Riyu-D1/Vector/pcb/drc_report.txt

** Drc report for soma-carrier.kicad_pcb **
** Created on 2026-10-27T16:31:42 **
** Report includes: Errors, Warnings, Exclusions **

** Found 12 DRC violations **
[lib_footprint_mismatch]: Footprint 'PinHeader_1x05_P2.54mm_Vertical' does not match copy in library 'Connector_PinHeader_2.54mm'
    Local override; warning
    @(14.0000 mm, 95.0000 mm): Footprint J13
[lib_footprint_mismatch]: Footprint 'PinHeader_1x05_P2.54mm_Vertical' does not match copy in library 'Connector_PinHeader_2.54mm'
    Local override; warning
    @(64.0000 mm, 64.0000 mm): Footprint J15
[lib_footprint_mismatch]: Footprint 'PinHeader_1x02_P2.54mm_Vertical' does not match copy in library 'Connector_PinHeader_2.54mm'
    Local override; warning
    @(30.0000 mm, 95.0000 mm): Footprint J9
[lib_footprint_mismatch]: Footprint 'PinHeader_1x22_P2.54mm_Vertical' does not match copy in library 'Connector_PinHeader_2.54mm'
    Local override; warning
    @(22.1400 mm, 51.1600 mm): Footprint U1A
[lib_footprint_mismatch]: Footprint 'TerminalBlock_Phoenix_MKDS-1,5-2-5.08_1x02_P5.08mm_Horizontal' does not match copy in library 'TerminalBlock_Phoenix'
    Local override; warning
    @(8.0000 mm, 36.0000 mm): Footprint J2
[lib_footprint_mismatch]: Footprint 'Fuse_Blade_Mini_directSolder' does not match copy in library 'Fuse'
    Local override; warning
    @(17.0000 mm, 64.0000 mm): Footprint F1
[lib_footprint_mismatch]: Footprint 'R_Axial_DIN0207_L6.3mm_D2.5mm_P7.62mm_Horizontal' does not match copy in library 'Resistor_THT'
    Local override; warning
    @(112.0000 mm, 95.0000 mm): Footprint R5
[lib_footprint_mismatch]: Footprint 'PinHeader_1x04_P2.54mm_Vertical' does not match copy in library 'Connector_PinHeader_2.54mm'
    Local override; warning
    @(48.0000 mm, 64.0000 mm): Footprint J8
[lib_footprint_mismatch]: Footprint 'PinHeader_1x22_P2.54mm_Vertical' does not match copy in library 'Connector_PinHeader_2.54mm'
    Local override; warning
    @(22.1400 mm, 28.3000 mm): Footprint U1B
[lib_footprint_mismatch]: Footprint 'PinHeader_1x04_P2.54mm_Vertical' does not match copy in library 'Connector_PinHeader_2.54mm'
    Local override; warning
    @(44.0000 mm, 95.0000 mm): Footprint J11
[lib_footprint_mismatch]: Footprint 'TerminalBlock_Phoenix_MKDS-1,5-2-5.08_1x02_P5.08mm_Horizontal' does not match copy in library 'TerminalBlock_Phoenix'
    Local override; warning
    @(8.0000 mm, 48.0000 mm): Footprint J1
[lib_footprint_mismatch]: Footprint 'PinHeader_1x04_P2.54mm_Vertical' does not match copy in library 'Connector_PinHeader_2.54mm'
    Local override; warning
    @(86.0000 mm, 95.0000 mm): Footprint J10

** Found 0 unconnected pads **

** Found 0 Footprint errors **

** Ignored checks **
    - Footprint has no courtyard defined
    - Track endpoint not centered on via
    - Tuning profile track geometries
    - Footprint doesn't match symbol's footprint filters
    - Footprint component type doesn't match footprint pads

** End of Report **
