Riyu-D1/Vector/cad3/fea/report_cradle.txt

run/cradle.frd: 122524 nodes 77580 tets, 4 result blocks
constrained 75069 (NFIX 47445 NLOAD 27624); excluded-with-elements 97623
step1: max|U| 0.000 mm | raw maxVM 1.07 | filtered maxVM 0.22 | patch maxVM 0.87 MPa
    hot VM 0.22 at node 89857 (94.4, 24.3, 221.6)
    hot VM 0.21 at node 47551 (67.0, 24.2, 211.7)
    hot VM 0.21 at node 60886 (92.9, 24.5, 220.3)
    hot VM 0.21 at node 114123 (95.0, 24.6, 226.1)
    hot VM 0.20 at node 60885 (93.0, 24.7, 220.9)
    patch VM 0.87 at node 42022 (92.6, 23.5, 227.5)
    patch VM 0.80 at node 94053 (92.2, 24.0, 205.2)
    patch VM 0.71 at node 81040 (92.3, 24.0, 204.8)
