Riyu-D1/Vector/cad3/fea/report_J2.txt

run/housing_J2.frd: 275769 nodes 164418 tets, 4 result blocks
constrained 91264 (NFIX 63765 NLOAD 27499); excluded-with-elements 179709
step1: max|U| 0.007 mm | raw maxVM 4.16 | filtered maxVM 4.16 | patch maxVM 1.64 MPa
    hot VM 4.16 at node 1972 (2.0, 22.6, 10.2)
    hot VM 3.10 at node 2021 (-2.0, 22.6, 10.2)
    hot VM 1.71 at node 63 (2.0, 22.6, 10.2)
    hot VM 1.42 at node 62 (2.0, 22.6, 10.2)
    hot VM 1.30 at node 66 (-2.0, 22.6, 10.2)
    patch VM 1.64 at node 249 (21.9, -9.1, 33.5)
    patch VM 1.60 at node 171 (23.6, -2.1, 33.5)
    patch VM 1.59 at node 172 (23.7, -1.5, 33.5)
