Riyu-D1/Vector/wrist/lists_after.txt

/Users/deepakdiwan/Vector-wt/wrist/cad/arm2b/out/fore_l2.stl 0.30 0.31 0.36
/Users/deepakdiwan/Vector-wt/wrist/cad/arm2b/out/fore_r2.stl 0.30 0.31 0.36
/Users/deepakdiwan/Vector-wt/wrist/wrist/out/w_j4_cradle.stl 0.30 0.31 0.36
/Users/deepakdiwan/Vector-wt/wrist/wrist/out/w_link4.stl 0.30 0.31 0.36
/Users/deepakdiwan/Vector-wt/wrist/wrist/out/w_link5.stl 0.30 0.31 0.36
/Users/deepakdiwan/Vector-wt/wrist/wrist/out/w_grip_frame.stl 0.30 0.31 0.36
/Users/deepakdiwan/Vector-wt/wrist/wrist/out/finger_u.stl 0.30 0.31 0.36
/Users/deepakdiwan/Vector-wt/wrist/wrist/out/finger_d.stl 0.30 0.31 0.36
/Users/deepakdiwan/Vector-wt/wrist/wrist/out/vendor_sts3215_j4.stl 0.78 0.38 0.12
/Users/deepakdiwan/Vector-wt/wrist/wrist/out/vendor_sts3215_j5.stl 0.78 0.38 0.12
/Users/deepakdiwan/Vector-wt/wrist/wrist/out/vendor_sts3215_j6.stl 0.78 0.38 0.12
/Users/deepakdiwan/Vector-wt/wrist/wrist/out/vendor_sts3215_g.stl 0.78 0.38 0.12
/Users/deepakdiwan/Vector-wt/wrist/wrist/out/vendor_gear_grip.stl 0.55 0.56 0.60
/Users/deepakdiwan/Vector-wt/wrist/wrist/out/vendor_rack_u.stl 0.55 0.56 0.60
/Users/deepakdiwan/Vector-wt/wrist/wrist/out/vendor_rack_d.stl 0.55 0.56 0.60
