Riyu-D1/Vector/toolchg/renders/lists_arm.txt

/Users/deepakdiwan/Vector-wt/toolchg/cad/arm2b/out/base_link.stl 0.30 0.31 0.36
/Users/deepakdiwan/Vector-wt/toolchg/cad/arm2b/out/base_plate.stl 0.30 0.31 0.36
/Users/deepakdiwan/Vector-wt/toolchg/cad/arm2b/out/base_reinf.stl 0.30 0.31 0.36
/Users/deepakdiwan/Vector-wt/toolchg/cad/arm2b/out/j1_cradle.stl 0.30 0.31 0.36
/Users/deepakdiwan/Vector-wt/toolchg/cad/arm2b/out/vendor_sts3250_j1.stl 0.78 0.38 0.12
/Users/deepakdiwan/Vector-wt/toolchg/toolchg/renders/scratch/home_dogleg_l.stl 0.30 0.31 0.36
/Users/deepakdiwan/Vector-wt/toolchg/toolchg/renders/scratch/home_dogleg_r.stl 0.30 0.31 0.36
/Users/deepakdiwan/Vector-wt/toolchg/toolchg/renders/scratch/home_fore_l2.stl 0.30 0.31 0.36
/Users/deepakdiwan/Vector-wt/toolchg/toolchg/renders/scratch/home_fore_r2.stl 0.30 0.31 0.36
/Users/deepakdiwan/Vector-wt/toolchg/toolchg/renders/scratch/home_front_spacer_j2.stl 0.30 0.31 0.36
/Users/deepakdiwan/Vector-wt/toolchg/toolchg/renders/scratch/home_front_spacer_j3.stl 0.30 0.31 0.36
/Users/deepakdiwan/Vector-wt/toolchg/toolchg/renders/scratch/home_link1.stl 0.30 0.31 0.36
/Users/deepakdiwan/Vector-wt/toolchg/toolchg/renders/scratch/home_upper_back.stl 0.30 0.31 0.36
/Users/deepakdiwan/Vector-wt/toolchg/toolchg/renders/scratch/home_upper_out.stl 0.30 0.31 0.36
/Users/deepakdiwan/Vector-wt/toolchg/toolchg/renders/scratch/home_yaw_limit.stl 0.30 0.31 0.36
/Users/deepakdiwan/Vector-wt/toolchg/toolchg/renders/scratch/home_back_spacer_j2.stl 0.30 0.31 0.36
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
/Users/deepakdiwan/Vector-wt/toolchg/toolchg/renders/scratch/home_cy2_vendor_motor.stl 0.30 0.31 0.36
/Users/deepakdiwan/Vector-wt/toolchg/toolchg/renders/scratch/home_cy3_vendor_motor.stl 0.30 0.31 0.36
/Users/deepakdiwan/Vector-wt/toolchg/toolchg/renders/scratch/home_cy2_vendor_outpins.stl 0.30 0.31 0.36
/Users/deepakdiwan/Vector-wt/toolchg/toolchg/renders/scratch/home_cy3_vendor_outpins.stl 0.30 0.31 0.36
/Users/deepakdiwan/Vector-wt/toolchg/toolchg/renders/scratch/home_cy2_vendor_ringpins.stl 0.30 0.31 0.36
/Users/deepakdiwan/Vector-wt/toolchg/toolchg/renders/scratch/home_cy3_vendor_ringpins.stl 0.30 0.31 0.36
/Users/deepakdiwan/Vector-wt/toolchg/toolchg/renders/scratch/home_tc_finger_d.stl 0.30 0.31 0.36
/Users/deepakdiwan/Vector-wt/toolchg/toolchg/renders/scratch/home_tc_finger_u.stl 0.30 0.31 0.36
/Users/deepakdiwan/Vector-wt/toolchg/toolchg/renders/scratch/home_tc_gear.stl 0.55 0.56 0.60
/Users/deepakdiwan/Vector-wt/toolchg/toolchg/renders/scratch/home_tc_master.stl 0.16 0.50 0.72
/Users/deepakdiwan/Vector-wt/toolchg/toolchg/renders/scratch/home_tc_rack_d.stl 0.55 0.56 0.60
/Users/deepakdiwan/Vector-wt/toolchg/toolchg/renders/scratch/home_tc_rack_u.stl 0.55 0.56 0.60
/Users/deepakdiwan/Vector-wt/toolchg/toolchg/renders/scratch/home_tc_vendor_g.stl 0.30 0.31 0.36
/Users/deepakdiwan/Vector-wt/toolchg/toolchg/renders/scratch/home_tool_grip.stl 0.30 0.31 0.36
/Users/deepakdiwan/Vector-wt/toolchg/toolchg/out/tc_rack.stl 0.62 0.64 0.68
/Users/deepakdiwan/Vector-wt/toolchg/toolchg/renders/scratch/d_tool_pen.stl 0.85 0.62 0.18
