Riyu-D1/Vector/toolchg/renders/lists_asm.txt

/Users/deepakdiwan/Vector-wt/toolchg/toolchg/renders/scratch/asm_fore_l2.stl 0.30 0.31 0.36
/Users/deepakdiwan/Vector-wt/toolchg/toolchg/renders/scratch/asm_fore_r2.stl 0.30 0.31 0.36
/Users/deepakdiwan/Vector-wt/toolchg/toolchg/renders/scratch/asm_vendor_sts3250_j4.stl 0.78 0.38 0.12
/Users/deepakdiwan/Vector-wt/toolchg/toolchg/renders/scratch/asm_vendor_sts3215_j5.stl 0.78 0.38 0.12
/Users/deepakdiwan/Vector-wt/toolchg/toolchg/renders/scratch/asm_vendor_sts3215_j6.stl 0.78 0.38 0.12
/Users/deepakdiwan/Vector-wt/toolchg/toolchg/renders/scratch/asm_w_j4_cradle.stl 0.30 0.31 0.36
/Users/deepakdiwan/Vector-wt/toolchg/toolchg/renders/scratch/asm_w_link4.stl 0.30 0.31 0.36
/Users/deepakdiwan/Vector-wt/toolchg/toolchg/renders/scratch/asm_w_link5.stl 0.30 0.31 0.36
/Users/deepakdiwan/Vector-wt/toolchg/toolchg/renders/scratch/asm_cy3_carrier.stl 0.30 0.31 0.36
/Users/deepakdiwan/Vector-wt/toolchg/toolchg/renders/scratch/asm_cy3_out_flange.stl 0.30 0.31 0.36
/Users/deepakdiwan/Vector-wt/toolchg/toolchg/renders/scratch/asm_cy3_vendor_685.stl 0.30 0.31 0.36
/Users/deepakdiwan/Vector-wt/toolchg/toolchg/renders/scratch/asm_cy3_vendor_dowels.stl 0.30 0.31 0.36
/Users/deepakdiwan/Vector-wt/toolchg/toolchg/renders/scratch/asm_cy3_vendor_outpins.stl 0.30 0.31 0.36
/Users/deepakdiwan/Vector-wt/toolchg/toolchg/renders/scratch/asm_tc_finger_d.stl 0.30 0.31 0.36
/Users/deepakdiwan/Vector-wt/toolchg/toolchg/renders/scratch/asm_tc_finger_u.stl 0.30 0.31 0.36
/Users/deepakdiwan/Vector-wt/toolchg/toolchg/renders/scratch/asm_tc_gear.stl 0.55 0.56 0.60
/Users/deepakdiwan/Vector-wt/toolchg/toolchg/renders/scratch/asm_tc_master.stl 0.16 0.50 0.72
/Users/deepakdiwan/Vector-wt/toolchg/toolchg/renders/scratch/asm_tc_rack_d.stl 0.55 0.56 0.60
/Users/deepakdiwan/Vector-wt/toolchg/toolchg/renders/scratch/asm_tc_rack_u.stl 0.55 0.56 0.60
/Users/deepakdiwan/Vector-wt/toolchg/toolchg/renders/scratch/asm_tc_vendor_g.stl 0.30 0.31 0.36
/Users/deepakdiwan/Vector-wt/toolchg/toolchg/renders/scratch/asm_tool_grip.stl 0.30 0.31 0.36
