Riyu-D1/Vector/toolchg/renders/lists_rack.txt

/Users/deepakdiwan/Vector-wt/toolchg/toolchg/out/tc_rack.stl 0.62 0.64 0.68
/Users/deepakdiwan/Vector-wt/toolchg/toolchg/renders/scratch/tdock_pen.stl 0.85 0.62 0.18
/Users/deepakdiwan/Vector-wt/toolchg/toolchg/renders/scratch/tdock_tool_grip.stl 0.30 0.31 0.36
/Users/deepakdiwan/Vector-wt/toolchg/toolchg/renders/scratch/tdock_tc_vendor_g.stl 0.30 0.31 0.36
/Users/deepakdiwan/Vector-wt/toolchg/toolchg/renders/scratch/tdock_tc_gear.stl 0.55 0.56 0.60
/Users/deepakdiwan/Vector-wt/toolchg/toolchg/renders/scratch/tdock_tc_rack_u.stl 0.55 0.56 0.60
/Users/deepakdiwan/Vector-wt/toolchg/toolchg/renders/scratch/tdock_tc_rack_d.stl 0.55 0.56 0.60
/Users/deepakdiwan/Vector-wt/toolchg/toolchg/renders/scratch/tdock_tc_finger_u.stl 0.30 0.31 0.36
/Users/deepakdiwan/Vector-wt/toolchg/toolchg/renders/scratch/tdock_tc_finger_d.stl 0.30 0.31 0.36
/Users/deepakdiwan/Vector-wt/toolchg/toolchg/renders/scratch/dock_dogleg_l.stl 0.30 0.31 0.36
/Users/deepakdiwan/Vector-wt/toolchg/toolchg/renders/scratch/dock_dogleg_r.stl 0.30 0.31 0.36
/Users/deepakdiwan/Vector-wt/toolchg/toolchg/renders/scratch/dock_fore_l2.stl 0.30 0.31 0.36
/Users/deepakdiwan/Vector-wt/toolchg/toolchg/renders/scratch/dock_fore_r2.stl 0.30 0.31 0.36
/Users/deepakdiwan/Vector-wt/toolchg/toolchg/renders/scratch/dock_front_spacer_j2.stl 0.30 0.31 0.36
/Users/deepakdiwan/Vector-wt/toolchg/toolchg/renders/scratch/dock_front_spacer_j3.stl 0.30 0.31 0.36
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
/Users/deepakdiwan/Vector-wt/toolchg/toolchg/renders/scratch/dock_cy2_vendor_dowels.stl 0.30 0.31 0.36
/Users/deepakdiwan/Vector-wt/toolchg/toolchg/renders/scratch/dock_cy3_vendor_dowels.stl 0.30 0.31 0.36
/Users/deepakdiwan/Vector-wt/toolchg/toolchg/renders/scratch/dock_cy2_vendor_magnet.stl 0.30 0.31 0.36
/Users/deepakdiwan/Vector-wt/toolchg/toolchg/renders/scratch/dock_cy3_vendor_magnet.stl 0.30 0.31 0.36
/Users/deepakdiwan/Vector-wt/toolchg/toolchg/renders/scratch/dock_cy2_vendor_motor.stl 0.30 0.31 0.36
/Users/deepakdiwan/Vector-wt/toolchg/toolchg/renders/scratch/dock_cy3_vendor_motor.stl 0.30 0.31 0.36
/Users/deepakdiwan/Vector-wt/toolchg/toolchg/renders/scratch/dock_cy2_vendor_outpins.stl 0.30 0.31 0.36
/Users/deepakdiwan/Vector-wt/toolchg/toolchg/renders/scratch/dock_cy3_vendor_outpins.stl 0.30 0.31 0.36
/Users/deepakdiwan/Vector-wt/toolchg/toolchg/renders/scratch/dock_cy2_vendor_ringpins.stl 0.30 0.31 0.36
/Users/deepakdiwan/Vector-wt/toolchg/toolchg/renders/scratch/dock_cy3_vendor_ringpins.stl 0.30 0.31 0.36
/Users/deepakdiwan/Vector-wt/toolchg/toolchg/renders/scratch/dock_tc_master.stl 0.16 0.50 0.72
