Riyu-D1/Vector/toolchg/renders/lists_rackonly.txt

/Users/deepakdiwan/Vector-wt/toolchg/toolchg/out/tc_rack.stl 0.62 0.64 0.68
/Users/deepakdiwan/Vector-wt/toolchg/toolchg/renders/scratch/ro_tdock_pen.stl 0.85 0.62 0.18
/Users/deepakdiwan/Vector-wt/toolchg/toolchg/renders/scratch/ro_tdock_tool_grip.stl 0.30 0.31 0.36
/Users/deepakdiwan/Vector-wt/toolchg/toolchg/renders/scratch/ro_tdock_tc_vendor_g.stl 0.30 0.31 0.36
/Users/deepakdiwan/Vector-wt/toolchg/toolchg/renders/scratch/ro_tdock_tc_gear.stl 0.55 0.56 0.60
/Users/deepakdiwan/Vector-wt/toolchg/toolchg/renders/scratch/ro_tdock_tc_rack_u.stl 0.55 0.56 0.60
/Users/deepakdiwan/Vector-wt/toolchg/toolchg/renders/scratch/ro_tdock_tc_rack_d.stl 0.55 0.56 0.60
/Users/deepakdiwan/Vector-wt/toolchg/toolchg/renders/scratch/ro_tdock_tc_finger_u.stl 0.30 0.31 0.36
/Users/deepakdiwan/Vector-wt/toolchg/toolchg/renders/scratch/ro_tdock_tc_finger_d.stl 0.30 0.31 0.36
