Riyu-D1/Vector/cad3/fea/cad3_cradle_iso.png

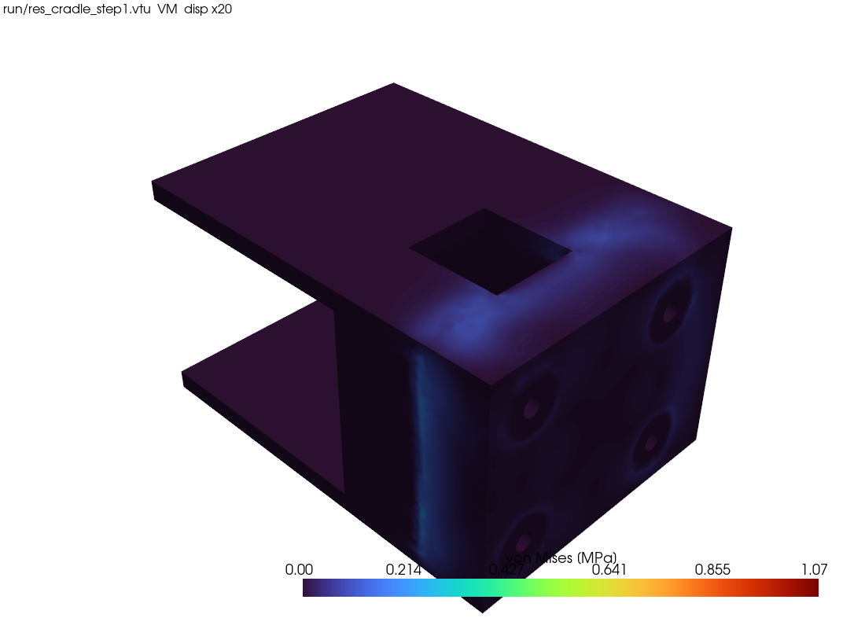
cad3/fea/cad3_cradle_iso.png
