Riyu-D1/Vector/cad3/fea/cad3_J2_front.png

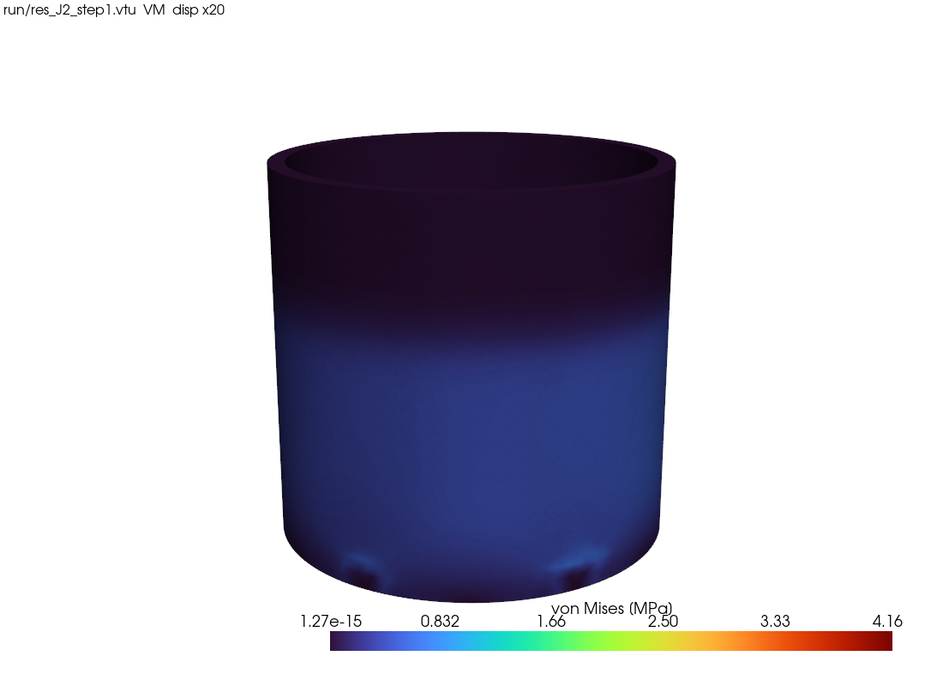
cad3/fea/cad3_J2_front.png
