Riyu-D1/Vector/cad3/fea/cad3_J3_iso.png

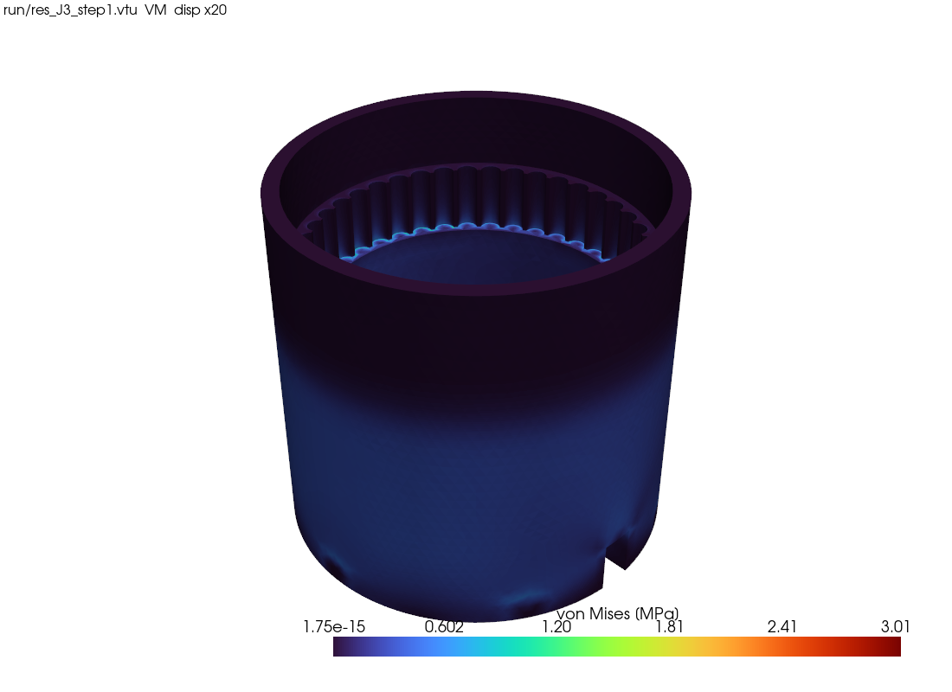
cad3/fea/cad3_J3_iso.png
