Riyu-D1/Vector/cad/actuator/export/_cutaway.png

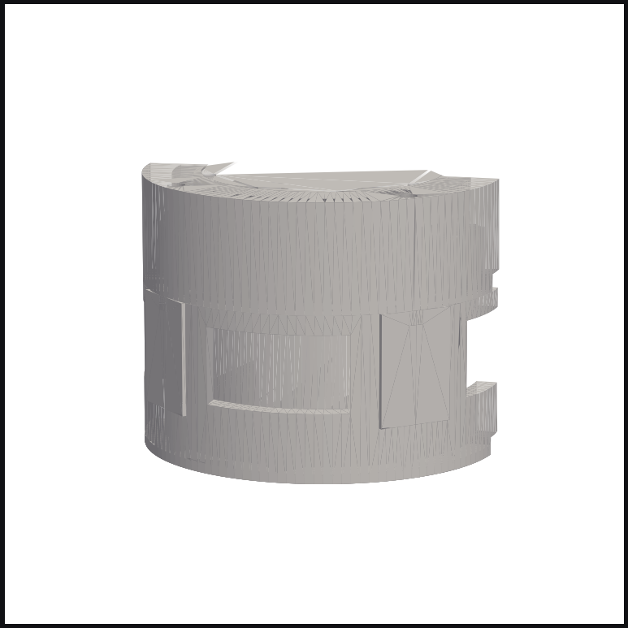
cad/actuator/export/_cutaway.png
