Riyu-D1/Vector/cad/actuator/export/_gears.png

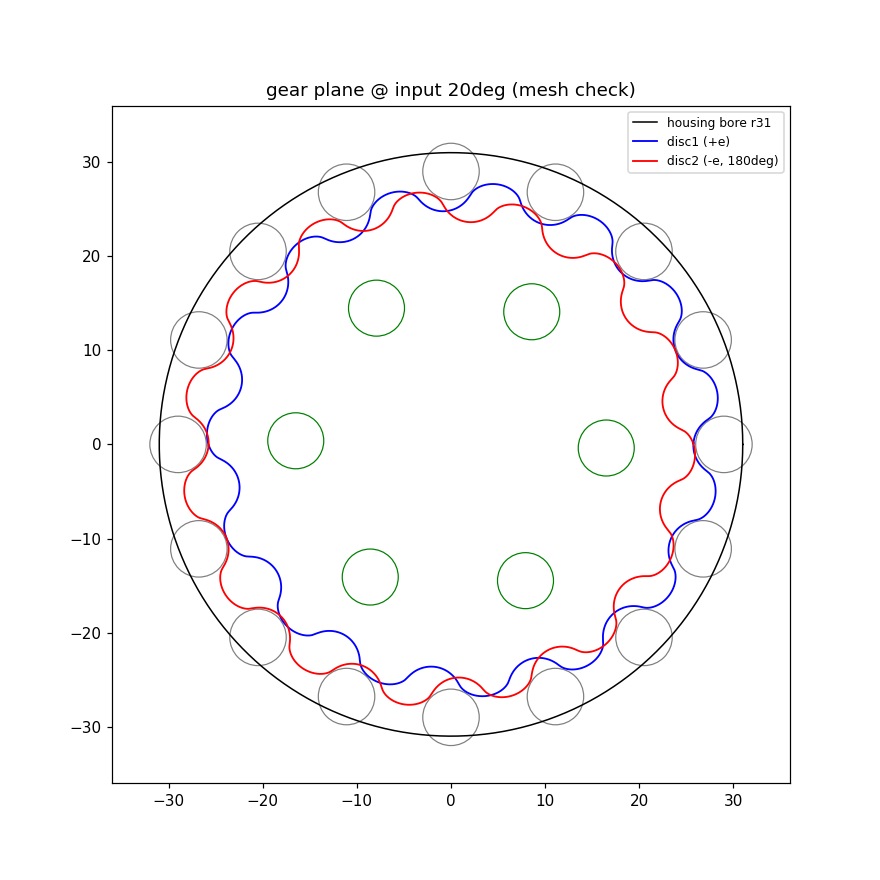
cad/actuator/export/_gears.png
