Riyu-D1/Vector/cad/actuator/export/_preview.png

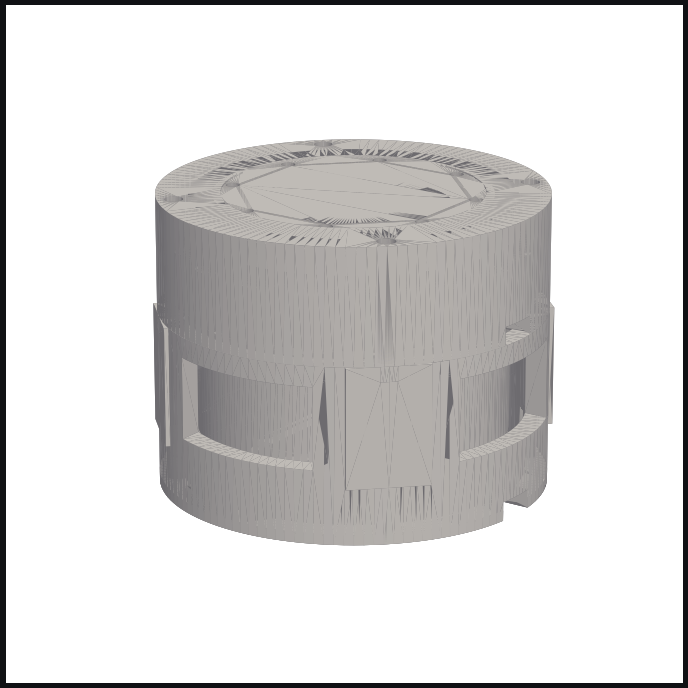
cad/actuator/export/_preview.png
