Riyu-D1/Vector/cad/actuator/export/_section.png

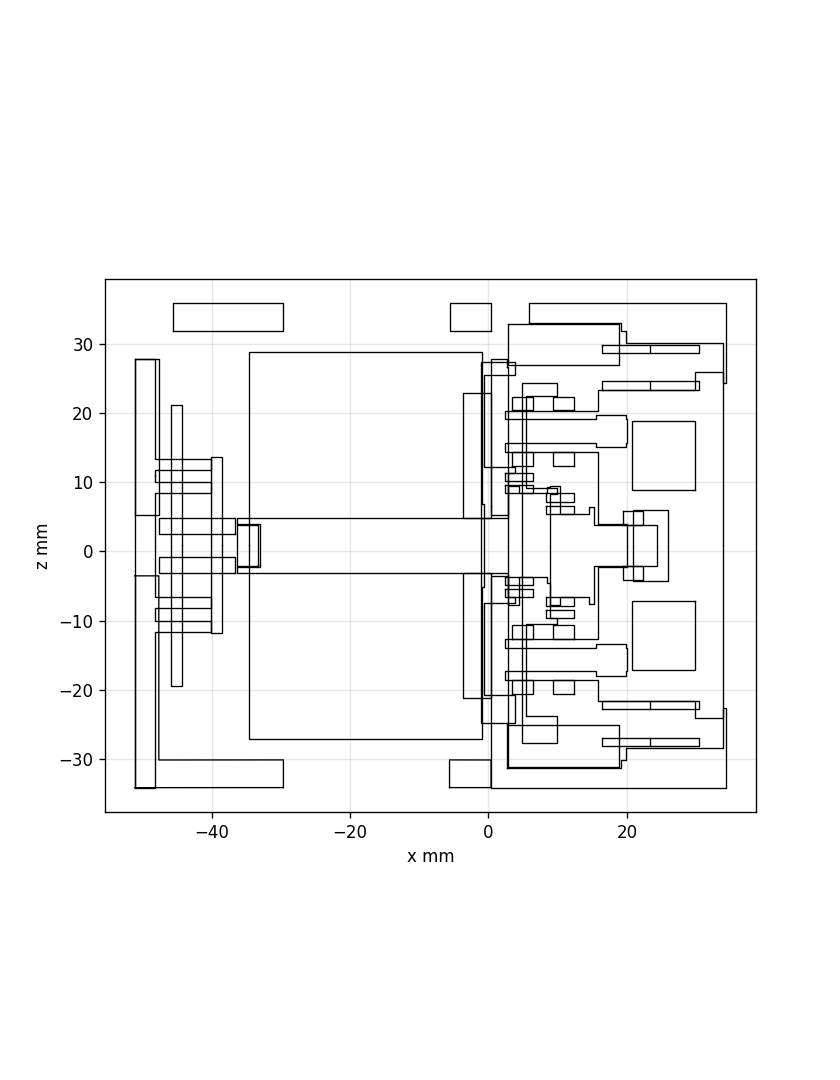
cad/actuator/export/_section.png
