Riyu-D1/Vector/cad/arm/renders/base.png

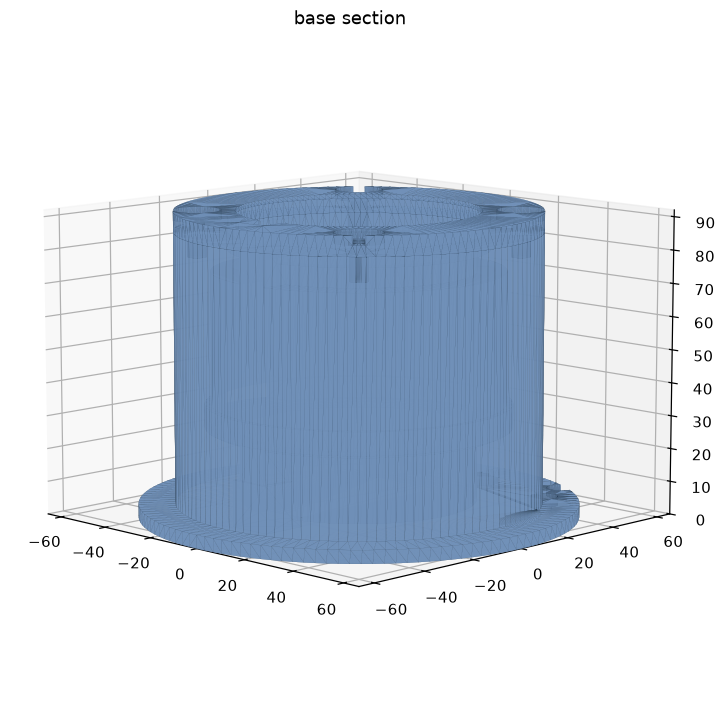
cad/arm/renders/base.png
