Riyu-D1/Vector/cad/arm/renders/front.png

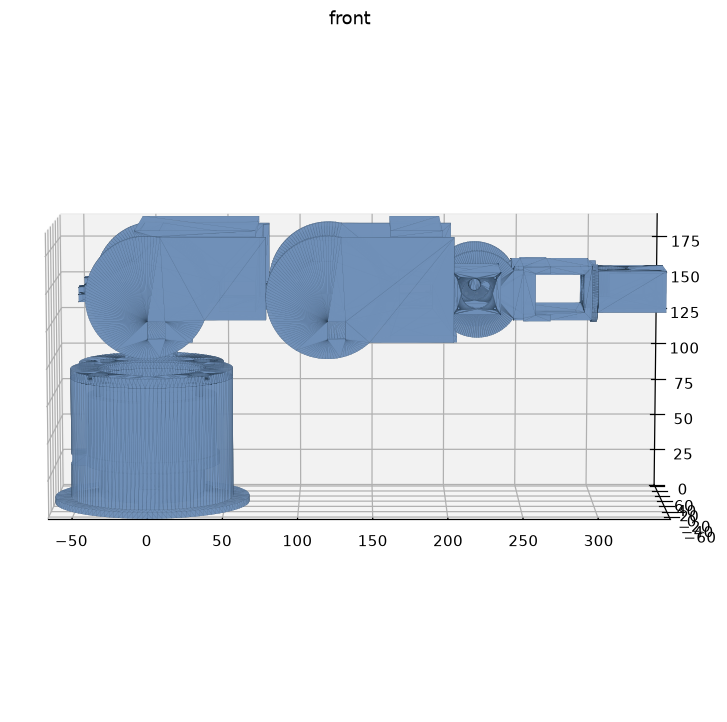
cad/arm/renders/front.png
