Riyu-D1/Vector/cad/arm/renders/iso_home.png

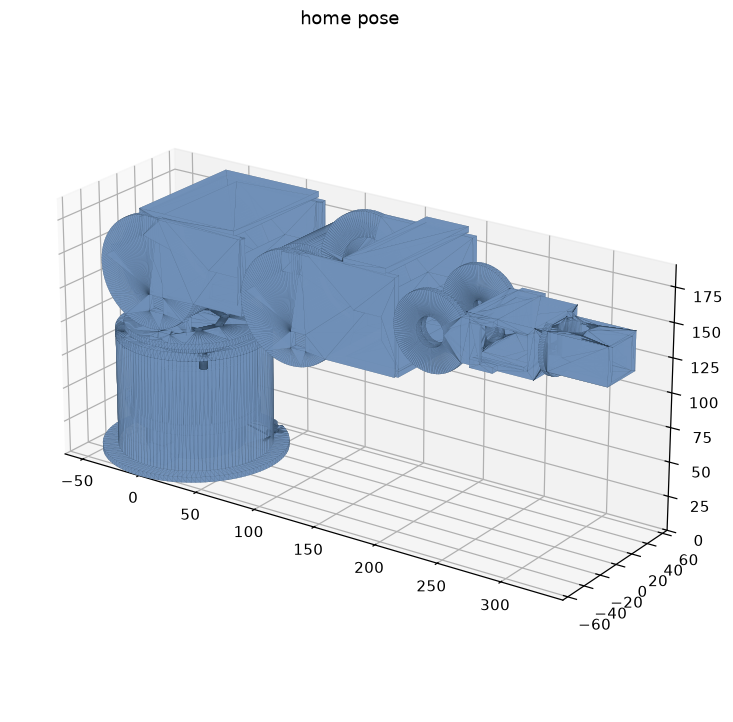
cad/arm/renders/iso_home.png
