Riyu-D1/Vector/cad/arm/renders/reach.png

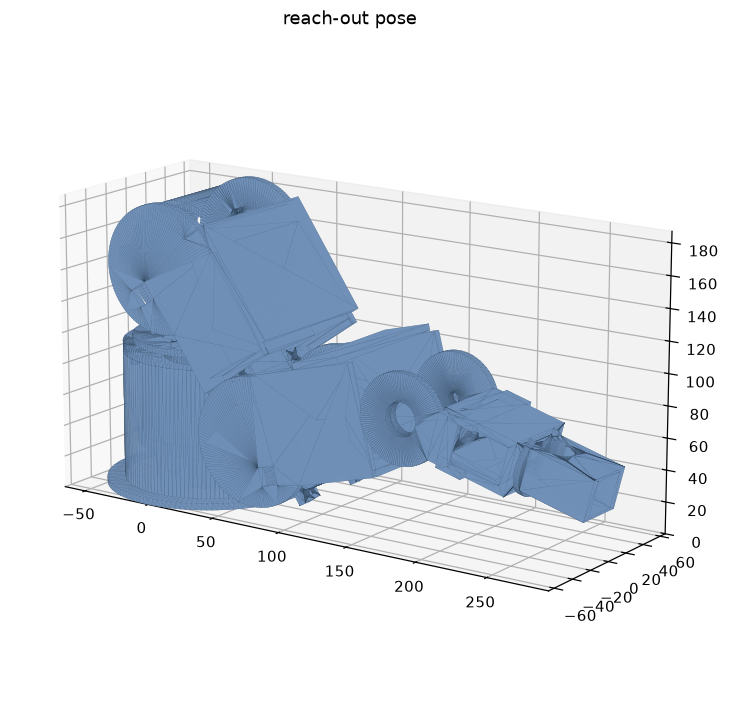
cad/arm/renders/reach.png
