Riyu-D1/Vector/cad/arm/renders/side.png

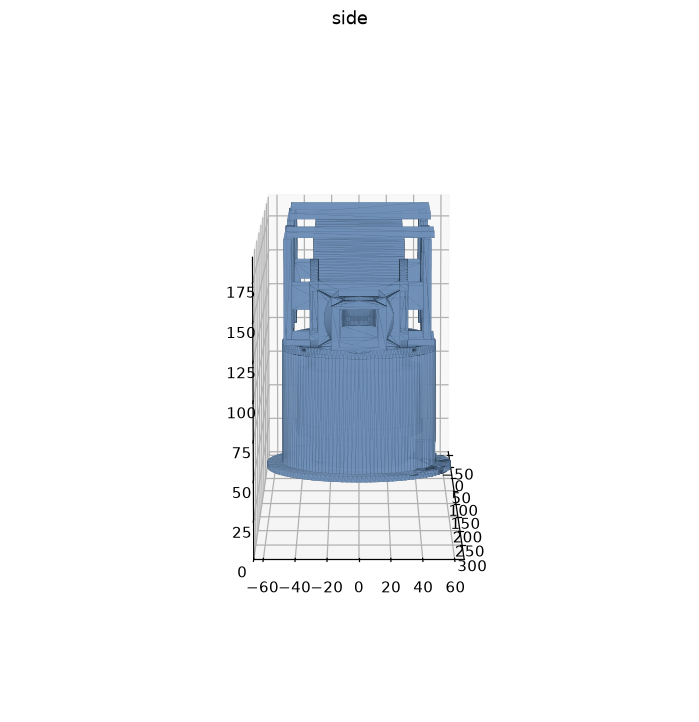
cad/arm/renders/side.png
