Riyu-D1/Vector/cad/arm/renders/top.png

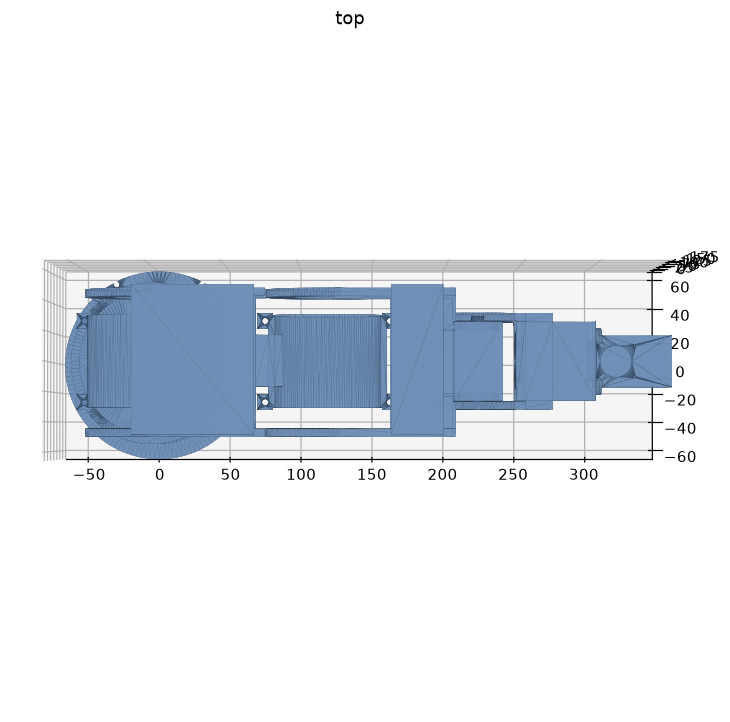
cad/arm/renders/top.png
