Riyu-D1/Vector/cad/export/case_lid_view.png

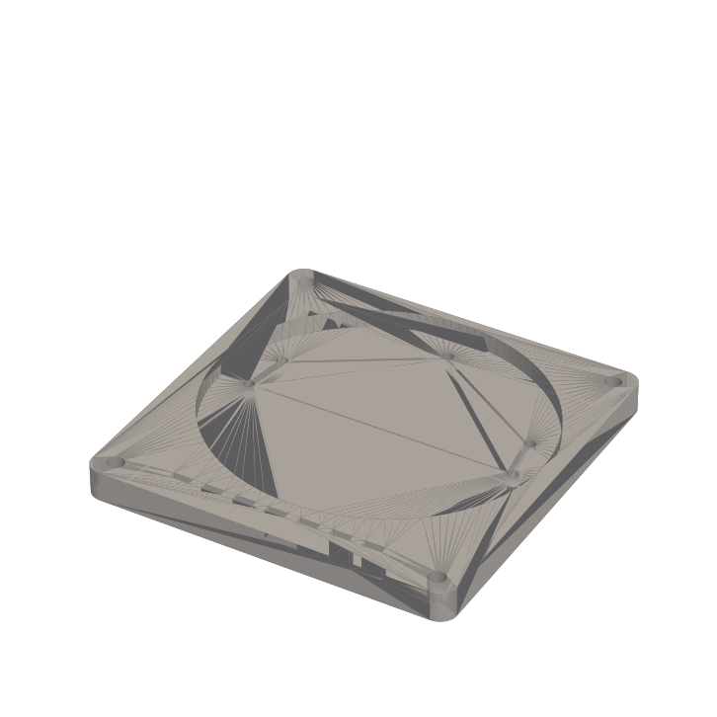
cad/export/case_lid_view.png
