Riyu-D1/Vector/cad/export/case_preview.png

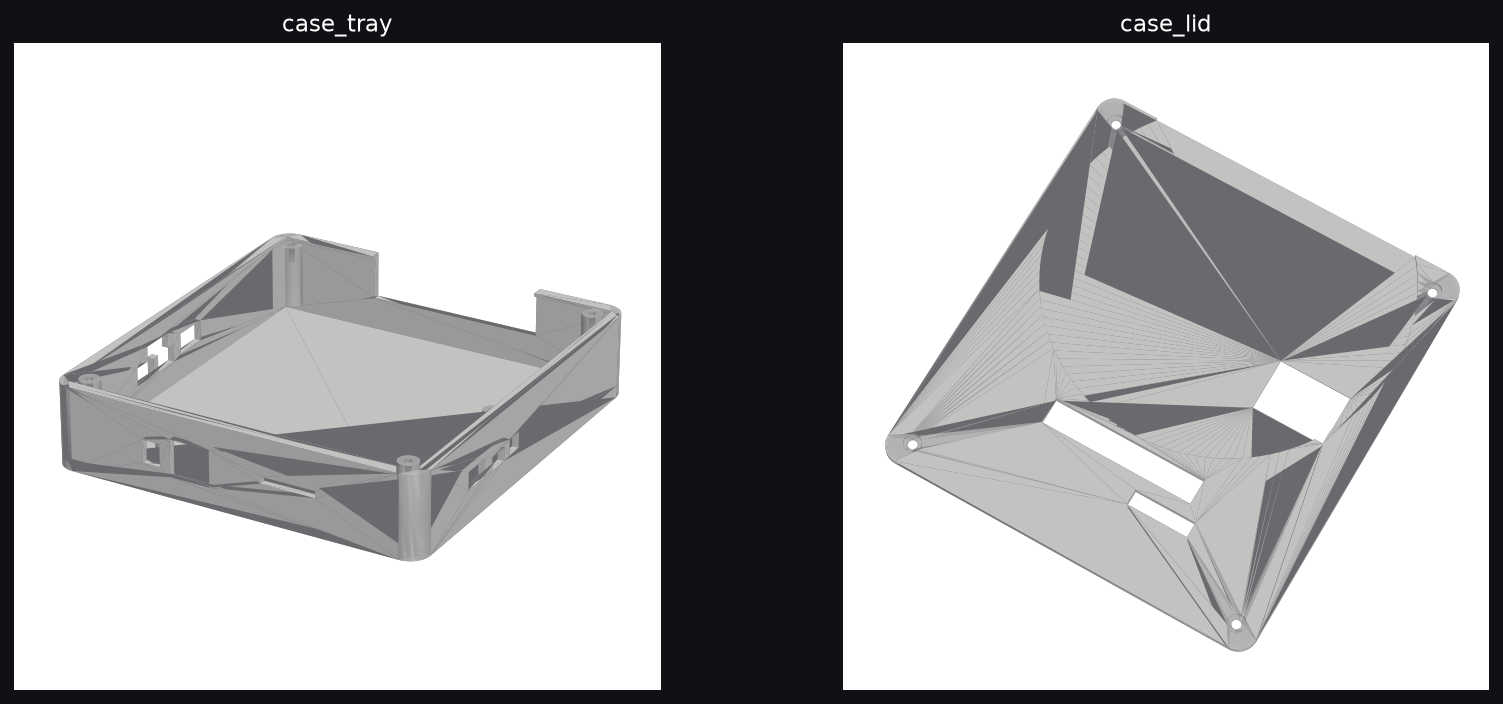
cad/export/case_preview.png
