Riyu-D1/Vector/cad/export/case_tray2.png

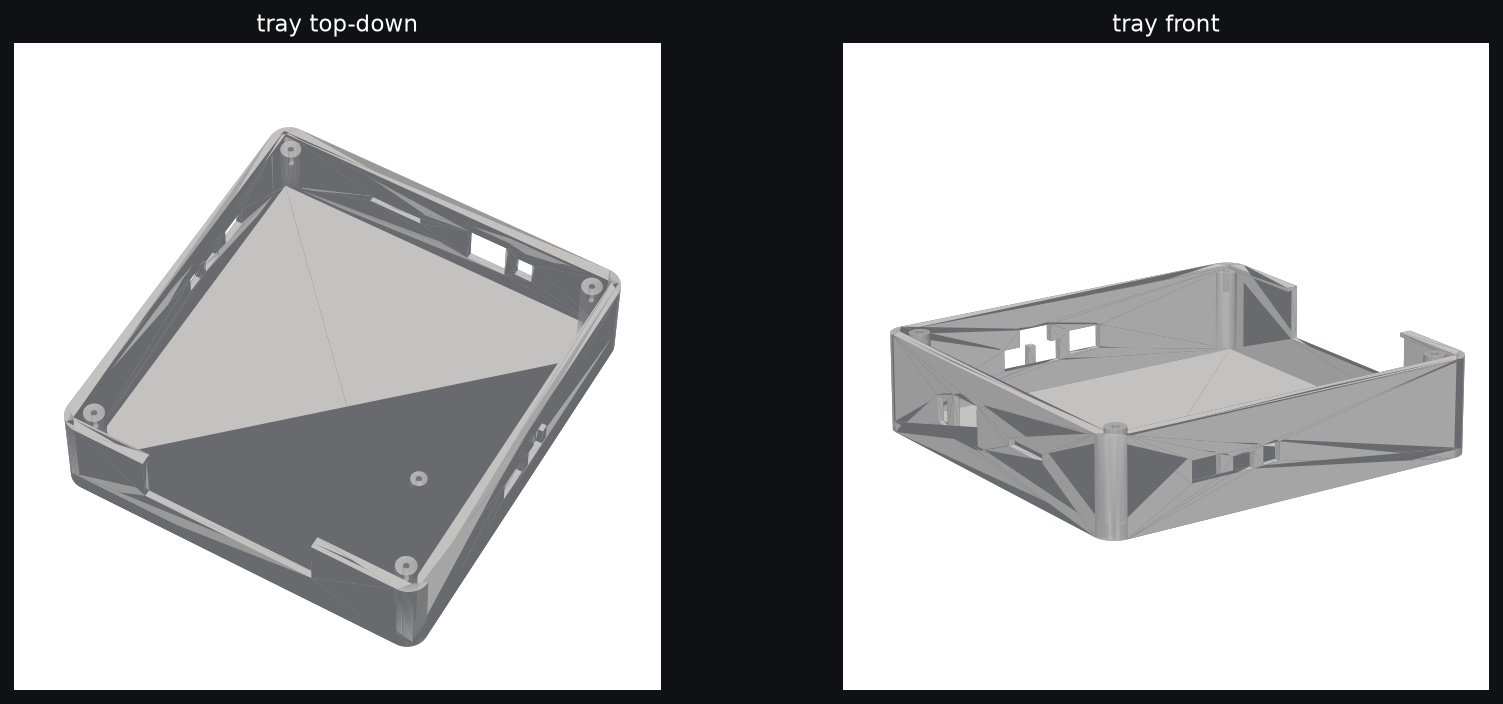
cad/export/case_tray2.png
