Riyu-D1/Vector/cad/export/case_tray_view.png

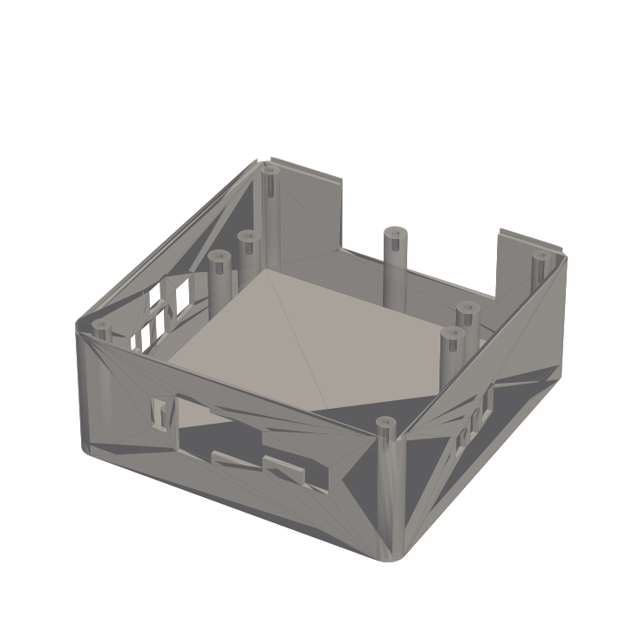
cad/export/case_tray_view.png
