Riyu-D1/Vector/cad/export/case_v2.png

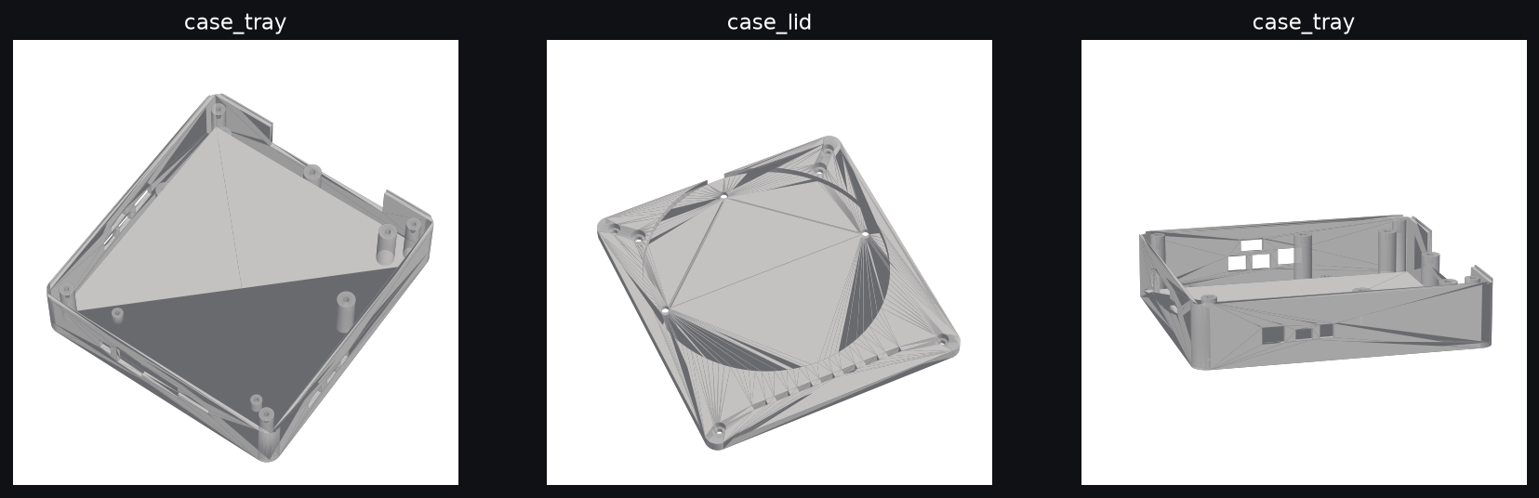
cad/export/case_v2.png
