Riyu-D1/Vector/cad/export/preview.png

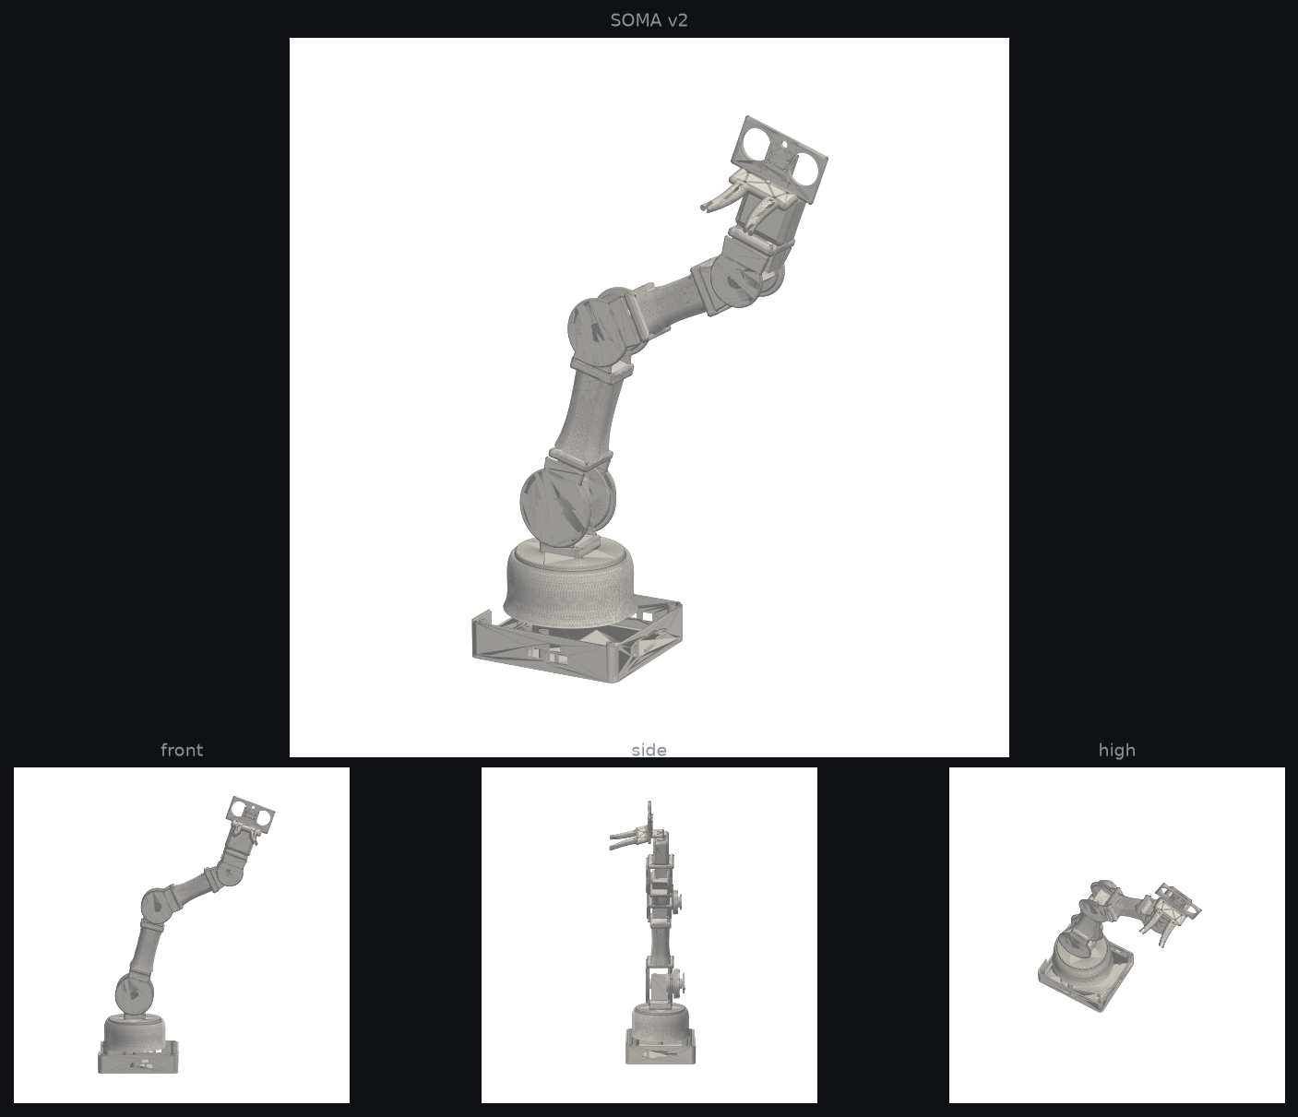
cad/export/preview.png
