Riyu-D1/Vector/cradlefix/renders/asm_backiso.png

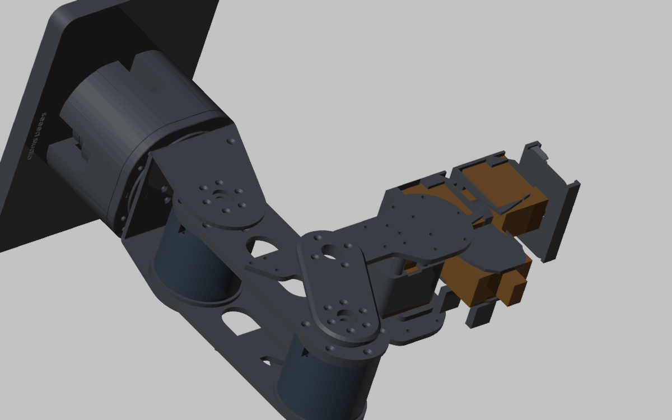
cradlefix/renders/asm_backiso.png
