Riyu-D1/Vector/cradlefix/renders/asm_cutaway.png

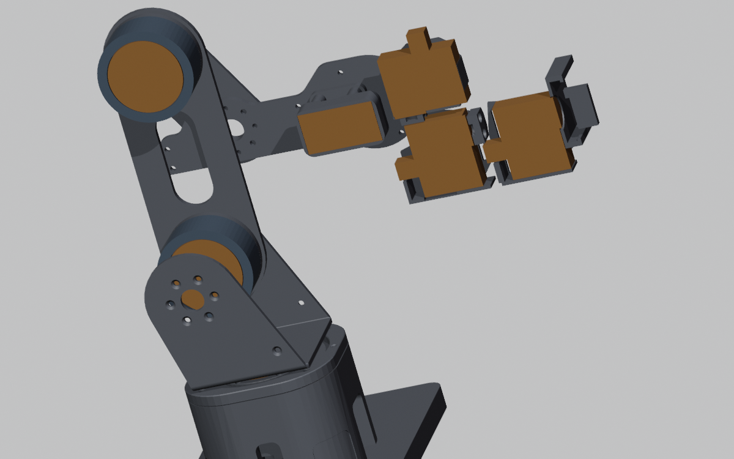
cradlefix/renders/asm_cutaway.png
