Riyu-D1/Vector/cradlefix/renders/asm_side.png

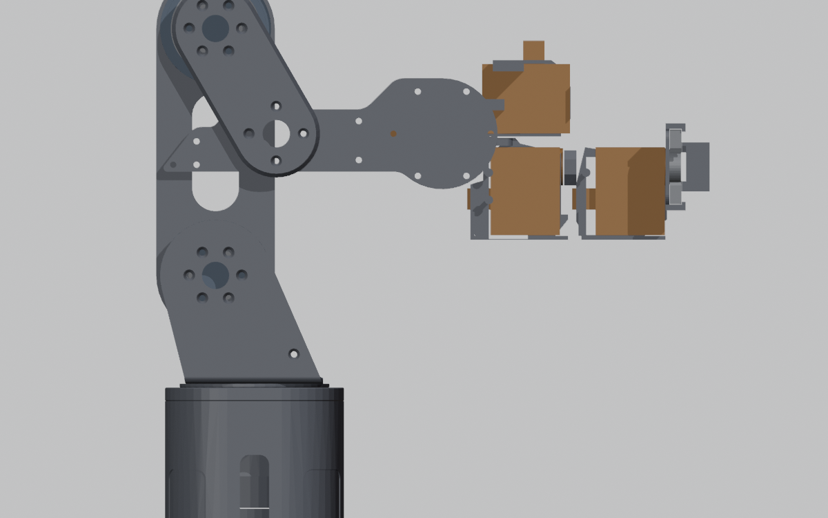
cradlefix/renders/asm_side.png
