Riyu-D1/Vector/cradlefix/renders/asm_top.png

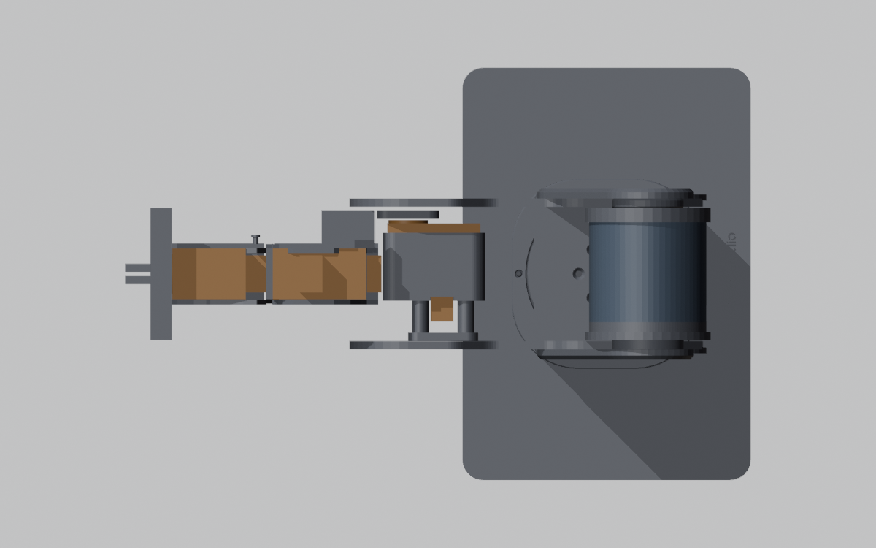
cradlefix/renders/asm_top.png
