Riyu-D1/Vector/cradlefix/renders/cf_after_backiso.png

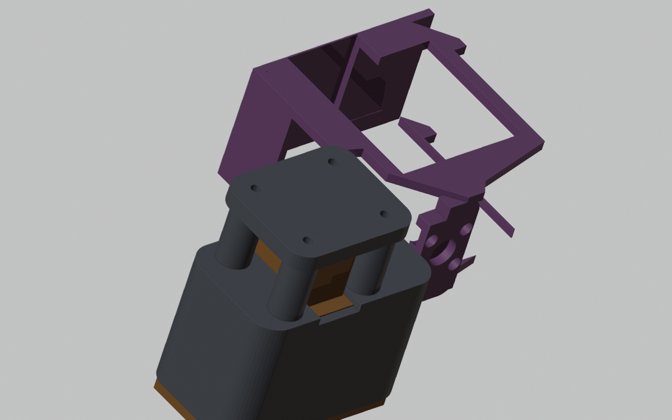
cradlefix/renders/cf_after_backiso.png
