Riyu-D1/Vector/cradlefix/renders/cf_after_cutaway.png

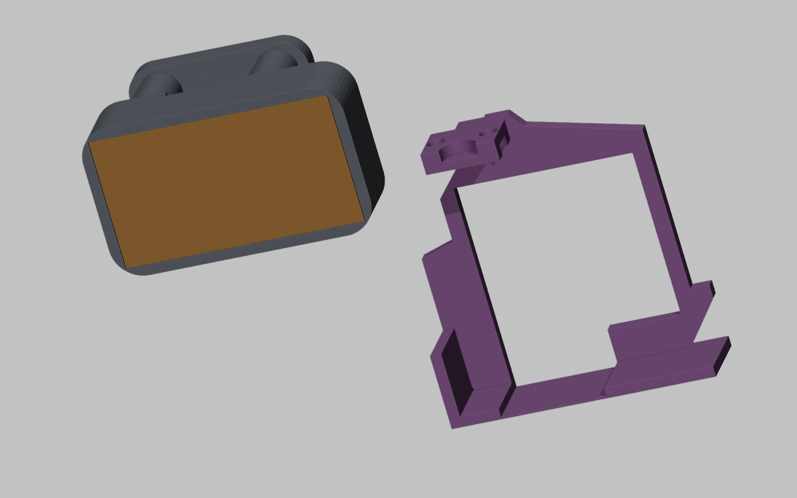
cradlefix/renders/cf_after_cutaway.png
