Riyu-D1/Vector/cradlefix/renders/cf_after_front.png

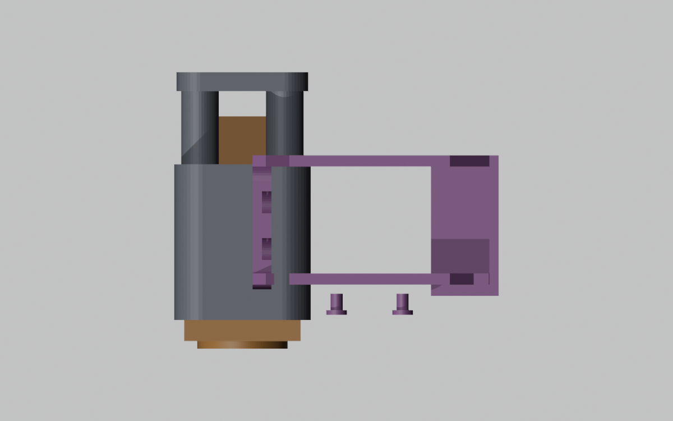
cradlefix/renders/cf_after_front.png
