Riyu-D1/Vector/cradlefix/renders/cf_after_frontiso.png

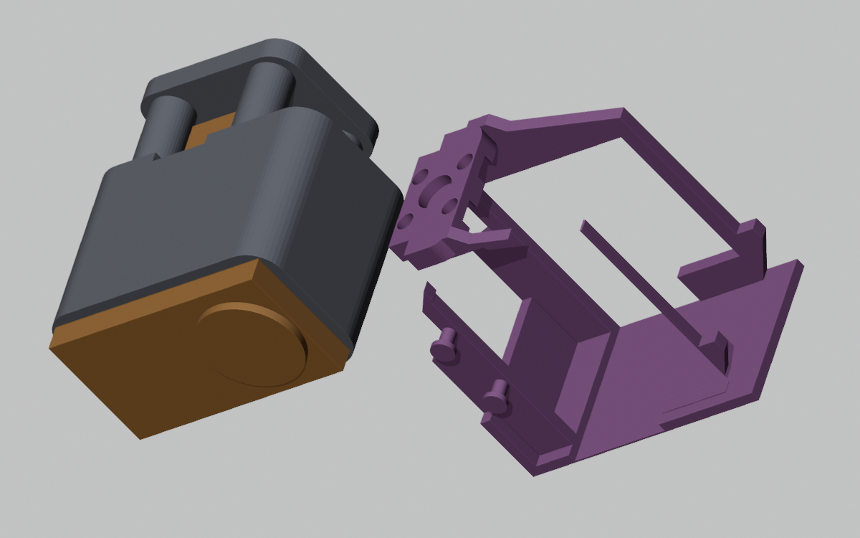
cradlefix/renders/cf_after_frontiso.png
