Riyu-D1/Vector/cradlefix/renders/cf_after_side.png

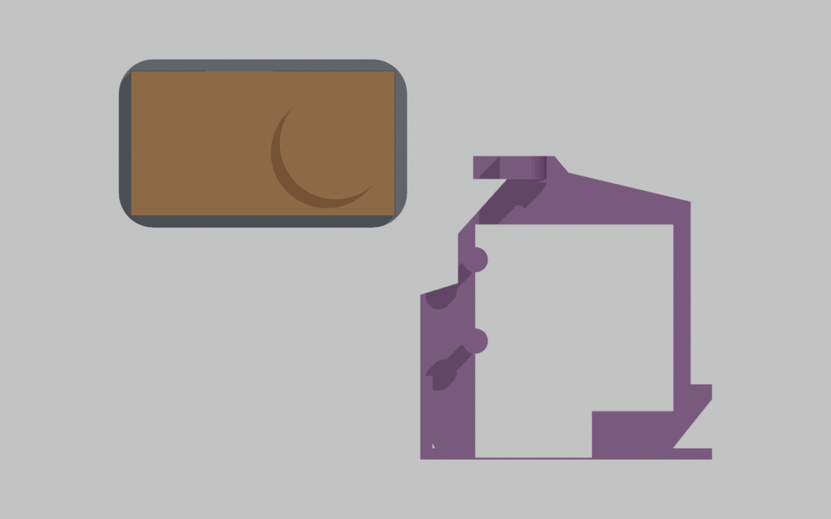
cradlefix/renders/cf_after_side.png
