Riyu-D1/Vector/cradlefix/renders/cf_after_top.png

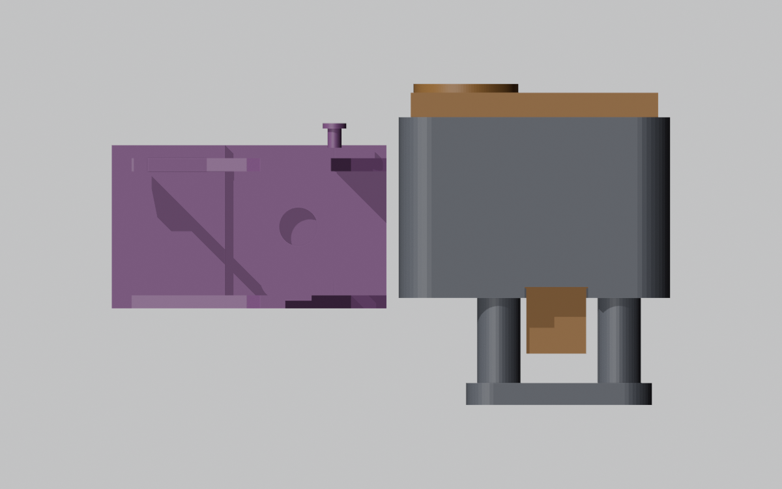
cradlefix/renders/cf_after_top.png
