Riyu-D1/Vector/final2/payload_vs_reach.png

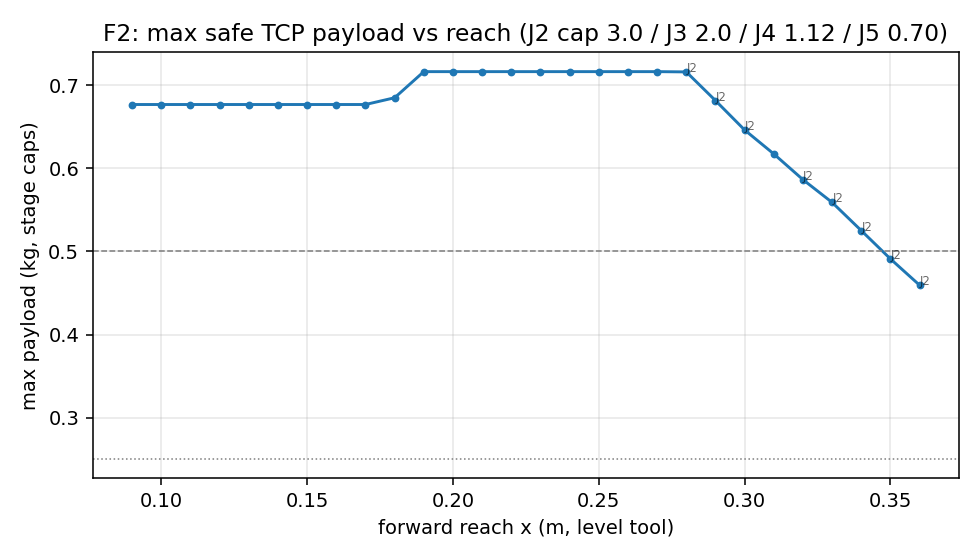
final2/payload_vs_reach.png
