Riyu-D1/Vector/final/renders/closeup_wrist.png

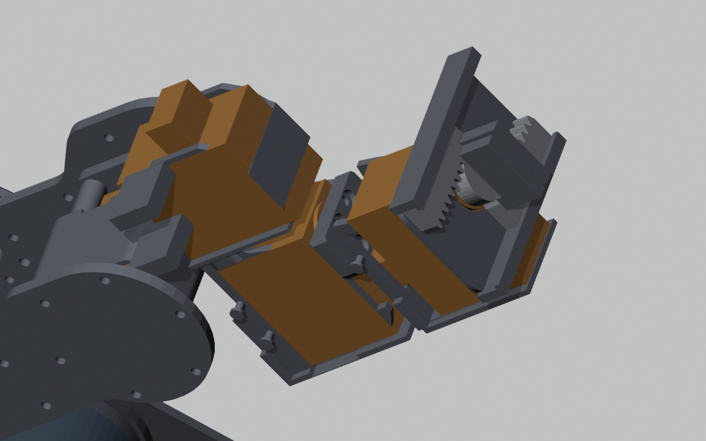
final/renders/closeup_wrist.png
