Riyu-D1/Vector/lighten/fea/upper_back_front.png

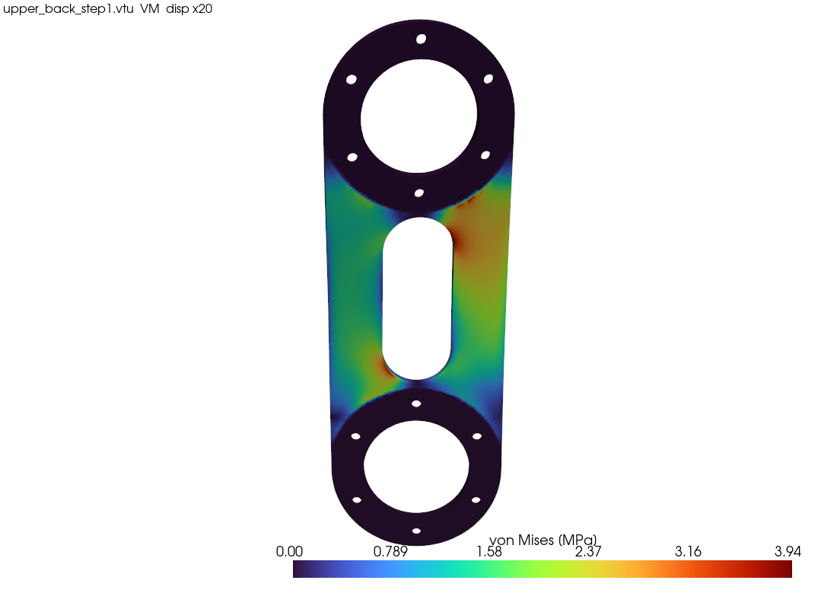
lighten/fea/upper_back_front.png
