Riyu-D1/Vector/lighten/fea/upper_back_iso.png

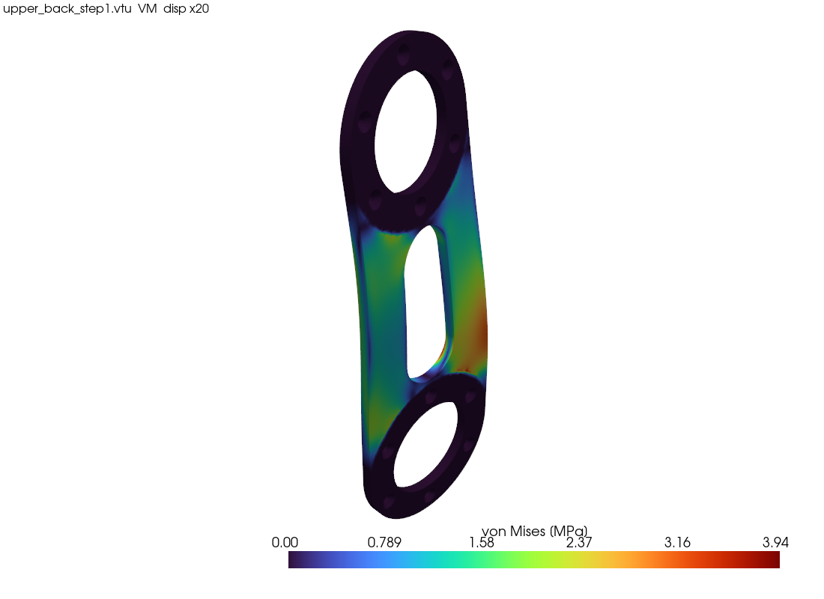
lighten/fea/upper_back_iso.png
