Riyu-D1/Vector/lighten/fea/upper_back_lp_iso.png

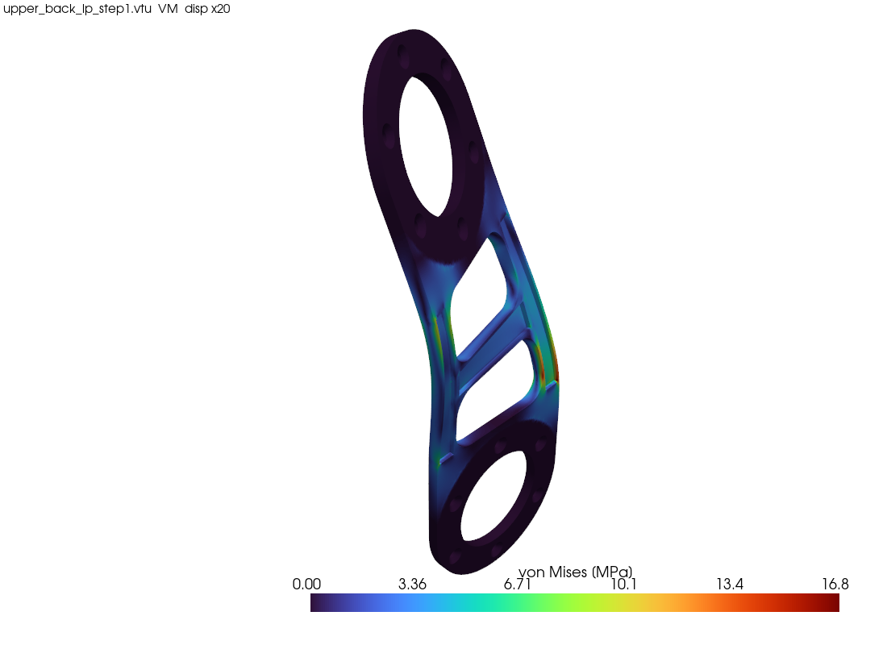
lighten/fea/upper_back_lp_iso.png
