Riyu-D1/Vector/lighten/fea/upper_out_front.png

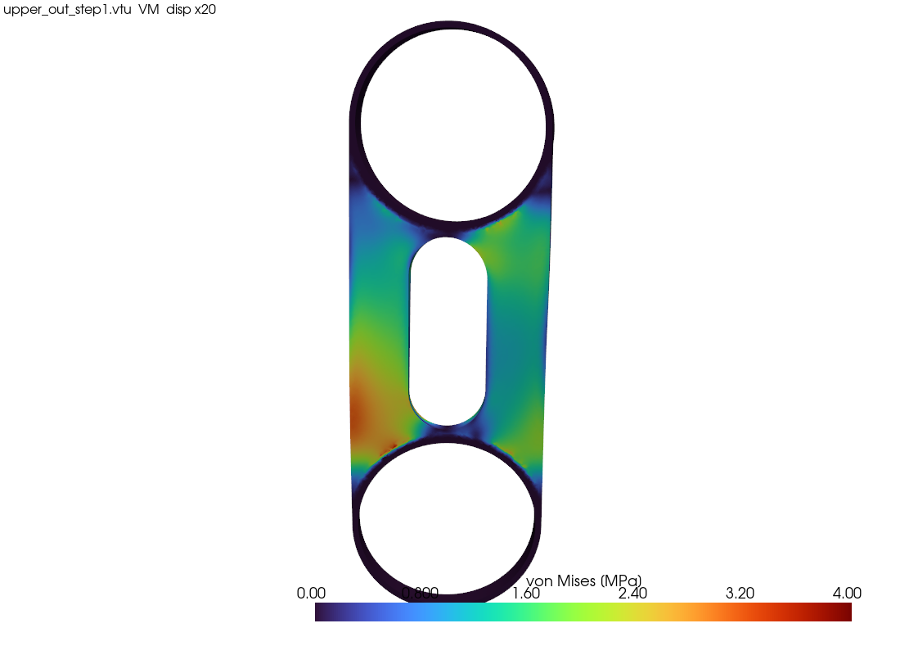
lighten/fea/upper_out_front.png
