Riyu-D1/Vector/lighten/fea/upper_out_iso.png

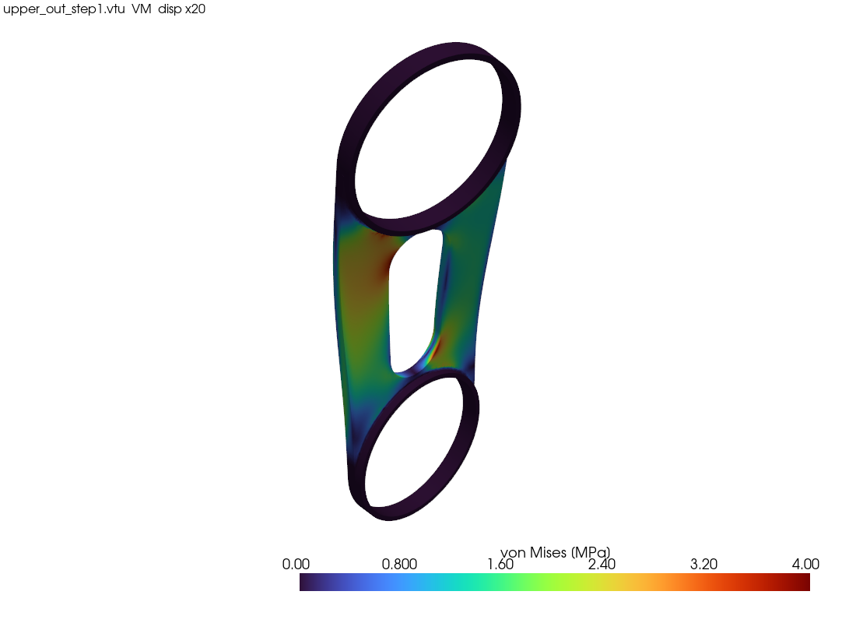
lighten/fea/upper_out_iso.png
