Riyu-D1/Vector/lighten/fea/upper_out_l_iso.png

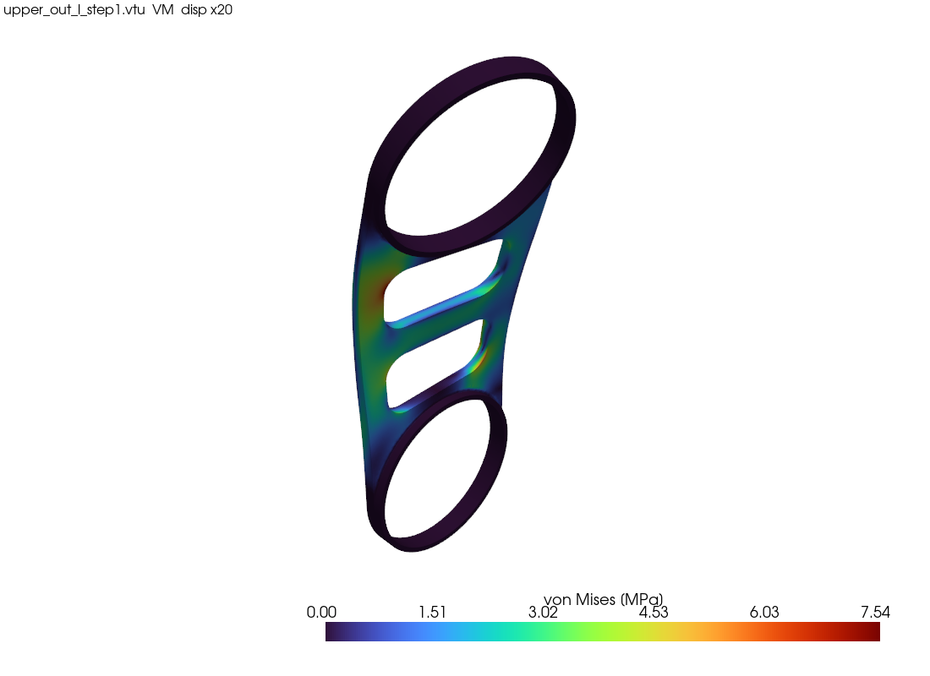
lighten/fea/upper_out_l_iso.png
