Riyu-D1/Vector/lighten/fea/upper_out_lp_front.png

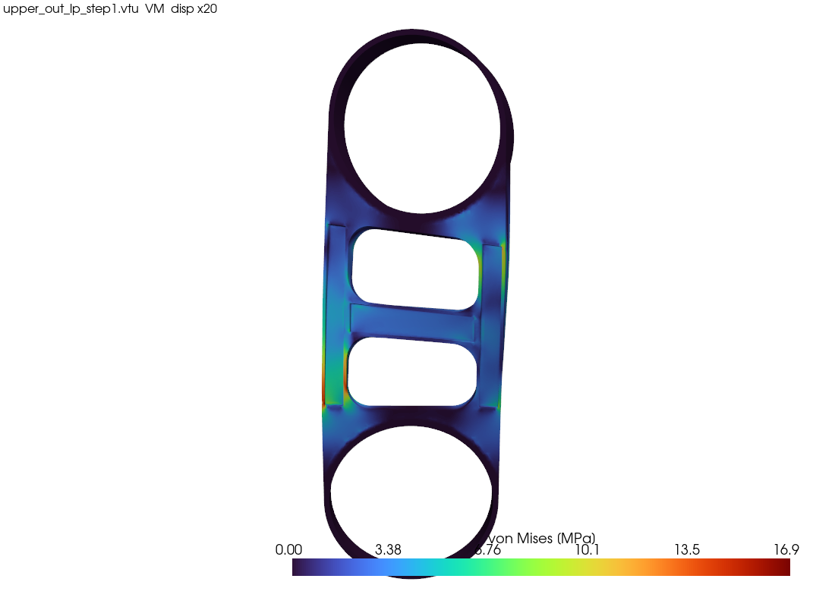
lighten/fea/upper_out_lp_front.png
