Riyu-D1/Vector/lighten/rend/plates_l_backiso.png

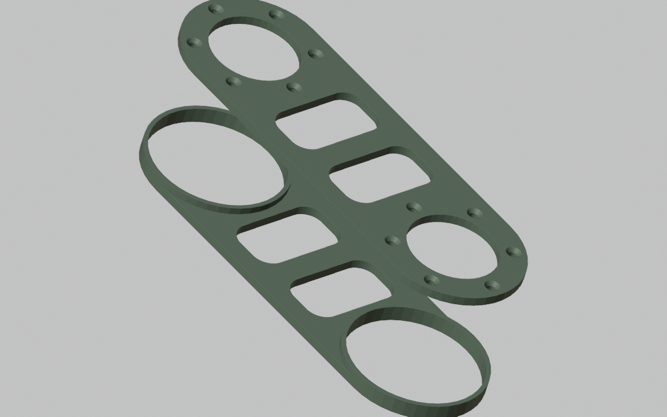
lighten/rend/plates_l_backiso.png
