Riyu-D1/Vector/lighten/rend/plates_l_cutaway.png

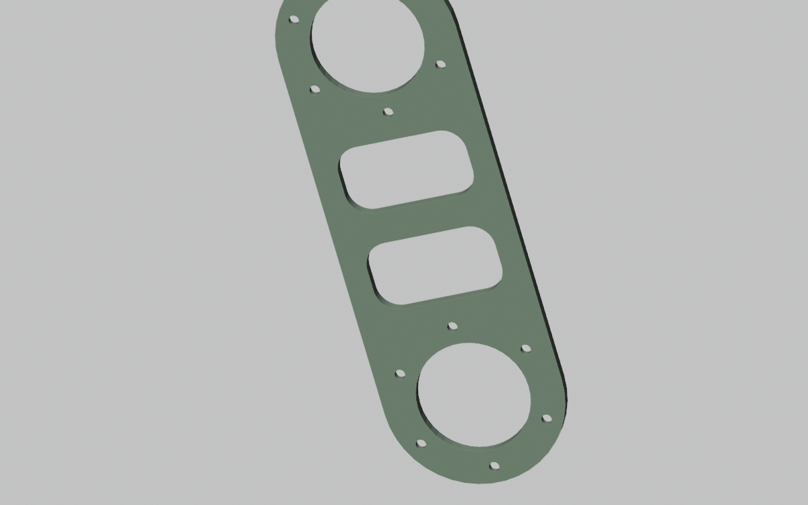
lighten/rend/plates_l_cutaway.png
