Riyu-D1/Vector/lighten/rend/plates_l_front.png

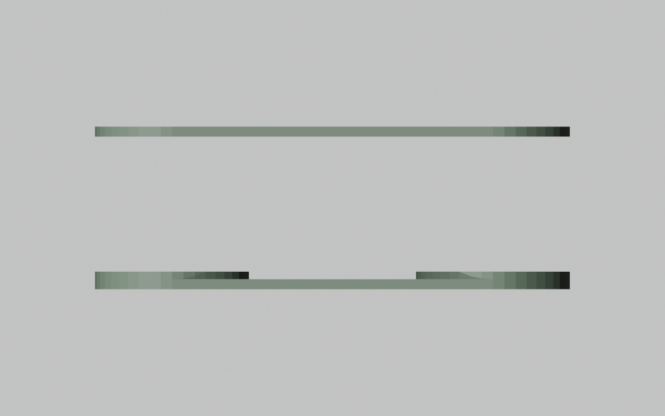
lighten/rend/plates_l_front.png
