Riyu-D1/Vector/lighten/rend/plates_l_side.png

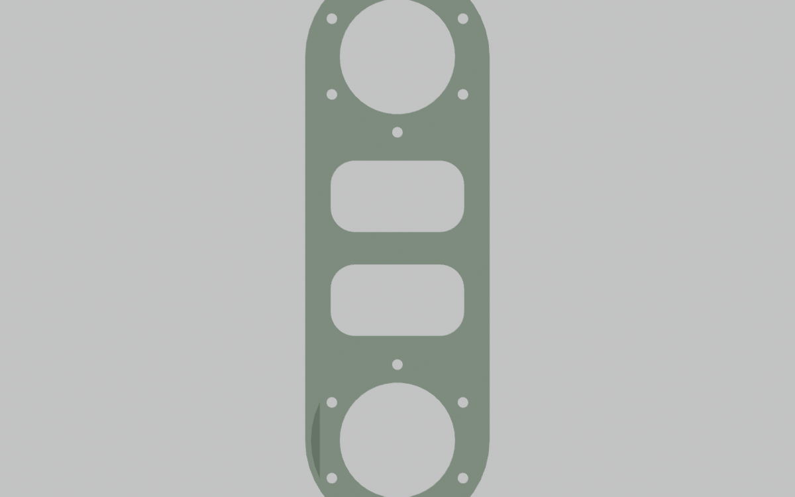
lighten/rend/plates_l_side.png
