Riyu-D1/Vector/lighten/rend/plates_l_top.png

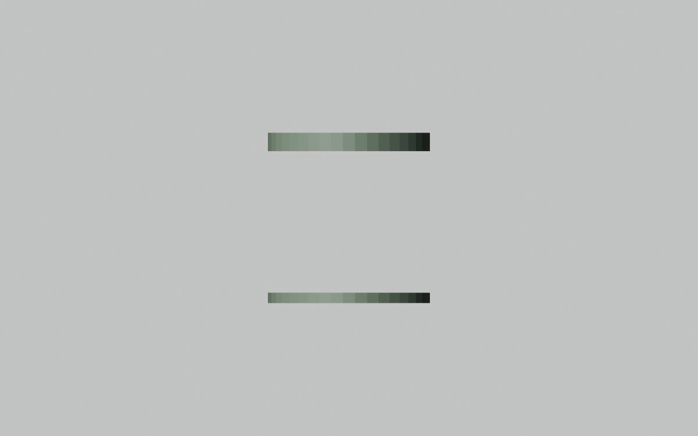
lighten/rend/plates_l_top.png
