Riyu-D1/Vector/pcb/soma-carrier-bottom.png

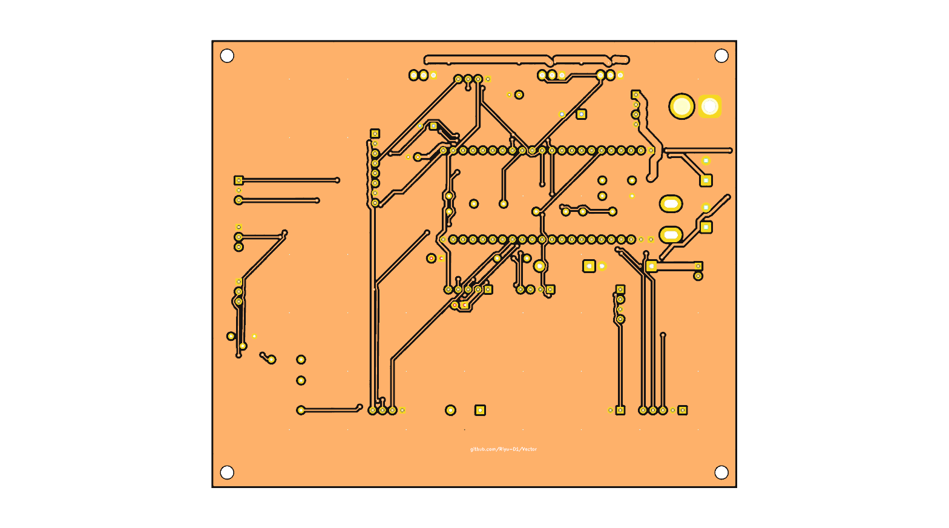
pcb/soma-carrier-bottom.png
