Riyu-D1/Vector/refine/fea/gf_r3_iso.png

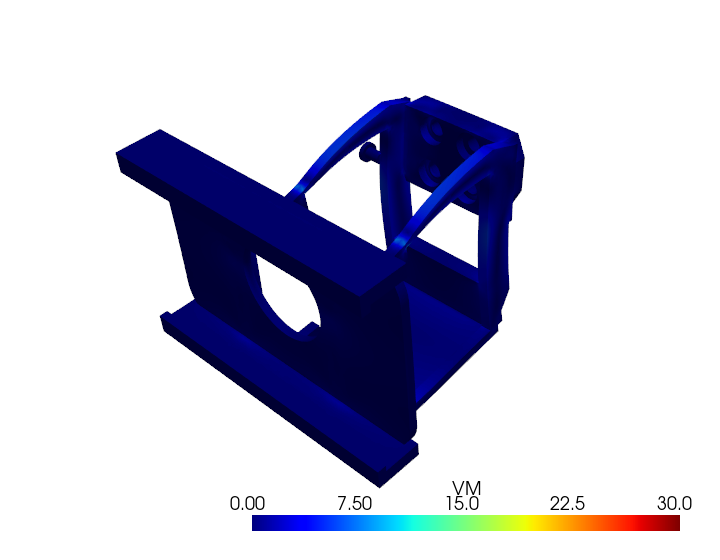
refine/fea/gf_r3_iso.png
