Riyu-D1/Vector/refine/fea/gf_r5_iso.png

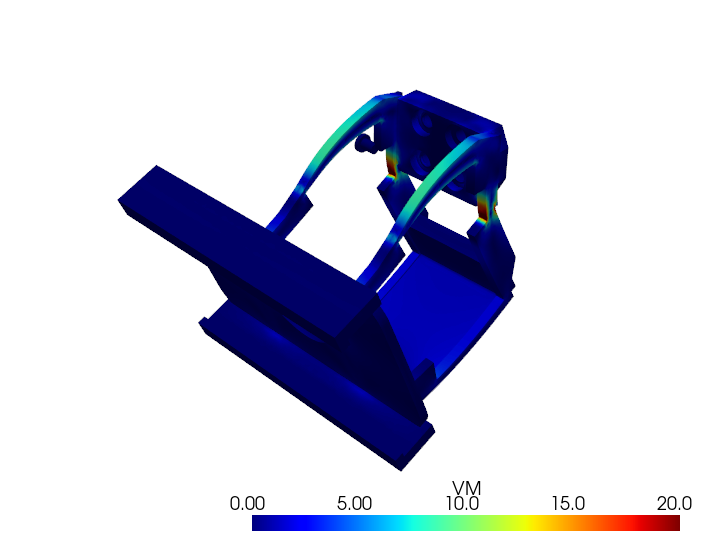
refine/fea/gf_r5_iso.png
