Riyu-D1/Vector/refine/fea/gf_r7lat_iso.png

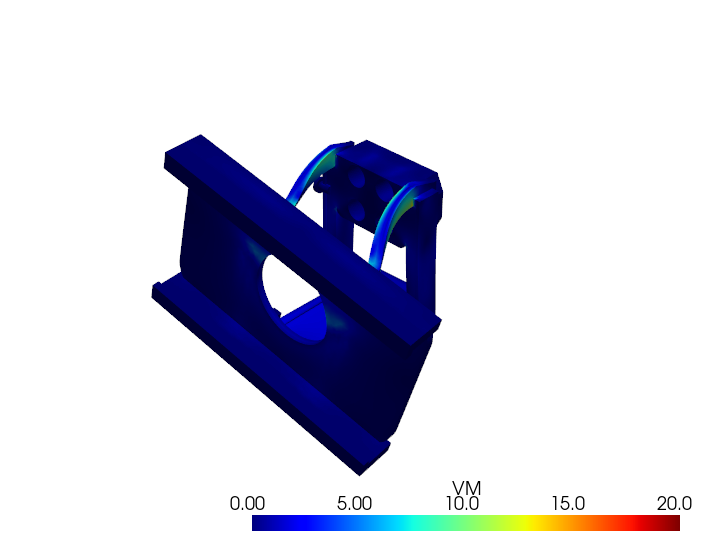
refine/fea/gf_r7lat_iso.png
