Riyu-D1/Vector/refine/fea/l4_r3_iso.png

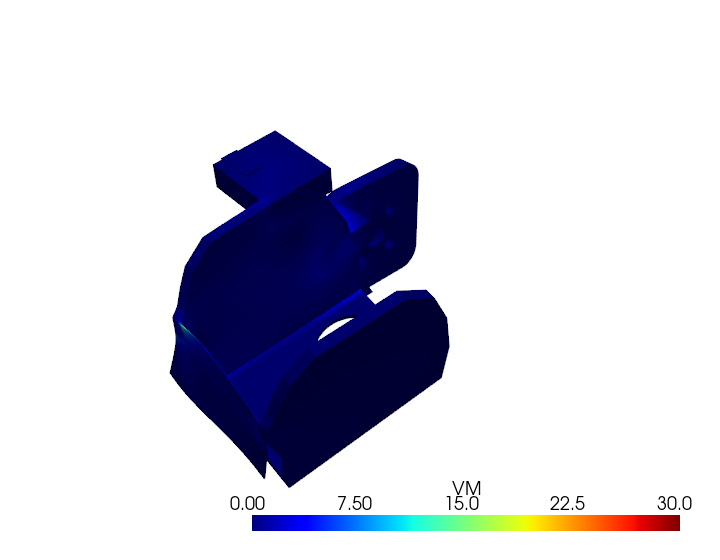
refine/fea/l4_r3_iso.png
