Riyu-D1/Vector/refine/fea/l4_r8lat_iso.png

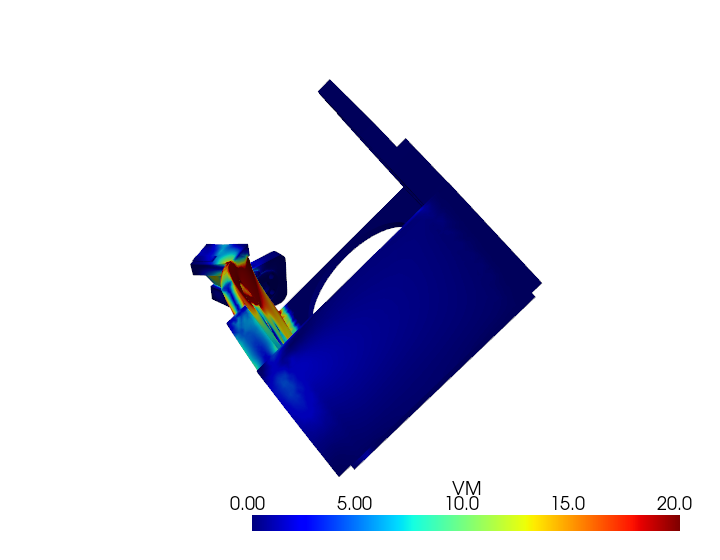
refine/fea/l4_r8lat_iso.png
