Riyu-D1/Vector/refine/fea/l5_r3_iso.png

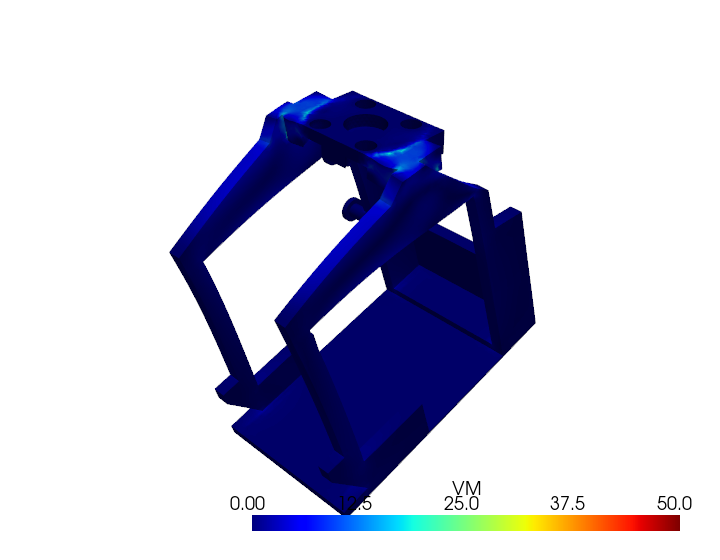
refine/fea/l5_r3_iso.png
