Riyu-D1/Vector/refine/fea/l5_r5lat_iso.png

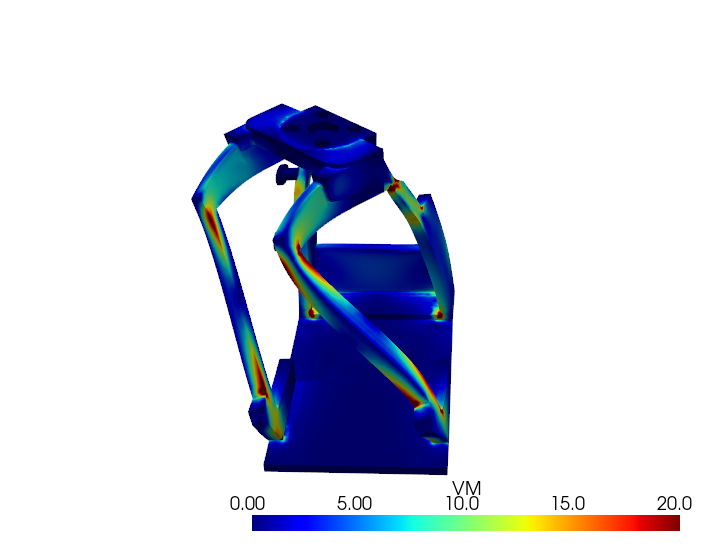
refine/fea/l5_r5lat_iso.png
