Riyu-D1/Vector/refine/fea/l5_r6_iso.png

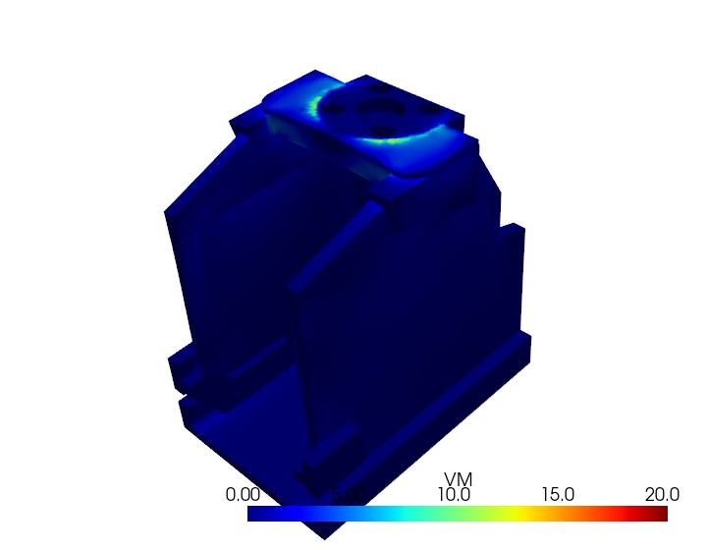
refine/fea/l5_r6_iso.png
