Riyu-D1/Vector/refine/fea/l5_r6comb2_iso.png

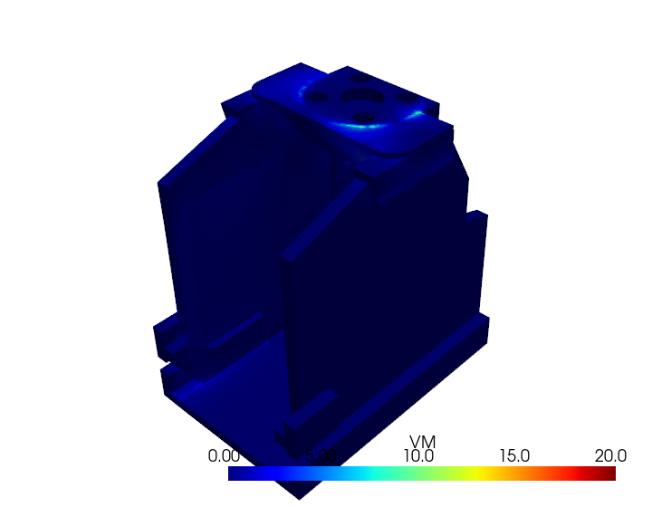
refine/fea/l5_r6comb2_iso.png
