Riyu-D1/Vector/refine/fea/l5_r6latf_iso.png

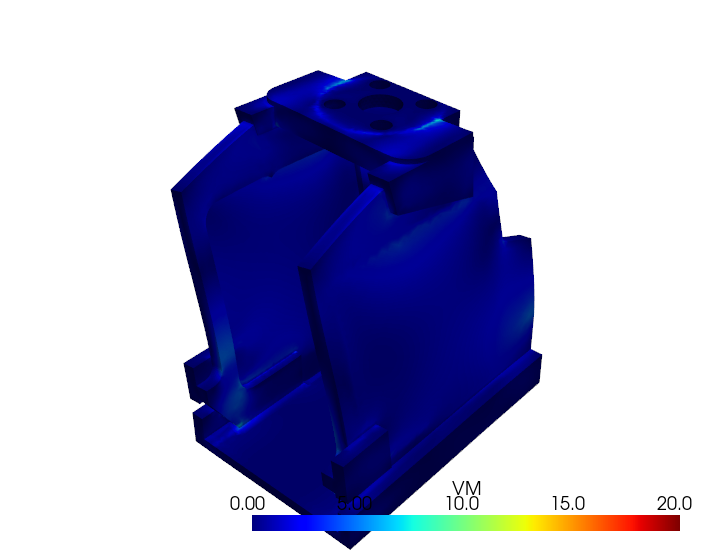
refine/fea/l5_r6latf_iso.png
