Riyu-D1/Vector/refine/fea/l5_r7flop_iso.png

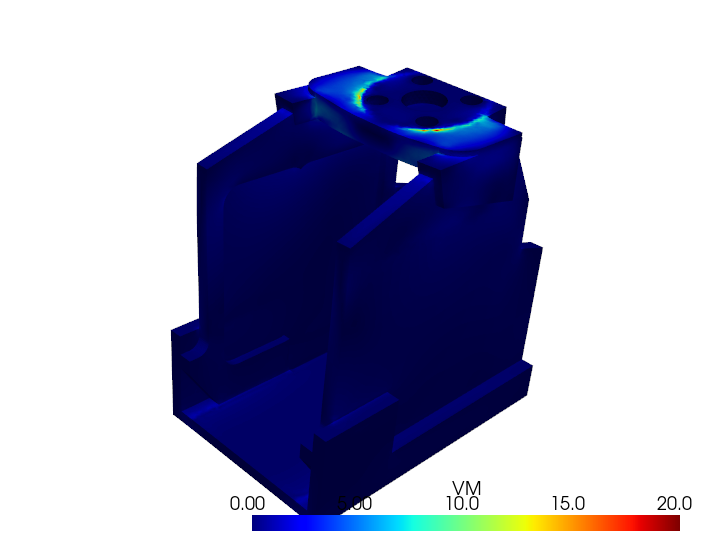
refine/fea/l5_r7flop_iso.png
