Riyu-D1/Vector/refine/fea/stock_tool_grip_front.png

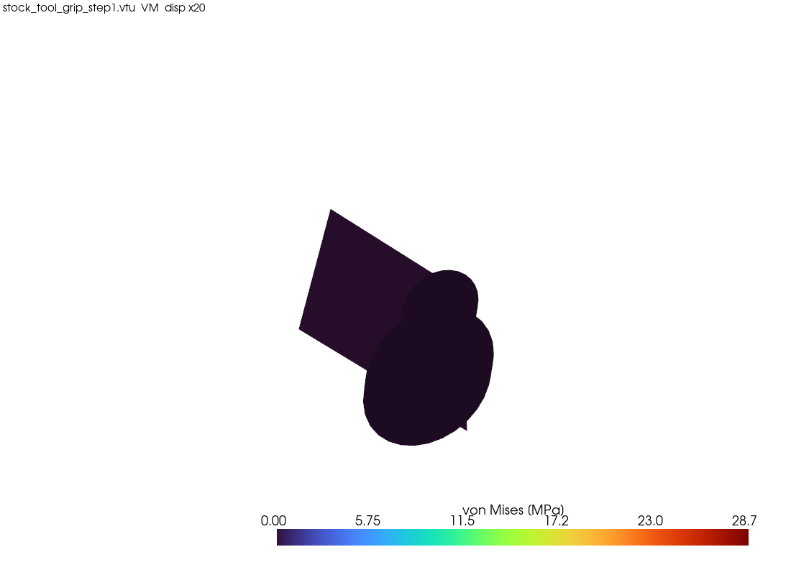
refine/fea/stock_tool_grip_front.png
