Riyu-D1/Vector/refine/fea/stock_tool_grip_iso.png

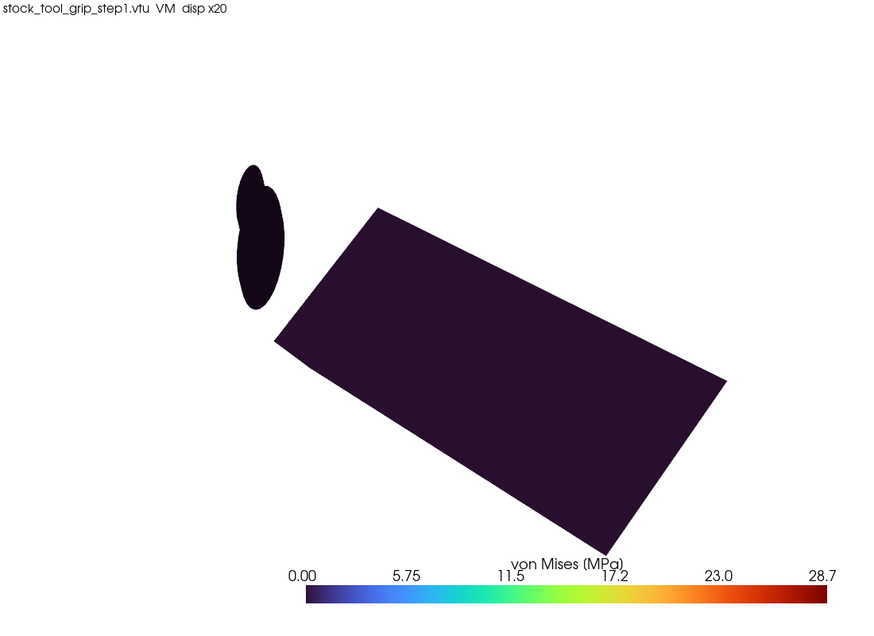
refine/fea/stock_tool_grip_iso.png
