Riyu-D1/Vector/refine/fea/stock_w_grip_frame_iso.png

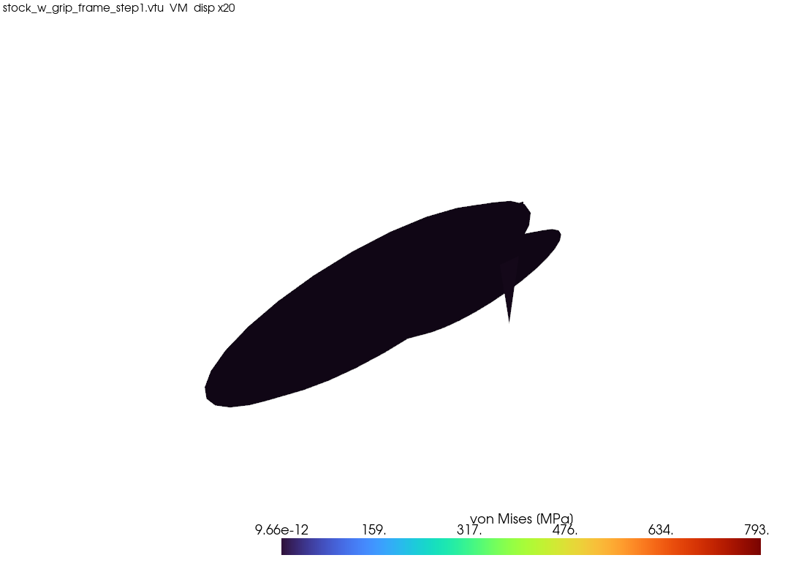
refine/fea/stock_w_grip_frame_iso.png
