Riyu-D1/Vector/refine/renders/r8_sheet2_fea.png

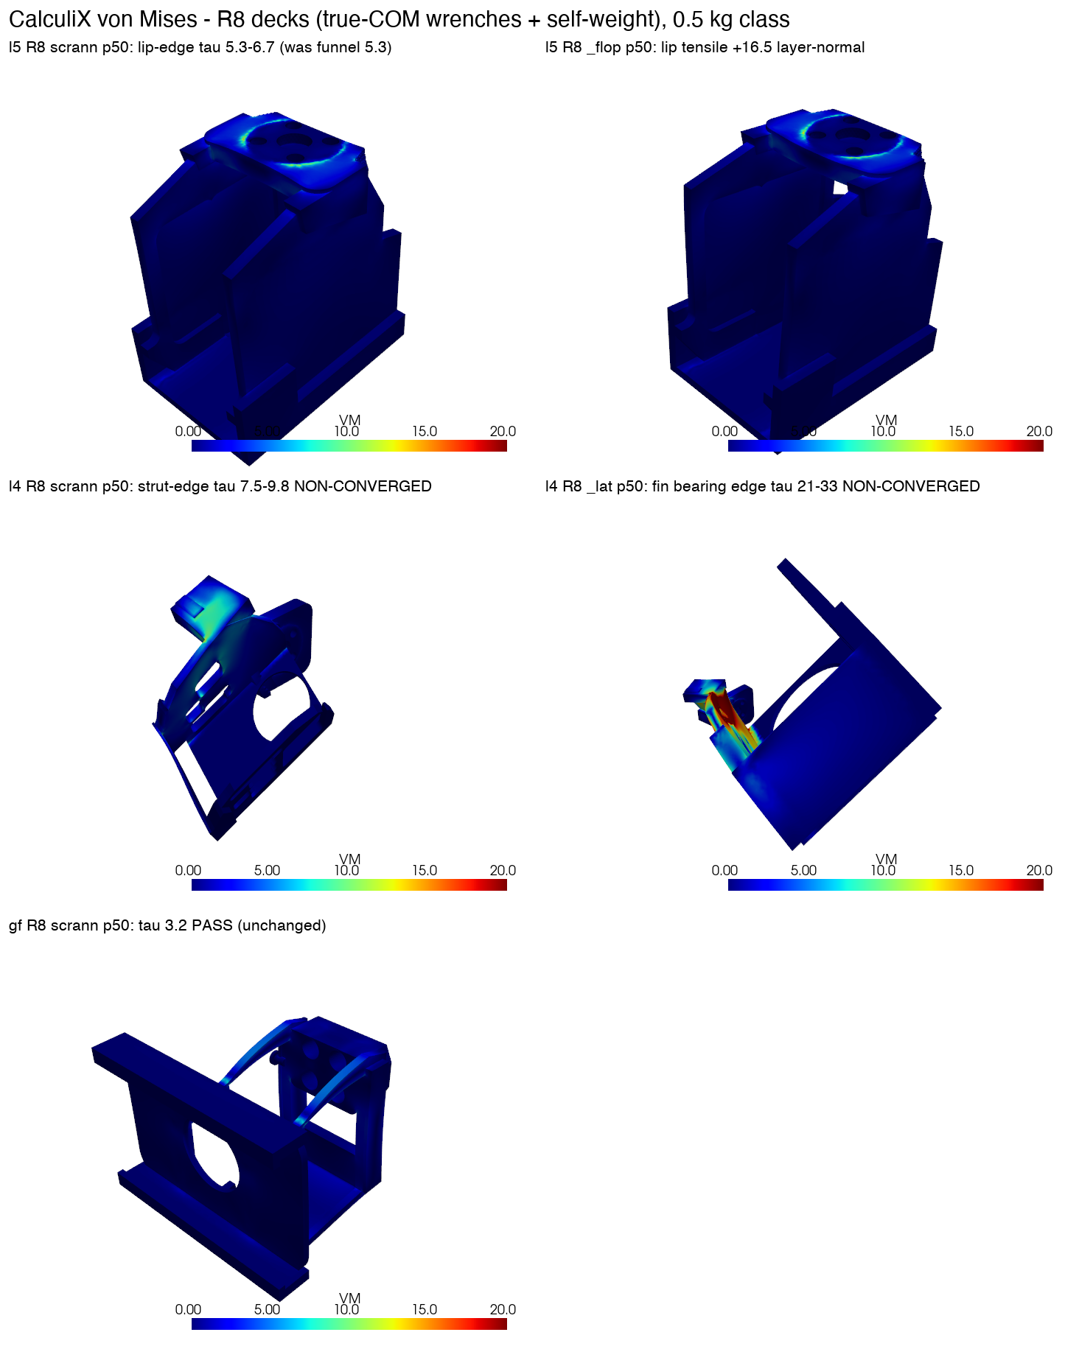
refine/renders/r8_sheet2_fea.png
