Riyu-D1/Vector/refine/renders/stock_tool_grip.png

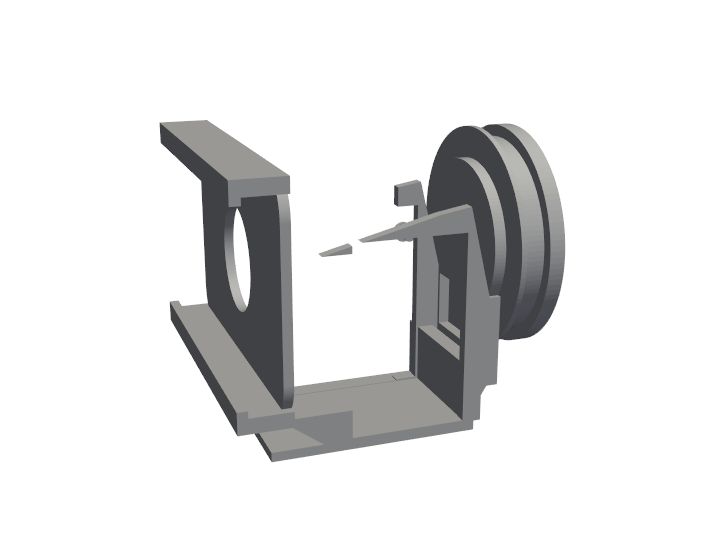
refine/renders/stock_tool_grip.png
