Riyu-D1/Vector/refine/renders/stock_w_grip_frame.png

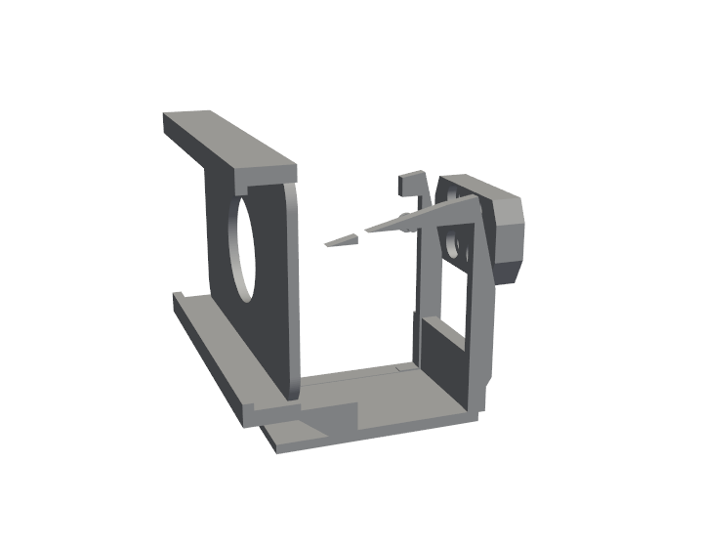
refine/renders/stock_w_grip_frame.png
