Riyu-D1/Vector/refine/renders/stock_w_j4_cradle.png

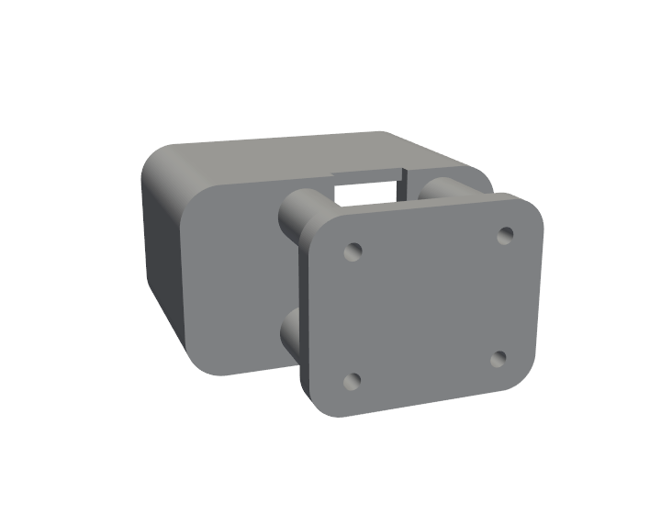
refine/renders/stock_w_j4_cradle.png
