Riyu-D1/Vector/refine/renders/stock_w_link4.png

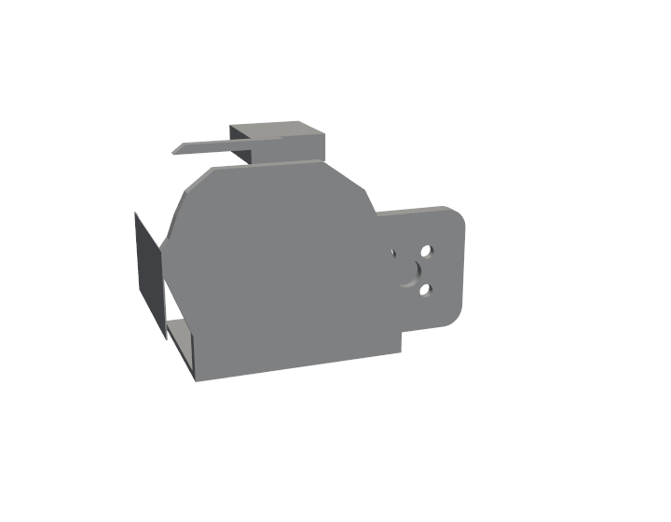
refine/renders/stock_w_link4.png
