Riyu-D1/Vector/refine/renders/stock_w_link5.png

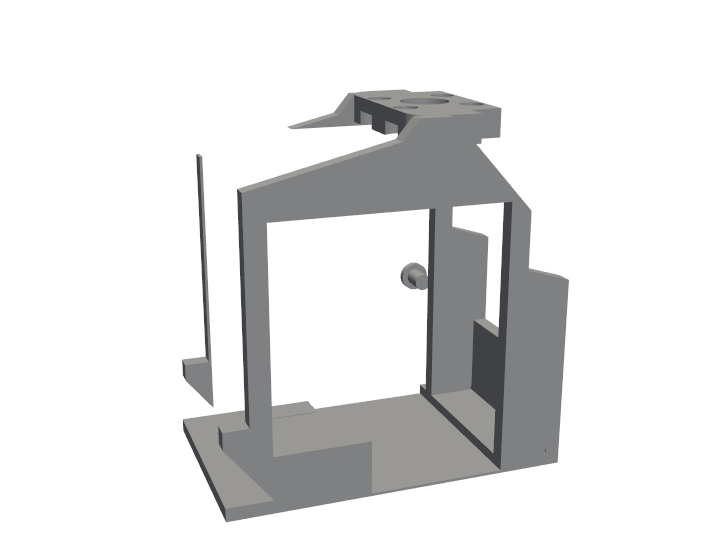
refine/renders/stock_w_link5.png
