Riyu-D1/Vector/toolchg/check/fea/plate_1catch_front.png

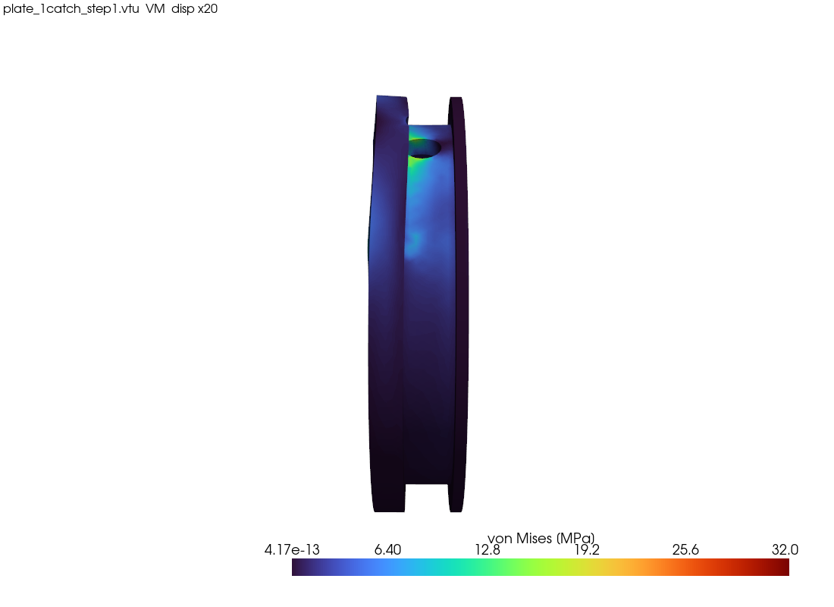
toolchg/check/fea/plate_1catch_front.png
