Riyu-D1/Vector/toolchg/check/fea/plate_1catch_iso.png

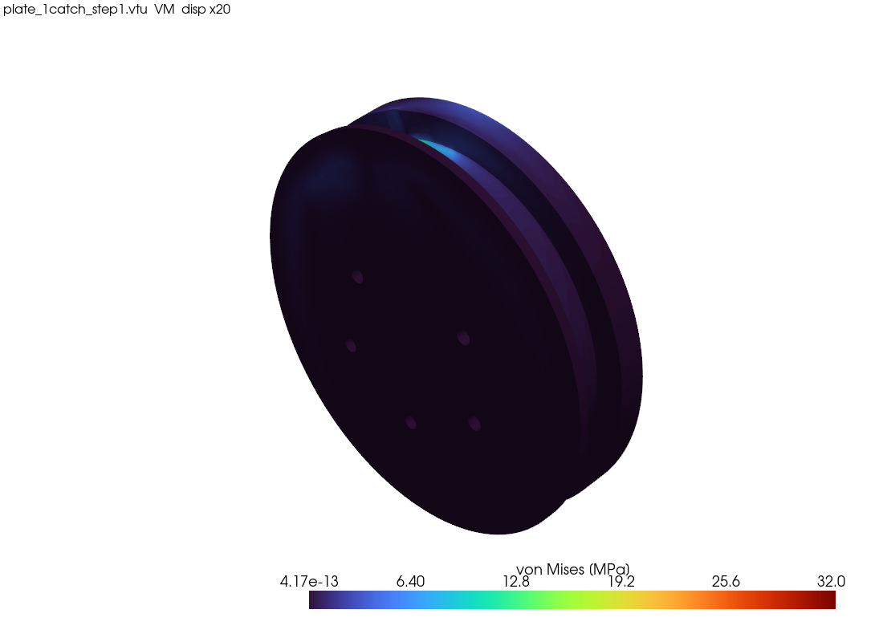
toolchg/check/fea/plate_1catch_iso.png
