Riyu-D1/Vector/toolchg/check/fea/tc_rack_iso.png

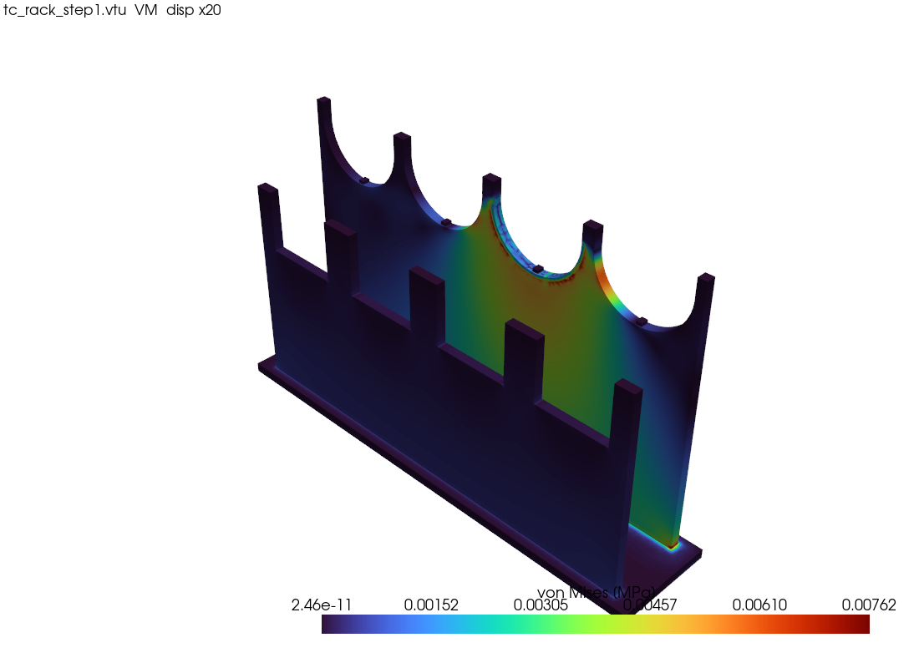
toolchg/check/fea/tc_rack_iso.png
