Riyu-D1/Vector/toolchg/check/fea/tool_grip_front.png

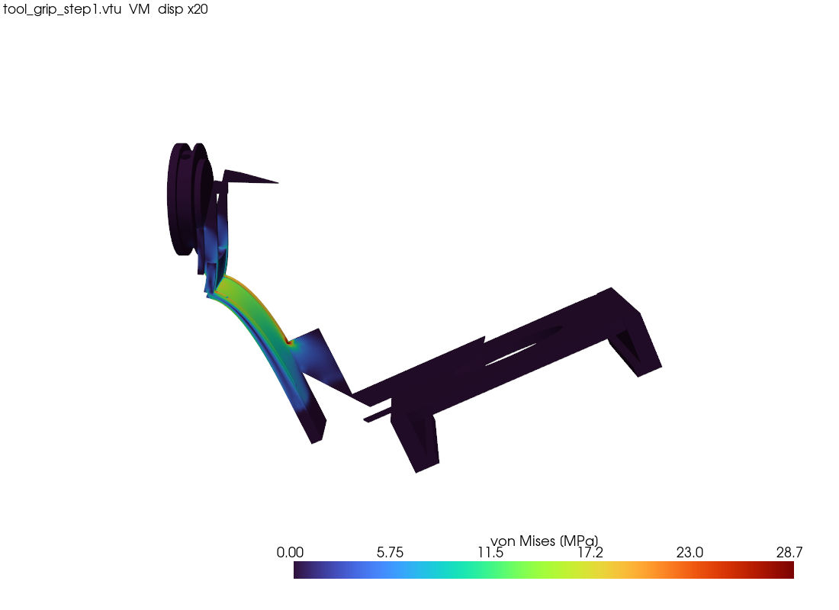
toolchg/check/fea/tool_grip_front.png
