Riyu-D1/Vector/toolchg/check/fea/tool_grip_iso.png

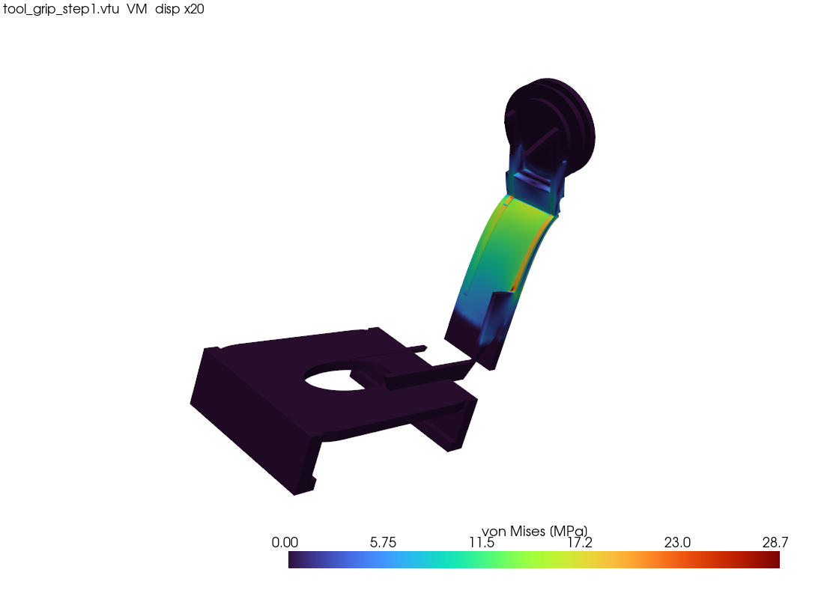
toolchg/check/fea/tool_grip_iso.png
