Riyu-D1/Vector/toolchg/check/fea/tool_pen_front.png

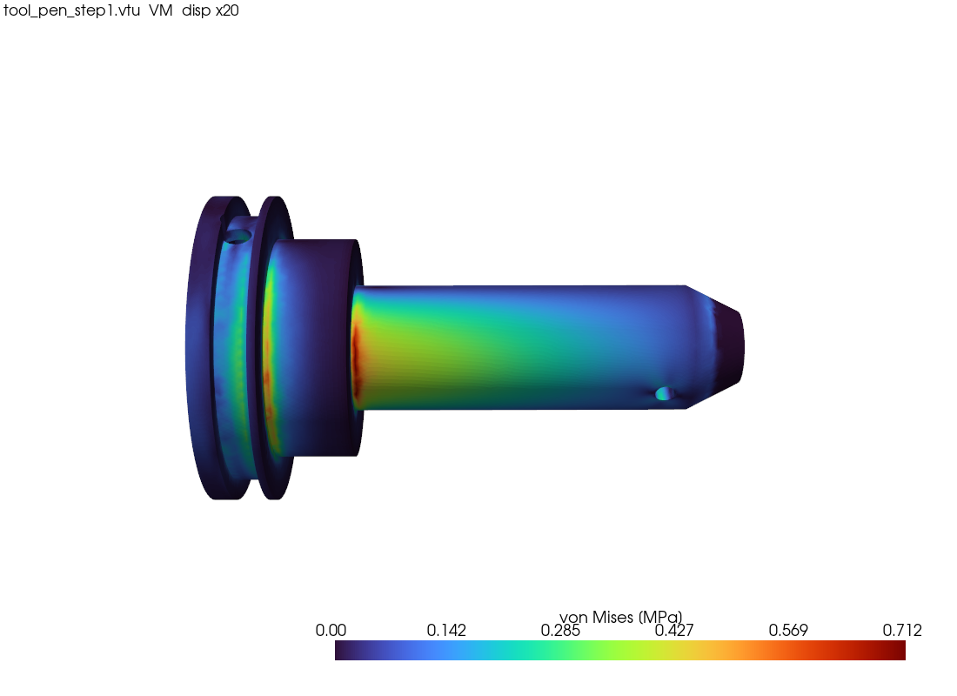
toolchg/check/fea/tool_pen_front.png
