Riyu-D1/Vector/toolchg/check/fea/tool_pen_iso.png

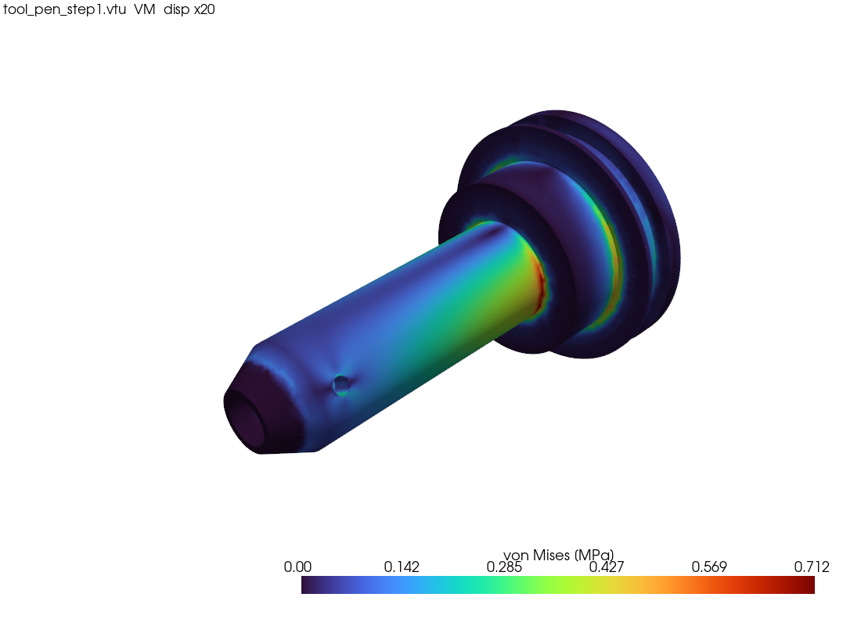
toolchg/check/fea/tool_pen_iso.png
