Riyu-D1/Vector/toolchg/renders/arm_frontiso.png

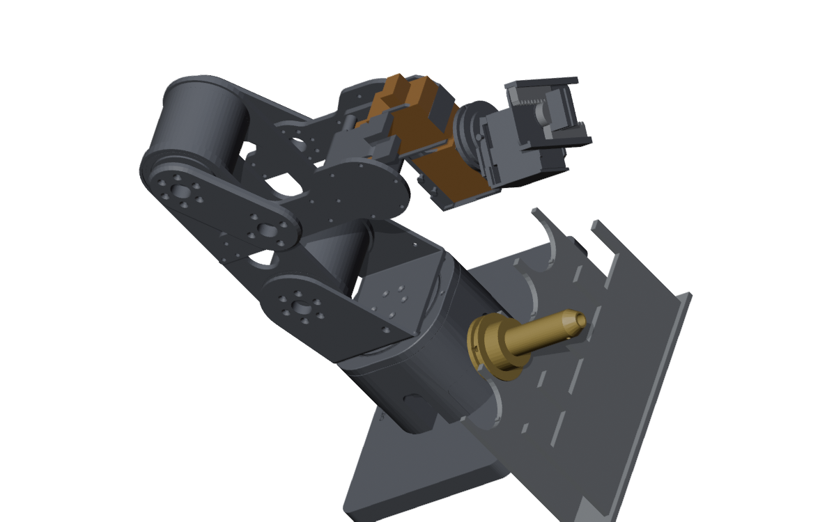
toolchg/renders/arm_frontiso.png
