Riyu-D1/Vector/toolchg/renders/arm_side.png

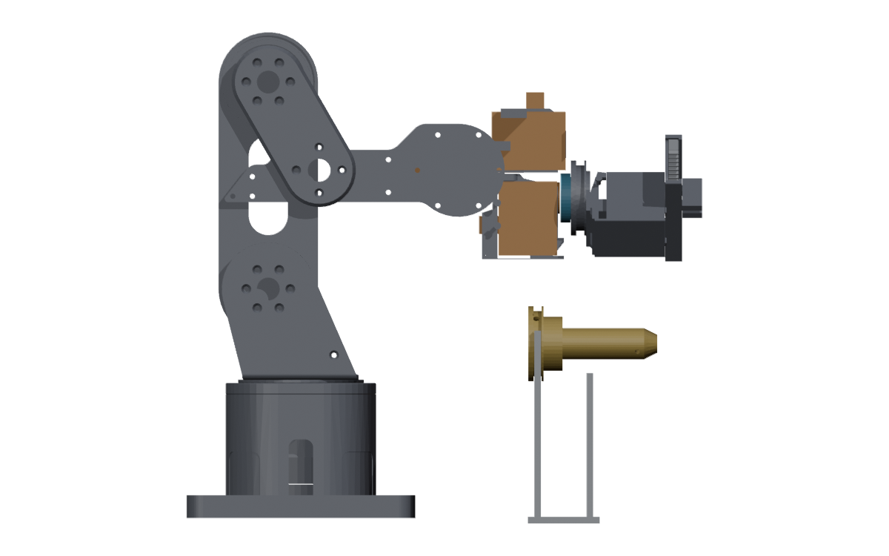
toolchg/renders/arm_side.png
