Riyu-D1/Vector/toolchg/renders/asm_frontiso.png

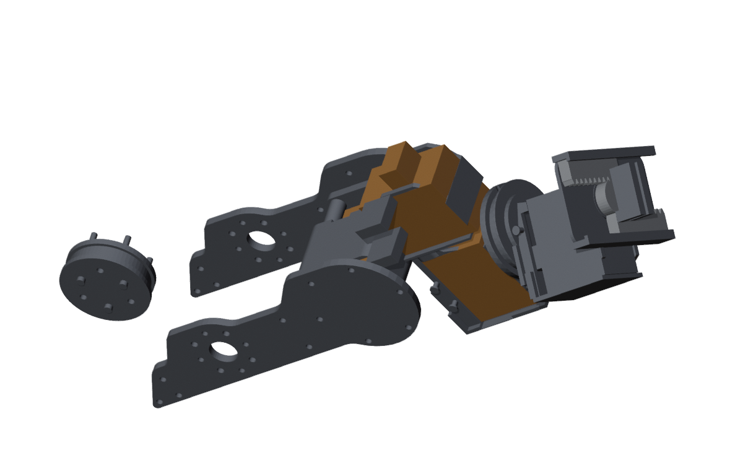
toolchg/renders/asm_frontiso.png
