Riyu-D1/Vector/toolchg/renders/asm_side.png

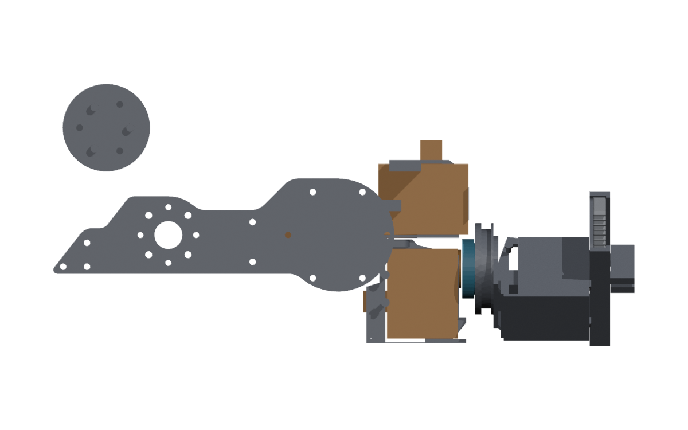
toolchg/renders/asm_side.png
