Riyu-D1/Vector/toolchg/renders/concept_frontiso.png

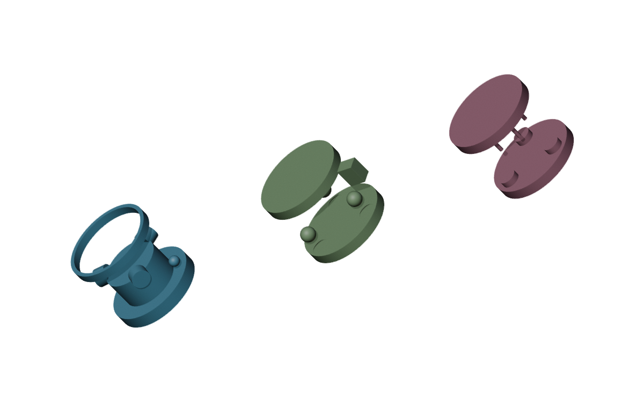
toolchg/renders/concept_frontiso.png
