Riyu-D1/Vector/toolchg/renders/concept_top.png

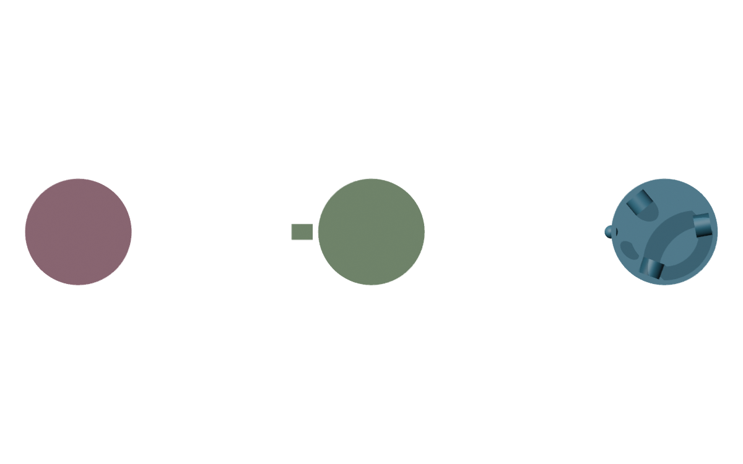
toolchg/renders/concept_top.png
