Riyu-D1/Vector/toolchg/renders/rack_frontiso.png

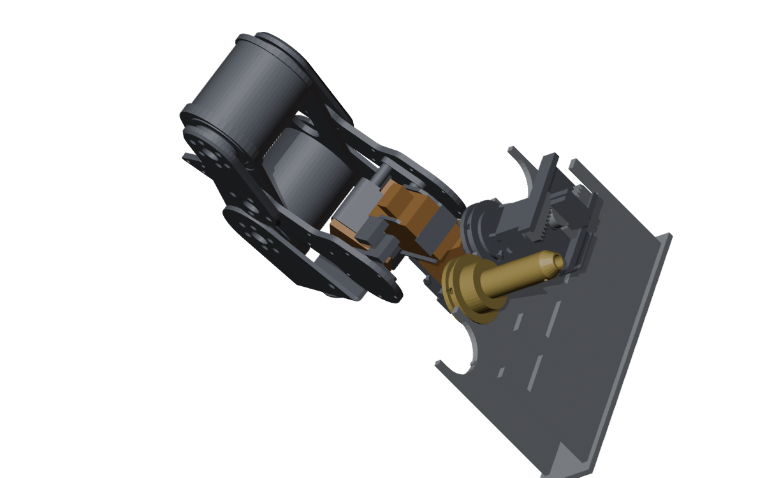
toolchg/renders/rack_frontiso.png
