Riyu-D1/Vector/toolchg/renders/rack_top.png

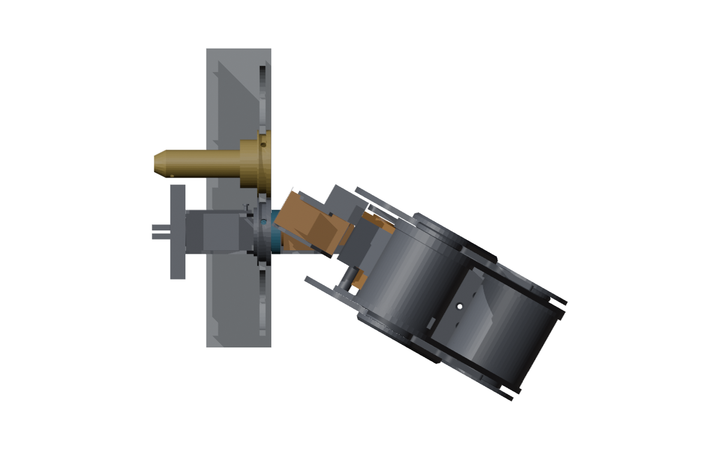
toolchg/renders/rack_top.png
