Riyu-D1/Vector/toolchg/renders/rackonly_front.png

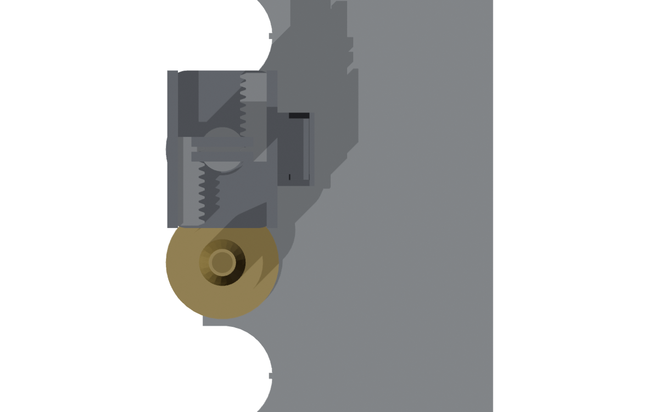
toolchg/renders/rackonly_front.png
