Riyu-D1/Vector/toolchg/renders/rackonly_frontiso.png

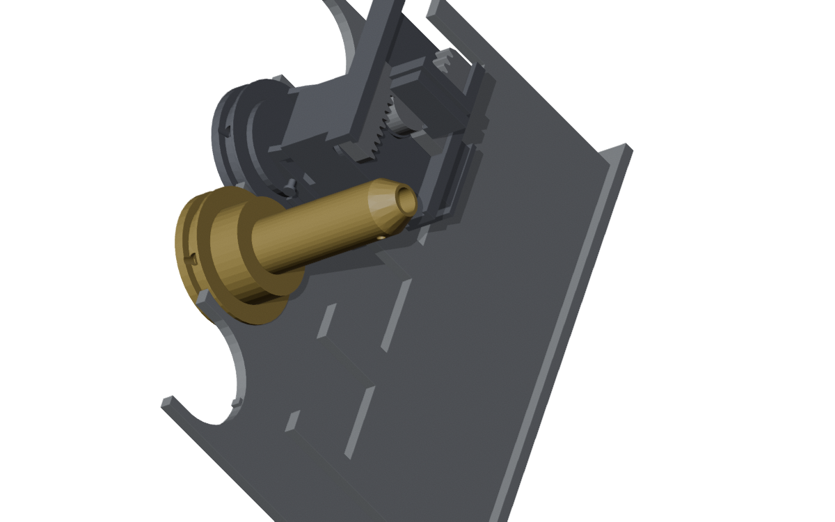
toolchg/renders/rackonly_frontiso.png
