Riyu-D1/Vector/wrist2/renders/after_backiso.png

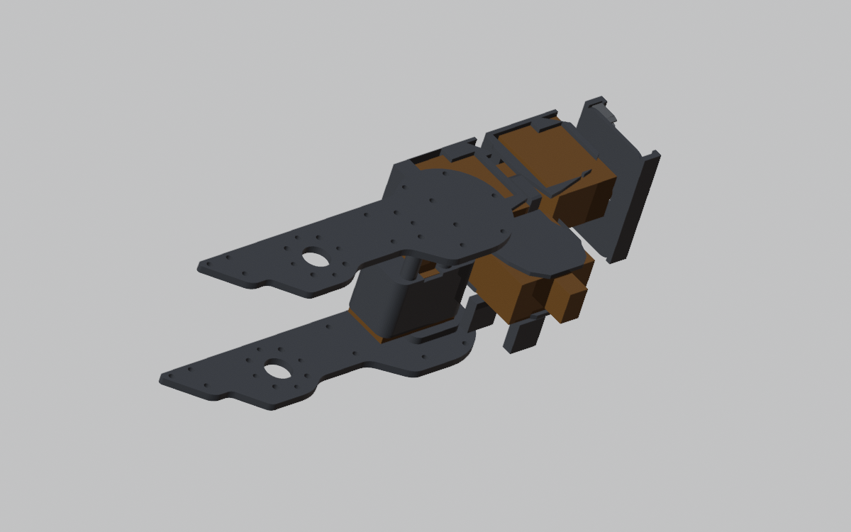
wrist2/renders/after_backiso.png
