Riyu-D1/Vector/wrist2/renders/after_cutaway.png

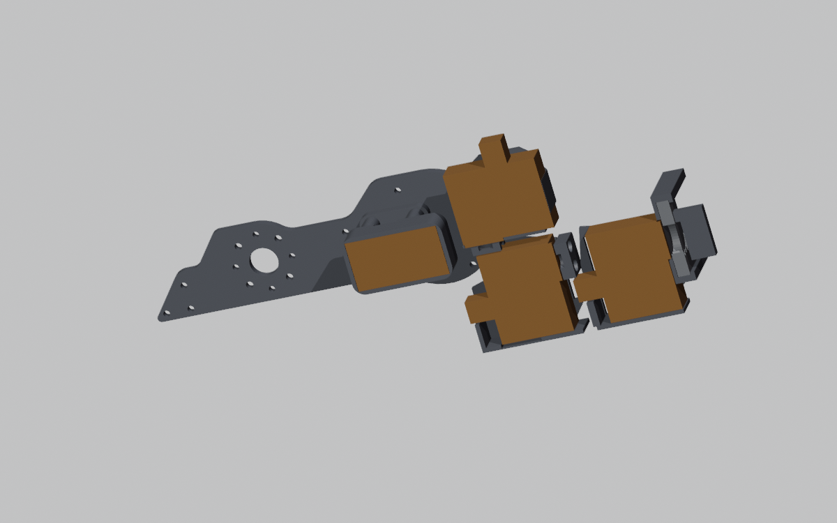
wrist2/renders/after_cutaway.png
