Riyu-D1/Vector/wrist2/renders/after_front.png

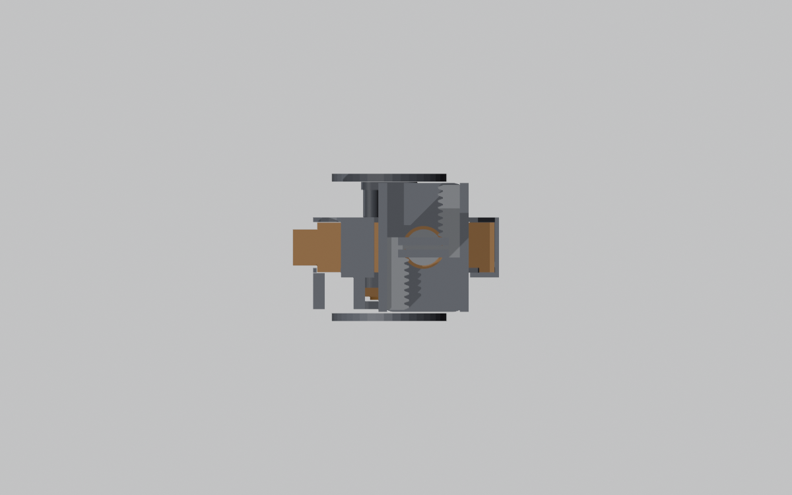
wrist2/renders/after_front.png
