Riyu-D1/Vector/wrist2/renders/after_frontiso.png

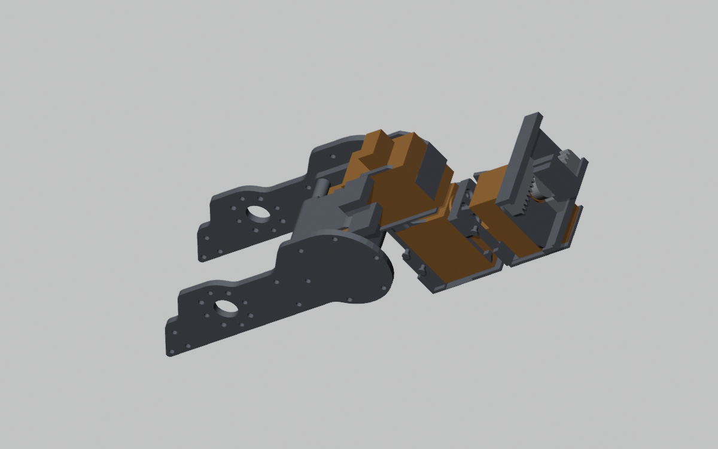
wrist2/renders/after_frontiso.png
