Riyu-D1/Vector/wrist2/renders/after_side.png

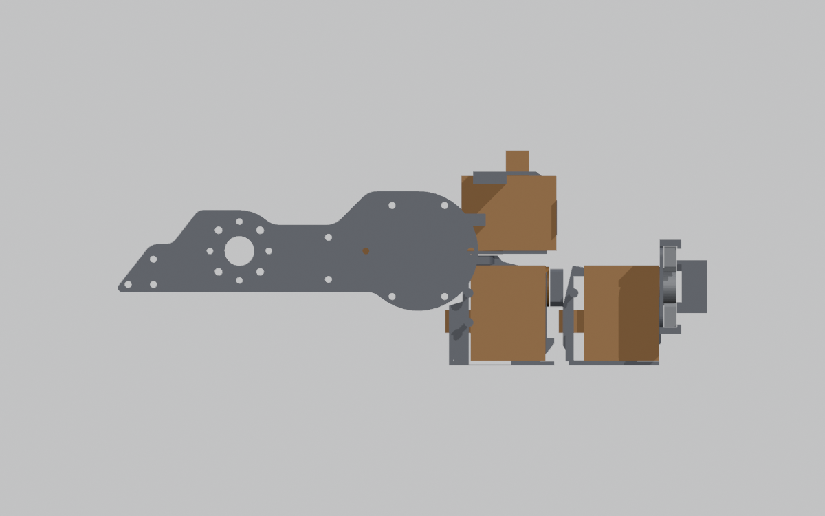
wrist2/renders/after_side.png
