Riyu-D1/Vector/wrist2/renders/after_top.png

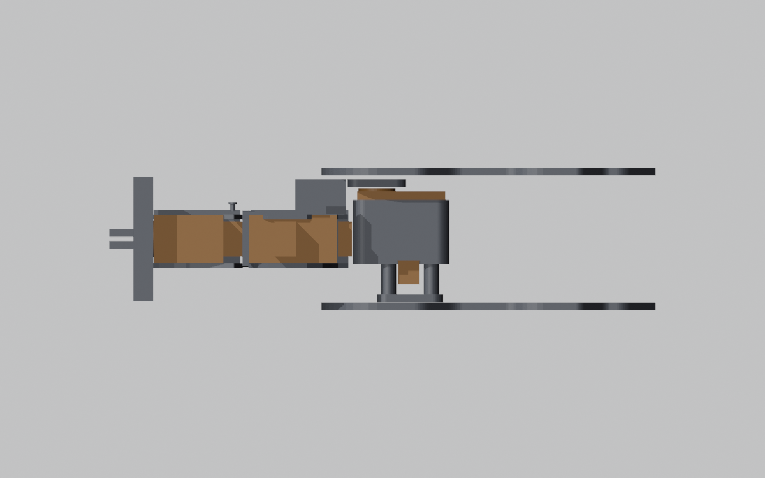
wrist2/renders/after_top.png
