Riyu-D1/Vector/wrist2/renders/before_after_frontiso.png

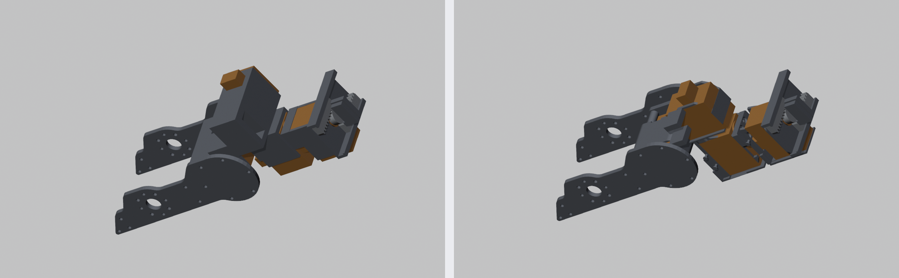
wrist2/renders/before_after_frontiso.png
