Riyu-D1/Vector/wrist2/renders/before_after_side.png

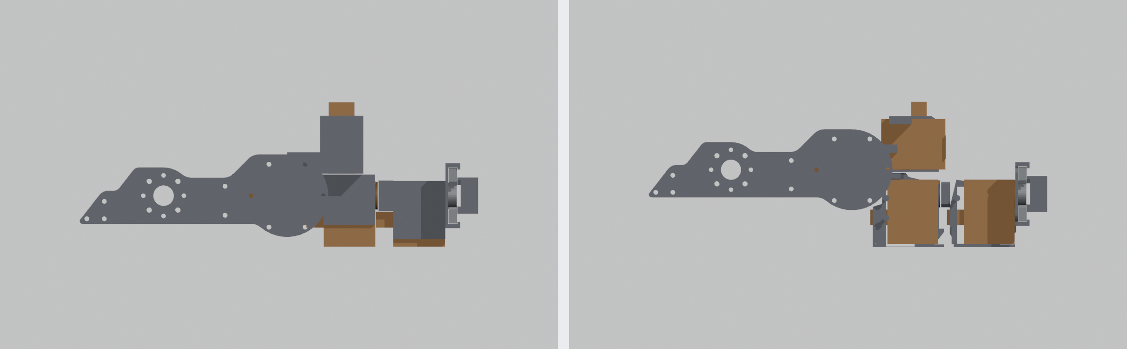
wrist2/renders/before_after_side.png
