Riyu-D1/Vector/wrist2/renders/before_backiso.png

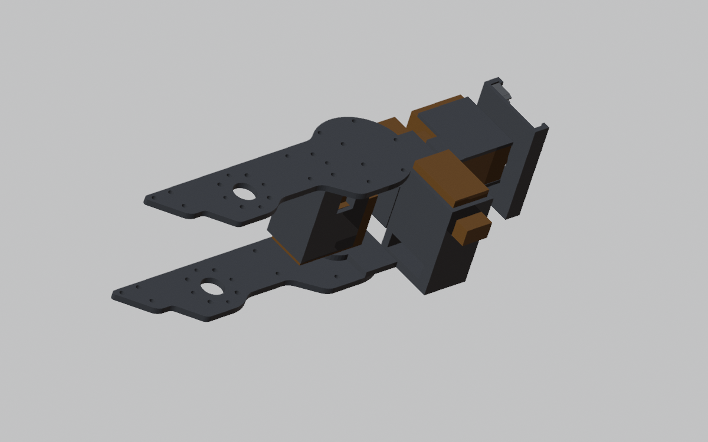
wrist2/renders/before_backiso.png
