Riyu-D1/Vector/wrist2/renders/before_cutaway.png

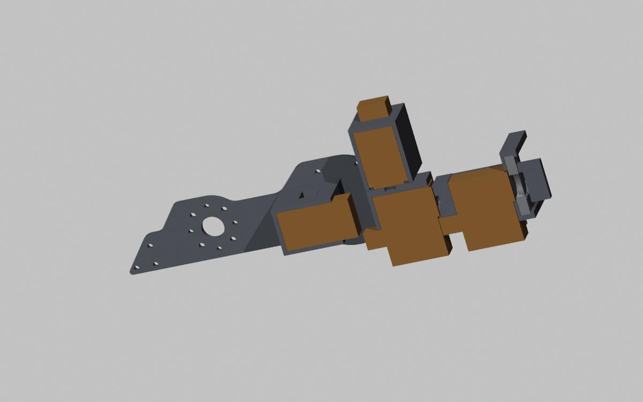
wrist2/renders/before_cutaway.png
