Riyu-D1/Vector/wrist2/renders/before_frontiso.png

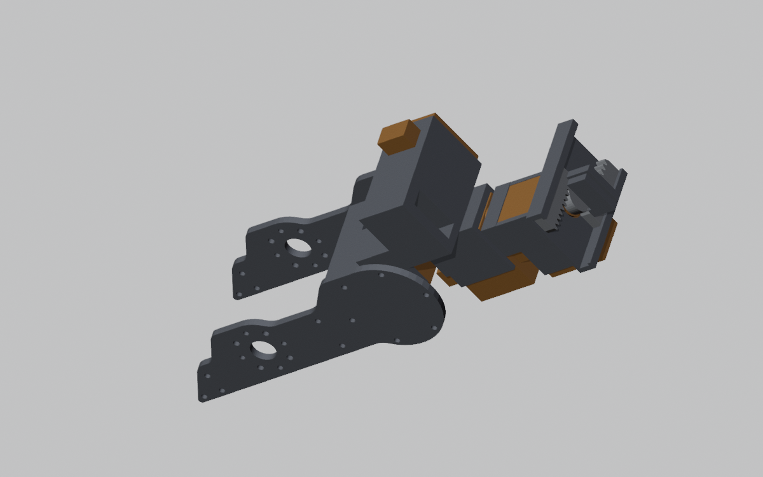
wrist2/renders/before_frontiso.png
