Riyu-D1/Vector/cyclo4/BOM.md

# BOM — one printed 40:1 cycloidal actuator module

USD, prices from the study read 28 Oct 2026; [U] = not verified.

| Qty | Item | Size | USD |
|---|---|---|---|
| 1 | Tarot TL2955 4008 330KV | Ø44.5×22, 85 g, 4 mm shaft | 45.99 Foxtech [S study]; AliExpress 25–29 [U] |
| 1 | ST B-G431B-ESC1 (outside module) | 30×41, CAN | 39.26 ST eStore [S study] |
| 1 | AS5600 board + 6×2.5 diametric magnet | board 23×23 [U] | 3–5 [U] |
| 1 | 6808-2RS | 40×52×7 | ~4 [U] |
| 2 | 6702-2RS | 15×21×4 | ~2 total [U] |
| 1 | 685-2RS | 5×11×5 | ~0.5 [U] |
| 41 | dowel ISO 8734 Ø3×10 (50:1: 51 × Ø2.5×10) | hardened steel | ~3 [U] |
| 6 | dowel Ø3×12 (output pins) | | ~1 [U] |
| 3 | dowel Ø4×8 (output locating) | | ~1 [U] |
| 6 | M3×8 thread-forming or ISO 7380 (link → back face; length = link plate + 3) | | |
| 3 | M3×6 ISO 7380 (stator base → housing back plate, PCD 32, from the back) [U thread depth] | | |
| 3 | M3 heat-set insert 4.6×5.7 + M3×8 ISO 7380 (flange → carrier) | | |
| 2 | M3×5 ISO 7380 (hub flange → Tarot bell top, 34 mm prop holes) + Loctite 243 [U thread depth; kit screws M3×11.3 are too long] | | |
| 1 | M3×4 ISO 7380 (mag_puck → shaft end, replaces Tarot's button screw + washer) [U] | | |
| 1 | mag_puck, printed (Ø12 × 6, magnet pocket Ø6.05) | | |
| | Filament ~90 g | | ~2 [U] |
| | **Module total** (ESC included) | | **≈ $105 [U]**; 2 modules ≈ $210 (study: $196.50 + pins/screws) |

**Print (Bambu A1, 0.4 nozzle):**
- Housing, mid_plate, rings: PETG, 0.2 layer, 6 walls, 40 % gyroid.
- Discs, hub, carrier, out_flange: PA-CF (dry 8 h at 80 °C) or PETG, 0.12 layer, 6 walls, 100 % infill.
- No supports. Clearance rule: 0.15 per side on slip fits; fit-test the 6808 seat and the Ø3 pin holes first (print only the housing front 12 mm).
- Grease the ring pins and discs with PTFE or lithium grease.
