Riyu-D1/Vector/cad/arm2/BOM.md

# BOM — cad/arm2 (A2a: base, J1, Link1, J2, upper arm, J3, forearm plates)
| Qty | Item | Notes | Done |
|---|---|---|---|
| 1 | base_plate, printed (reBot 01_BASE_Plate, unchanged) | 140 × 200 × 14 | |
| 1 | base_link, printed (reBot 01_BASE_Link, cut for STS3250) | | |
| 1 | j1_cradle, printed (new) | Ø57.5 × 54.5, servo pocket | |
| 1 | base_reinf, printed (reBot 02_Base_Reinforcement_Part, unchanged) | | |
| 1 | yaw_limit, printed (reBot 02_Arm_Yaw_Limit, re-drilled) | | |
| 1 | link1, printed (reBot 03_Link1, unchanged) | 3 mm walls | |
| 2 | front_spacer_j2 (4 mm) / front_spacer_j3 (5 mm), printed | re-drilled reBot spacer | |
| 2 | flange_j2 / flange_j3, printed (reBot 02_FLANGE, bore Ø8) | | |
| 2 | back_spacer_j2 / _j3, printed | 4.7 mm | |
| 1 | upper_out, printed | 4 mm plate + ring collars | |
| 1 | upper_back, printed | 4 mm plate | |
| 2 | dogleg_l / dogleg_r, printed (reBot 02_Lower_Upper_Link_L/_R) | 5 mm | |
| 2 | fore_l / fore_r, printed | 4 mm | |
| 2 | printed cycloidal actuator (cad/act2, tag act-1c-done) | J2, J3 | |
| 1 | Feetech STS3250 servo + its metal horn | J1 [U case = STS3215 case] | |
| 2 | 6803ZZ (17 × 26 × 5) | J2, J3 back | |
| 1 | AXK5578 thrust bearing + 2 washers, 1 × 6707 (reBot J1) | | |
| 12 | M3×10 ISO 10642 countersunk | upper_back + back spacer → actuator back pilots [U grip 1.3 mm] | |
| 3 | M3×14 ISO 7380 | Link1 cheek → front_spacer_j2 → actuator flange → carrier inserts | |
| 3 | M3×16 ISO 7380 | dogleg_l → front_spacer_j3 → actuator flange → carrier inserts | |
| 4 | M3×8 ISO 7380 | yaw_limit → STS3250 horn [U horn thread] | |
| — | all other reBot fasteners (Link1 ↔ yaw_limit, FLANGE ↔ Link1 / dogleg_r, dogleg ↔ forearm, base) | as reBot BOM | |
