Riyu-D1/Vector/cad/arm2b/BOM.md

# BOM — cad/arm2b (A2b additions: wrist J4–J6 + gripper). The A2a BOM (cad/arm2/BOM.md) still applies; fore_l/fore_r are replaced by fore_l2/fore_r2.
| Qty | Item | Notes | Done |
|---|---|---|---|
| 2 | fore_l2 / fore_r2, printed (replace A2a fore_l / fore_r) | 4 mm, Ø38 plugged, fore_r2 4× Ø3.4 | |
| 1 | j4_cradle, printed (new) | J4 servo pocket, 2.5 walls | |
| 1 | link4, printed (new, replaces reBot Wrist_Bracket + Lower_Wrist_Link_L/R) | 4 mm horn plate + J5 pocket | |
| 1 | link5, printed (new, replaces reBot 03_Link5) | 4 mm horn plate + J6 pocket | |
| 1 | grip_frame, printed (new, replaces reBot Gripper_Connector + Rail_Bracket) | | |
| 2 | finger_u / finger_d, printed (new) | 4 mm | |
| 4 | Feetech STS3215 servo (12 V) + metal horn Ø19.2 (4× M3 on PCD14) | J4, J5, J6, gripper [U rated 0.98 N·m] | |
| 1 | spur gear m1 16T (reBot GEAR-1M16C), Ø18 × 6 | on the gripper horn, 4× Ø3.4 PCD14 drilled + countersunk [U] | |
| 2 | gear rack m1, 6 × 12, cut to 36 mm (reBot 02_Rack) | glued / M2 into the finger tabs [U] | |
| 4 | M3×10 ISO 7380 | fore_r2 → j4_cradle pilots Ø2.5 [U grip] | |
| 12 | M3×8 ISO 7380 | link4 / link5 / grip_frame → STS3215 horns [U horn thread] | |
| 4 | M3×8 ISO 10642 countersunk | gear → gripper horn [U] | |
| 3 | STS3215 3-pin servo cables, 200–300 mm | daisy chain J4 → J5 → J6 → gripper [U route] | |
