Riyu-D1/Vector/fullcheck/fea/parts_rerun.txt

j4_cradle
cy2_housing
cy2_carrier
cy2_out_flange
cy3_housing
cy3_carrier
cy3_out_flange
j1_cradle
base_link
