Riyu-D1/Vector/refine/renders/r8_sheet1_parts.png

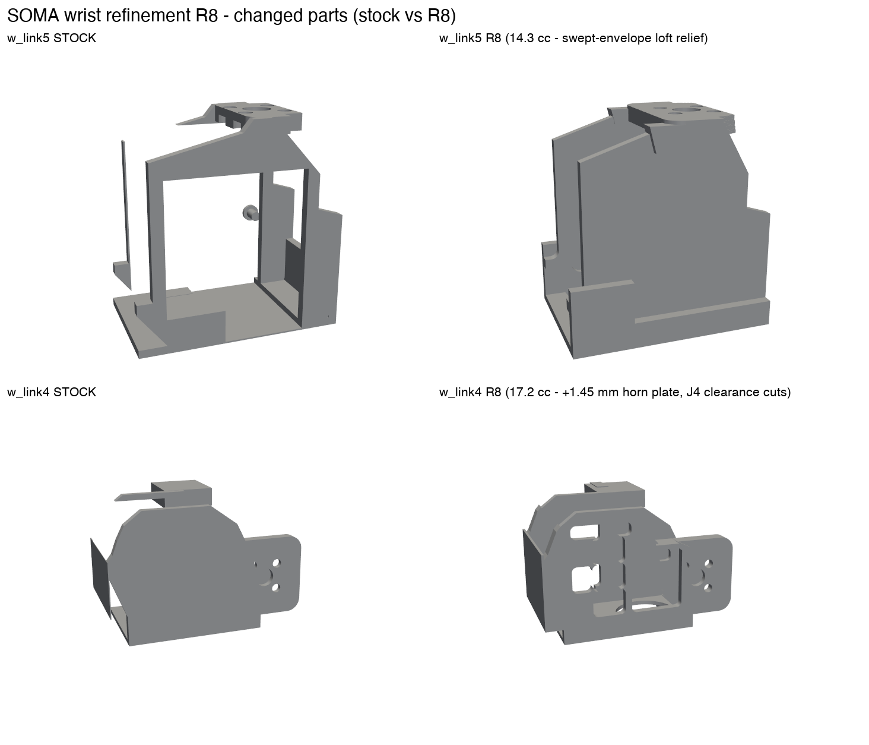
refine/renders/r8_sheet1_parts.png
