Riyu-D1/Vector/refine/renders/sheet1_parts.png

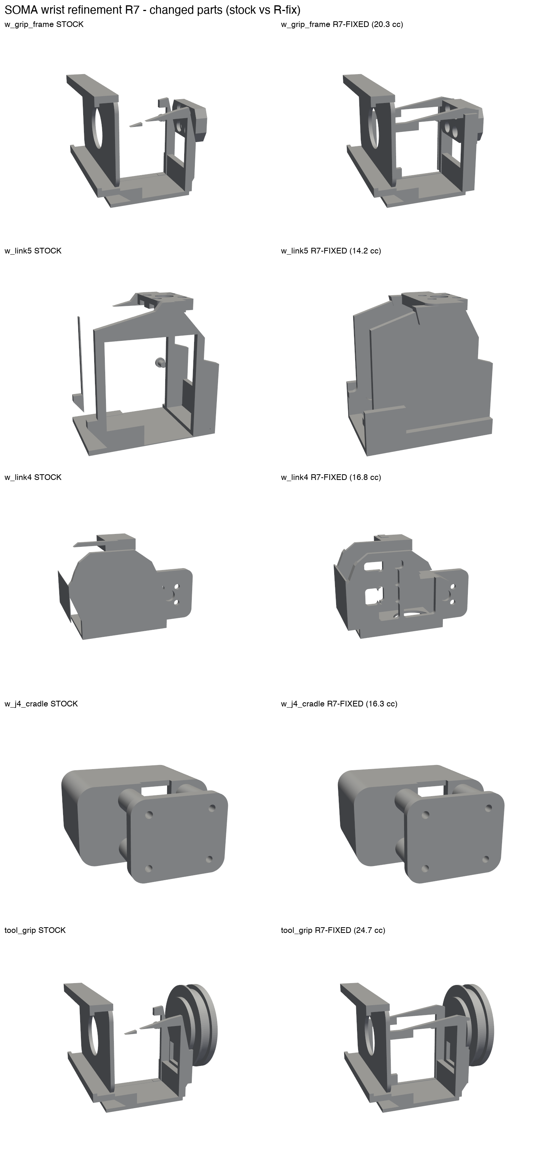
refine/renders/sheet1_parts.png
