Riyu-D1/Vector/final/out/assembly.stl

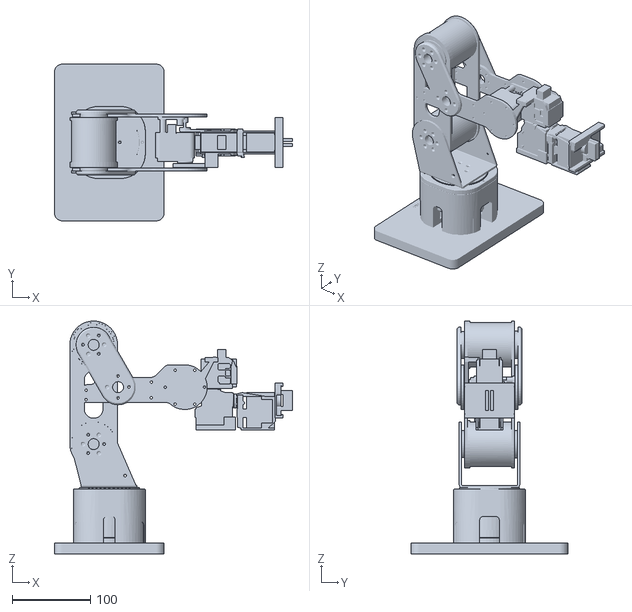
[picture p106: CAD file, 2026-11-10]
final/out/assembly.stl
303.8 x 200.0 x 297.3
