Riyu-D1/Vector/cad/arm/reference/so102_gripper_main_frame.step

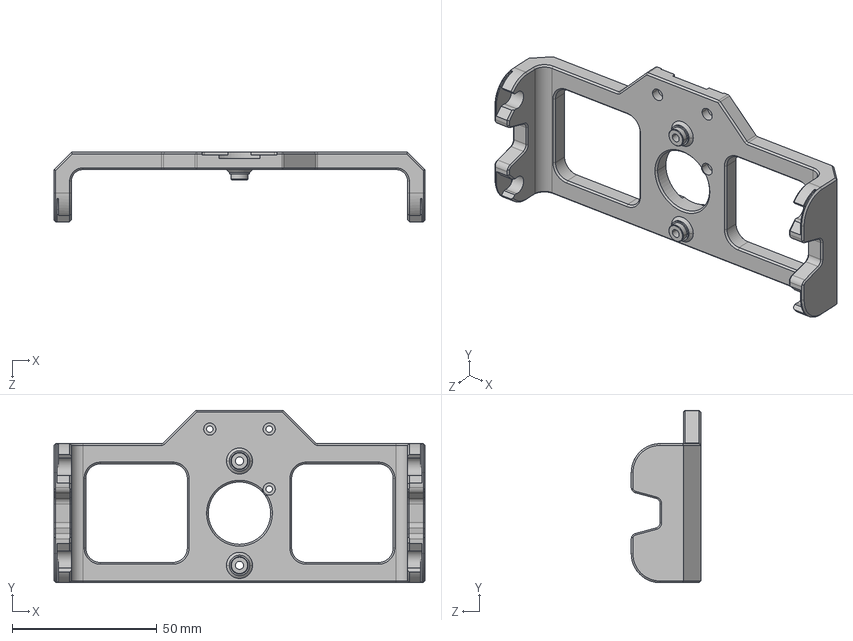
[picture p107: CAD file, 2026-11-01]
cad/arm/reference/so102_gripper_main_frame.step
128.0 x 59.5 x 24.0 mm
