Riyu-D1/Vector/refine/out/wrist9_asm.step

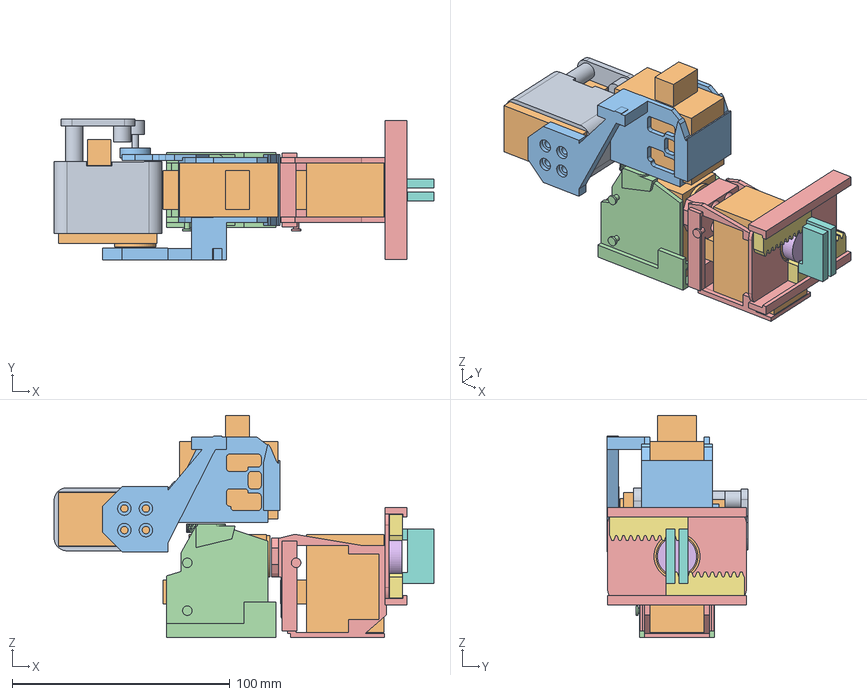
[picture p108: CAD file, 2026-11-10]
refine/out/wrist9_asm.step
174.7 x 64.7 x 102.2 mm
w_j4_cradle
vendor_sts3215_j4
w_link4
vendor_sts3215_j5
w_link5
vendor_sts3215_j6
w_grip_frame
vendor_sts3215_g
vendor_gear_grip
vendor_rack_u
vendor_rack_d
finger_u
finger_d
wrist_pin
