Riyu-D1/Vector/cad/arm/export/assembly.step

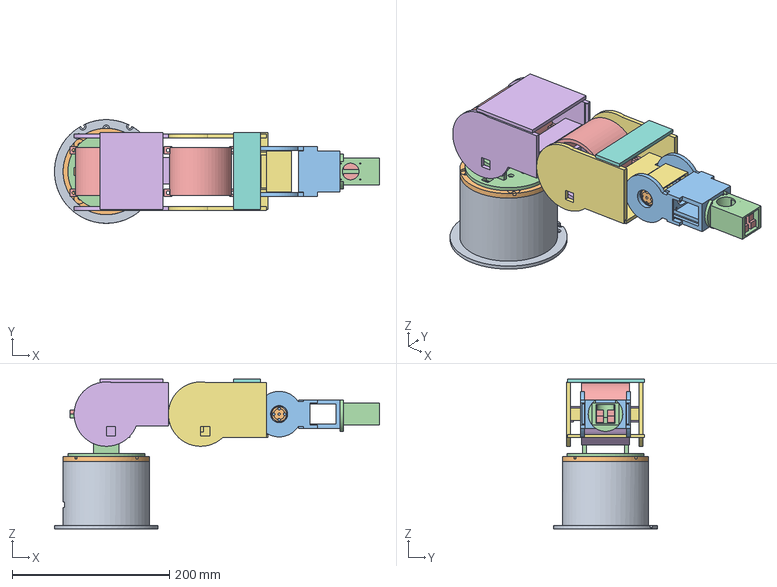
[picture p109: CAD file, 2026-11-01]
cad/arm/export/assembly.step
413.7 x 132.0 x 190.5 mm
