Riyu-D1/Vector/cad/export/SOMA_assembly.step

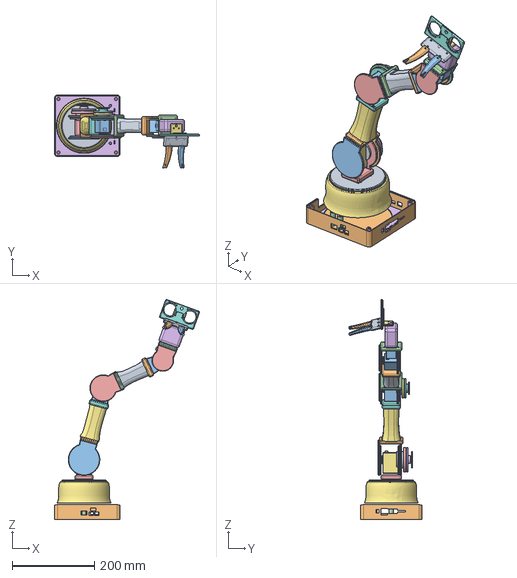
[picture p110: CAD file, 2026-10-26]
cad/export/SOMA_assembly.step
353.0 x 178.0 x 535.2 mm
