Riyu-D1/Vector/cad/actuator/export/_preview.stl

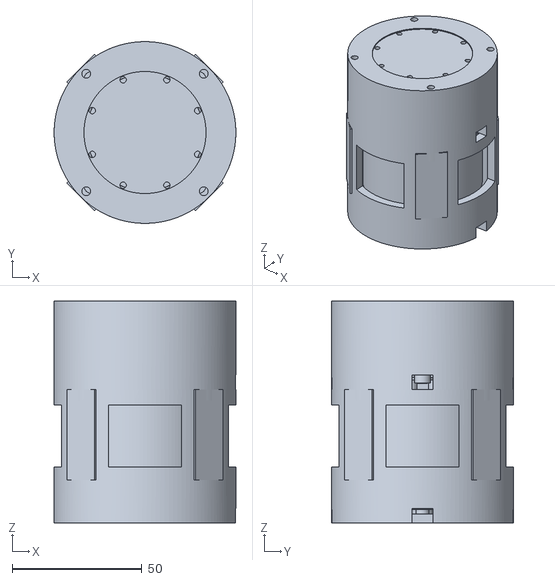
[picture p111: CAD file, 2026-11-01]
cad/actuator/export/_preview.stl
70.0 x 70.0 x 85.5
