Riyu-D1/Vector/cad/arm/export/bearing_cap.step

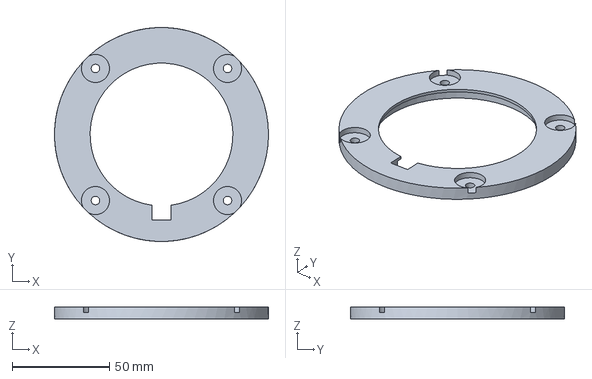
[picture p112: CAD file, 2026-11-01]
cad/arm/export/bearing_cap.step
110.0 x 110.0 x 6.00 mm
