Riyu-D1/Vector/cad/arm/reference/sts3215_servo.step

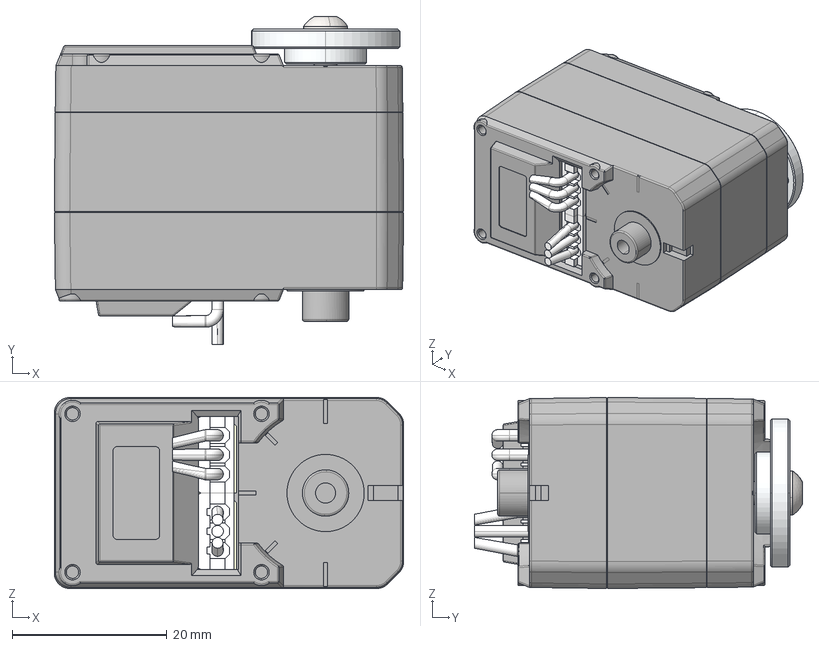
[picture p113: CAD file, 2026-11-01]
cad/arm/reference/sts3215_servo.step
45.2 x 42.5 x 24.7 mm
ZK_122^STS3215_Servo
SG-ZIJI_15^STS3215_Servo
XG-ZIJI_16^STS3215_Servo
Main_Wheel^STS3215_Servo
0050375033_Â¢Â¯à ¢Â®
0050375033_straight
socket_button_head_screw_iso_ISO_7380_-_M3_x_6_-_6N
