Riyu-D1/Vector/cad/arm2/rebot_src/02_Lower_Upper_Link_R.step

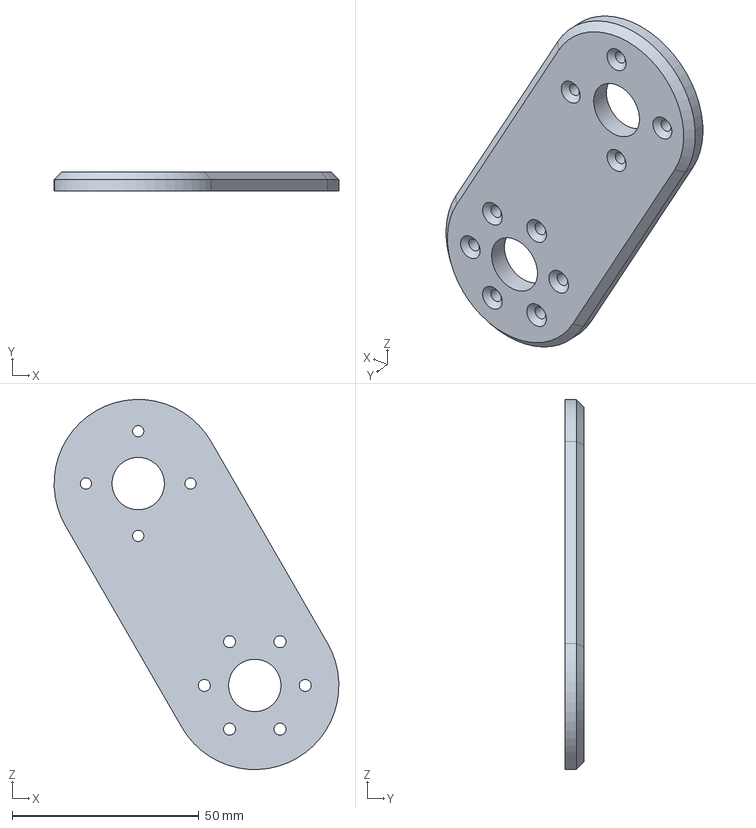
[picture p114: CAD file, 2026-11-01]
cad/arm2/rebot_src/02_Lower_Upper_Link_R.step
76.1 x 5.00 x 99.0 mm
