Riyu-D1/Vector/cad/arm2b/rebot_src/02_Rack_D.step

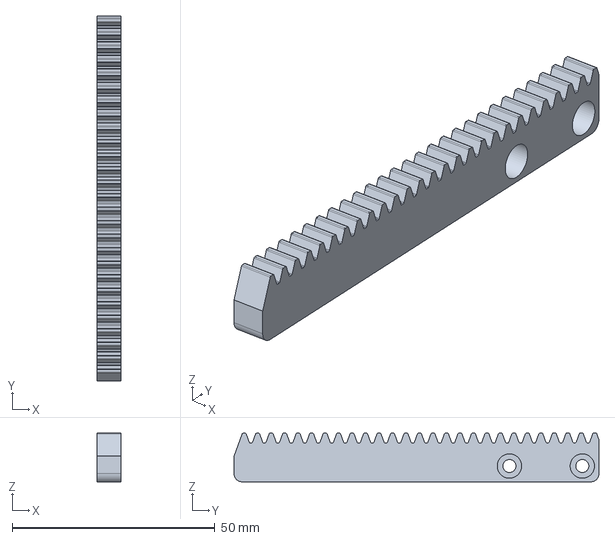
[picture p115: CAD file, 2026-11-01]
cad/arm2b/rebot_src/02_Rack_D.step
6.00 x 90.0 x 12.0 mm
