Riyu-D1/Vector/cad/export/j4_servo.step

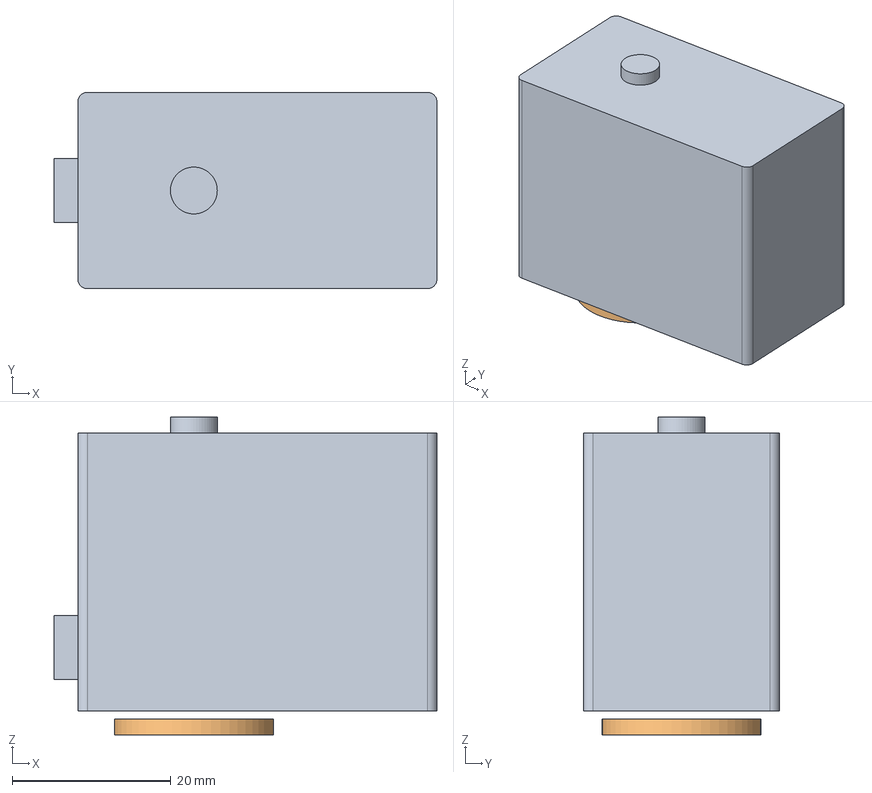
[picture p116: CAD file, 2026-10-26]
cad/export/j4_servo.step
48.2 x 24.7 x 40.0 mm
