Riyu-D1/Vector/cad3/fea/input/housing.step

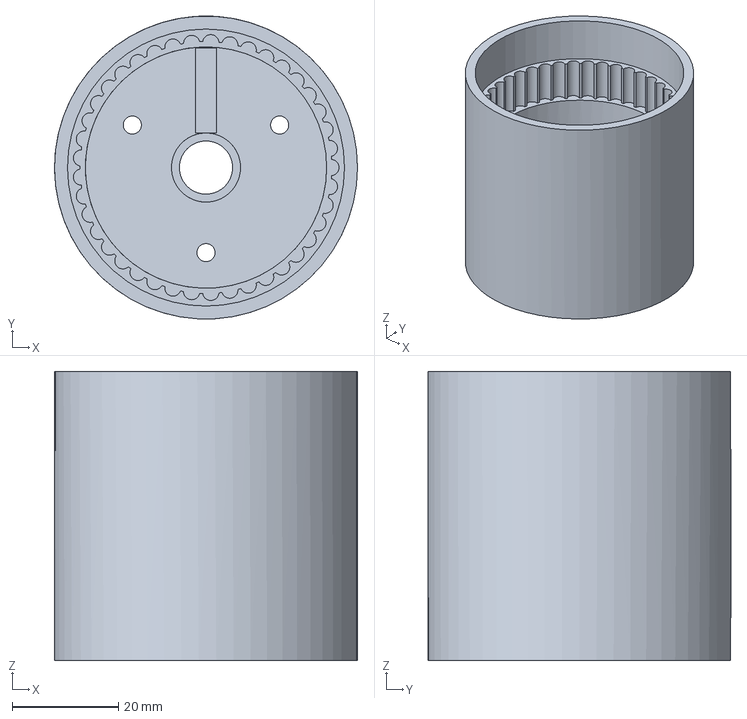
[picture p117: CAD file, 2026-11-01]
cad3/fea/input/housing.step
57.0 x 57.0 x 54.4 mm
