Riyu-D1/Vector/cad3/out/vendor_spring_j3.step

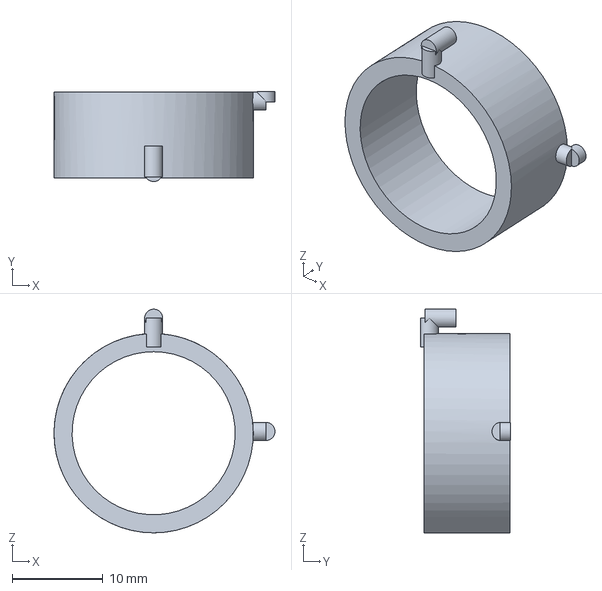
[picture p118: CAD file, 2026-11-01]
cad3/out/vendor_spring_j3.step
24.4 x 9.95 x 24.7 mm
