Riyu-D1/Vector/cyclo4/dxf/disc1.dxf

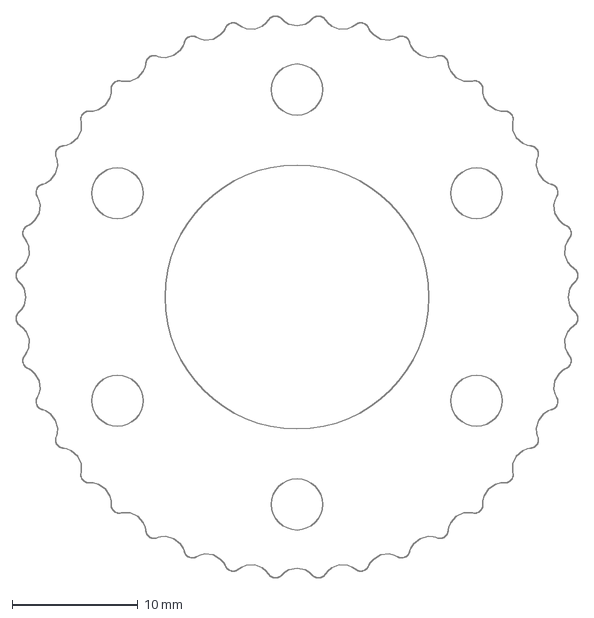
[picture p119: CAD file, 2026-11-02]
cyclo4/dxf/disc1.dxf
44.7 x 44.7 mm
