Riyu-D1/Vector/cyclo4/out/pin_ring.step

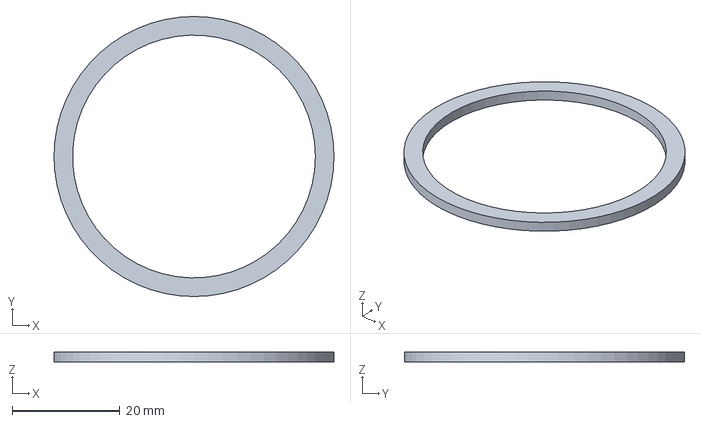
[picture p120: CAD file, 2026-11-02]
cyclo4/out/pin_ring.step
51.9 x 51.9 x 1.90 mm
