Riyu-D1/Vector/refine/out/_probe/cm_fore_l.stl

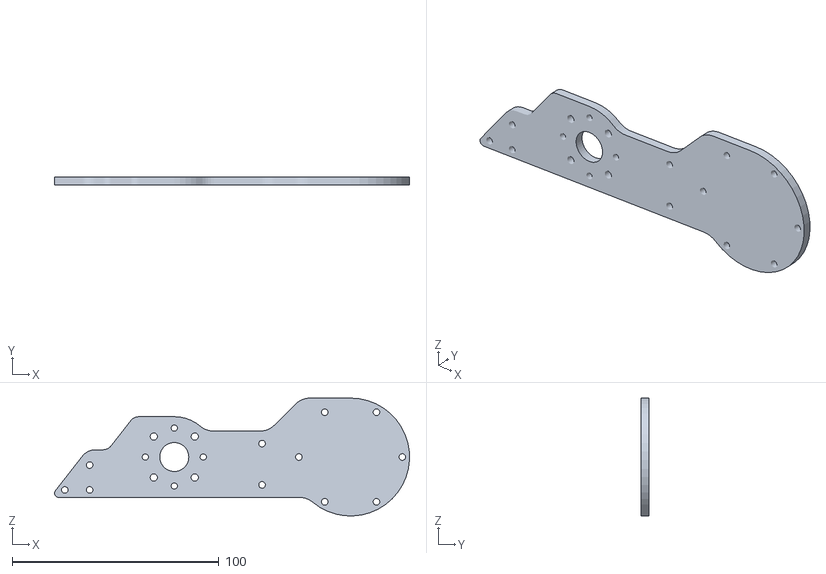
[picture p121: CAD file, 2026-11-10]
refine/out/_probe/cm_fore_l.stl
171.6 x 4.00 x 57.0
