Riyu-D1/Vector/refine/out/_r7/l5.step

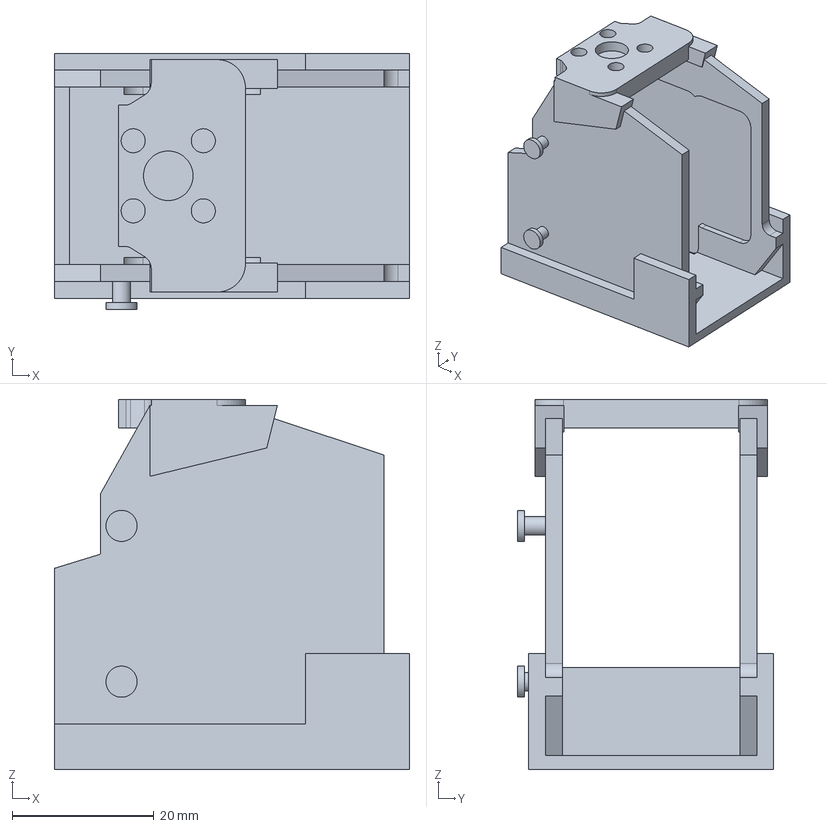
[picture p122: CAD file, 2026-11-10]
refine/out/_r7/l5.step
50.2 x 36.2 x 52.2 mm
