Riyu-D1/Vector/cad/arm/export/upper_link.step

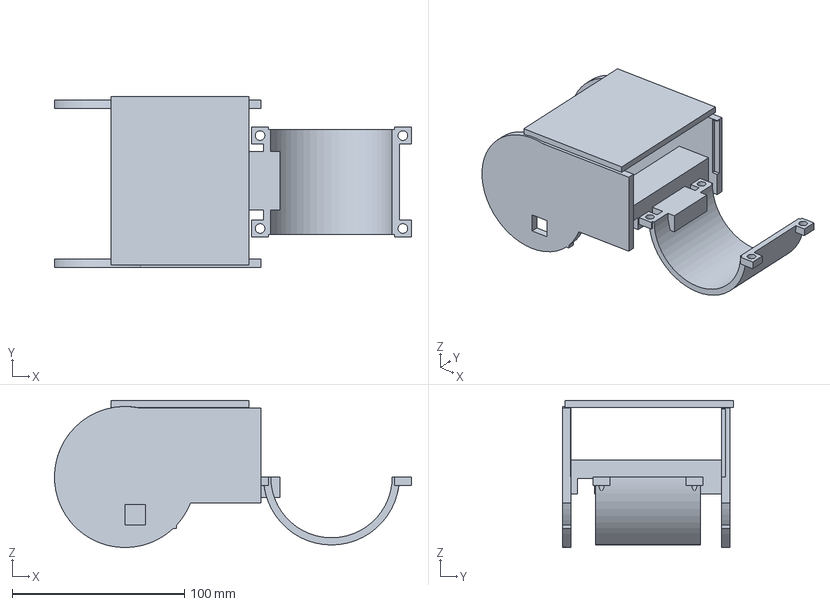
[picture p124: CAD file, 2026-11-01]
cad/arm/export/upper_link.step
207.5 x 99.6 x 85.5 mm
