Riyu-D1/Vector/cad/arm/reference/so102_wrist_holder.step

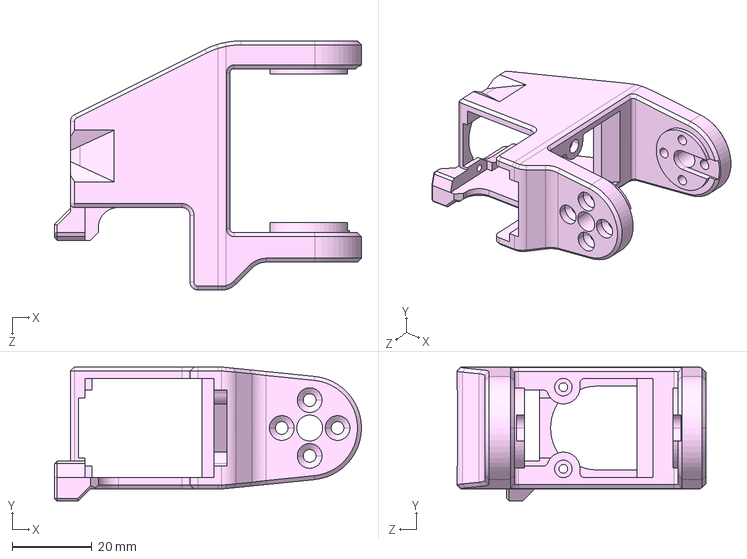
[picture p125: CAD file, 2026-11-01]
cad/arm/reference/so102_wrist_holder.step
77.0 x 33.6 x 62.5 mm
