Riyu-D1/Vector/cad/export/gripper_spool.step

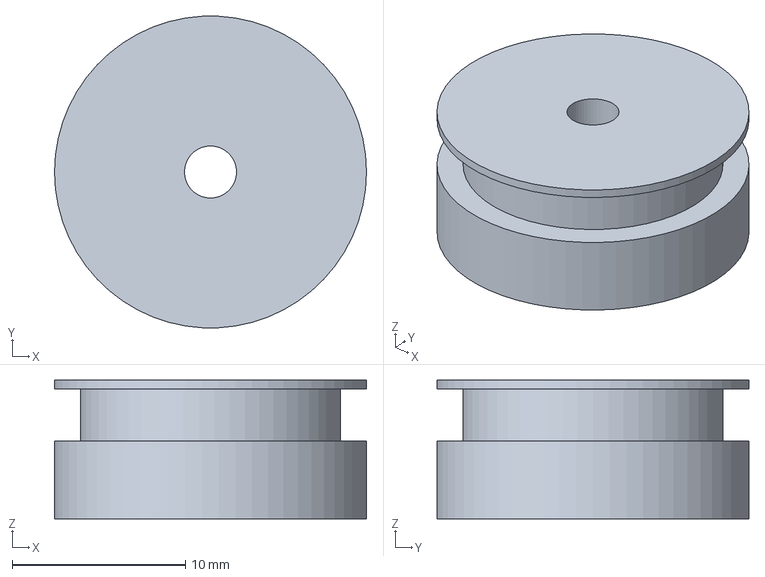
[picture p126: CAD file, 2026-10-26]
cad/export/gripper_spool.step
18.0 x 18.0 x 8.00 mm
