Riyu-D1/Vector/cad3/fea/input/j4_cradle.step

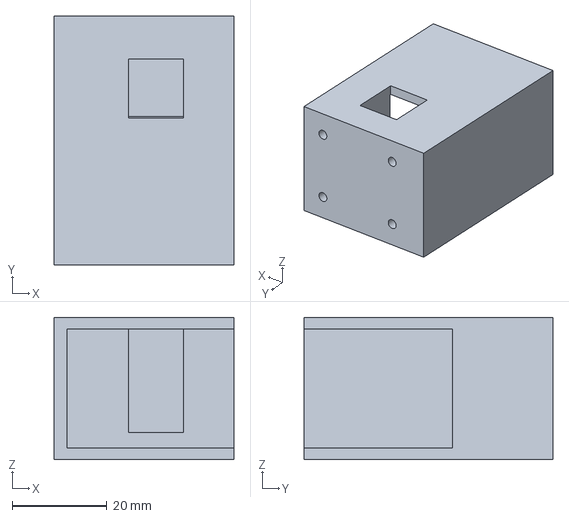
[picture p127: CAD file, 2026-11-01]
cad3/fea/input/j4_cradle.step
38.0 x 52.5 x 30.0 mm
