Riyu-D1/Vector/cad3/out/flange_j2.step

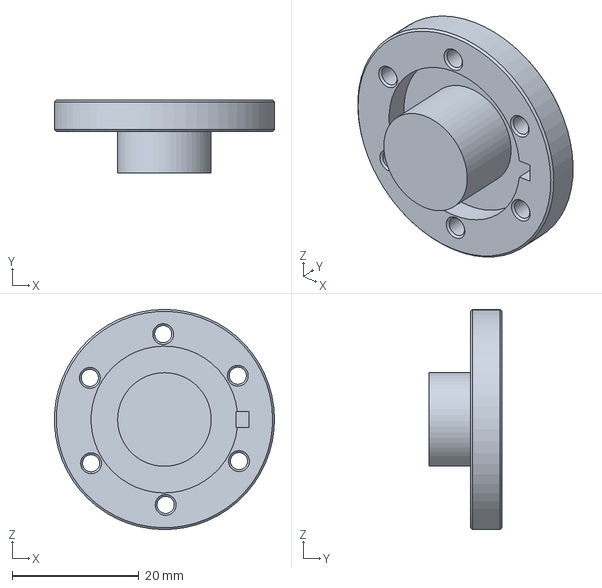
[picture p128: CAD file, 2026-11-01]
cad3/out/flange_j2.step
34.8 x 11.6 x 34.8 mm
