Riyu-D1/Vector/cyclo4/dxf/disc2.dxf

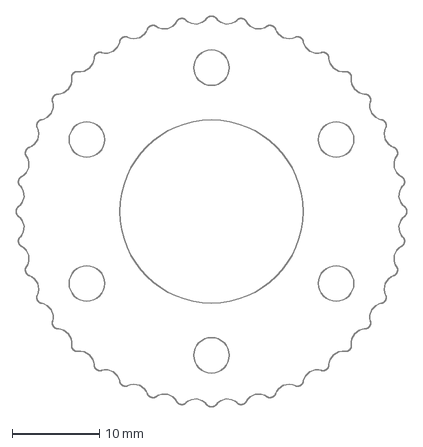
[picture p129: CAD file, 2026-11-02]
cyclo4/dxf/disc2.dxf
44.8 x 44.8 mm
