Riyu-D1/Vector/cyclo4/out/vendor_685.step

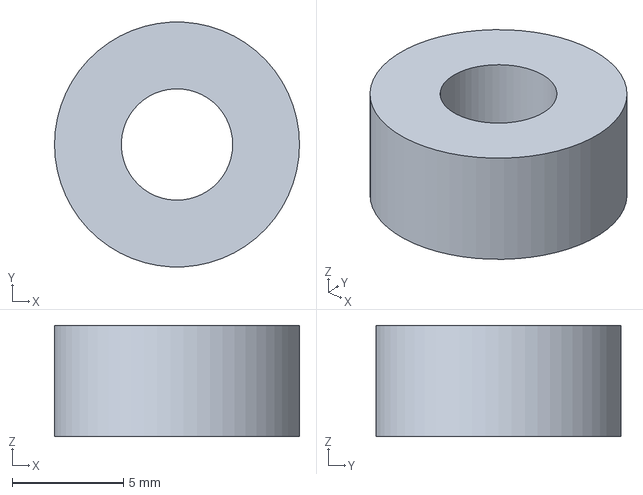
[picture p130: CAD file, 2026-11-02]
cyclo4/out/vendor_685.step
11.0 x 11.0 x 5.00 mm
