Riyu-D1/Vector/final/out/coupon.stl

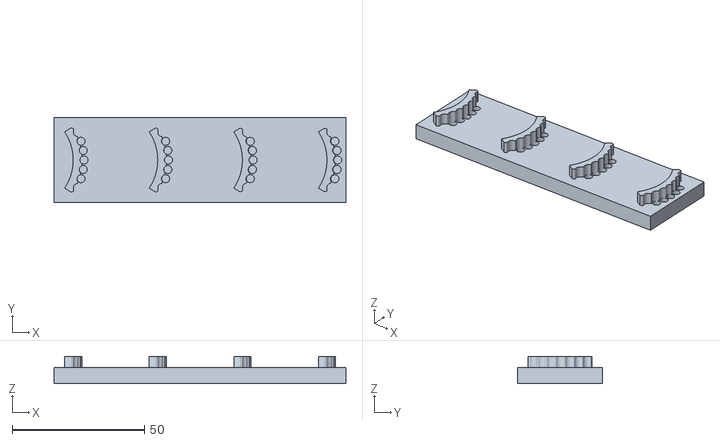
[picture p131: CAD file, 2026-11-03]
final/out/coupon.stl
110.5 x 32.3 x 10.2
