Riyu-D1/Vector/refine/out/_probe/st2_l4.stl

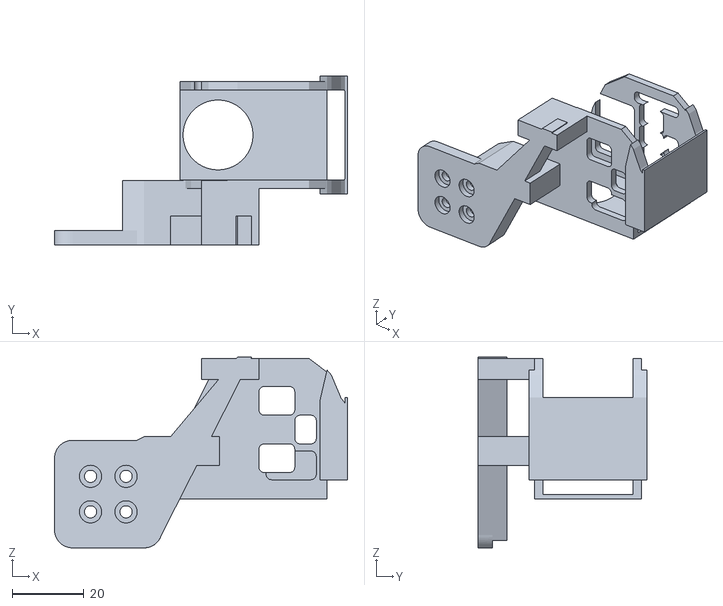
[picture p132: CAD file, 2026-11-10]
refine/out/_probe/st2_l4.stl
81.7 x 47.1 x 53.2
