Riyu-D1/Vector/refine/out/_r7/cradle.step

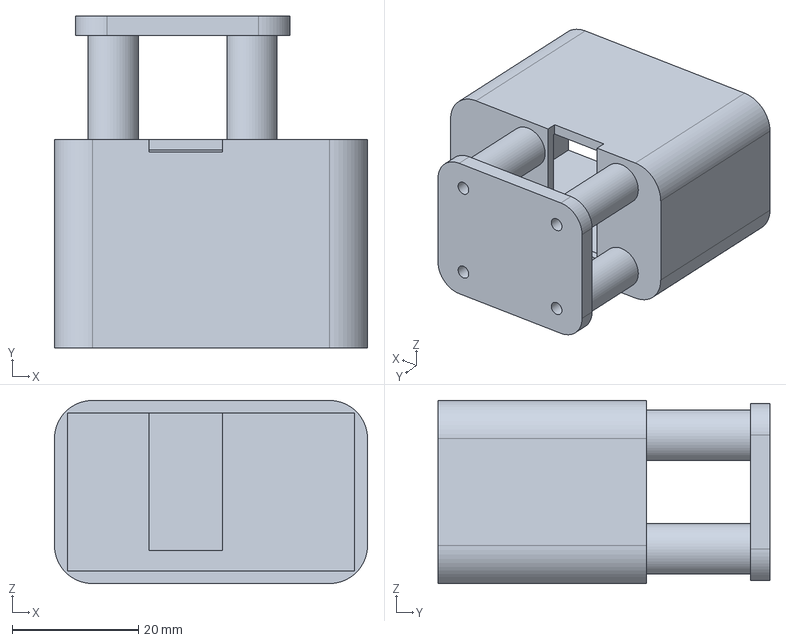
[picture p133: CAD file, 2026-11-10]
refine/out/_r7/cradle.step
49.6 x 52.5 x 29.0 mm
