Riyu-D1/Vector/refine/out/stock_w_link5.step

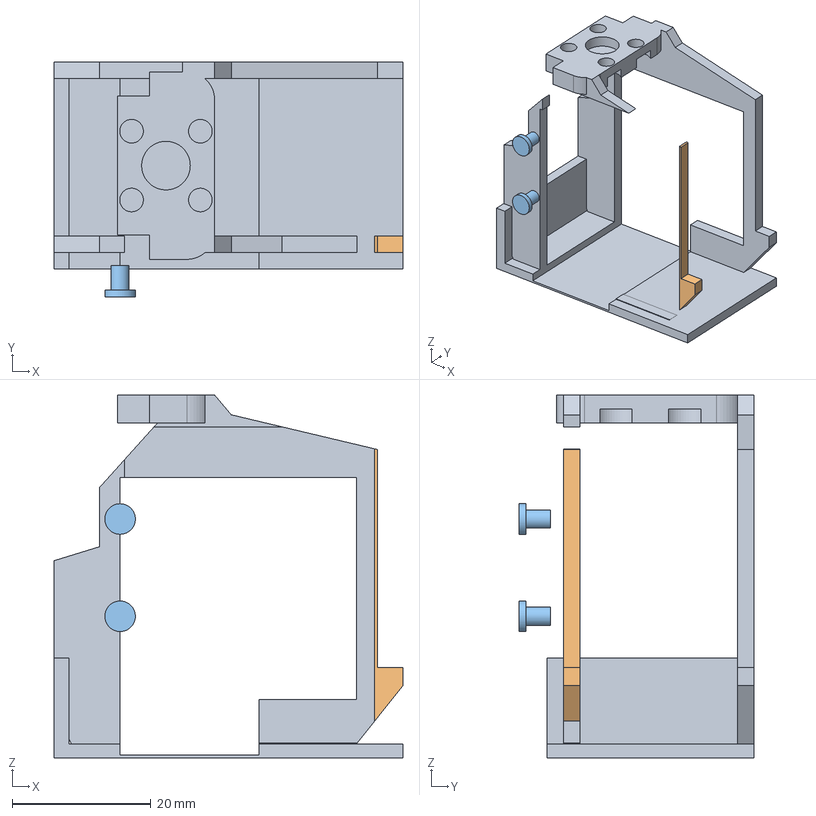
[picture p134: CAD file, 2026-11-10]
refine/out/stock_w_link5.step
50.2 x 33.8 x 52.2 mm
