Riyu-D1/Vector/cad/actuator/export/motor_shell.stl

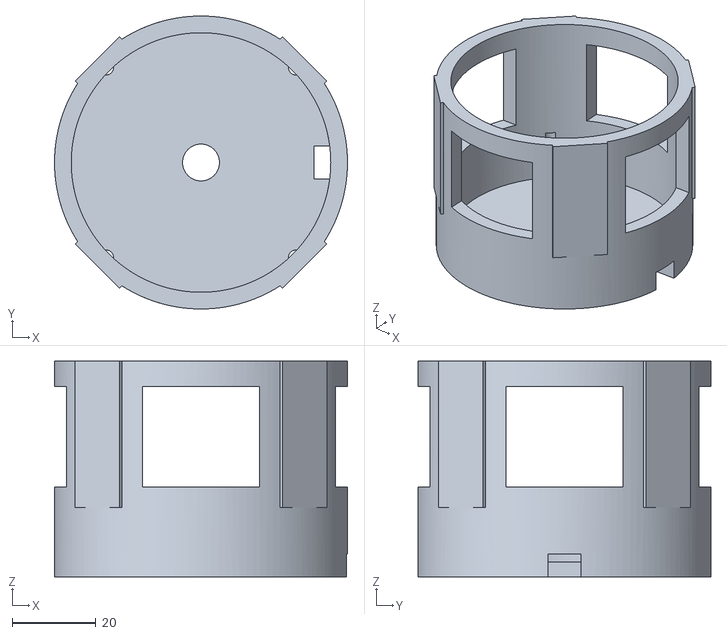
[picture p135: CAD file, 2026-11-01]
cad/actuator/export/motor_shell.stl
70.0 x 70.0 x 51.5
