Riyu-D1/Vector/cad/arm/export/nose.step

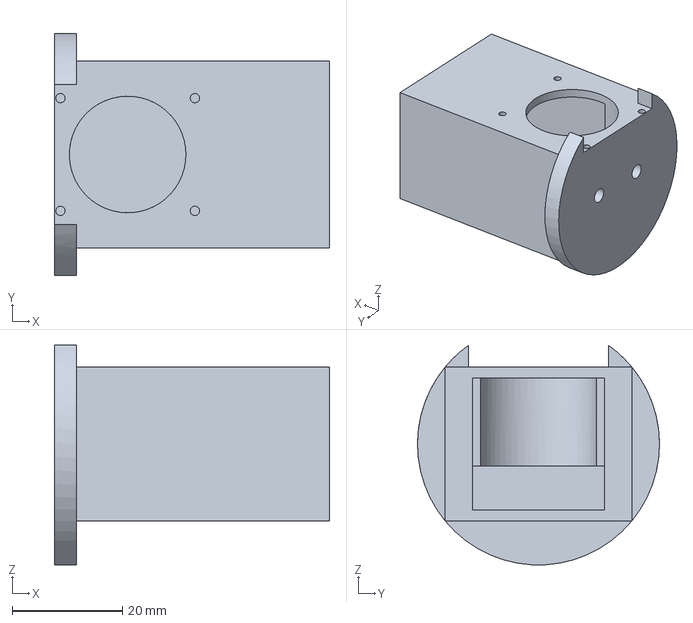
[picture p136: CAD file, 2026-11-01]
cad/arm/export/nose.step
50.0 x 44.0 x 39.9 mm
