Riyu-D1/Vector/cad/arm2/rebot_src/01_BASE_Plate.step

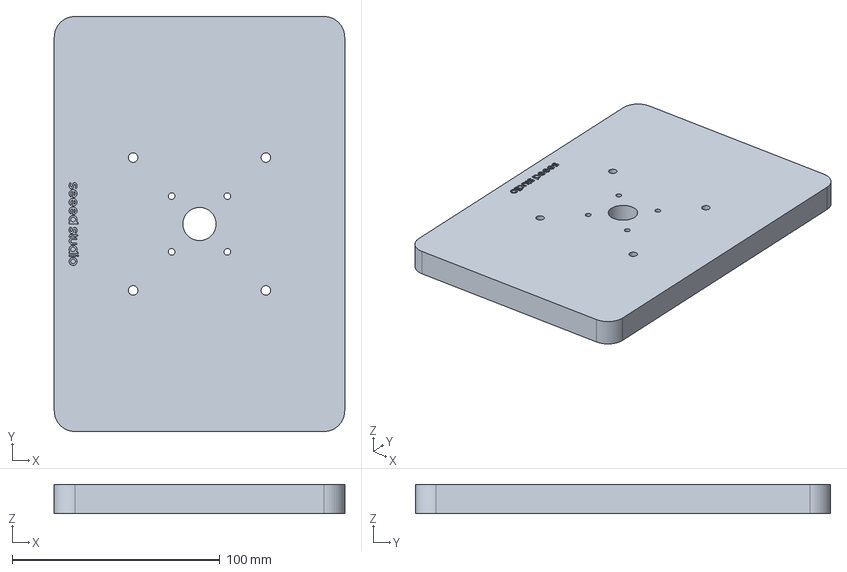
[picture p137: CAD file, 2026-11-01]
cad/arm2/rebot_src/01_BASE_Plate.step
140.0 x 200.0 x 14.0 mm
