Riyu-D1/Vector/cad/export/wrist_j4_yoke.step

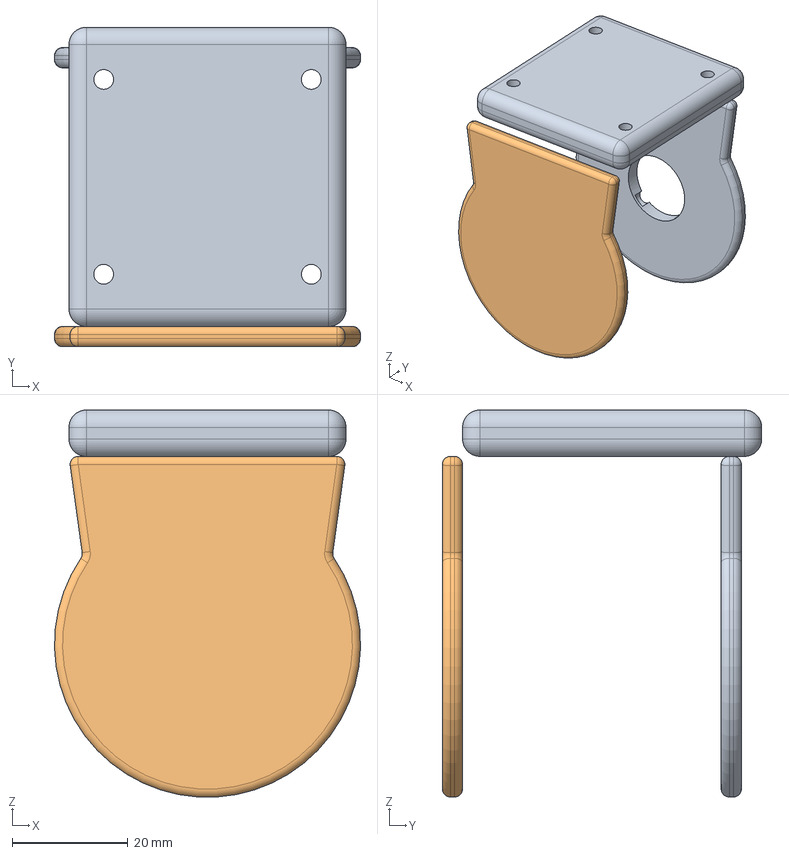
[picture p138: CAD file, 2026-10-26]
cad/export/wrist_j4_yoke.step
52.8 x 55.1 x 66.7 mm
