Riyu-D1/Vector/cad3/out/vendor_sts3250_j4.step

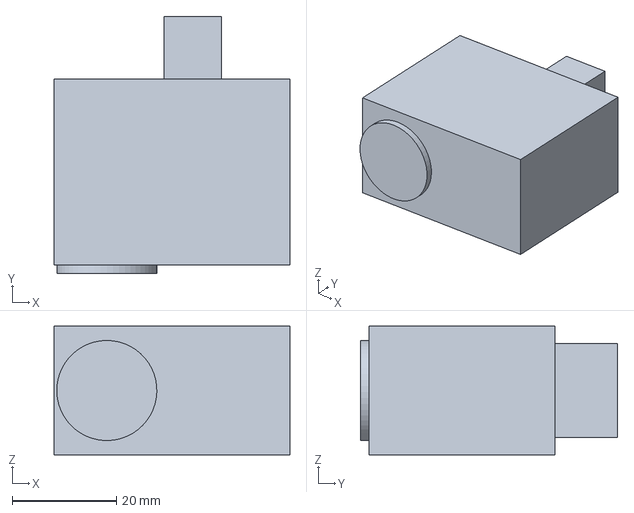
[picture p139: CAD file, 2026-11-01]
cad3/out/vendor_sts3250_j4.step
45.2 x 49.3 x 24.7 mm
