Riyu-D1/Vector/cyclo4/dxf/output_pin_plate.dxf

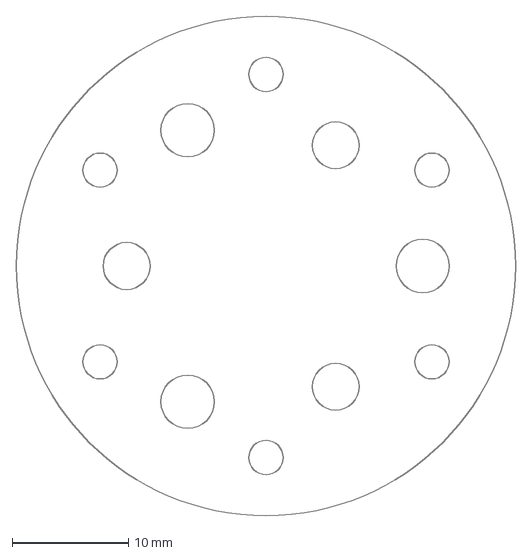
[picture p140: CAD file, 2026-11-02]
cyclo4/dxf/output_pin_plate.dxf
43.0 x 43.0 mm
