Riyu-D1/Vector/cyclo4/out/disc2.step

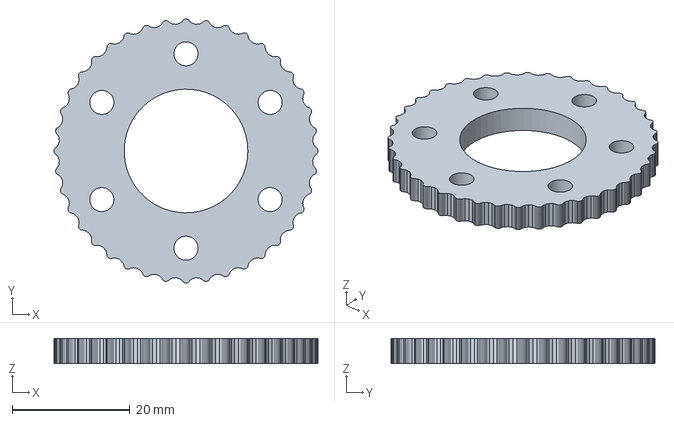
[picture p141: CAD file, 2026-11-02]
cyclo4/out/disc2.step
44.8 x 44.8 x 4.25 mm
