Riyu-D1/Vector/refine/out/_r7/gf.step

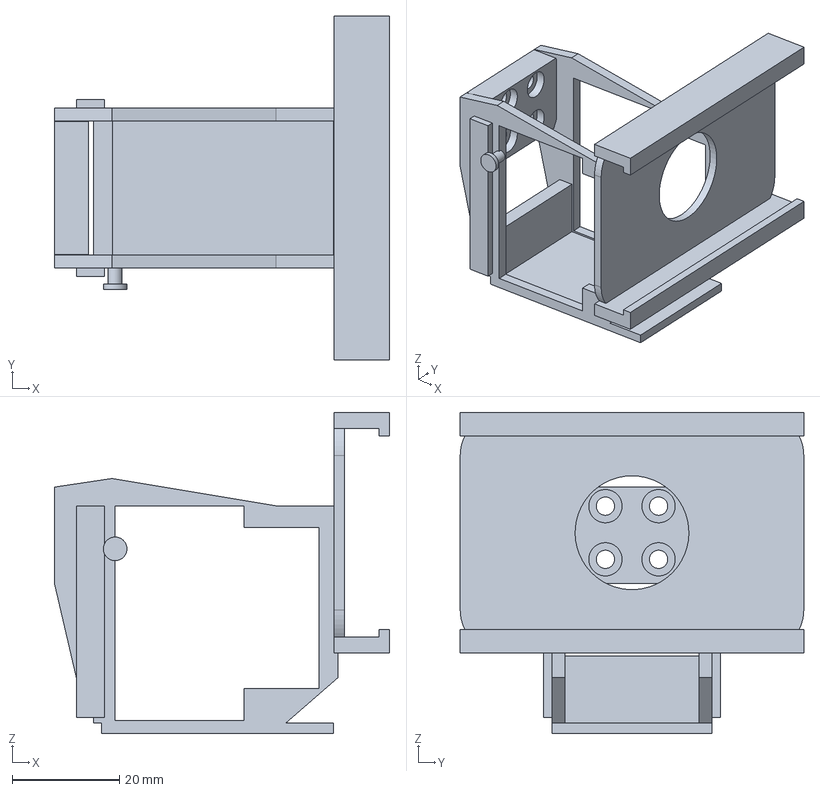
[picture p142: CAD file, 2026-11-10]
refine/out/_r7/gf.step
62.4 x 64.0 x 59.8 mm
