Riyu-D1/Vector/refine/out/wrist_pin.step

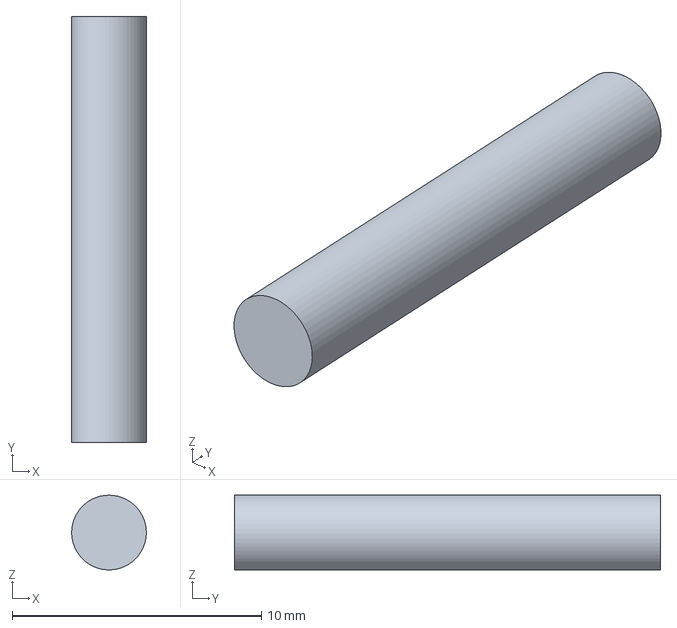
[picture p143: CAD file, 2026-11-10]
refine/out/wrist_pin.step
3.00 x 17.1 x 3.00 mm
