Riyu-D1/Vector/wrist2/out/finger_d.step

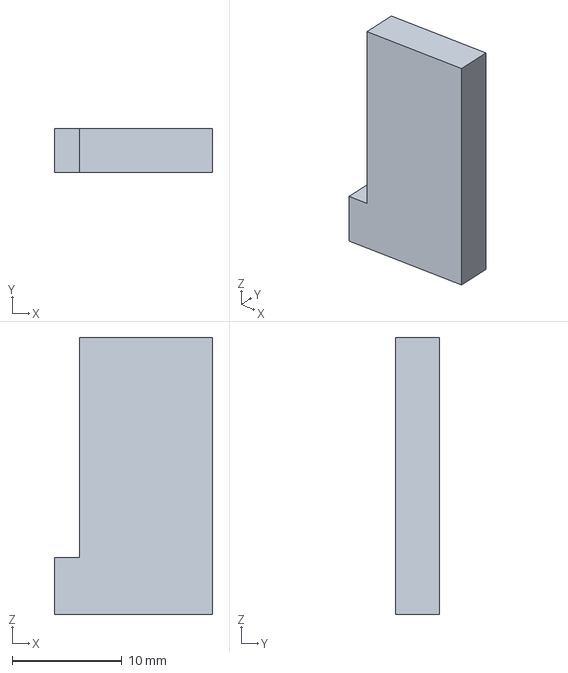
[picture p144: CAD file, 2026-11-03]
wrist2/out/finger_d.step
14.4 x 4.00 x 25.2 mm
