Riyu-D1/Vector/cad/actuator/export/end_cap.stl

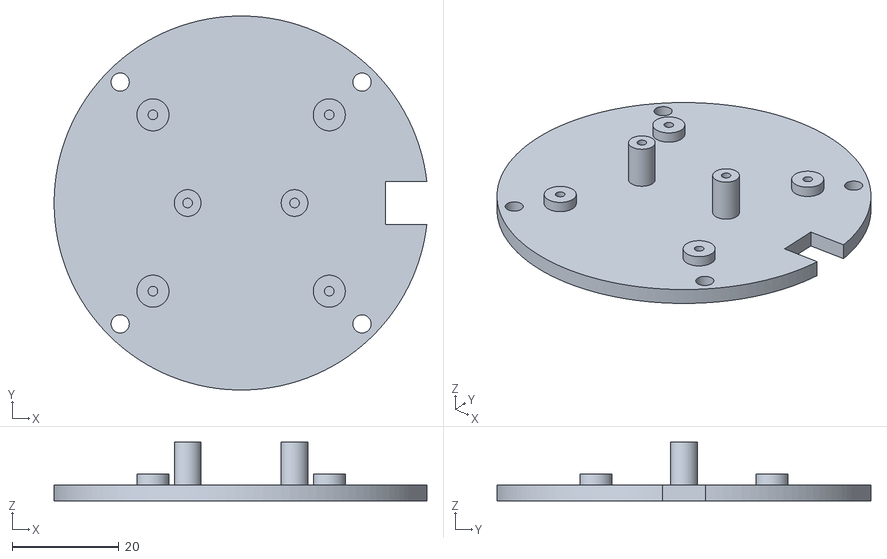
[picture p145: CAD file, 2026-11-01]
cad/actuator/export/end_cap.stl
69.8 x 70.0 x 11.0
