Riyu-D1/Vector/cad/arm/export/jaw_l.step

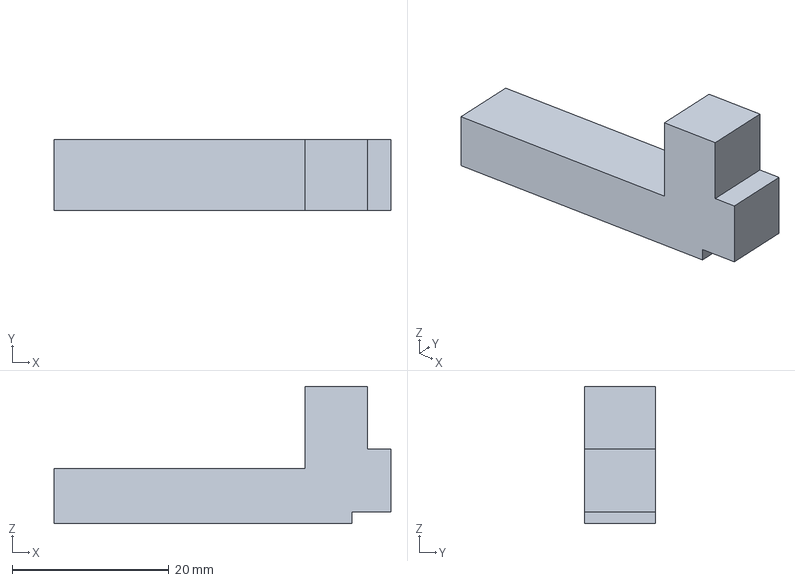
[picture p146: CAD file, 2026-11-01]
cad/arm/export/jaw_l.step
43.0 x 9.00 x 17.5 mm
