Riyu-D1/Vector/cad/arm2/rebot_src/03_Link3_R.step

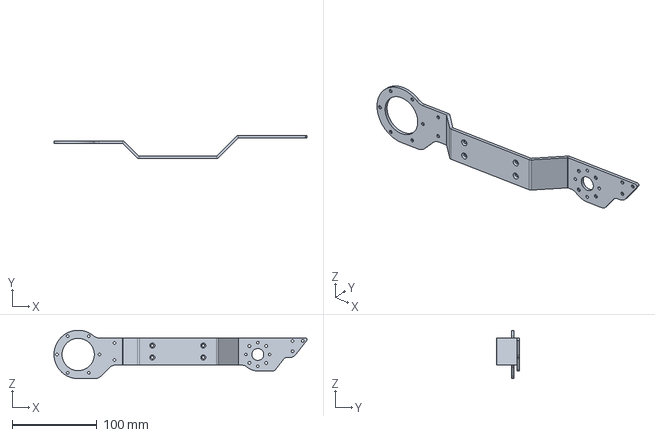
[picture p147: CAD file, 2026-11-01]
cad/arm2/rebot_src/03_Link3_R.step
297.8 x 27.6 x 57.0 mm
