Riyu-D1/Vector/cad/export/j2_sea_cap.step

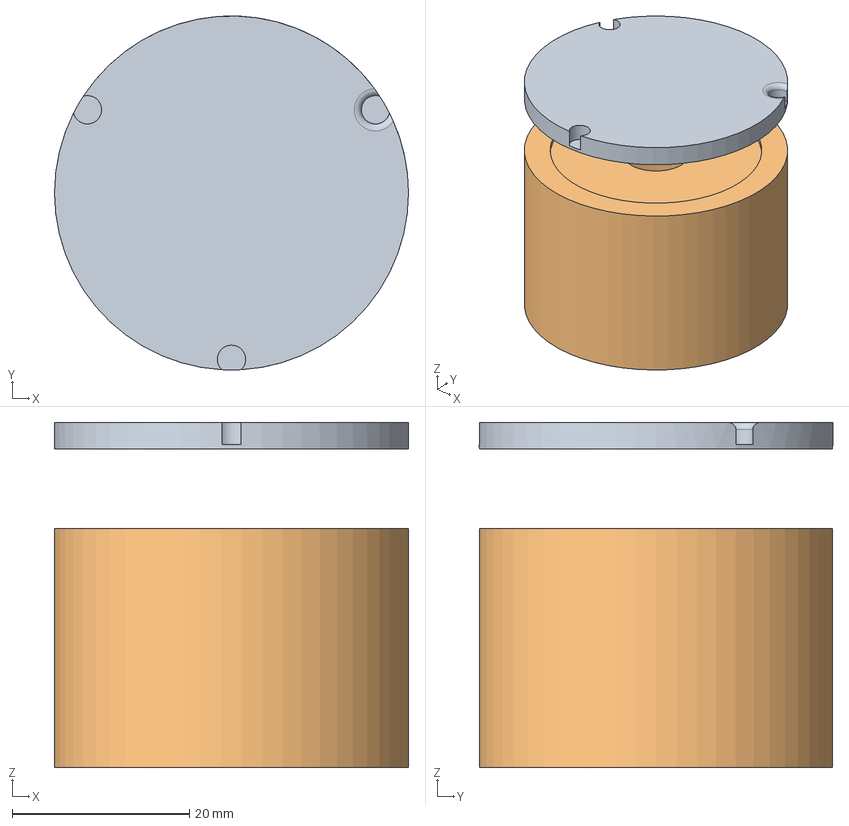
[picture p148: CAD file, 2026-10-26]
cad/export/j2_sea_cap.step
40.0 x 40.0 x 39.0 mm
