Riyu-D1/Vector/cyclo4/out/hub.step

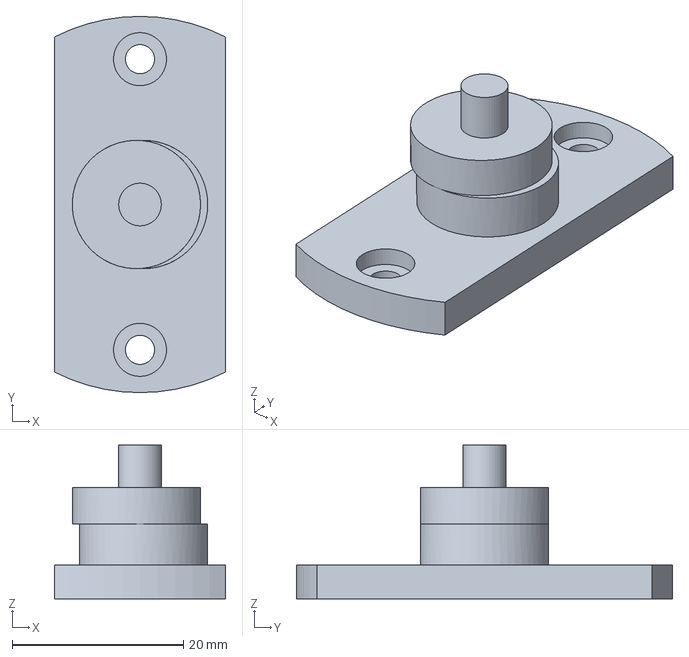
[picture p149: CAD file, 2026-11-02]
cyclo4/out/hub.step
20.0 x 44.0 x 18.0 mm
