Riyu-D1/Vector/cad/actuator/export/housing.stl

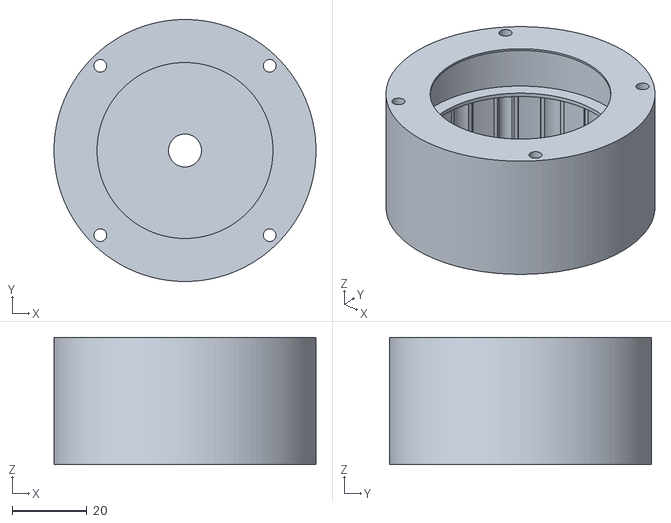
[picture p150: CAD file, 2026-11-01]
cad/actuator/export/housing.stl
70.0 x 70.0 x 34.0
