Riyu-D1/Vector/cad/arm/export/base_housing.step

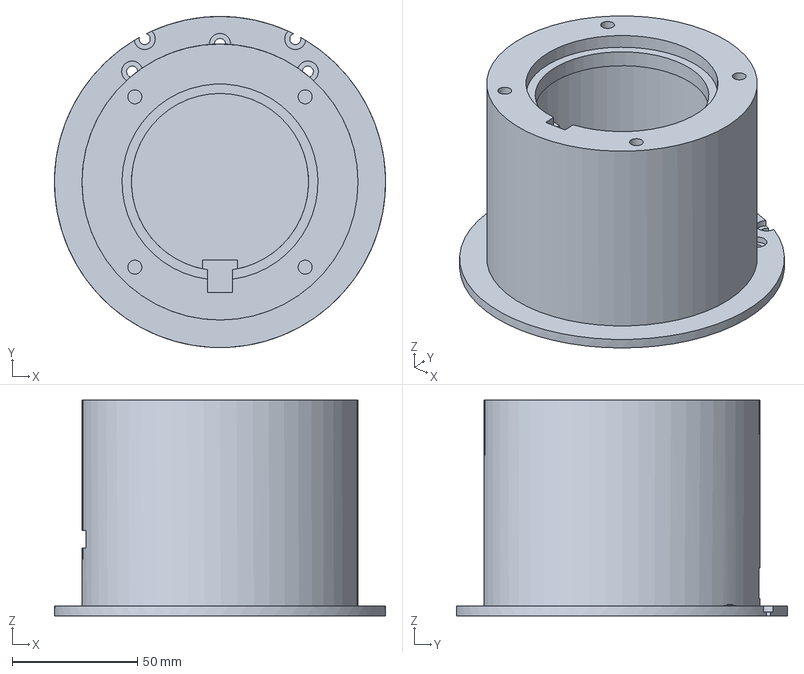
[picture p151: CAD file, 2026-11-01]
cad/arm/export/base_housing.step
131.9 x 132.0 x 86.0 mm
