Riyu-D1/Vector/cad/arm2/rebot_src/03_Link3_L.step

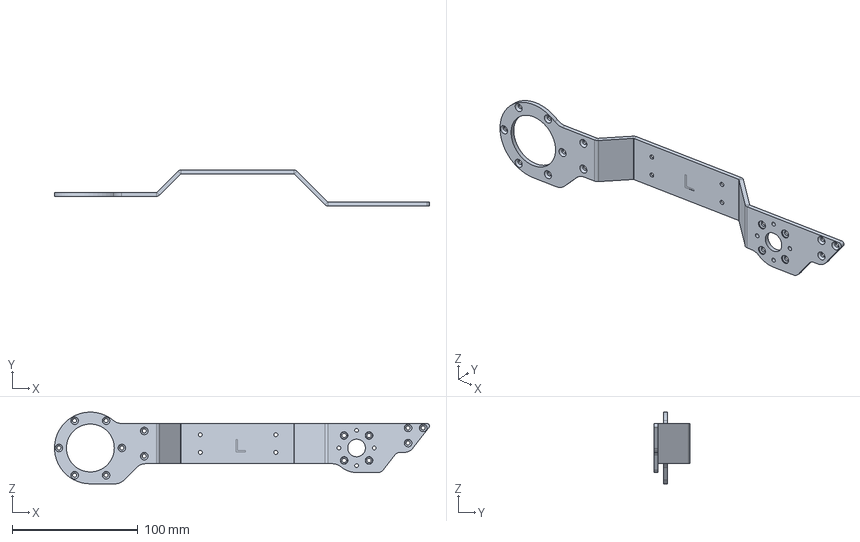
[picture p152: CAD file, 2026-11-01]
cad/arm2/rebot_src/03_Link3_L.step
297.8 x 28.6 x 57.0 mm
