Riyu-D1/Vector/cad/export/gripper_finger_r.step

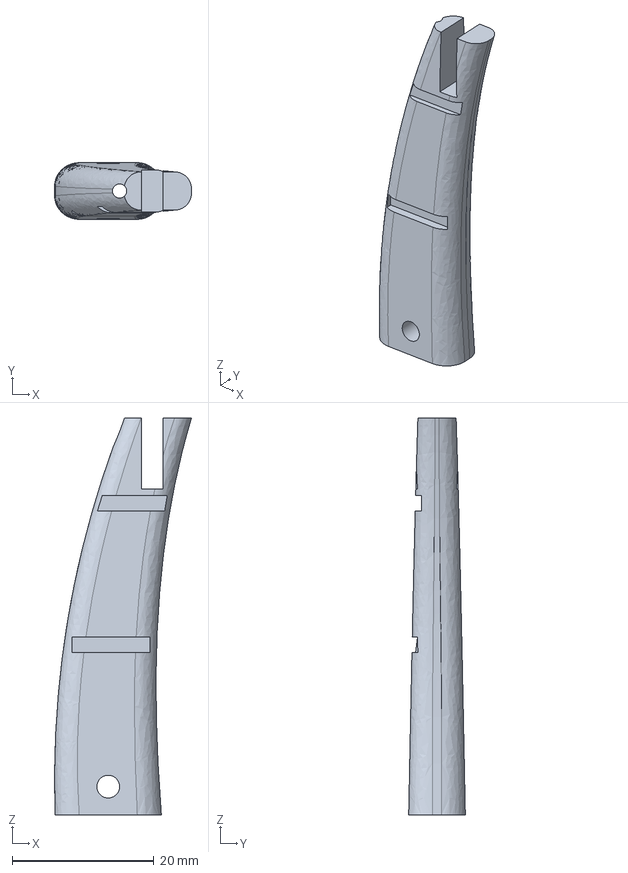
[picture p153: CAD file, 2026-10-26]
cad/export/gripper_finger_r.step
19.3 x 8.00 x 56.0 mm
