Riyu-D1/Vector/cad3/out/flange_j3.step

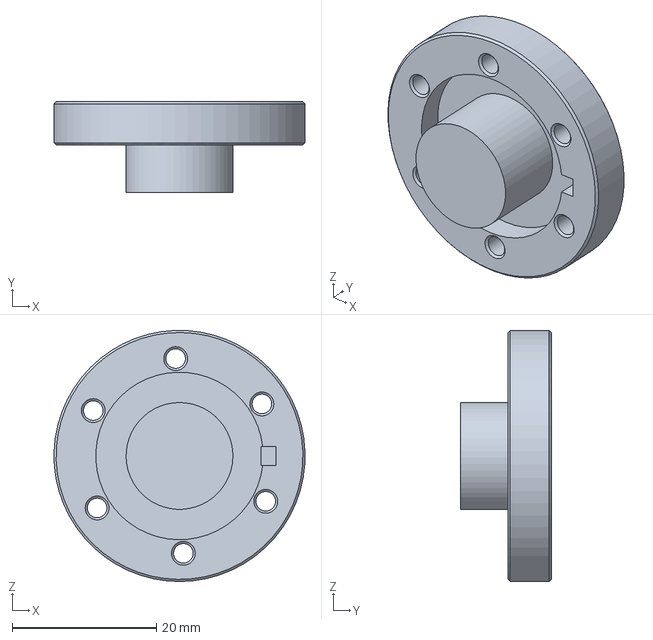
[picture p154: CAD file, 2026-11-01]
cad3/out/flange_j3.step
34.8 x 12.6 x 34.8 mm
