Riyu-D1/Vector/cyclo4/out/vendor_magnet.step

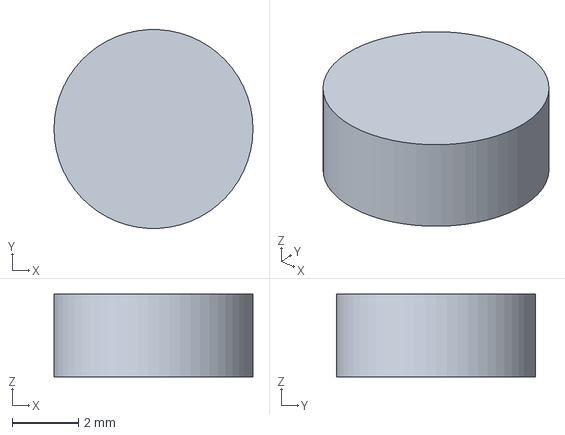
[picture p155: CAD file, 2026-11-02]
cyclo4/out/vendor_magnet.step
6.00 x 5.99 x 2.50 mm
