Riyu-D1/Vector/refine/out/_r8/w_link4.step

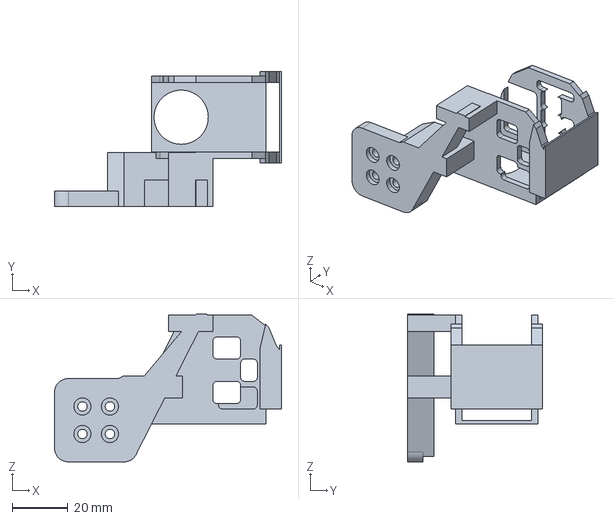
[picture p156: CAD file, 2026-11-10]
refine/out/_r8/w_link4.step
81.7 x 48.5 x 53.2 mm
