Riyu-D1/Vector/cad/actuator/export/input_shaft.stl

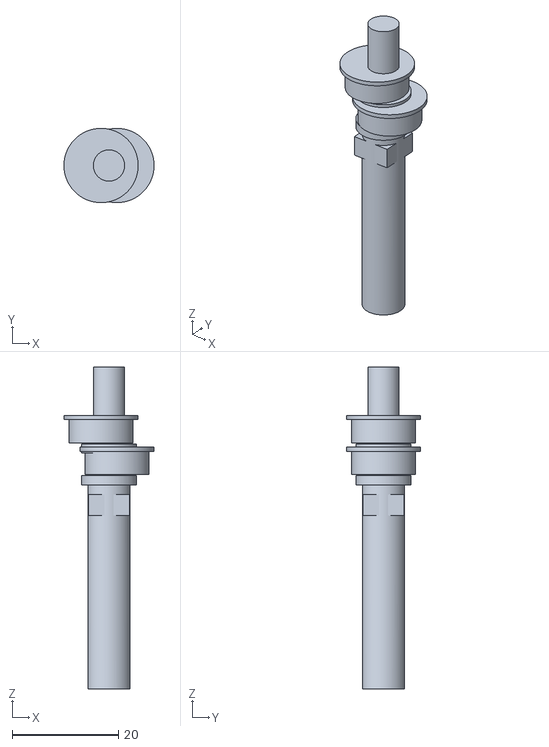
[picture p157: CAD file, 2026-11-01]
cad/actuator/export/input_shaft.stl
17.0 x 14.0 x 60.7
