Riyu-D1/Vector/cad/arm/export/turret_cap.step

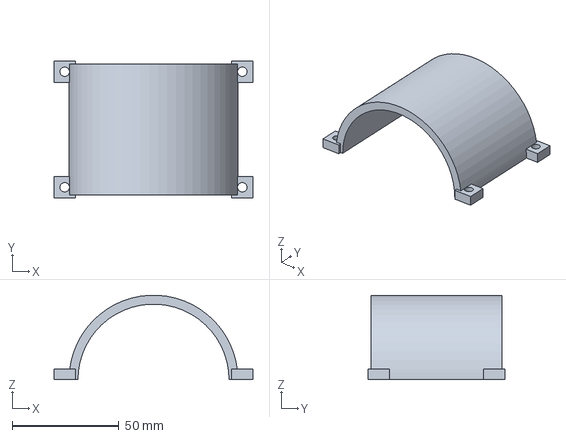
[picture p158: CAD file, 2026-11-01]
cad/arm/export/turret_cap.step
93.0 x 64.0 x 39.4 mm
