Riyu-D1/Vector/cad/arm2/rebot_src/02_Arm_Yaw_Limit.step

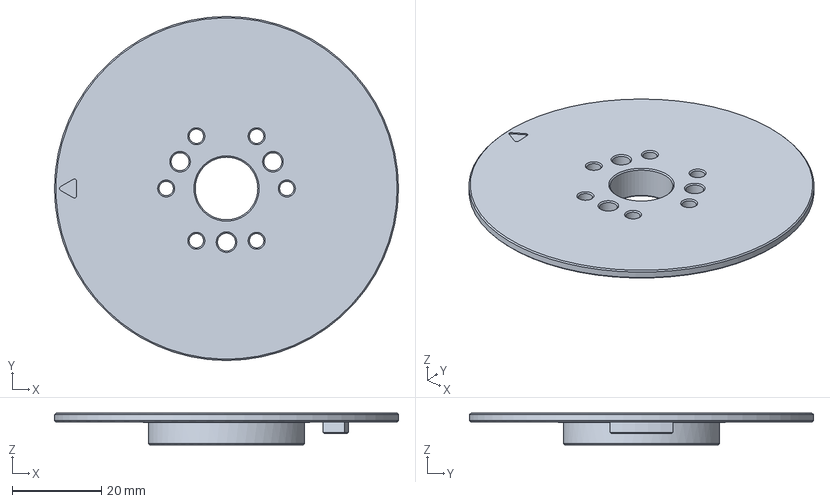
[picture p159: CAD file, 2026-11-01]
cad/arm2/rebot_src/02_Arm_Yaw_Limit.step
77.0 x 77.0 x 7.10 mm
