Riyu-D1/Vector/cad/export/case_tray.step

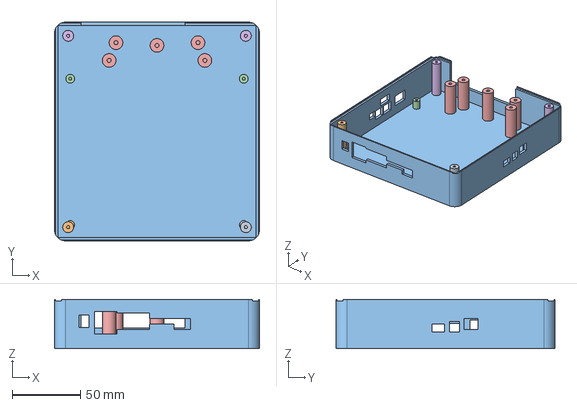
[picture p160: CAD file, 2026-10-26]
cad/export/case_tray.step
150.0 x 160.0 x 36.0 mm
