Riyu-D1/Vector/cad3/out/back_spacer_j2.step

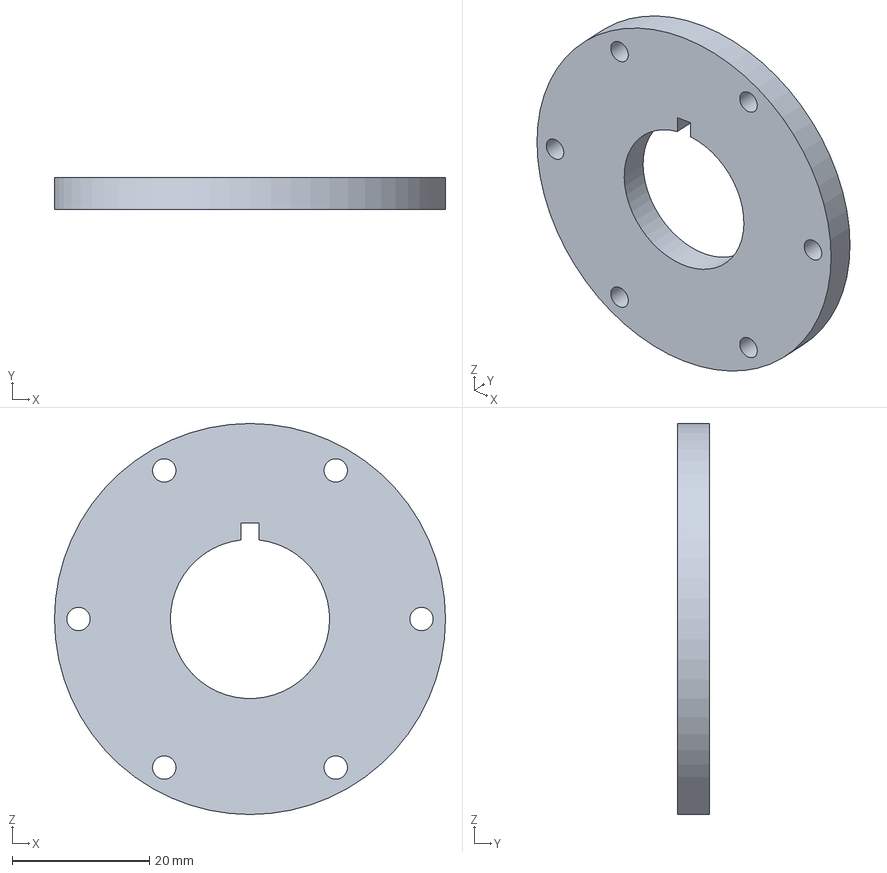
[picture p161: CAD file, 2026-11-01]
cad3/out/back_spacer_j2.step
57.0 x 4.70 x 57.0 mm
