Riyu-D1/Vector/cyclo4/out/out_flange.step

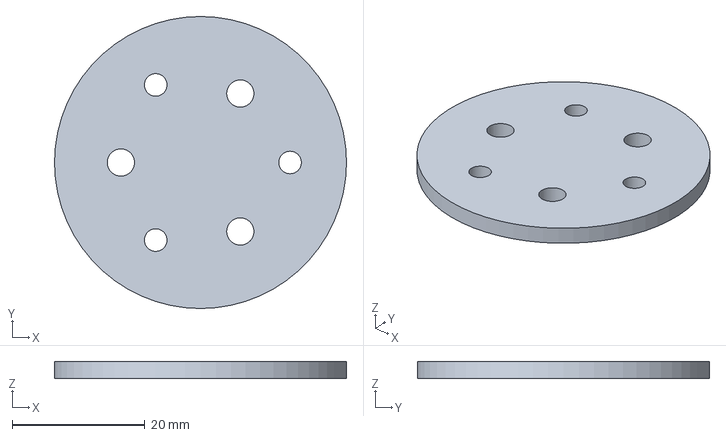
[picture p162: CAD file, 2026-11-02]
cyclo4/out/out_flange.step
44.0 x 44.0 x 2.60 mm
