Riyu-D1/Vector/refine/out/fix_w_grip_frame.step

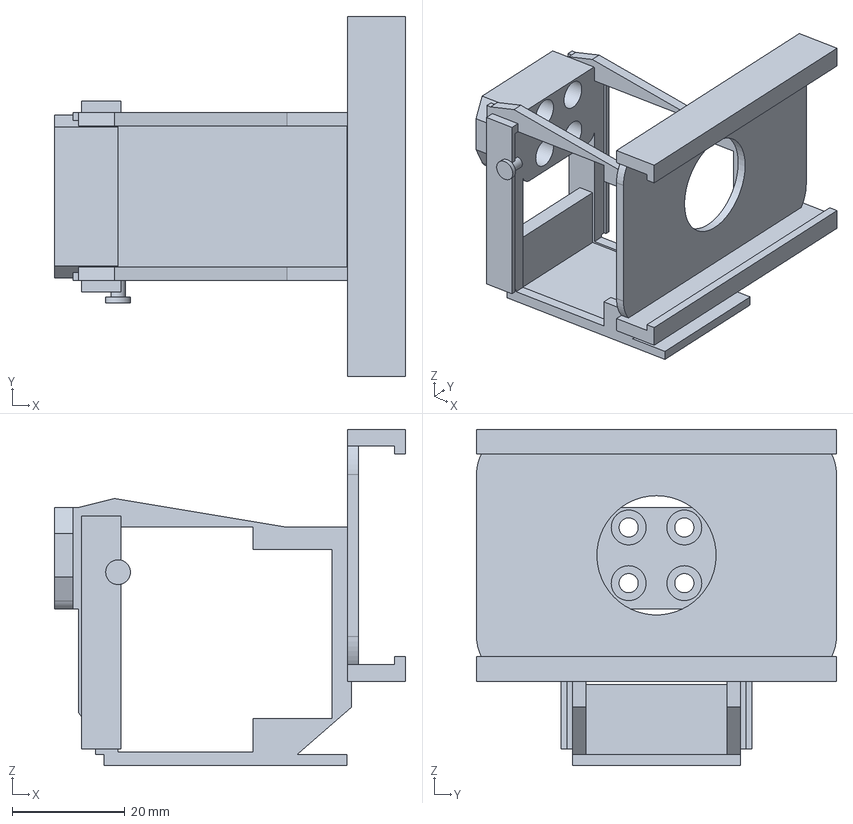
[picture p163: CAD file, 2026-11-10]
refine/out/fix_w_grip_frame.step
62.4 x 64.0 x 59.8 mm
