Riyu-D1/Vector/cad/actuator/export/output_shaft.stl

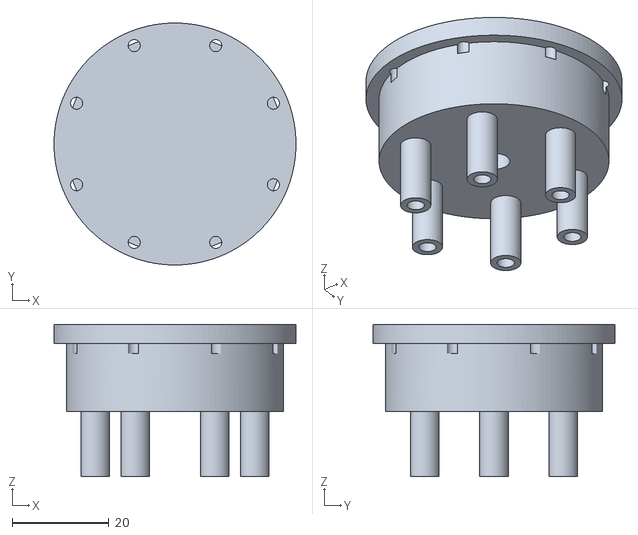
[picture p164: CAD file, 2026-11-01]
cad/actuator/export/output_shaft.stl
50.0 x 50.0 x 31.5
