Riyu-D1/Vector/cad/arm2/rebot_src/02_Motor_Front_Spacer_J2.step

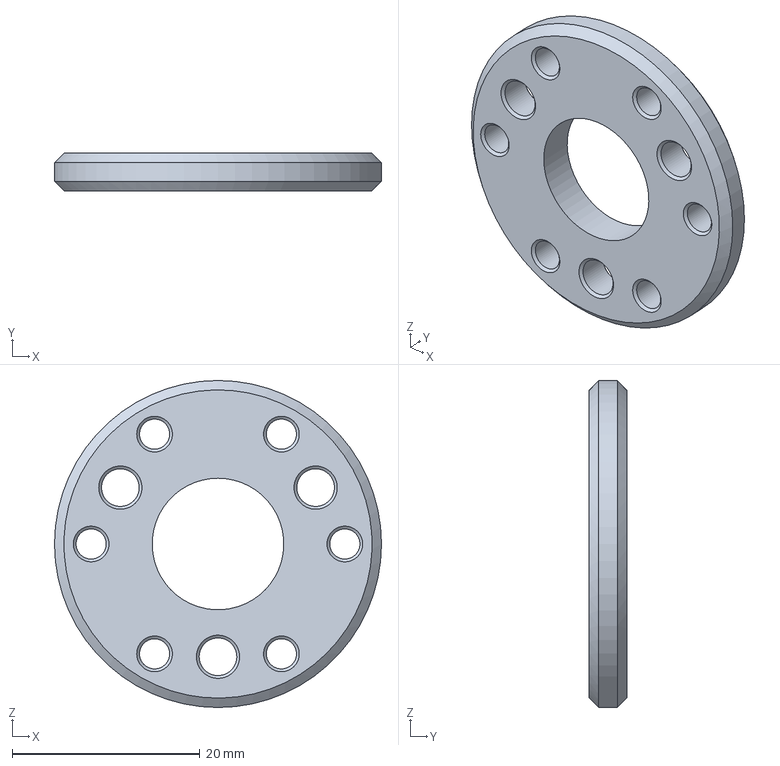
[picture p165: CAD file, 2026-11-01]
cad/arm2/rebot_src/02_Motor_Front_Spacer_J2.step
34.8 x 4.00 x 34.8 mm
