Riyu-D1/Vector/cad/export/case_lid.step

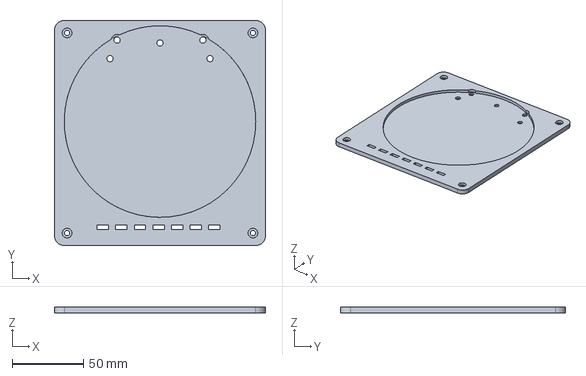
[picture p166: CAD file, 2026-10-26]
cad/export/case_lid.step
147.6 x 157.6 x 4.00 mm
