Riyu-D1/Vector/cyclo4/out/vendor_outpins.step

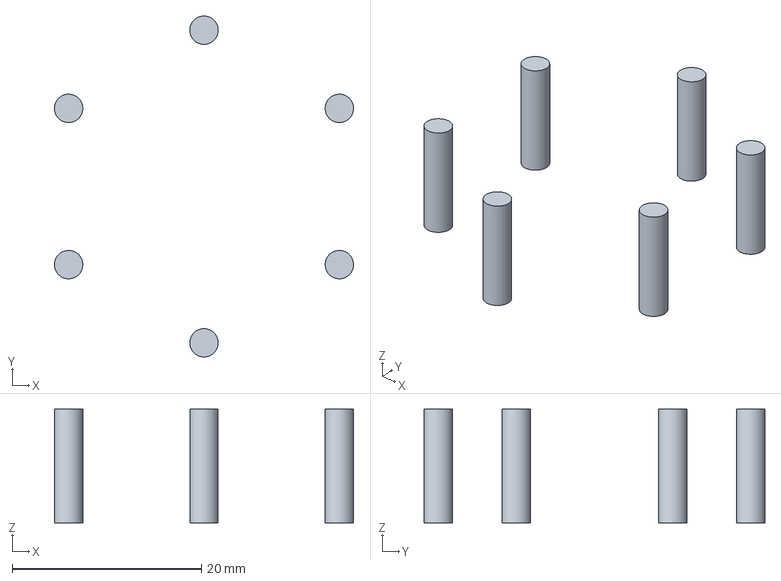
[picture p167: CAD file, 2026-11-02]
cyclo4/out/vendor_outpins.step
31.6 x 36.0 x 12.0 mm
