Riyu-D1/Vector/cad/actuator/export/cycloidal_disc_x2.stl

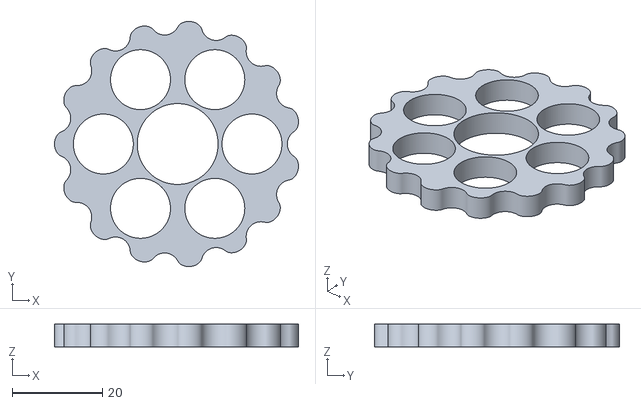
[picture p168: CAD file, 2026-11-01]
cad/actuator/export/cycloidal_disc_x2.stl
54.2 x 54.4 x 5.00
