Riyu-D1/Vector/cad/arm/export/wrist.step

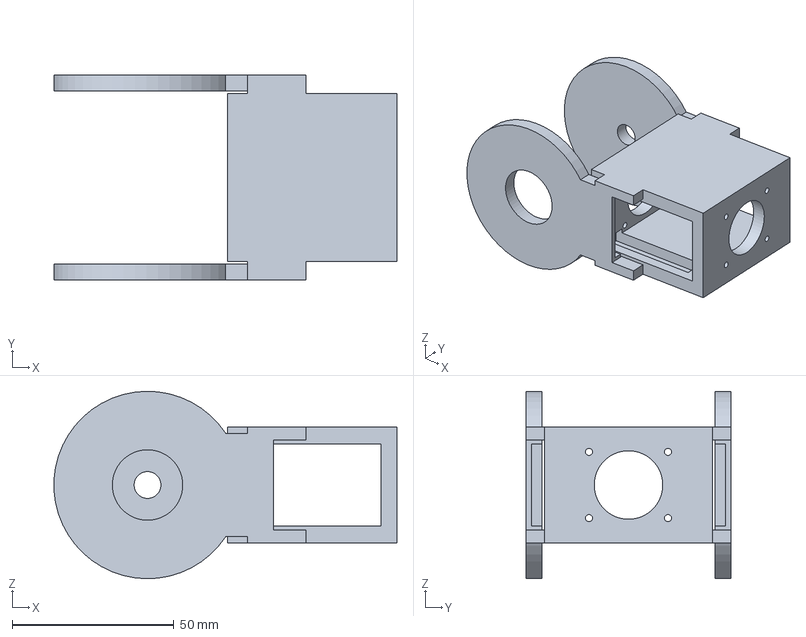
[picture p169: CAD file, 2026-11-01]
cad/arm/export/wrist.step
106.1 x 63.4 x 58.0 mm
