Riyu-D1/Vector/cad/arm2/rebot_src/01_BASE_Link.step

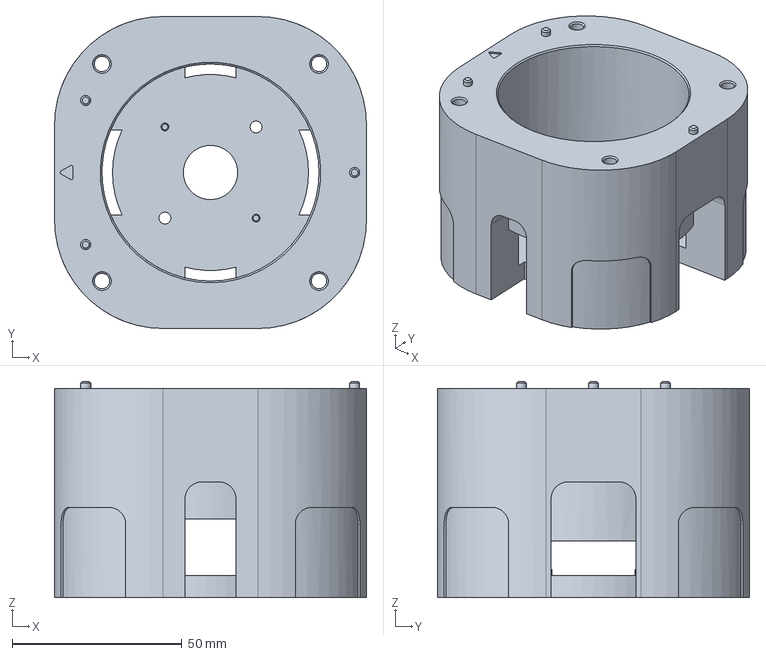
[picture p170: CAD file, 2026-11-01]
cad/arm2/rebot_src/01_BASE_Link.step
92.0 x 92.0 x 63.7 mm
