Riyu-D1/Vector/cad/export/j1_turret.step

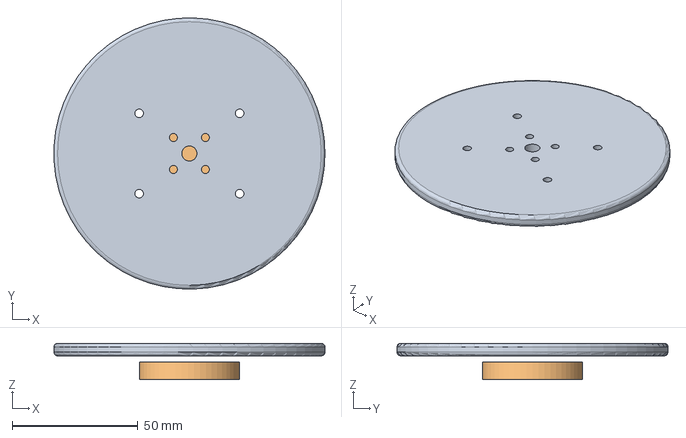
[picture p171: CAD file, 2026-10-26]
cad/export/j1_turret.step
107.9 x 108.0 x 14.5 mm
