Riyu-D1/Vector/cyclo4/out/mag_puck.step

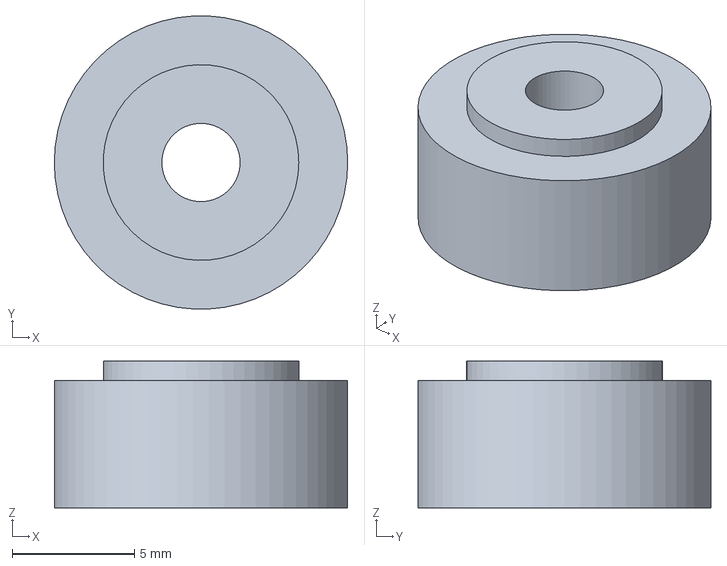
[picture p172: CAD file, 2026-11-02]
cyclo4/out/mag_puck.step
12.0 x 12.0 x 6.00 mm
