Riyu-D1/Vector/cad/actuator/export/motor_shaft.stl

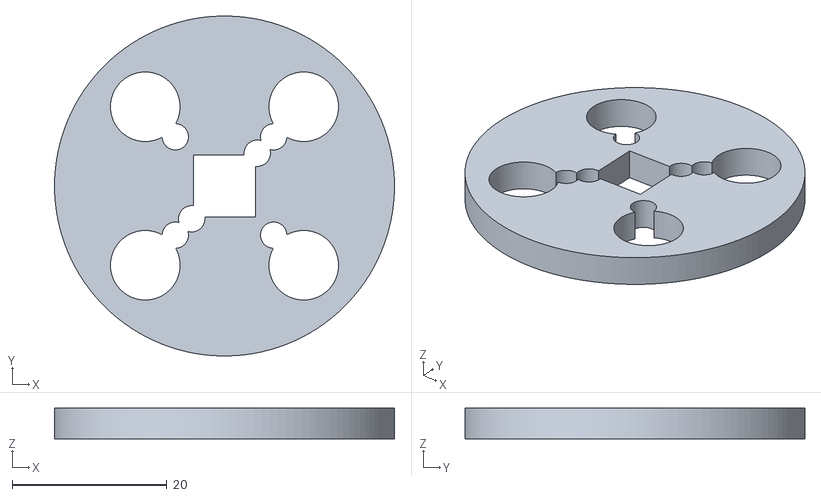
[picture p173: CAD file, 2026-11-01]
cad/actuator/export/motor_shaft.stl
44.0 x 44.0 x 4.00
