Riyu-D1/Vector/cad/arm/export/turret.step

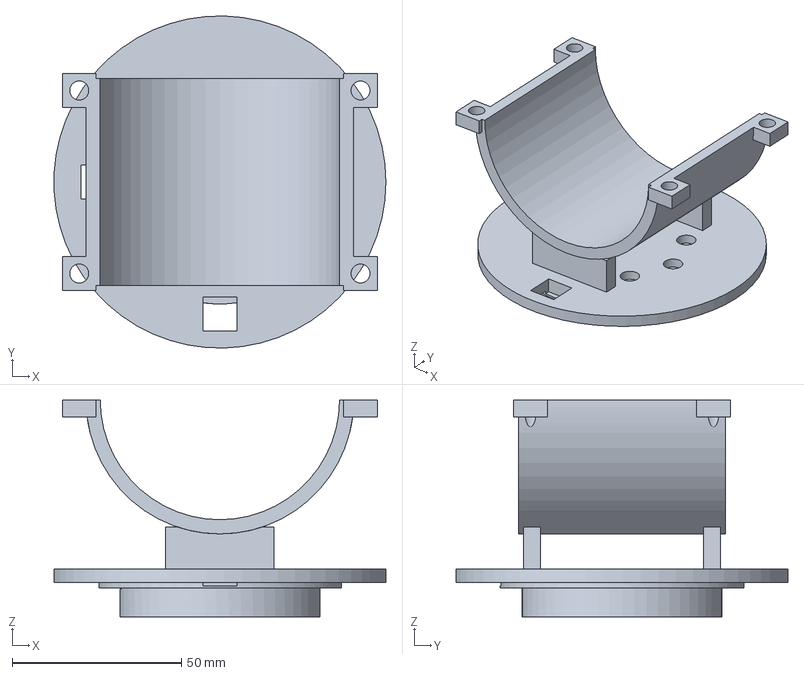
[picture p174: CAD file, 2026-11-01]
cad/arm/export/turret.step
97.9 x 98.0 x 64.0 mm
