Riyu-D1/Vector/cad/arm2/rebot_src/02_Motor_Back_Spacer_J2.step

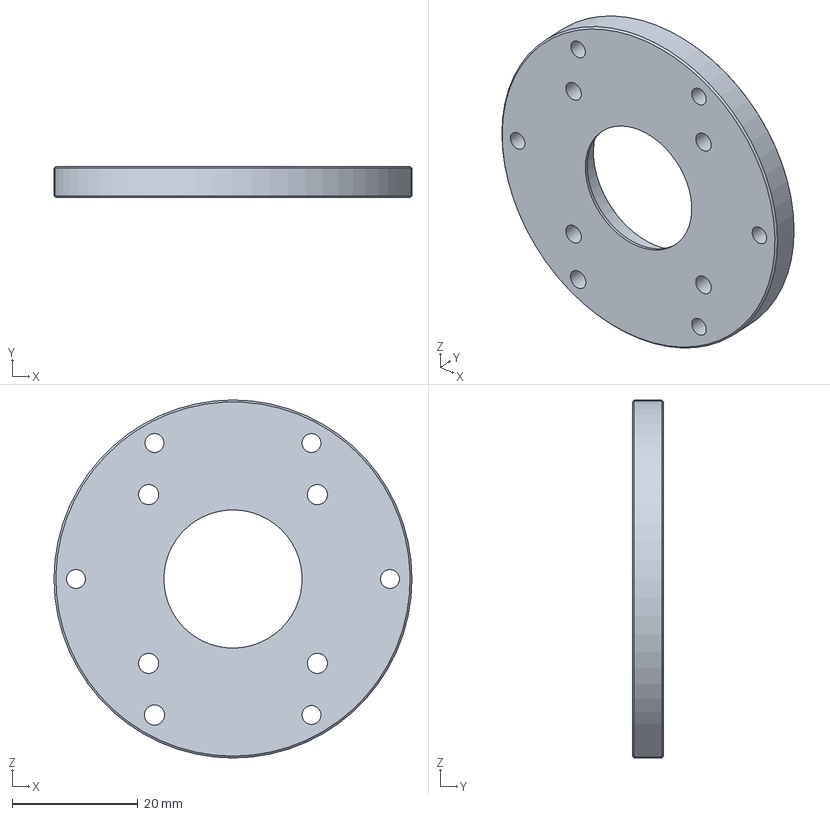
[picture p175: CAD file, 2026-11-01]
cad/arm2/rebot_src/02_Motor_Back_Spacer_J2.step
57.0 x 5.00 x 57.0 mm
