Riyu-D1/Vector/cad/export/j2_bracket.step

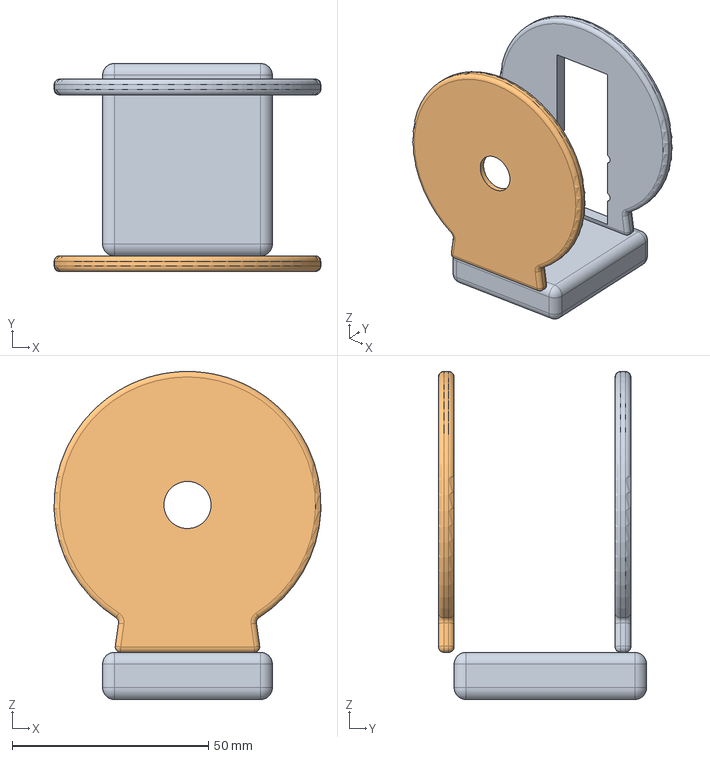
[picture p176: CAD file, 2026-10-26]
cad/export/j2_bracket.step
67.9 x 53.0 x 83.5 mm
