Riyu-D1/Vector/cyclo4/out/vendor_ringpins.step

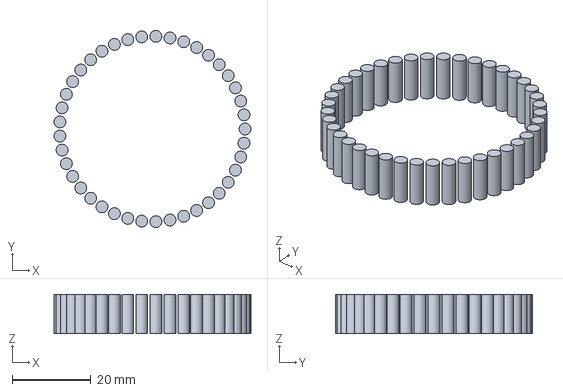
[picture p177: CAD file, 2026-11-02]
cyclo4/out/vendor_ringpins.step
49.9 x 50.0 x 10.0 mm
