Riyu-D1/Vector/refine/out/fix_tool_grip_posed.stl

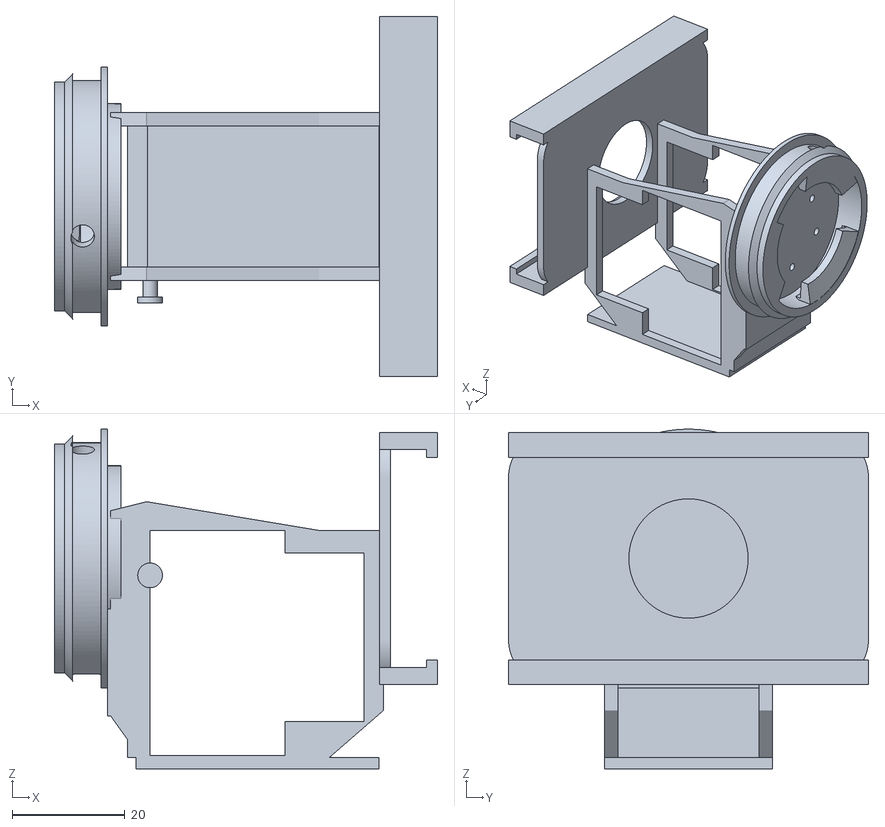
[picture p178: CAD file, 2026-11-10]
refine/out/fix_tool_grip_posed.stl
68.1 x 64.0 x 60.4
