Riyu-D1/Vector/cad/actuator/export/_gears.stl

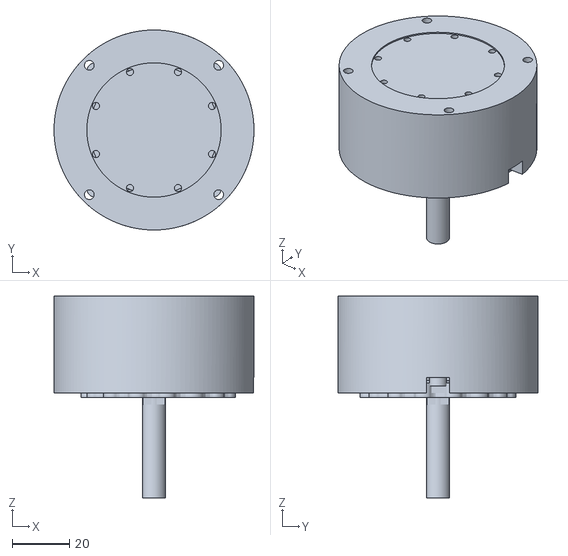
[picture p179: CAD file, 2026-11-01]
cad/actuator/export/_gears.stl
70.0 x 70.0 x 70.7
