Riyu-D1/Vector/cad/arm2/rebot_src/02_FLANGE_J2.step

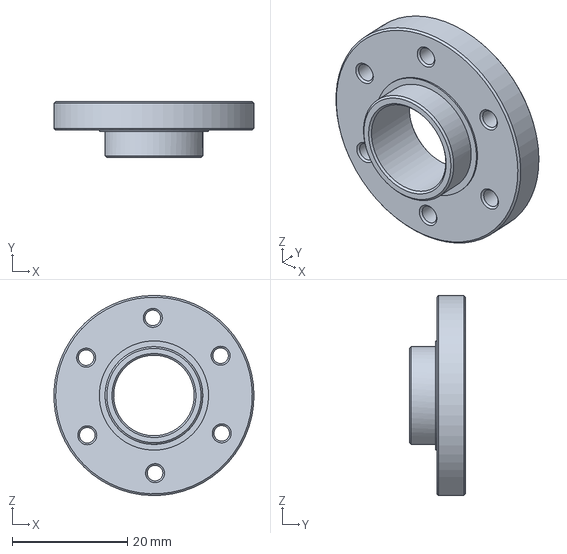
[picture p180: CAD file, 2026-11-01]
cad/arm2/rebot_src/02_FLANGE_J2.step
34.8 x 9.75 x 34.8 mm
