Riyu-D1/Vector/cad/export/wrist_neck.step

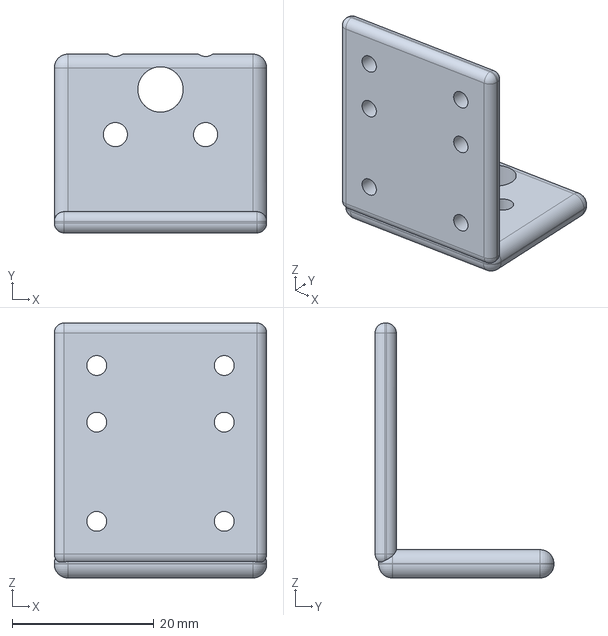
[picture p181: CAD file, 2026-10-26]
cad/export/wrist_neck.step
30.0 x 25.2 x 36.0 mm
