Riyu-D1/Vector/cad/arm/export/horn_ext_j4.step

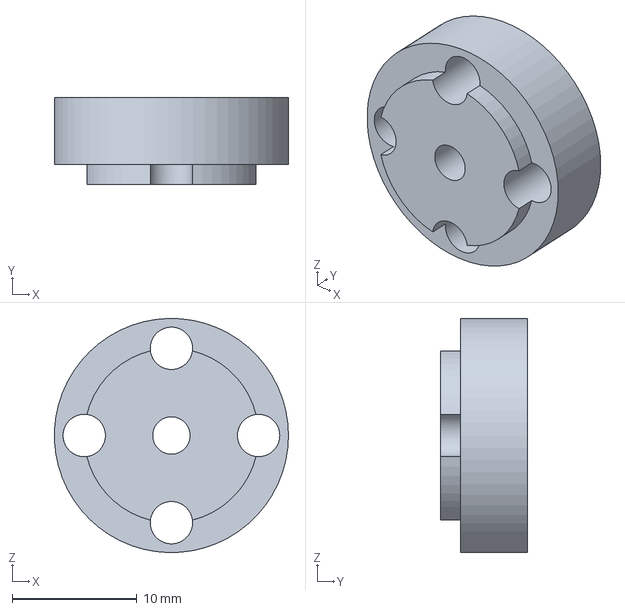
[picture p182: CAD file, 2026-11-01]
cad/arm/export/horn_ext_j4.step
18.8 x 6.95 x 18.8 mm
