Riyu-D1/Vector/cad/export/wrist_faceplate.step

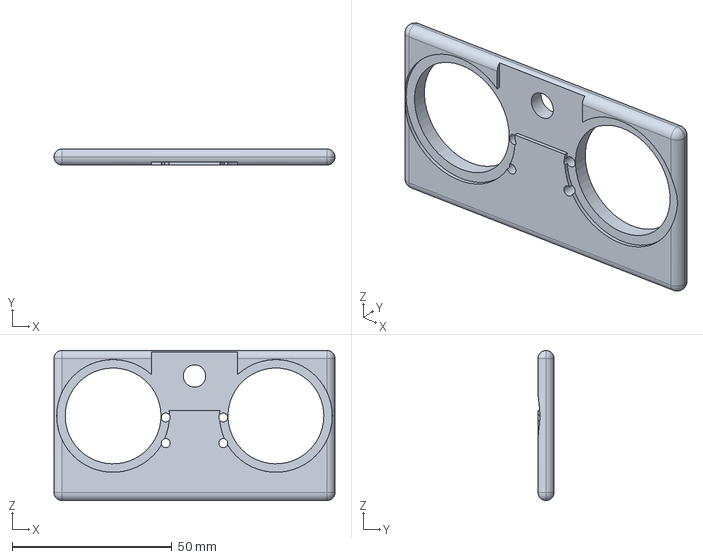
[picture p183: CAD file, 2026-10-26]
cad/export/wrist_faceplate.step
88.0 x 5.00 x 47.0 mm
