Riyu-D1/Vector/cad/arm/export/horn_ext_j5.step

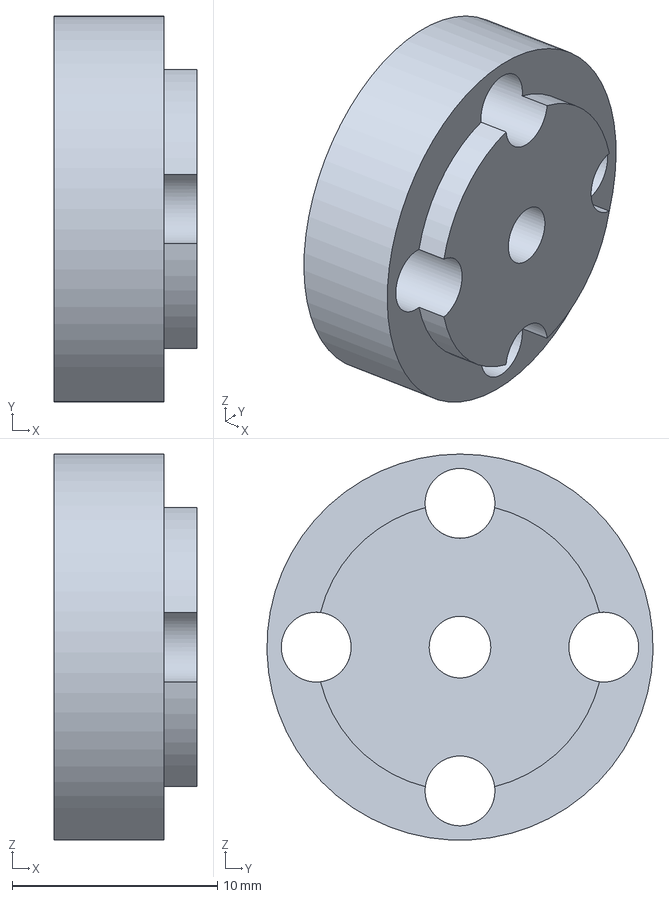
[picture p184: CAD file, 2026-11-01]
cad/arm/export/horn_ext_j5.step
6.95 x 18.8 x 18.8 mm
