Riyu-D1/Vector/cad/arm2/rebot_src/02_Base_Reinforcement_Part.step

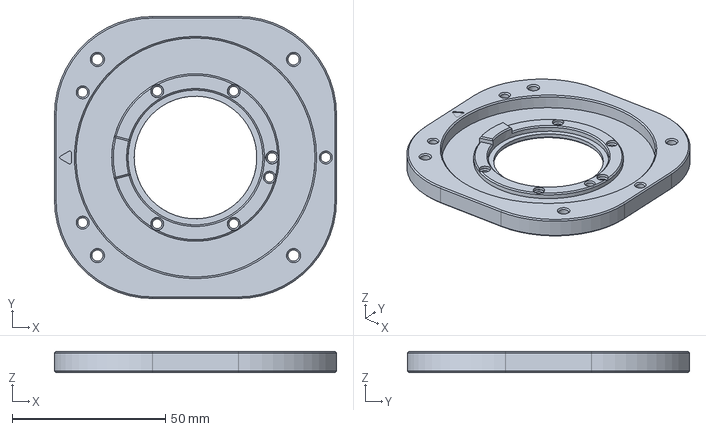
[picture p185: CAD file, 2026-11-01]
cad/arm2/rebot_src/02_Base_Reinforcement_Part.step
92.0 x 92.0 x 6.95 mm
