Riyu-D1/Vector/cad/export/j2_sea_hub.step

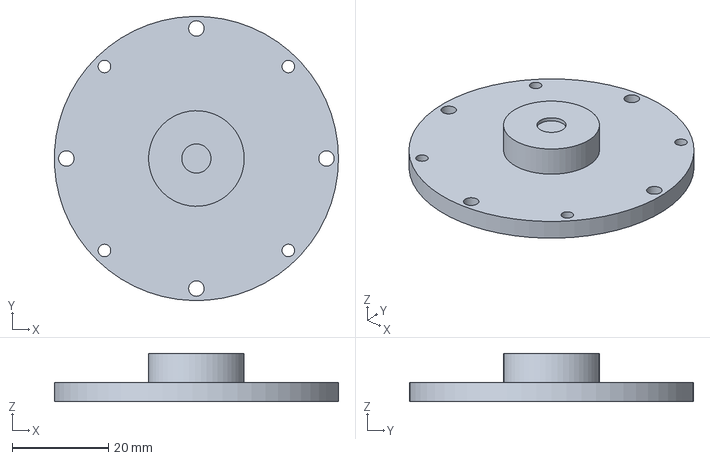
[picture p186: CAD file, 2026-10-26]
cad/export/j2_sea_hub.step
59.0 x 59.0 x 10.0 mm
