Riyu-D1/Vector/cyclo4/out/vendor_6808.step

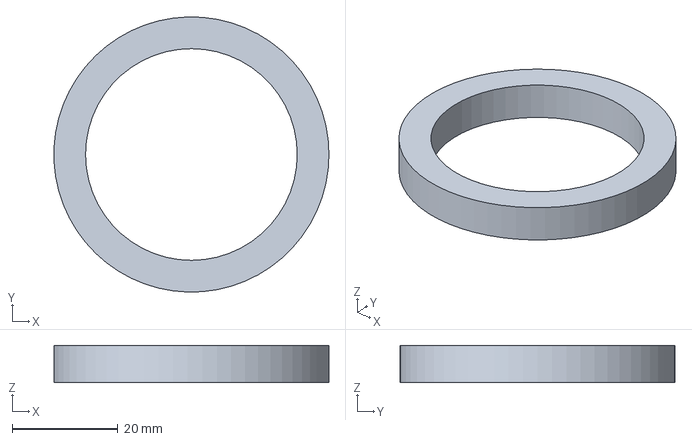
[picture p187: CAD file, 2026-11-02]
cyclo4/out/vendor_6808.step
52.0 x 52.0 x 7.00 mm
