Riyu-D1/Vector/cad/arm/export/ref_sts3215.stl

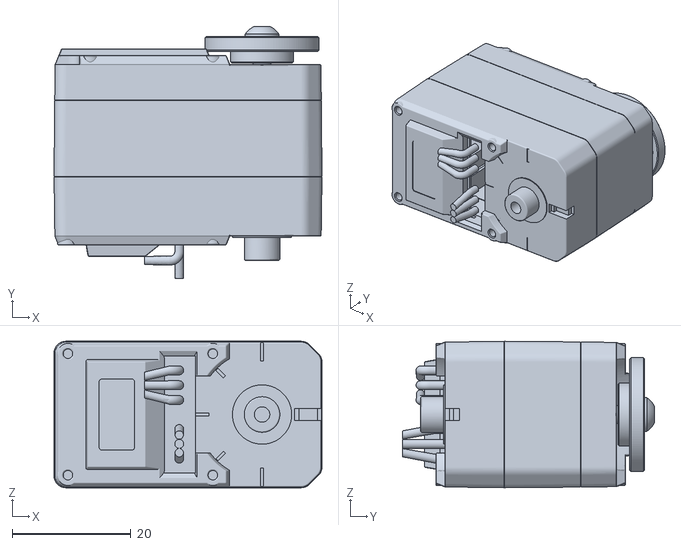
[picture p188: CAD file, 2026-11-01]
cad/arm/export/ref_sts3215.stl
45.2 x 42.5 x 24.7
