Riyu-D1/Vector/cad/arm2/rebot_src/03_Link1.step

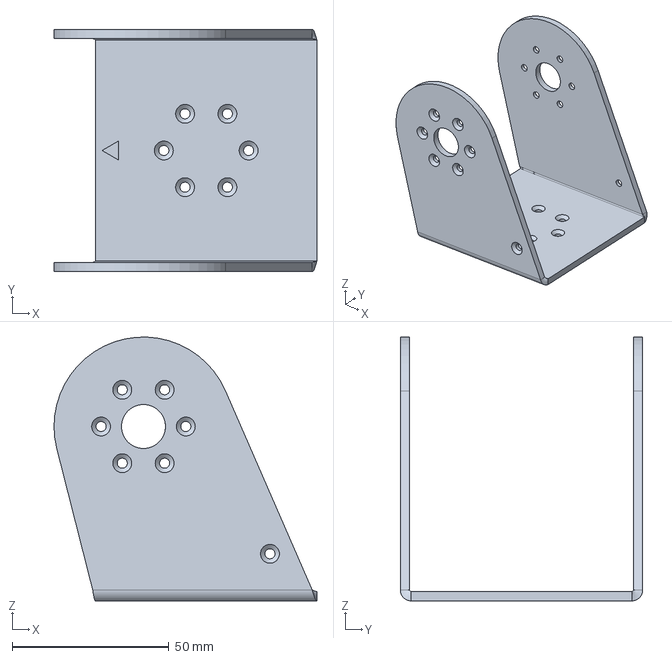
[picture p189: CAD file, 2026-11-01]
cad/arm2/rebot_src/03_Link1.step
83.8 x 77.3 x 84.0 mm
