Riyu-D1/Vector/cad/export/wrist_j5_pod.step

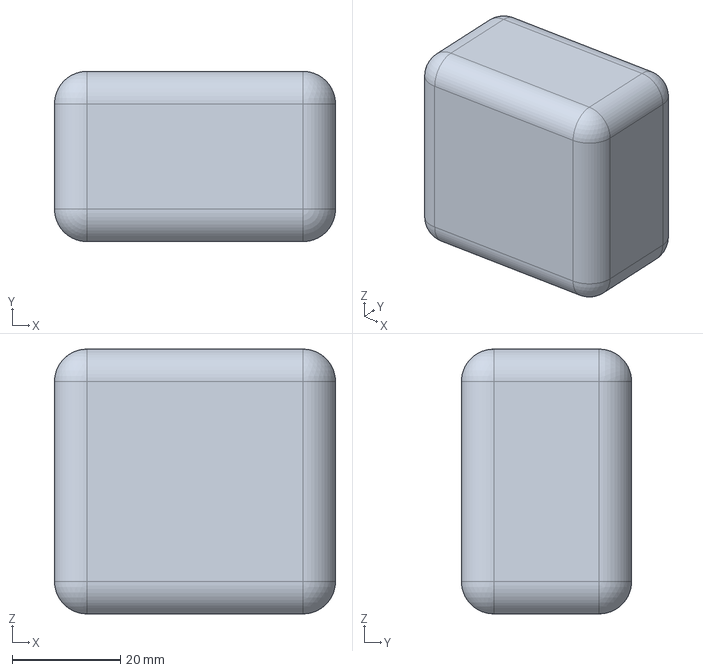
[picture p190: CAD file, 2026-10-26]
cad/export/wrist_j5_pod.step
52.0 x 31.5 x 49.0 mm
