Riyu-D1/Vector/cyclo4/out/vendor_motor.step

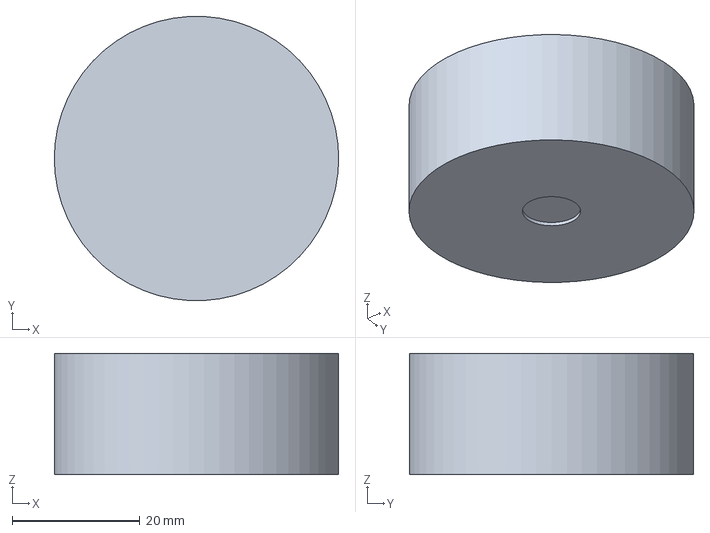
[picture p191: CAD file, 2026-11-02]
cyclo4/out/vendor_motor.step
44.5 x 44.4 x 19.0 mm
