Riyu-D1/Vector/refine/out/stock_tool_grip.step

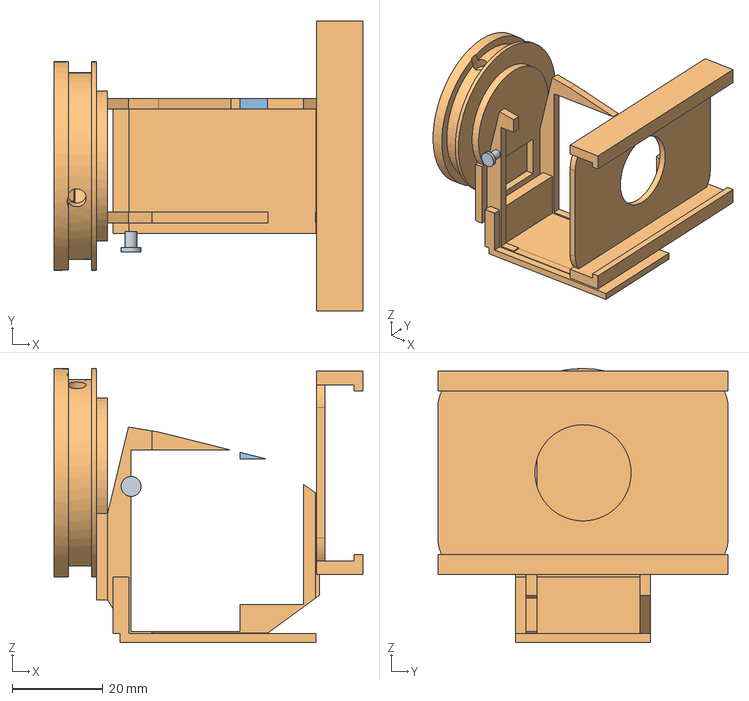
[picture p192: CAD file, 2026-11-10]
refine/out/stock_tool_grip.step
68.1 x 64.0 x 60.4 mm
