Riyu-D1/Vector/cad/arm/export/j1_clamp_ring.step

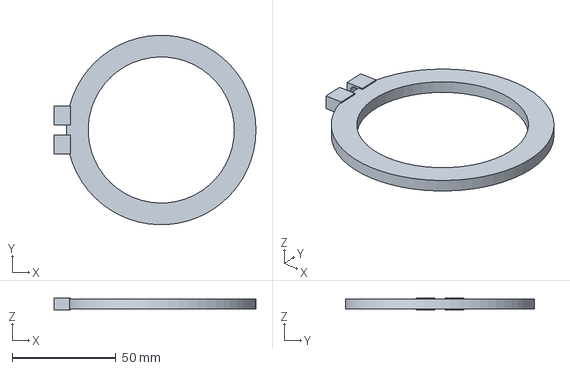
[picture p193: CAD file, 2026-11-01]
cad/arm/export/j1_clamp_ring.step
97.2 x 91.2 x 6.00 mm
