Riyu-D1/Vector/cad/export/j1_base_housing.step

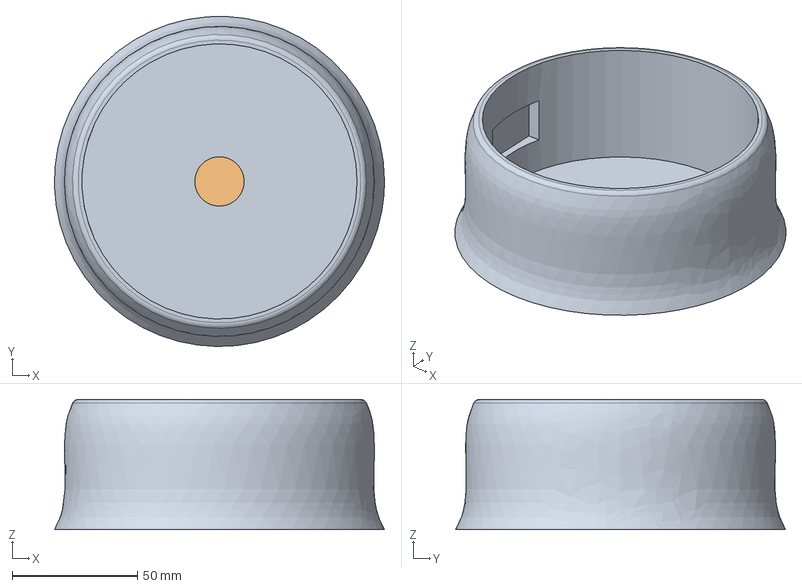
[picture p194: CAD file, 2026-10-26]
cad/export/j1_base_housing.step
132.0 x 131.9 x 52.0 mm
