Riyu-D1/Vector/cyclo4/out/vendor_as5600.step

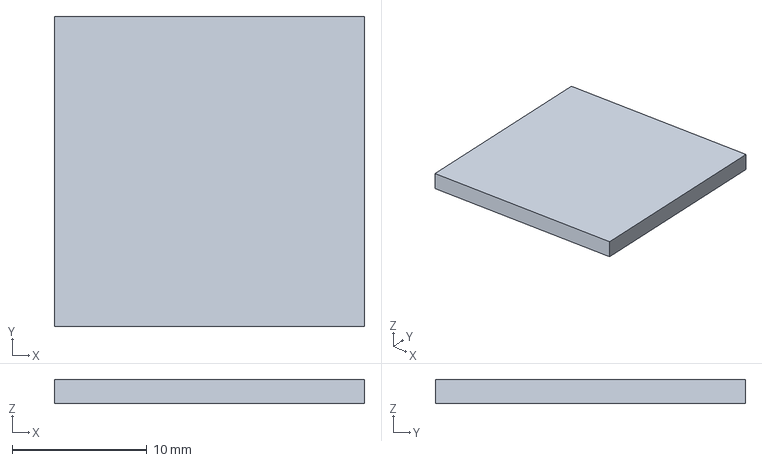
[picture p195: CAD file, 2026-11-02]
cyclo4/out/vendor_as5600.step
23.0 x 23.0 x 1.80 mm
