Riyu-D1/Vector/cyclo4/out/vendor_6702a.step

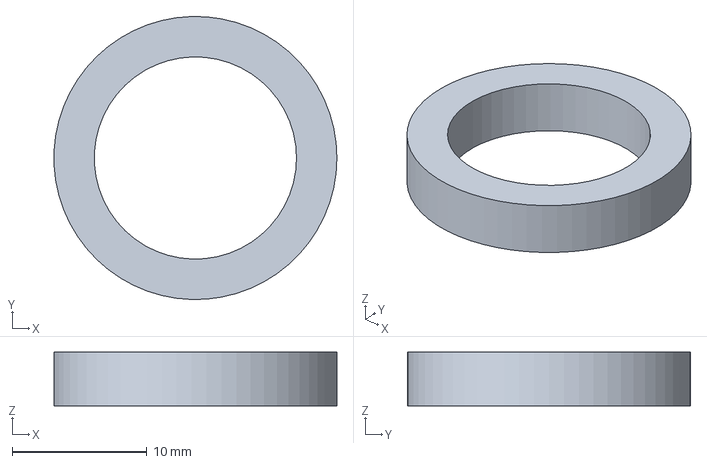
[picture p196: CAD file, 2026-11-02]
cyclo4/out/vendor_6702a.step
21.0 x 21.0 x 4.00 mm
