Riyu-D1/Vector/cad/arm/export/forearm.step

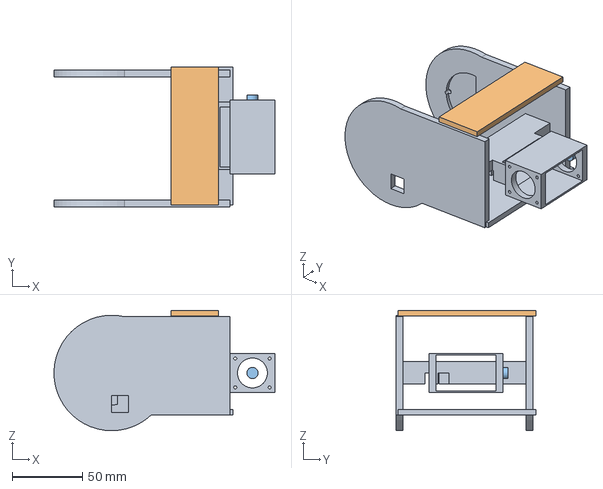
[picture p197: CAD file, 2026-11-01]
cad/arm/export/forearm.step
157.0 x 99.6 x 85.5 mm
