Riyu-D1/Vector/cad/export/j2_sea_spring.step

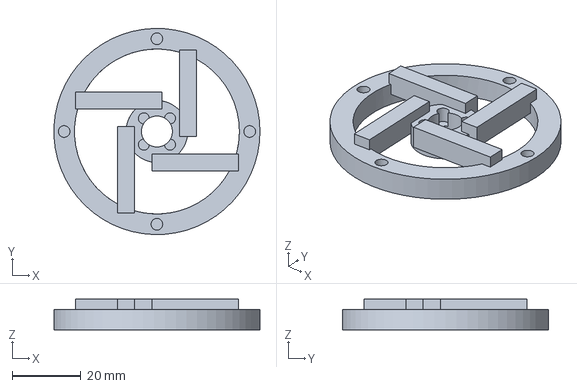
[picture p198: CAD file, 2026-10-26]
cad/export/j2_sea_spring.step
60.0 x 60.0 x 9.00 mm
