Riyu-D1/Vector/cyclo4/out/front_ring.step

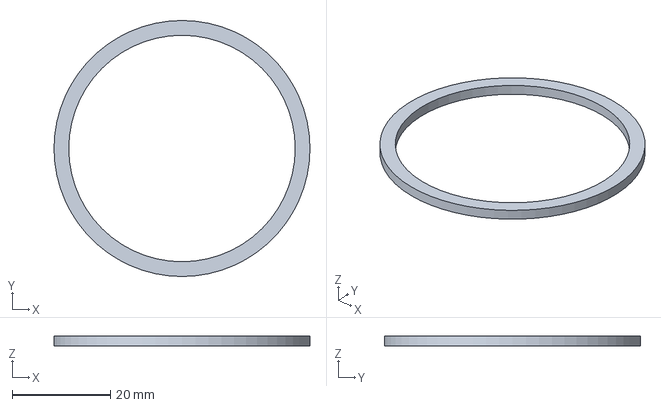
[picture p199: CAD file, 2026-11-02]
cyclo4/out/front_ring.step
52.0 x 52.0 x 2.00 mm
