Riyu-D1/Vector/cad/export/forearm.step

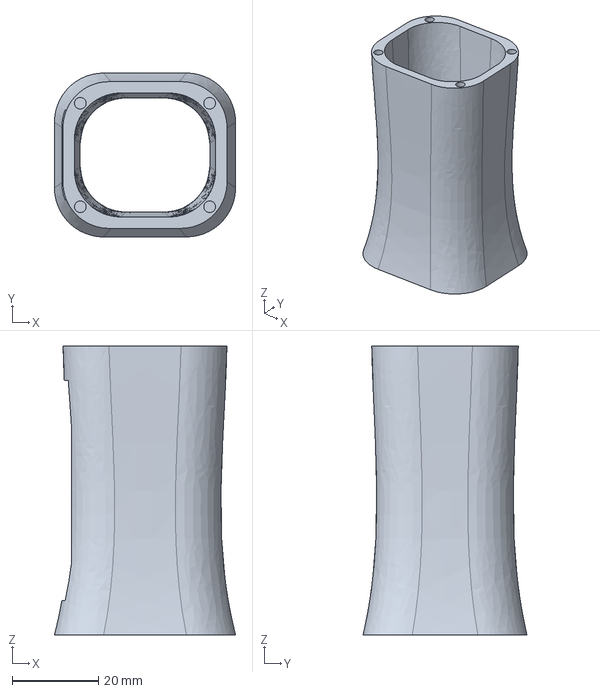
[picture p200: CAD file, 2026-10-26]
cad/export/forearm.step
42.0 x 38.0 x 67.0 mm
