Riyu-D1/Vector/refine/out/fix_w_link4.step

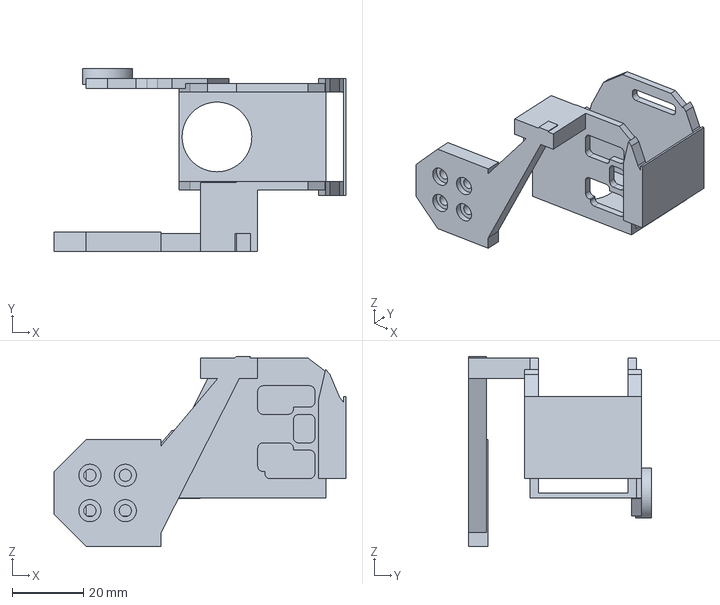
[picture p201: CAD file, 2026-11-10]
refine/out/fix_w_link4.step
81.7 x 51.3 x 53.2 mm
