Riyu-D1/Vector/cad/export/gripper_idler.step

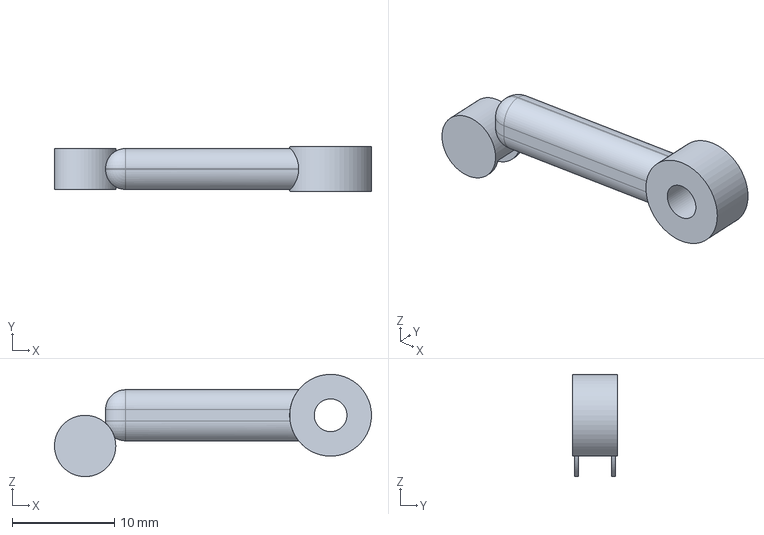
[picture p202: CAD file, 2026-10-26]
cad/export/gripper_idler.step
31.0 x 4.40 x 10.00 mm
