Riyu-D1/Vector/cyclo4/out/carrier.step

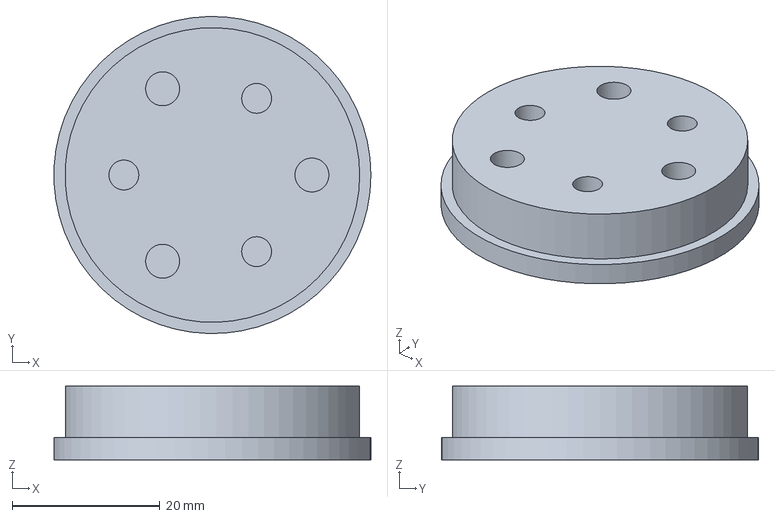
[picture p203: CAD file, 2026-11-02]
cyclo4/out/carrier.step
43.0 x 43.0 x 10.0 mm
