Riyu-D1/Vector/cyclo4/out/vendor_dowels.step

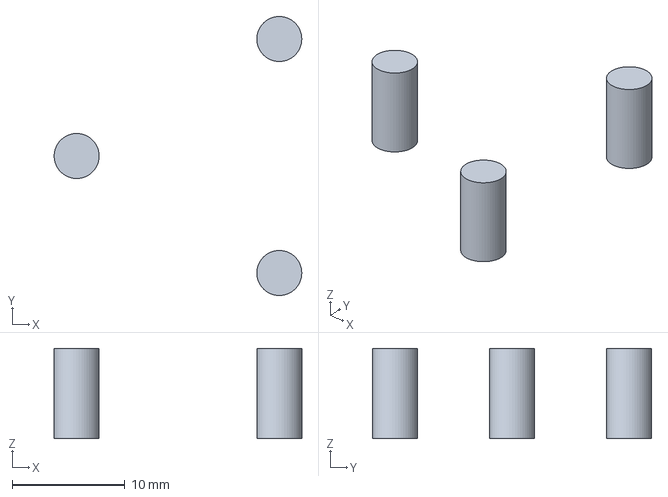
[picture p204: CAD file, 2026-11-02]
cyclo4/out/vendor_dowels.step
22.0 x 24.8 x 8.00 mm
