Riyu-D1/Vector/refine/out/stock_w_grip_frame.step

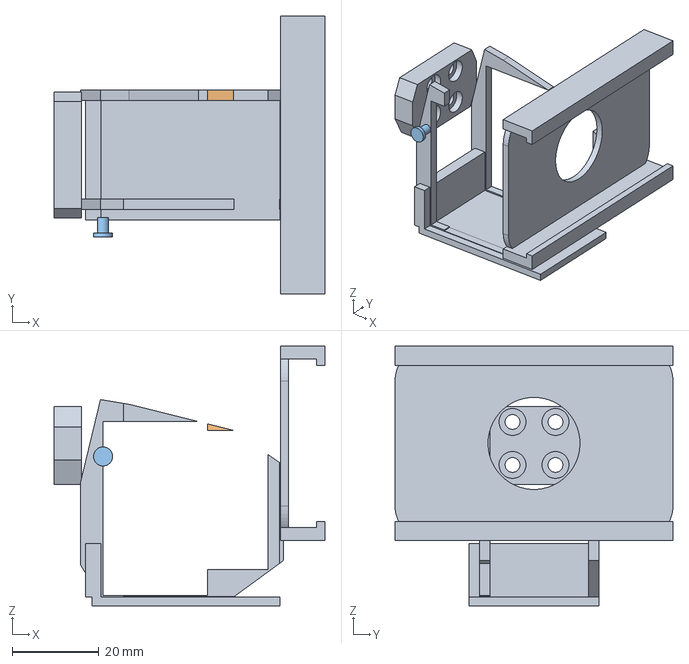
[picture p205: CAD file, 2026-11-10]
refine/out/stock_w_grip_frame.step
62.4 x 64.0 x 59.8 mm
