Riyu-D1/Vector/(list of files, cad)

Other CAD files:
cad/actuator/export/actuator_assembly.step
refine/out/scr_r6f.step
cad/arm2/rebot_src/02_Lower_Upper_Link_L.step
cad/arm2b/rebot_src/02_Rack_U.step
refine/out/_r8/w_link5.step
refine/out/_probe/fx_cradle.stl
refine/out/_r8/w_j4_cradle.step
cad3/out/vendor_spring_j2.step
refine/out/_probe/l4.stl
refine/out/_r7/l4.step
refine/out/_r8/link5.step
refine/out/_probe/fx_fore_r.stl
refine/out/vendor_rack_d.step
refine/out/_probe/id_l4.stl
refine/out/_r8/j4_cradle.step
wrist2/out/finger_u.step
cad/arm/export/jaw_r.step
cad3/out/back_spacer_j3.step
refine/out/_probe/cm_j4case.stl
refine/out/_r8/grip_frame.step
refine/out/w_link5.step
refine/out/_probe/l5.stl
refine/out/_r8/w_grip_frame.step
refine/out/finger_d.stl
refine/out/_probe/cm_fore_r.stl
cyclo4/out/disc1.step
refine/out/_probe/lf_fore_r.stl
refine/out/vendor_rack_u.step
cad/arm2/rebot_src/02_FLANGE_J3.step
cyclo4/out/housing.step
refine/out/_probe/gfv2.stl
refine/out/fix_wrist_pin.step
refine/out/_probe/st2_j6case.stl
refine/out/vendor_gear_grip.step
refine/out/_probe/st2_j5case.stl
cad/arm2/rebot_src/02_Motor_Front_Spacer_J3.step
refine/out/_probe/j4case.stl
refine/out/fix_w_j4_cradle.step
cad/arm/export/upper_link_cap.step
refine/out/_probe/st2_l5.stl
refine/out/scr_r6.step
refine/out/_probe/cm_cradle.stl
refine/out/vendor_sts3215_j4.step
cyclo4/out/vendor_6702b.step
refine/out/_probe/fore_r.stl
refine/out/_probe/gf.stl
refine/out/fix_tool_grip.step
cad/export/j1_servo.step
cad/arm/export/assembly.stl
cad/arm/export/base_housing.stl
cad/arm/export/bearing_cap.stl
cad/arm/export/forearm.stl
cad/arm/export/horn_ext_j4.stl
cad/arm/export/horn_ext_j5.stl
cad/arm/export/j1_clamp_ring.stl
cad/arm/export/jaw_l.stl
cad/arm/export/jaw_r.stl
cad/arm/export/nose.stl
cad/arm/export/print/forearm.stl
cad/arm/export/print/nose.stl
cad/arm/export/print/upper_link.stl
cad/arm/export/print/wrist.stl
cad/arm/export/turret.stl
cad/arm/export/turret_cap.stl
cad/arm/export/upper_link.stl
cad/arm/export/upper_link_cap.stl
cad/arm/export/wrist.stl
cad/export/SOMA_assembly.stl
cad/export/case_lid.stl
cad/export/case_tray.stl
cad/export/faceplate.step
cad/export/faceplate.stl
cad/export/forearm.stl
cad/export/gripper_finger_l.step
cad/export/gripper_finger_l.stl
cad/export/gripper_finger_r.stl
cad/export/gripper_idler.stl
cad/export/gripper_palm.step
cad/export/gripper_palm.stl
cad/export/gripper_spool.stl
cad/export/j1_base_housing.stl
cad/export/j1_servo.stl
cad/export/j1_turret.stl
cad/export/j2_bracket.stl
cad/export/j2_sea_adapter.step
cad/export/j2_sea_adapter.stl
cad/export/j2_sea_cap.stl
cad/export/j2_sea_hub.stl
cad/export/j2_sea_spring.stl
cad/export/j2_servo.step
cad/export/j2_servo.stl
cad/export/j2_yoke.step
cad/export/j2_yoke.stl
cad/export/j3_bracket.step
cad/export/j3_bracket.stl
cad/export/j3_sea_adapter.step
cad/export/j3_sea_adapter.stl
cad/export/j3_sea_cap.step
cad/export/j3_sea_cap.stl
cad/export/j3_sea_hub.step
cad/export/j3_sea_hub.stl
cad/export/j3_sea_spring.step
cad/export/j3_sea_spring.stl
cad/export/j3_servo.step
cad/export/j3_servo.stl
cad/export/j3_yoke.step
cad/export/j3_yoke.stl
cad/export/j4_servo.stl
cad/export/j5_servo.stl
cad/export/upper_arm.step
cad/export/upper_arm.stl
cad/export/wrist_faceplate.stl
cad/export/wrist_j4_bracket.step
cad/export/wrist_j4_bracket.stl
cad/export/wrist_j4_yoke.stl
cad/export/wrist_j5_pod.stl
cad/export/wrist_j5_shell.step
cad/export/wrist_j5_shell.stl
cad/export/wrist_neck.stl
cad3/out/back_spacer_j2.stl
cad3/out/back_spacer_j3.stl
cad3/out/flange_j2.stl
cad3/out/flange_j3.stl
cad3/out/vendor_spring_j2.stl
cad3/out/vendor_spring_j3.stl
cad3/out/vendor_sts3250_j4.stl
cyclo4/out/carrier.stl
cyclo4/out/disc1.stl
cyclo4/out/disc2.stl
cyclo4/out/front_ring.stl
cyclo4/out/housing.stl
cyclo4/out/hub.stl
cyclo4/out/mag_puck.stl
cyclo4/out/out_flange.stl
cyclo4/out/pin_ring.stl
cyclo4/out/vendor_6702a.stl
cyclo4/out/vendor_6702b.stl
cyclo4/out/vendor_6808.stl
cyclo4/out/vendor_685.stl
cyclo4/out/vendor_as5600.stl
cyclo4/out/vendor_dowels.stl
cyclo4/out/vendor_magnet.stl
cyclo4/out/vendor_motor.stl
cyclo4/out/vendor_outpins.stl
cyclo4/out/vendor_ringpins.stl
refine/out/_probe/cradle.stl
refine/out/_probe/fx2_cradle.stl
refine/out/_probe/fx2_fore_r.stl
refine/out/_probe/fx2_j4case.stl
refine/out/_probe/fx_j4case.stl
refine/out/_probe/id_cradle.stl
refine/out/_probe/id_fore_r.stl
refine/out/_probe/id_j4case.stl
refine/out/_probe/lf_cradle.stl
refine/out/_probe/lf_j4case.stl
refine/out/_probe/st_j5case.stl
refine/out/_probe/st_j6case.stl
refine/out/_probe/st_l5.stl
refine/out/_r8/grip_frame.stl
refine/out/_r8/j4_cradle.stl
refine/out/_r8/link4.stl
refine/out/_r8/link5.stl
refine/out/_r8/w_grip_frame.stl
refine/out/_r8/w_j4_cradle.stl
refine/out/_r8/w_link4.stl
refine/out/_r8/w_link5.stl
refine/out/finger_u.stl
refine/out/fix_tool_grip.stl
refine/out/fix_w_grip_frame.stl
refine/out/fix_w_j4_cradle.stl
refine/out/fix_w_link4.stl
refine/out/fix_w_link5.step
refine/out/fix_w_link5.stl
refine/out/fix_wrist_pin.stl
refine/out/scr_2step.step
refine/out/scr_flush.step
refine/out/scr_lip.step
refine/out/scr_r6w.step
refine/out/stock_tool_grip.stl
refine/out/stock_w_grip_frame.stl
refine/out/stock_w_j4_cradle.step
refine/out/stock_w_j4_cradle.stl
refine/out/stock_w_link4.step
refine/out/stock_w_link4.stl
refine/out/stock_w_link5.stl
refine/out/vendor_gear_grip.stl
refine/out/vendor_rack_d.stl
refine/out/vendor_rack_u.stl
refine/out/vendor_sts3215_g.step
refine/out/vendor_sts3215_g.stl
refine/out/vendor_sts3215_j4.stl
refine/out/vendor_sts3215_j5.step
refine/out/vendor_sts3215_j5.stl
refine/out/vendor_sts3215_j6.step
refine/out/vendor_sts3215_j6.stl
refine/out/w_grip_frame.step
refine/out/w_grip_frame.stl
refine/out/w_j4_cradle.step
refine/out/w_j4_cradle.stl
refine/out/w_link4.step
refine/out/w_link4.stl
refine/out/w_link5.stl
refine/out/wrist_pin.stl
wrist/out/finger_d.step
wrist/out/finger_d.stl
wrist/out/finger_u.step
wrist/out/finger_u.stl
wrist/out/vendor_gear_grip.step
wrist/out/vendor_gear_grip.stl
wrist/out/vendor_rack_d.step
wrist/out/vendor_rack_d.stl
wrist/out/vendor_rack_u.step
wrist/out/vendor_rack_u.stl
wrist/out/vendor_sts3215_g.step
wrist/out/vendor_sts3215_g.stl
wrist/out/vendor_sts3215_j4.step
wrist/out/vendor_sts3215_j5.step
wrist/out/vendor_sts3215_j5.stl
wrist/out/vendor_sts3215_j6.step
wrist/out/vendor_sts3215_j6.stl
wrist/out/w_grip_frame.step
wrist/out/w_grip_frame.stl
wrist/out/w_j4_cradle.step
wrist/out/w_link4.step
wrist/out/w_link4.stl
wrist/out/w_link5.step
wrist/out/w_link5.stl
wrist2/out/finger_d.stl
wrist2/out/finger_u.stl
wrist2/out/vendor_gear_grip.step
wrist2/out/vendor_gear_grip.stl
wrist2/out/vendor_rack_d.step
wrist2/out/vendor_rack_d.stl
wrist2/out/vendor_rack_u.step
wrist2/out/vendor_rack_u.stl
wrist2/out/vendor_sts3215_g.step
wrist2/out/vendor_sts3215_g.stl
wrist2/out/vendor_sts3215_j4.step
wrist2/out/vendor_sts3215_j4.stl
wrist2/out/vendor_sts3215_j5.step
wrist2/out/vendor_sts3215_j5.stl
wrist2/out/vendor_sts3215_j6.step
wrist2/out/vendor_sts3215_j6.stl
wrist2/out/w_grip_frame.step
wrist2/out/w_grip_frame.stl
wrist2/out/w_j4_cradle.step
wrist2/out/w_j4_cradle.stl
wrist2/out/w_link4.step
wrist2/out/w_link4.stl
wrist2/out/w_link5.step
wrist2/out/w_link5.stl
