Riyu-D1/Vector/refine/renders/l5_print_up_h.png

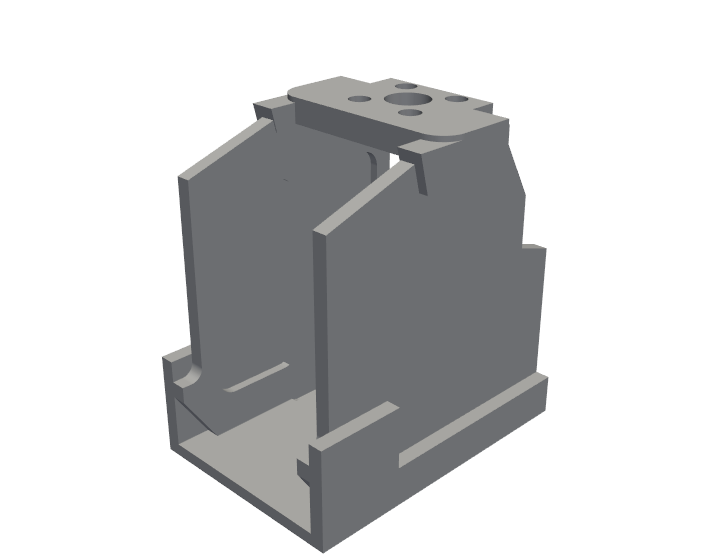
refine/renders/l5_print_up_h.png
