Riyu-D1/Vector/refine/renders/r8_sheet3_assembly.png

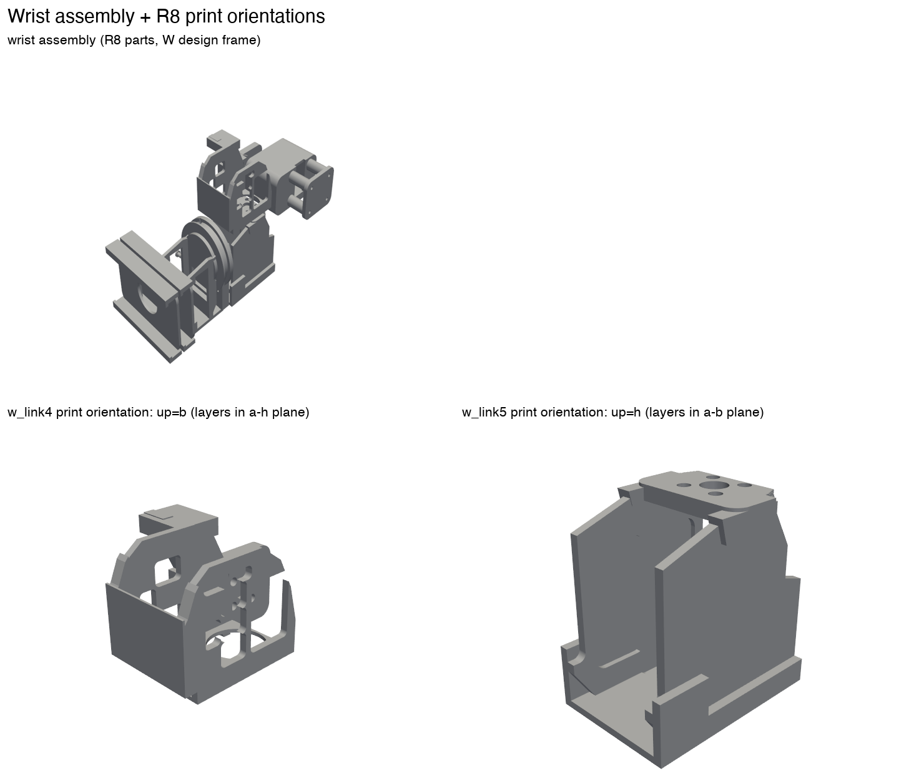
refine/renders/r8_sheet3_assembly.png
