Riyu-D1/Vector/refine/renders/r8_w_link4_print.png

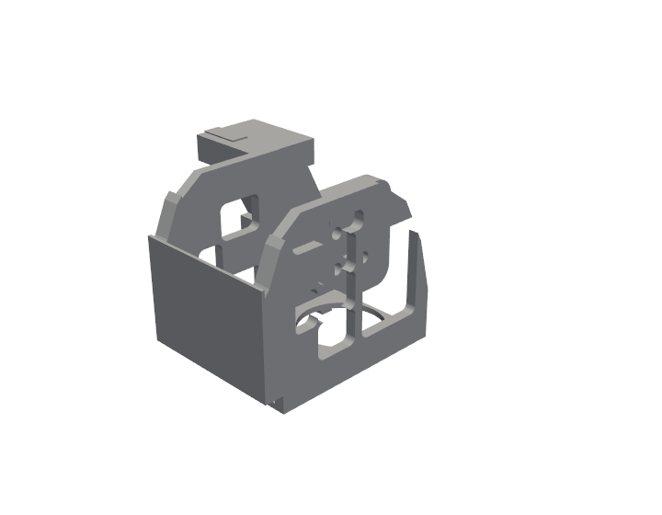
refine/renders/r8_w_link4_print.png
