Riyu-D1/Vector/refine/renders/sheet3_assembly.png

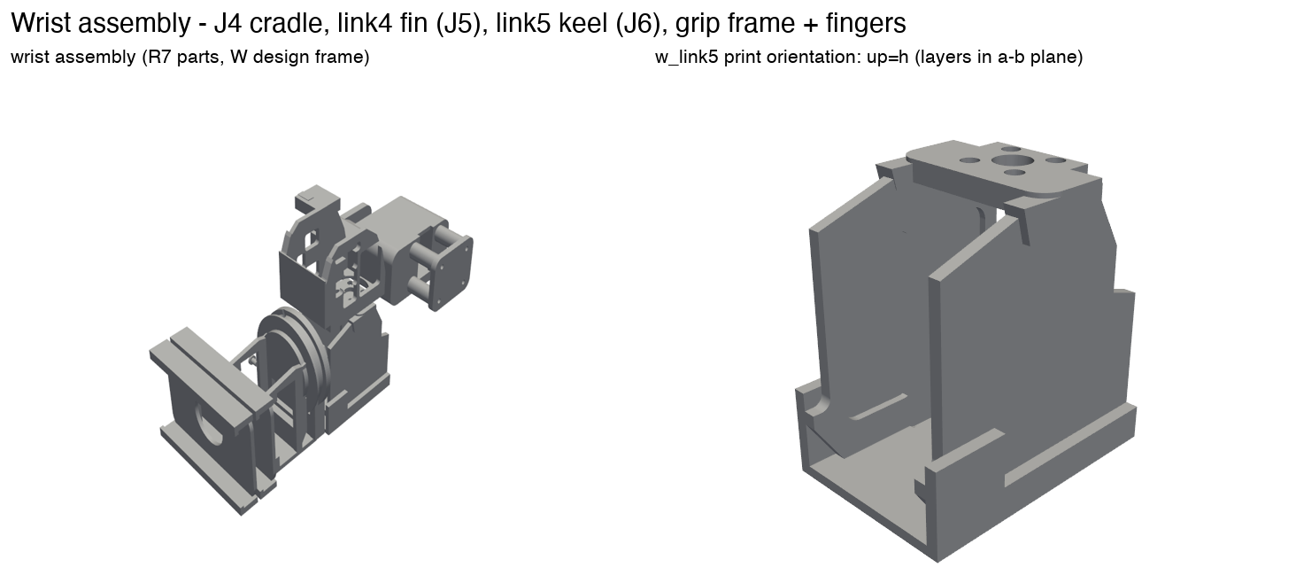
refine/renders/sheet3_assembly.png
