Riyu-D1/Vector/toolchg/print/bed_preview.png

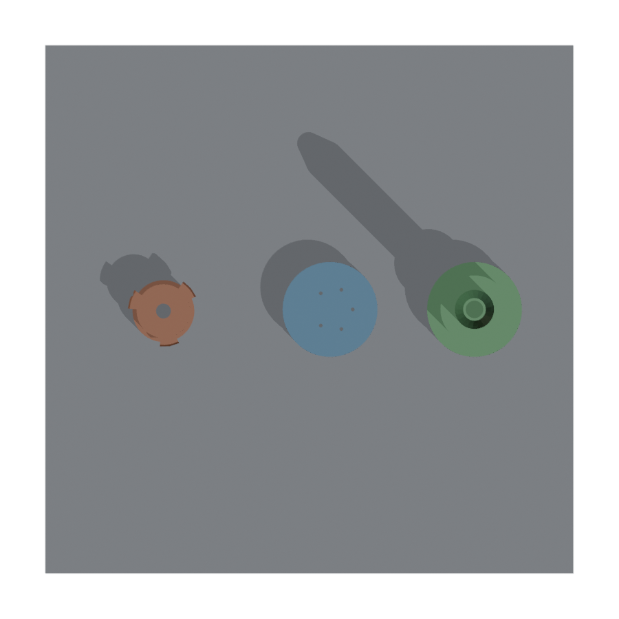
toolchg/print/bed_preview.png
