Riyu-D1/Vector/verify/fea/cyc1_eng_step2_front.png

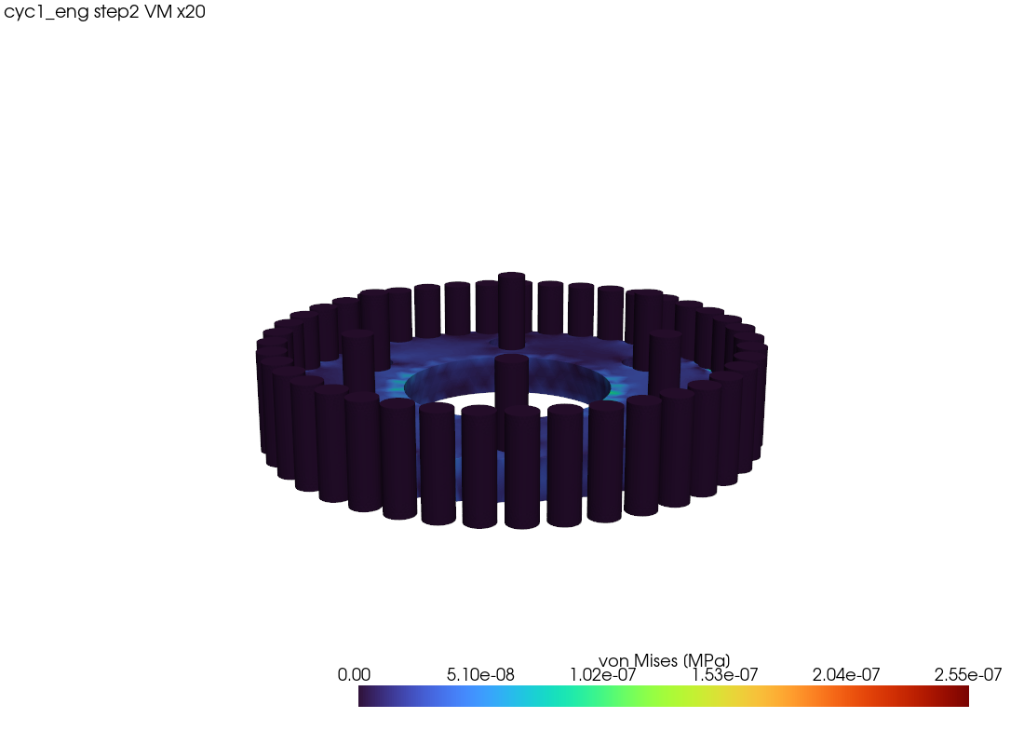
verify/fea/cyc1_eng_step2_front.png
