Riyu-D1/Vector/verify/fea/cyc1_eng_step2_iso.png

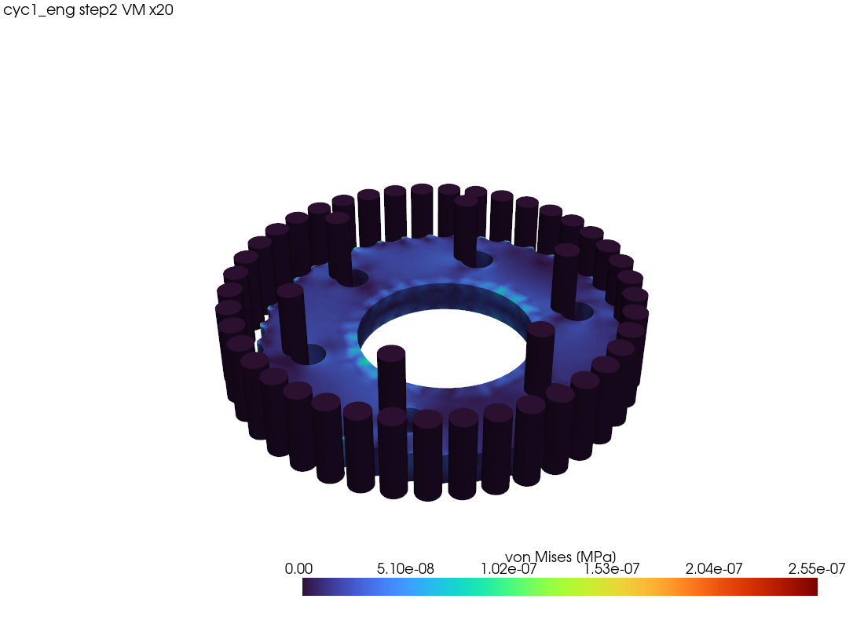
verify/fea/cyc1_eng_step2_iso.png
