Riyu-D1/Vector/fullcheck/fea/results.txt

# fullcheck/fea per-part SF2 results - arm-fullfix @ 0.25 kg
# CalculiX C3D10, bolted/pinned interfaces, fc_torque worst poses.
# SF = allowable/peak filtered stress (patch-adjacent nodes excluded).
# allowables: vm 25 | norm 12.5 | comp 15 | shear 8 (+6.1 lb) MPa

back_spacer_j2   28840 nodes 16458 tets | fix 6169 load 1710 | F=-12.91, 0.0, -0.0N M=0.0, -2481.1, -15.7Nmm@-20.0, 0.0, 143.5
    vm      0.497 MPa SF    50.29
    norm    0.069 MPa SF   180.93
    comp    0.632 MPa SF    23.73
    shear   0.178 MPa SF    45.04
    max|U| 0.001 mm | raw maxVM 0.66
    BINDING comp SF 23.73
back_spacer_j3   28423 nodes 16150 tets | fix 6095 load 1703 | F=-5.54, 0.0, 3.2N M=-1.5, -1258.0, -2.7Nmm@-20.0, 0.0, 270.2
    vm      0.280 MPa SF    89.28
    norm    0.058 MPa SF   216.36
    comp    0.348 MPa SF    43.04
    shear   0.095 MPa SF    84.16
    max|U| 0.000 mm | raw maxVM 0.36
    BINDING comp SF 43.04
base_link        375076 nodes 248735 tets | fix 23065 load 3359 | F=0.0, 0.0, -13.4N M=15.4, -2743.2, 0.0Nmm@0.0, 0.0, 80.8
    vm      0.141 MPa SF   177.91
    norm    0.017 MPa SF   748.44
    comp    0.200 MPa SF    75.17
    shear   0.059 MPa SF   135.12
    max|U| 0.000 mm | raw maxVM 0.15
    BINDING comp SF 75.17
base_plate_d     192612 nodes 125834 tets | fix 16402 load 15277 | F=0.0, 0.0, -13.4N M=15.4, -2743.2, 0.0Nmm@0.0, 0.0, 80.8
    vm      0.004 MPa SF  5578.30
    norm    0.000 MPa SF 46524.96
    comp    0.004 MPa SF  3727.46
    shear   0.002 MPa SF  3462.01
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
    BINDING comp SF 3.44
upper_back       58025 nodes 31752 tets | fix 12058 load 8826 | F=-5.54, 0.0, 3.2N M=-1.5, -1258.0, -2.7Nmm@-20.0, 0.0, 270.2
    vm      3.012 MPa SF     8.30
    norm    0.323 MPa SF    38.69
    comp    2.668 MPa SF     5.62
    shear   0.531 MPa SF    15.05
    max|U| 0.864 mm | raw maxVM 3.01
    BINDING comp SF 5.62
upper_out        29108 nodes 14989 tets | fix 3510 load 3512 | F=-5.54, 0.0, 3.2N M=-1.5, -1258.0, -2.7Nmm@-20.0, 0.0, 270.2
    vm      3.015 MPa SF     8.29
    norm    0.416 MPa SF    30.04
    comp    2.388 MPa SF     6.28
    shear   0.527 MPa SF    15.19
    max|U| 0.867 mm | raw maxVM 3.01
    BINDING comp SF 6.28
yaw_limit        75962 nodes 43594 tets | fix 16464 load 11344 | F=0.0, 0.0, -13.4N M=15.4, -2743.2, 0.0Nmm@0.0, 0.0, 80.8
    vm      0.045 MPa SF   560.00
    norm    0.008 MPa SF  1602.41
    comp    0.036 MPa SF   411.21
    shear   0.026 MPa SF   311.24
    max|U| 0.000 mm | raw maxVM 0.41
    BINDING shear SF 311.24
