Riyu-D1/Vector/refine/fea/fix_tool_grip_front.png

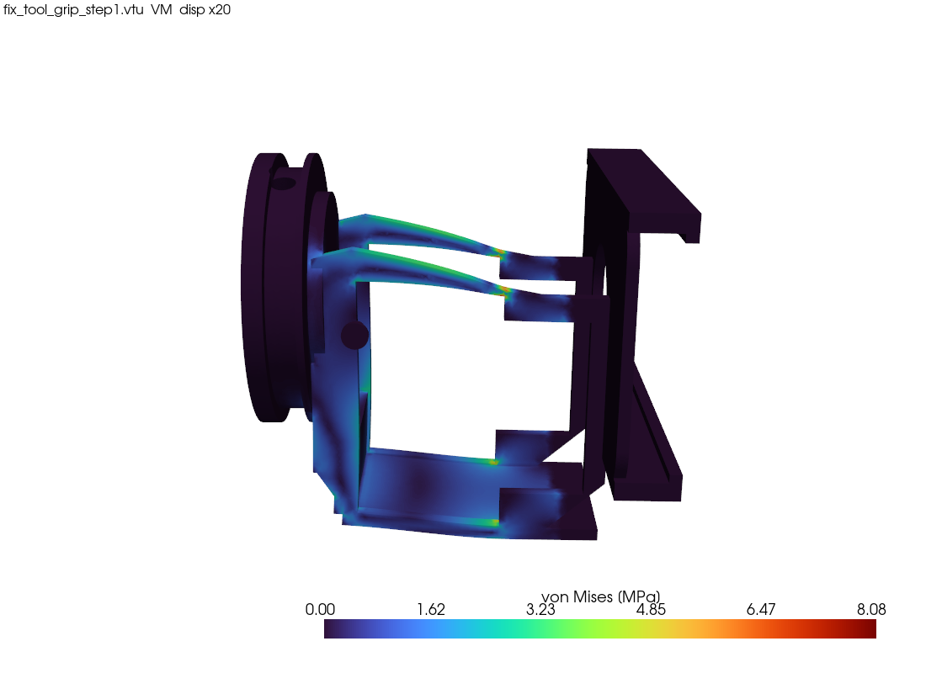
refine/fea/fix_tool_grip_front.png
