Riyu-D1/Vector/refine/fea/fix_tool_grip_iso.png

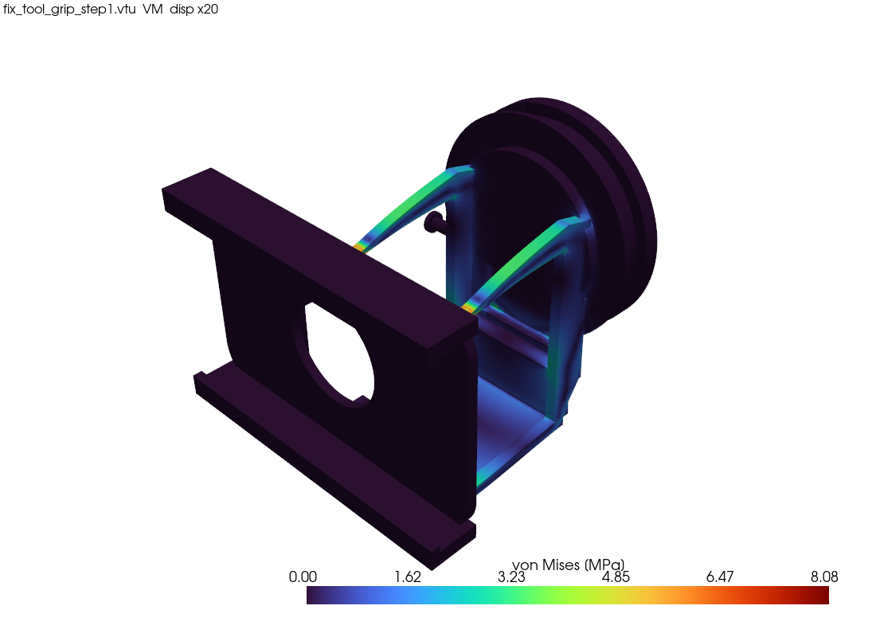
refine/fea/fix_tool_grip_iso.png
