Riyu-D1/Vector/refine/fea/fix_w_grip_frame_front.png

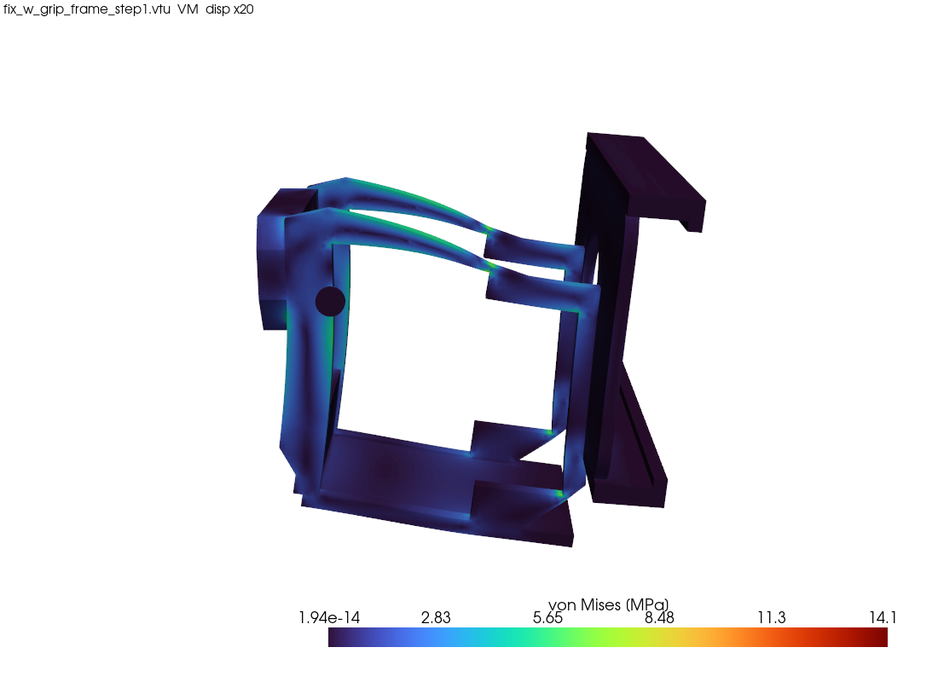
refine/fea/fix_w_grip_frame_front.png
