Riyu-D1/Vector/refine/renders/fix_w_link4.png

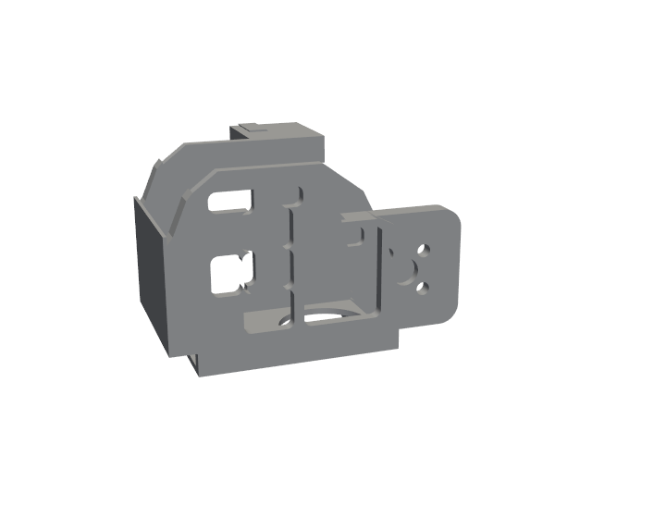
refine/renders/fix_w_link4.png
