Riyu-D1/Vector/refine/renders/fix_w_link5.png

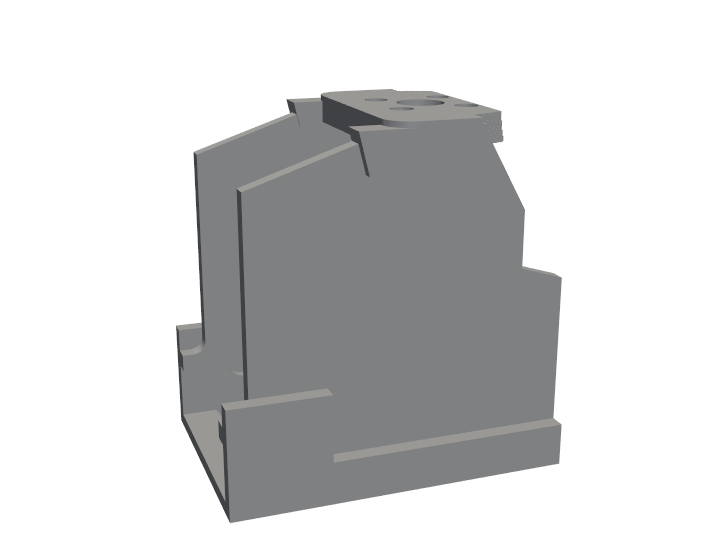
refine/renders/fix_w_link5.png
