Riyu-D1/Vector/order/pcb13_fix/soma-carrier-v13.kicad_pcb

## KiCad design order/pcb13_fix/soma-carrier-v13.kicad_pcb (2026-11-01)

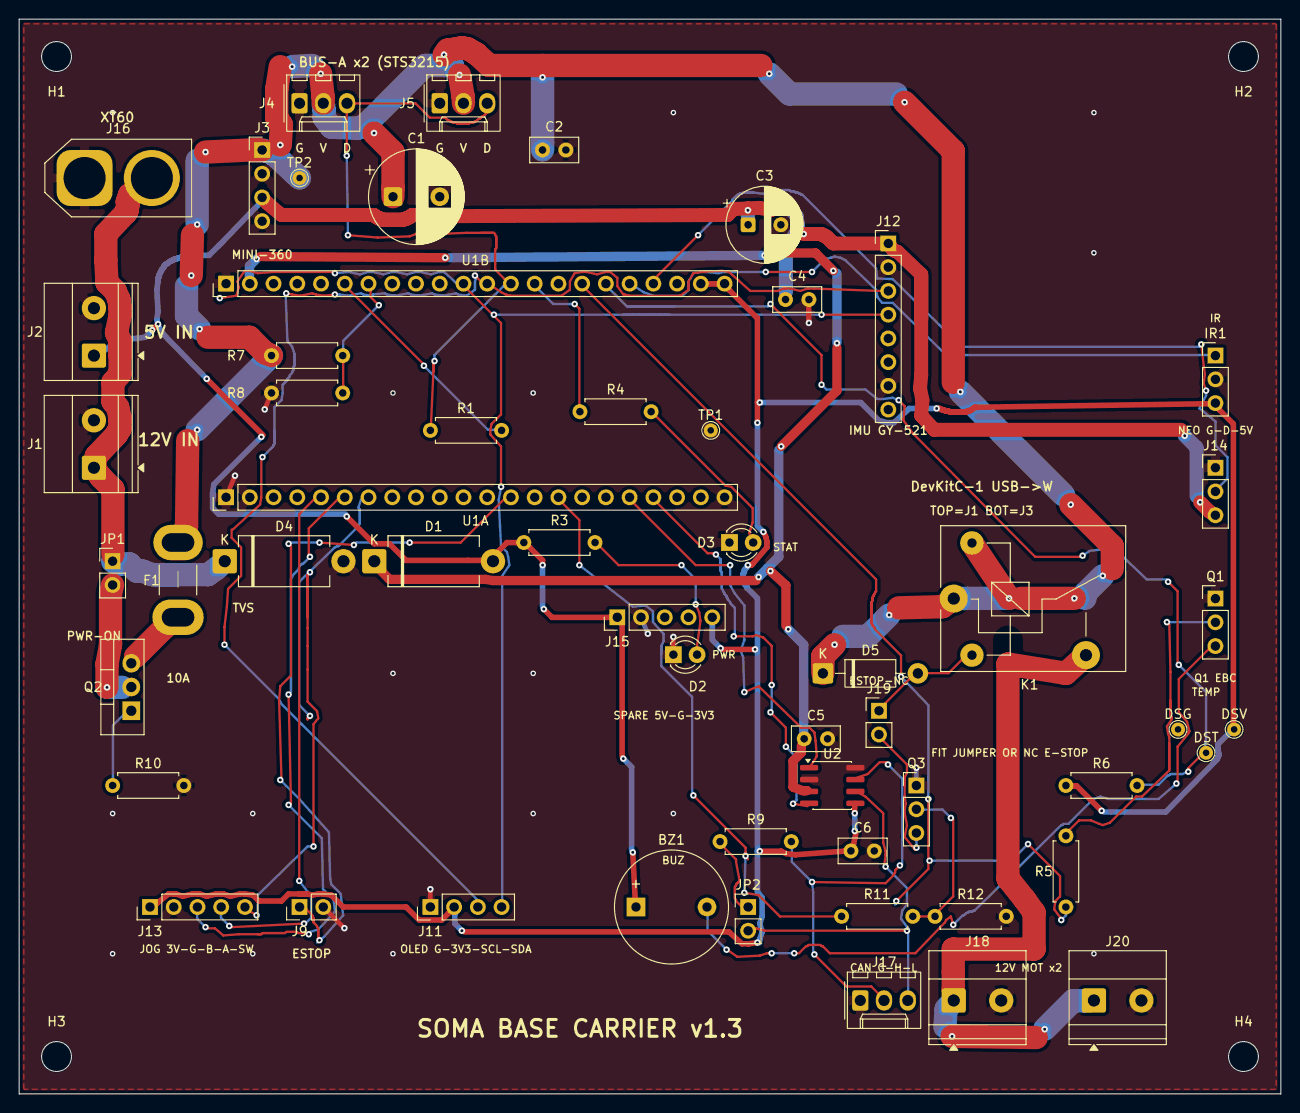
[picture p218: board soma-carrier-v13.kicad_pcb from above]

Board: 2 copper layers, 135.0 x 115.0 mm, 59 parts (0 on the bottom side), 37 nets.

Parts:
BZ1: BUZZ5V; Buzzer_12x9.5RM7.6
C1: 1000uF; CP_Radial_D10.0mm_P5.00mm
C2, C4, C5, C6: 100nF; C_Disc_D5.0mm_W2.5mm_P2.50mm
C3: 220uF; CP_Radial_D8.0mm_P3.50mm
D1: 1N5820; D_DO-201_P12.70mm_Horizontal
D2: PWR; LED_D3.0mm
D3: STAT; LED_D3.0mm
D4: TVS15; D_DO-201_P12.70mm_Horizontal
D5: 1N4007; D_DO-41_SOD81_P10.16mm_Horizontal
DSG: DS18B20-G; TestPoint_THTPad_D1.5mm_Drill0.7mm
DST: DS18B20-DQ; TestPoint_THTPad_D1.5mm_Drill0.7mm
DSV: DS18B20-V; TestPoint_THTPad_D1.5mm_Drill0.7mm
F1: 10A; Fuse_Blade_Mini_directSolder
H1, H2, H3, H4: M3; MountingHole_3.2mm_M3_DIN965
IR1: VS1838B; PinHeader_1x03_P2.54mm_Vertical
J1: 12V_IN; TerminalBlock_Phoenix_MKDS-1,5-2-5.08_1x02_P5.08mm_Horizont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
J2: 5V_IN; TerminalBlock_Phoenix_MKDS-1,5-2-5.08_1x02_P5.08mm_Horizont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
J3: MINI360; PinHeader_1x04_P2.54mm_Vertical
J4: BUS_A1; Molex_KK-254_AE-6410-03A_1x03_P2.54mm_Vertical
J5: BUS_A2; Molex_KK-254_AE-6410-03A_1x03_P2.54mm_Vertical
J9: ESTOP; PinHeader_1x02_P2.54mm_Vertical
J11: OLED; PinHeader_1x04_P2.54mm_Vertical
J12: IMU; PinHeader_1x08_P2.54mm_Vertical
J13: JOG; PinHeader_1x05_P2.54mm_Vertical
J14: NEOPIX; PinHeader_1x03_P2.54mm_Vertical
J15: SPARE; PinHeader_1x05_P2.54mm_Vertical
J16: XT60; AMASS_XT60-M_1x02_P7.20mm_Vertical
J17: CAN; Molex_KK-254_AE-6410-03A_1x03_P2.54mm_Vertical
J18, J20: 12V_MOT; TerminalBlock_Phoenix_MKDS-1,5-2-5.08_1x02_P5.08mm_Horizont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
J19: ESTOP-NC; PinHeader_1x02_P2.54mm_Vertical
JP1: PWR-ON; PinHeader_1x02_P2.54mm_Vertical
JP2: CAN-TERM; PinHeader_1x02_P2.54mm_Vertical
K1: SRD-12V; Relay_SPST_SANYOU_SRD_Series_Form_A
Q1, Q3: 2N2222A; PinHeader_1x03_P2.54mm_Vertical
Q2: IRF4905; TO-220-3_Vertical
R1, R5, R11: 1k; R_Axial_DIN0207_L6.3mm_D2.5mm_P7.62mm_Horizontal
R3, R4: 330; R_Axial_DIN0207_L6.3mm_D2.5mm_P7.62mm_Horizontal
R6: 4.7k; R_Axial_DIN0207_L6.3mm_D2.5mm_P7.62mm_Horizontal
R7: 30k; R_Axial_DIN0207_L6.3mm_D2.5mm_P7.62mm_Horizontal
R8: 6.8k; R_Axial_DIN0207_L6.3mm_D2.5mm_P7.62mm_Horizontal
R9: 120; R_Axial_DIN0207_L6.3mm_D2.5mm_P7.62mm_Horizontal
R10, R12: 10k; R_Axial_DIN0207_L6.3mm_D2.5mm_P7.62mm_Horizontal
TP1: GND; TestPoint_THTPad_D1.5mm_Drill0.7mm
TP2: +12V; TestPoint_THTPad_D1.5mm_Drill0.7mm
U1A: DevKitC-J3; PinHeader_1x22_P2.54mm_Vertical
U1B: DevKitC-J1; PinHeader_1x22_P2.54mm_Vertical
U2: TJA1051T/3; SOIC-8_3.9x4.9mm_P1.27mm

Connections:
+3V3: C6.1, DSV.1, IR1.3, J11.2, J13.1, J15.5, R6.1, U1B.21, U1B.22, U2.5
+5V: BZ1.1, C3.1, C4.1, D1.2, J2.1, J3.3, J12.1, J14.3, J15.1, R3.1
+5V_MCU: C5.1, D1.1, U1B.2, U2.3
+12V: C1.1, C2.1, D5.1, F1.2, J3.1, J4.2, J5.2, K1.1, K1.5, R7.1, TP2.1
+12V_IN: D4.1, J1.1, J16.2, JP1.1
+12V_MOT: J18.1, J20.1, K1.3
+12V_RP: F1.1, Q2.3
+12V_SW: JP1.2, Q2.2
BUSA_DATA: J4.3, J5.3, R1.1, U1B.13
BUZ: R5.1, U1B.16
BZB: Q1.2, R5.2
BZC: BZ1.2, Q1.3
CANH: J17.2, R9.2, U2.7
CANL: J17.3, JP2.2, U2.6
CAN_RX: U1A.19, U2.4
CAN_TERM: JP2.1, R9.1
CAN_TX: U1A.18, U2.1
ENC_A: J13.4, U1A.5
ENC_B: J13.3, U1A.6
ENC_SW: J13.5, U1A.7
ESTOP: J9.1, U1A.13
GND: C1.2, C2.2, C3.2, C4.2, C5.2, C6.2, D2.1, D3.1, D4.2, DSG.1, IR1.2, J1.2, J2.2, J3.2, J3.4, J4.1, J5.1, J9.2, J11.1, J12.2, J12.7, J13.2, J14.1, J15.2, J16.1, J17.1, J18.2, J20.2, Q1.1, Q3.1, R8.1, R10.2, R12.2, TP1.1, U1A.1, U1A.2, U1A.22, U1B.1, U2.2, U2.8
IRIN: IR1.1, U1B.18
LED1_A: D2.2, R3.2
LED2_A: D3.2, R4.2
LEDGPIO: R4.1, U1B.14
MOTOR_EN: R11.1, U1A.15
NEO: J14.2, U1B.19
Q3_B: Q3.2, R11.2, R12.1
RLY_LOW: D5.2, J19.1, K1.2
RLY_SW: J19.2, Q3.3
RP_GATE: Q2.1, R10.1
RXA: R1.2, U1B.6
SCL1: J11.3, J12.3, U1B.12
SDA1: J11.4, J12.4, U1B.11
TEMP: DST.1, R6.2, U1B.17
VSNS: R7.2, R8.2, U1B.7
