Riyu-D1/Vector/firmware/joint-driver/joint_driver.ino

/*
 * joint_driver.ino — SOMA v3 joint drive firmware for the ST
 * B-G431B-ESC1 (STM32G431CB), one per cycloidal actuator (J2, J3).
 *
 * SimpleFOC-based re-implementation of the Berkeley Humanoid Lite
 * Recoil-Motor-Controller-BESC protocol (MIT licence — protocol shape
 * and CANopen-style ID layout kept compatible in spirit):
 *   11-bit CAN ID = (function_code << 7) | node_id
 *   RPDO2 0x300+id : fp32 pos + fp32 vel command (OUTPUT shaft, rad)
 *   TPDO2 0x280+id : fp32 pos + fp32 vel feedback
 *   RPDO3 0x400+id : fp32 feedforward OUTPUT torque (Nm) / iq cmd in
 *                    torque mode
 *   TPDO3 0x380+id : fp32 measured q-axis current (A)
 *   RSDO  0x600+id : param read/write (see sdo_addr_t in can_proto.h)
 *   TSDO  0x580+id : param read response (4 bytes)
 *   NMT   0x000    : byte0 cmd, byte1 node (0 = broadcast)
 *                    0=DISABLE 1=ENABLE 2=CALIBRATE 3=HOME 0x7F=ESTOP
 *   EMCY  0x080+id : fault report
 *
 * Motor: Tarot TL2955 4008 330KV on a 40:1 printed cycloidal. The AS5600
 * is on the MOTOR shaft (single-turn) — one output turn = 40 motor
 * turns, so the output position is NOT recoverable at boot: NMT_HOME
 * must run every power-up before NMT_ENABLE is accepted.
 *
 * Hardware (ST UM2516 + NuttX board doc — verified):
 *   6PWM : A_PHASE_UH/UL/VH/VL/WH/WL (PA8,PC13,PA9,PA12,PA10,PB15)
 *   shunt: 0.003 ohm, PGA gain 16 -> sense gain -9.14 (inverting)
 *   CAN  : PA11 RX, PB9 TX, onboard transceiver, PC14 = CAN_TERM(H=on)
 *   AS5600 on I2C1 PB6(SCL)/PB7(SDA) via the J8 sensor connector
 *          — UNVERIFIED: confirm J8 pin order against UM2516;
 *            alternative pair PB7(SDA)/PB8(SCL) also lands on J8.
 */
#include <SimpleFOC.h>
#include <Wire.h>
#include <EEPROM.h>
extern "C" {
#include "can_proto.h"    /* -I../shared via platformio.ini */
#include "can_proto.c"
}
#include "bus_can.h"

/* ------------------------------------------------------------ config */
#define DEVICE_CAN_ID   2           /* set per joint: 2=J2, 3=J3        */
/* last node on the bus terminates; J3 is last in the daisy chain */
#define CAN_TERM_LAST   (DEVICE_CAN_ID == CAN_NODE_J3)
#define POLE_PAIRS      7           /* 4008 assumed 12N14P -> 7 pp
                                     * UNVERIFIED — count rotor magnets */
#define GEAR_RATIO      40.0f       /* printed cycloidal 40:1           */
#define GEAR_EFF        0.7f        /* cycloidal efficiency UNVERIFIED  */
#define KT_MOTOR        0.0289f     /* Nm/A estimate for 4008 330KV     */
                                    /* (Kt ~= 60/(2*pi*KV)) UNVERIFIED  */
/* Torque envelope (cyclo4/STATUS-cyc4.md, D4): the printed discs hold
 * lobe SF >= 2 only while OUTPUT torque stays under the joint cap:
 *   T_out = I_phase x KT_MOTOR x GEAR_RATIO x GEAR_EFF <= TQ_CAP_NM
 *   J2 cap 3.0 N·m -> 3.71 A phase;  J3 cap 2.0 N·m -> 2.47 A phase.
 * Enforced HERE, not only by the host: CURRENT_LIMIT_A is a hard
 * ceiling — SDO_CURRENT_LIMIT_A writes and EEPROM values are clamped
 * to it, so no host command can exceed the disc envelope. */
#define TQ_CAP_NM       ((DEVICE_CAN_ID == CAN_NODE_J2) ? 3.0f : 2.0f)
#define CURRENT_LIMIT_A (TQ_CAP_NM / (KT_MOTOR * GEAR_RATIO * GEAR_EFF))
#define VOLTAGE_LIMIT   8.0f        /* of the 12 V rail                 */
/* Velocity cap — slow, smooth motion only (documented in
 * final/BUILD_GUIDE.md): 0.5 rad/s at the output (~29 deg/s; J2
 * end-to-end ~6.6 s) x 40 = 20 rad/s motor-side. */
#define VEL_LIMIT_OUT   0.5f        /* rad/s output-side cap            */
#define VEL_LIMIT_MOTOR (VEL_LIMIT_OUT * GEAR_RATIO)
/* Soft stop: on NMT_ESTOP / NMT_DISABLE / CAN heartbeat loss, ramp the
 * q-axis current to zero over ESTOP_RAMP_MS instead of a step cut — a
 * step off-load kicks an inertial torque spike through the discs. The
 * base node's K1 relay cut (MOTOR_EN) is independent and stays
 * instant; this ramp is what the firmware does with whatever rail
 * charge remains. */
#define ESTOP_RAMP_MS   75
#define CAN_HB_LOSS_MS  500         /* total bus silence while armed   */
#define POS_P_GAIN      20.0f       /* angle P gain (SimpleFOC units)   */
#define VEL_FF_GAIN     1.0f

/* homing: drive into the mechanical hard stop at low current, detect
 * stall, set output zero at the stop angle. Direction/signs are
 * per-joint UNVERIFIED — adjust after first bench run. */
#define HOME_DIR        (-1.0f)     /* -1 = toward the negative stop    */
#define HOME_CURRENT_A  1.0f        /* q-axis current while homing [U]  */
#define HOME_SPEED_OUT  0.15f       /* informational crawl, out rad/s   */
#define HOME_VEL_EPS    0.4f        /* |motor vel| below this = stall   */
#define HOME_STALL_MS   300         /* must stay stalled this long      */
#define HOME_TIMEOUT_MS 20000       /* give up -> EMCY                  */

#define FB_HZ           50          /* TPDO2/TPDO3 telemetry rate       */
#define CMD_TIMEOUT_MS  300         /* hold last pos if bus goes quiet  */

/* ------------------------------------------------------------ params */
typedef struct {
    uint32_t magic;          /* 'SOM2' = 0x324D4F53 (v2 layout)         */
    uint32_t can_id;
    float    zero_offset;    /* electrical zero (rad) from initFOC      */
    int32_t  direction;      /* +1 CW, -1 CCW                           */
    float    current_limit;
    float    gear_ratio;
    uint32_t calibrated;     /* nonzero once calibrate ran              */
    float    kp, kd;
    float    pos_lo, pos_hi;
    float    pos_zero;       /* output offset set by homing/ZERO_HERE   */
    float    home_stop;      /* output rad at the hard stop             */
    float    home_current;   /* iq while homing (A)                     */
    float    home_speed;     /* informational crawl (output rad/s)      */
} params_t;
static params_t P;

typedef enum { MODE_DISABLED = 0, MODE_POSITION, MODE_VELOCITY,
               MODE_TORQUE } run_mode_t;

static run_mode_t mode = MODE_DISABLED;
static bool   estop = false;
static bool   armed = false;
static bool   homed = false;         /* NOT persisted: re-home every boot */
static bool     softstop = false;    /* ESTOP_RAMP_MS decay in progress */
static uint32_t softstop_start_ms = 0;
static float    softstop_iq0 = 0.0f;
static float  cmd_pos = 0.0f, cmd_vel_ff = 0.0f;
static float  cmd_iq  = 0.0f;          /* torque-mode q-current setpoint */
static float  pos_zero = 0.0f;         /* output offset (home/ZERO_HERE) */
static uint32_t last_cmd_ms = 0, last_fb_ms = 0, last_rx_any_ms = 0;

/* homing state */
static bool     homing = false;
static uint32_t home_start_ms = 0, home_stall_ms = 0;

/* ------------------------------------------------------------ motor  */
#ifndef A_VBUS
#define A_VBUS PA0                  /* VBUS divider (NuttX board doc)   */
#endif

BLDCMotor motor = BLDCMotor(POLE_PAIRS);
BLDCDriver6PWM driver = BLDCDriver6PWM(A_PHASE_UH, A_PHASE_UL,
                                     A_PHASE_VH, A_PHASE_VL,
                                     A_PHASE_WH, A_PHASE_WL);
LowsideCurrentSense currentSense =
    LowsideCurrentSense(0.003f, -64.0f / 7.0f,   /* shunt, -9.14 gain   */
                        A_OP1_OUT, A_OP2_OUT, A_OP3_OUT);
MagneticSensorI2C sensor = MagneticSensorI2C(AS5600_I2C);

static float motor_iq_a = 0.0f;

/* ------------------------------------------------------------ flash  */
#define EEPROM_ADDR 0
void params_load(void) {
    EEPROM.get(EEPROM_ADDR, P);
    if (P.magic != 0x324D4F53) {
        memset(&P, 0, sizeof(P));
        P.magic         = 0x324D4F53;
        P.can_id        = DEVICE_CAN_ID;
        P.current_limit = CURRENT_LIMIT_A;
        P.gear_ratio    = GEAR_RATIO;
        P.kp            = POS_P_GAIN;
        P.kd            = 0.2f;
        /* soft limits from sim/STATUS-sim.md joint ranges;
         * home_stop defaults to the negative limit edge [U — the real
         * stop may sit short of it; measure on bench] */
        if (P.can_id == CAN_NODE_J2) {
            P.pos_lo = -2.0944f; P.pos_hi = 1.2217f;   /* -120..+70 deg */
        } else if (P.can_id == CAN_NODE_J3) {
            P.pos_lo = -3.1416f; P.pos_hi = 0.5236f;   /* -180..+30 deg */
        } else {
            P.pos_lo = -3.14f;   P.pos_hi = 3.14f;
        }
        P.pos_zero      = 0.0f;
        P.home_stop     = P.pos_lo;
        P.home_current  = HOME_CURRENT_A;
        P.home_speed    = HOME_SPEED_OUT;
    }
    /* the D4 torque cap is a ceiling the host can't raise: never trust
     * a stored value above it (flashes older than F1 wrote 5 A) */
    if (P.current_limit > CURRENT_LIMIT_A || P.current_limit <= 0.0f)
        P.current_limit = CURRENT_LIMIT_A;
}
void params_save(void) { EEPROM.put(EEPROM_ADDR, P); }

/* ------------------------------------------------------------ helpers */
/* SimpleFOC shaft_angle accumulates full rotations — the single-turn
 * AS5600 gives us a multi-turn MOTOR angle for free; homing fixes which
 * of the 40 motor turns per output turn we are on. */
static float output_pos(void)  { return motor.shaft_angle / P.gear_ratio
                                        - pos_zero; }
static float output_vel(void)  { return motor.shaft_velocity / P.gear_ratio; }

static void send_pdo2(void) {
    uint8_t b[8];
    uint8_t n = enc_tpdo2_state(b, output_pos(), output_vel());
    bus_can_send(can_id_make(CAN_FC_TPDO2, P.can_id), b, n);
}
static void send_pdo3(void) {
    uint8_t b[8];
    uint8_t n = enc_tpdo3_iq(b, motor_iq_a);
    bus_can_send(can_id_make(CAN_FC_TPDO3, P.can_id), b, n);
}
static void send_emcy(uint16_t code, uint8_t reg) {
    uint8_t b[8];
    uint8_t n = enc_emcy(b, code, reg);
    bus_can_send(can_id_make(CAN_FC_EMCY, P.can_id), b, n);
}
static void send_tsdo(const uint8_t val4[4]) {
    uint8_t b[8];
    uint8_t n = enc_tsdo_resp(b, val4);
    bus_can_send(can_id_make(CAN_FC_TSDO, P.can_id), b, n);
}

static void set_mode(run_mode_t m) {
    mode = m;
    switch (m) {
    case MODE_DISABLED:
        motor.disable();
        break;
    case MODE_POSITION:
        motor.controller = MotionControlType::angle;
        motor.target = motor.shaft_angle;   /* hold where we are */
        motor.enable();
        break;
    case MODE_VELOCITY:
        motor.controller = MotionControlType::velocity;
        motor.enable();
        break;
    case MODE_TORQUE:
        motor.controller = MotionControlType::torque;
        motor.enable();
        break;
    }
}

/* soft stop entry: keep the driver alive and let loop() ramp the
 * q-current to zero over ESTOP_RAMP_MS, THEN disable. Used by ESTOP,
 * DISABLE and CAN heartbeat loss so the discs never see a torque step.
 * If the drive is already off there is nothing to ramp. */
static void start_softstop(void) {
    armed = false;
    homing = false;
    if (softstop || mode == MODE_DISABLED) {
        set_mode(MODE_DISABLED);
        return;
    }
    softstop = true;
    softstop_start_ms = millis();
    softstop_iq0 = motor_iq_a;
    if (softstop_iq0 > P.current_limit) softstop_iq0 = P.current_limit;
    if (softstop_iq0 < -P.current_limit) softstop_iq0 = -P.current_limit;
    motor.controller = MotionControlType::torque;
    motor.enable();
    mode = MODE_TORQUE;             /* loop() drives the ramp */
}

static void do_estop(void) {
    estop = true;
    start_softstop();
}

static void do_enable(void) {
    if (P.calibrated == 0) {
        /* refuse: FOC has no electrical zero — would mis-commutate.
         * run NMT CALIBRATE first (rotor free), then ENABLE. */
        send_emcy(0x02, 0x10);
        return;
    }
    if (!homed) {
        /* refuse: single-turn encoder on the motor side can't tell
         * which output turn we're on — run NMT_HOME first */
        send_emcy(0x03, 0x11);
        return;
    }
    estop = false;
    armed = true;
    softstop = false;               /* abandon a ramp still in flight */
    set_mode(MODE_POSITION);
}

/* ------------------------------------------------------------ calib  */
static void do_calibrate(void) {
    /* rotor must be FREE TO SPIN — encoder direction + electrical zero */
    motor.sensor_direction = Direction::UNKNOWN;
    motor.zero_electric_angle = NOT_SET;
    motor.initFOC();                        /* runs alignment */
    P.zero_offset = motor.zero_electric_angle;
    P.direction   = (int32_t)motor.sensor_direction;
    P.calibrated  = 1;
    homed = false;                 /* calibration may shift the angle */
    params_save();
    motor.disable();               /* initFOC leaves the driver enabled;
                                    * torque off until NMT_HOME/ENABLE  */
    send_emcy(0x00, 0x00);            /* cal done "all clear" event */
}

/* ------------------------------------------------------------ homing */
/* NMT_HOME: crawl into the hard stop at HOME_DIR * home_current, wait
 * for a sustained stall, then declare the current output position to be
 * P.home_stop. Runs as a state machine so FOC + CAN stay alive. */
static void do_home(void) {
    if (P.calibrated == 0) {
        send_emcy(0x02, 0x10);        /* need FOC zero first */
        return;
    }
    homing = true;
    home_start_ms = millis();
    home_stall_ms = 0;
    armed = false;                  /* no position commands while homing */
    set_mode(MODE_TORQUE);
    motor.current_limit = P.home_current;
    motor.target = HOME_DIR * P.home_current;
}

static void home_tick(void) {
    if (!homing) return;
    uint32_t now = millis();
    if (now - home_start_ms > HOME_TIMEOUT_MS) {
        homing = false;
        motor.current_limit = P.current_limit;
        set_mode(MODE_DISABLED);
        send_emcy(0x04, 0x12);        /* homing timed out */
        return;
    }
    if (fabsf(motor.shaft_velocity) < HOME_VEL_EPS) {
        home_stall_ms += 1;           /* called once per loop iter */
        if (home_stall_ms > HOME_STALL_MS) {
            /* stall held: we are on the stop — pin the offset */
            pos_zero = motor.shaft_angle / P.gear_ratio - P.home_stop;
            P.pos_zero = pos_zero;
            homed = true;
            homing = false;
            motor.current_limit = P.current_limit;
            params_save();
            set_mode(MODE_DISABLED);  /* torque off until explicit
                                         * NMT_ENABLE (W2 rule) */
            send_emcy(0x00, 0x13);    /* homed ok */
        }
    } else {
        home_stall_ms = 0;
    }
}

/* ------------------------------------------------------------ SDO     */
static void sdo_write(uint16_t addr, const uint8_t val4[4]) {
    switch (addr) {
    case SDO_CURRENT_LIMIT_A:
        P.current_limit = get_f32(val4);
        if (P.current_limit > CURRENT_LIMIT_A)
            P.current_limit = CURRENT_LIMIT_A;  /* hard ceiling (D4) */
        if (P.current_limit < 0.0f) P.current_limit = 0.0f;
        if (!homing) motor.current_limit = P.current_limit;
        break;
    case SDO_POLE_PAIRS:
        /* pole pairs is a constructor arg — needs reflash; store for
         * record and report in SDO reads */
        break;
    case SDO_GEAR_RATIO:     P.gear_ratio = get_f32(val4); break;
    case SDO_CAN_NODE_ID:    P.can_id = get_u32(val4) & 0x7F; break;
    case SDO_KP:             P.kp = get_f32(val4); motor.P_angle.P = P.kp; break;
    case SDO_KD:             P.kd = get_f32(val4); break;
    case SDO_POS_LIMIT_LO:   P.pos_lo = get_f32(val4); break;
    case SDO_POS_LIMIT_HI:   P.pos_hi = get_f32(val4); break;
    case SDO_CALIBRATE:      if (get_u32(val4)) do_calibrate(); break;
    case SDO_ZERO_HERE:
        if (get_u32(val4)) {
            /* make the CURRENT output position read as zero */
            pos_zero = motor.shaft_angle / P.gear_ratio;
            P.pos_zero = pos_zero;
            cmd_pos = 0;
            motor.target = motor.shaft_angle;   /* hold still */
        }
        break;
    case SDO_SAVE_FLASH:
        if (get_u32(val4) == 0x53515645) params_save();
        break;
    case SDO_HOME_STOP_RAD:  P.home_stop = get_f32(val4); break;
    case SDO_HOME_CURRENT_A: P.home_current = get_f32(val4); break;
    case SDO_HOME_SPEED_RADS: P.home_speed = get_f32(val4); break;
    default: break;
    }
}

static void sdo_read(uint16_t addr) {
    uint8_t b[4] = {0, 0, 0, 0};
    switch (addr) {
    case SDO_CURRENT_LIMIT_A: put_f32(b, P.current_limit); break;
    case SDO_POLE_PAIRS:      put_u32(b, POLE_PAIRS); break;
    case SDO_GEAR_RATIO:      put_f32(b, P.gear_ratio); break;
    case SDO_ENCODER_OFFSET:  put_f32(b, P.zero_offset); break;
    case SDO_CAN_NODE_ID:     put_u32(b, P.can_id); break;
    case SDO_KP:              put_f32(b, P.kp); break;
    case SDO_KD:              put_f32(b, P.kd); break;
    case SDO_POS_LIMIT_LO:    put_f32(b, P.pos_lo); break;
    case SDO_POS_LIMIT_HI:    put_f32(b, P.pos_hi); break;
    case SDO_TEMPERATURE_C:   put_f32(b, 0.0f); /* TODO: PA5? sensor */
        break;
    case SDO_BUS_VOLTAGE_V: {
        float vbus = analogRead(A_VBUS) * (3.3f / 4096.0f) * 10.4f;
        put_f32(b, vbus);
        break;
    }
    case SDO_FW_VERSION:      put_u32(b, 0x000200); break;
    case SDO_STATUS: {
        uint32_t s = 0;
        if (armed) s |= 0x1;
        if (estop) s |= 0x2;
        if (P.calibrated) s |= 0x4;
        if (homed) s |= 0x10;
        put_u32(b, s);
        break;
    }
    case SDO_VELOCITY_RADS:   put_f32(b, output_vel()); break;
    case SDO_IQ_MEAS_A:       put_f32(b, motor_iq_a); break;
    case SDO_HOME_STOP_RAD:   put_f32(b, P.home_stop); break;
    case SDO_HOME_CURRENT_A:  put_f32(b, P.home_current); break;
    case SDO_HOME_SPEED_RADS: put_f32(b, P.home_speed); break;
    default: break;
    }
    send_tsdo(b);
}

/* ------------------------------------------------------------ CAN rx  */
static void handle_frame(uint16_t id, const uint8_t *d, uint8_t dlc) {
    uint8_t fc = can_id_fc(id);
    uint8_t node = can_id_node(id);
    last_rx_any_ms = millis();

    if (fc == CAN_FC_NMT) {
        uint8_t cmd, target;
        if (dec_nmt(d, dlc, &cmd, &target) != 0) return;
        if (target != 0 && target != P.can_id) return;  /* not for us */
        switch (cmd) {
        case NMT_DISABLE:   start_softstop(); break;
        case NMT_ENABLE:    do_enable(); break;
        case NMT_CALIBRATE: do_calibrate(); break;
        case NMT_HOME:      do_home(); break;
        case NMT_ESTOP:     do_estop(); break;
        }
        return;
    }
    if (node != P.can_id) return;                     /* addressed msgs */

    switch (fc) {
    case CAN_FC_RPDO1: {                              /* ping -> echo   */
        bus_can_send(can_id_make(CAN_FC_TPDO1, P.can_id), d, dlc);
        break;
    }
    case CAN_FC_RPDO2: {
        float pos, vel;
        if (dec_pdo2(d, dlc, &pos, &vel) != 0) break;
        last_cmd_ms = millis();
        cmd_pos = pos;
        cmd_vel_ff = vel;
        if (armed && !estop) {
            if (mode != MODE_POSITION) set_mode(MODE_POSITION);
            float p = pos;
            if (p < P.pos_lo) p = P.pos_lo;
            if (p > P.pos_hi) p = P.pos_hi;
            /* command frame is in user coordinates (pos_zero applied);
             * motor side = output * 40 */
            motor.target = (p + pos_zero) * P.gear_ratio;
            motor.feed_forward_velocity = vel * P.gear_ratio * VEL_FF_GAIN;
        }
        break;
    }
    case CAN_FC_RPDO3: {
        float tau;
        if (dec_pdo3(d, dlc, &tau) != 0) break;
        /* OUTPUT torque Nm -> motor q-current:
         * tau_out = iq * Kt * ratio * eff  =>  iq = tau/(Kt*r*eff) */
        cmd_iq = tau / (P.gear_ratio * GEAR_EFF * KT_MOTOR);
        if (armed && !estop && mode == MODE_TORQUE) {
            if (cmd_iq > P.current_limit) cmd_iq = P.current_limit;
            if (cmd_iq < -P.current_limit) cmd_iq = -P.current_limit;
            motor.target = cmd_iq;
        }
        break;
    }
    case CAN_FC_RSDO: {
        uint8_t scmd; uint16_t addr; uint8_t val4[4];
        if (dec_rsdo_req(d, dlc, &scmd, &addr, val4) != 0) break;
        if (scmd == SDO_CMD_DOWNLOAD) sdo_write(addr, val4);
        else if (scmd == SDO_CMD_UPLOAD) sdo_read(addr);
        break;
    }
    default: break;
    }
}

/* ------------------------------------------------------------ arduino */
void setup() {
    params_load();
    if (P.can_id == 0 || P.can_id > 0x7F) P.can_id = DEVICE_CAN_ID;

    bus_can_init(CAN_TERM_LAST);

    /* AS5600 on I2C1 PB6(SCL)/PB7(SDA) at the J8 sensor connector */
    Wire.setSCL(PB6);
    Wire.setSDA(PB7);
    Wire.begin();
    sensor.init(&Wire);
    motor.linkSensor(&sensor);

    driver.voltage_power_supply = 12;
    driver.init();
    motor.linkDriver(&driver);

    currentSense.linkDriver(&driver);
    currentSense.init();
    currentSense.skip_align = true;
    motor.linkCurrentSense(&currentSense);

    motor.voltage_sensor_align = 2;
    motor.voltage_limit = VOLTAGE_LIMIT;
    motor.current_limit = P.current_limit;
    motor.velocity_limit = VEL_LIMIT_MOTOR;
    motor.controller = MotionControlType::angle;
    motor.P_angle.P = P.kp;
    motor.PID_velocity.P = 0.2f;
    motor.PID_velocity.I = 20.0f;
    motor.foc_modulation = FOCModulationType::SpaceVectorPWM;

    motor.init();
    if (P.calibrated) {
        /* skip the rotation alignment: preset stored values, initFOC()
         * sees them and skips re-aligning */
        motor.sensor_direction = (Direction)P.direction;
        motor.zero_electric_angle = P.zero_offset;
        motor.initFOC();
    }
    /* else: stays un-FOC'd until NMT_CALIBRATE runs on the bench */

    /* power up torque-DISABLED: the rail can close at any moment
     * (two-phase MOTOR_EN arm) — no PWM may reach the motor until an
     * explicit NMT_ENABLE (gated on calibrated + homed in do_enable).
     * initFOC()/init() can leave the driver hot; force it off and keep
     * loopFOC() inert via the enabled flag (mode = MODE_DISABLED). */
    motor.disable();

    last_cmd_ms = last_fb_ms = last_rx_any_ms = millis();
    pos_zero = P.pos_zero;
}

void loop() {
    /* FOC at full rate */
    motor.loopFOC();
    if (softstop) {
        /* linear q-current decay to zero over ESTOP_RAMP_MS */
        uint32_t el = millis() - softstop_start_ms;
        float k = (el >= ESTOP_RAMP_MS) ? 0.0f
                  : 1.0f - (float)el / (float)ESTOP_RAMP_MS;
        motor.target = softstop_iq0 * k;
        motor.move();
        if (k == 0.0f) {
            softstop = false;
            set_mode(MODE_DISABLED);    /* final cut after the ramp */
        }
    } else if (mode == MODE_TORQUE && homing) {
        motor.move();               /* iq = HOME_DIR * home_current */
    } else if (armed && !estop && mode != MODE_DISABLED) {
        motor.move();
    }

    /* measure iq for telemetry + stall detect (cheap, non-blocking) */
    if (armed || homing) {
        DQCurrent_s c = currentSense.getFOCCurrents(motor.electrical_angle);
        motor_iq_a = c.q;
    }
    home_tick();

    /* CAN RX — drain FIFO */
    uint16_t id; uint8_t d[8]; uint8_t dlc;
    while (bus_can_recv(&id, d, &dlc)) handle_frame(id, d, dlc);

    uint32_t now = millis();

    /* command watchdog: quiet bus -> hold position (never torque-off
     * under load silently — the arm would drop) */
    if (armed && !estop && (now - last_cmd_ms) > CMD_TIMEOUT_MS &&
        mode == MODE_POSITION) {
        motor.target = motor.shaft_angle;   /* freeze where we are */
    }

    /* CAN heartbeat loss: total bus silence while armed -> same soft
     * stop as ESTOP (the base node's own watchdog is independent) */
    if (armed && !estop && (now - last_rx_any_ms) > CAN_HB_LOSS_MS) {
        do_estop();
        send_emcy(0x05, 0x14);          /* bus heartbeat lost */
    }

    /* telemetry */
    if (armed && (now - last_fb_ms) >= (1000 / FB_HZ)) {
        last_fb_ms = now;
        send_pdo2();
        send_pdo3();
    }
}
