Riyu-D1/Vector/cad/arm/arm_params.py

"""SOMA arm v3 — structure parameters (Stream B).

Every dimension comes from a cited source or a measurement from a STEP
file; anything else is marked UNVERIFIED/ASSUMED and made adjustable.

Frame: Z up, origin at the drum-centre on the recess floor of the case lid.
Arm chain: J1 yaw (vertical actuator) -> J2 shoulder (horizontal actuator)
-> J3 elbow (horizontal actuator) -> J4 wrist pitch + J5 wrist roll
(STS3215) -> J6 gripper (STS3215, compact jaw).

Sources:
  [CASE]   cad/lib/case.py (drum recess geometry, lid, M4 post holes)
  [WV]     Waveshare ST3215 drawing, ST3215-2D.zip (verified hole grid)
  [SO102]  SO-ARM-102 STEP parts, measured (servo body, horn/idler dims,
           gripper concept, joint limits)
  [V3]     ARM_HYBRID_V3.md (actuator choice, link lengths, loads)
  [ASSUME] Placeholder actuator interface until Stream A publishes
           cad/actuator/INTERFACE.md on branch arm-actuator
"""
from dataclasses import dataclass, field


# ---------------------------------------------------------------------------
# Stream A actuator — cad/actuator/INTERFACE.md v0.2 (branch arm-actuator).
# Bold/frozen numbers from the contract; a few mm may still move — this
# block is the single point to update.
# ---------------------------------------------------------------------------
@dataclass(frozen=True)
class ActuatorSpec:
    name: str = "cycloidal-5010 (Stream A, IFACE v0.2)"
    body_d: float = 70.0        # [IFACE] FROZEN: cylindrical shell OD
    body_l: float = 85.5        # [IFACE] FROZEN: rear cap face -> flange face
    mass_g: float = 510.0       # [IFACE] ~0.51 kg all-in
    # Output (driven) face: bolt circle that carries the next link.
    out_pcd: float = 44.0       # [IFACE] FROZEN: 8xM3 on 44 mm BCD
    out_bolts: int = 8
    out_bolt_d: float = 3.4     # M3 clearance (screws M3x8, depth 6)
    out_flange_d: float = 50.0  # [IFACE] output flange OD
    out_pilot_d: float = 45.0   # [IFACE] centre pilot boss OD (centring)
    out_pilot_h: float = 1.0    # [IFACE] boss proud of flange face
    out_face_clear_d: float = 51.0  # [IFACE] driven-link mating pocket >=51
    # Body (fixed) face: rear cap 4xM3 on 64 BCD, or shell clamp (used).
    fix_pcd: float = 64.0       # [IFACE] 4xM3 on Ø64 back face
    fix_bolts: int = 4
    fix_bolt_d: float = 3.4     # M3 clearance
    cable_exit_w: float = 8.0   # [IFACE] radial slot at shell rear rim
    cable_exit_h: float = 6.0   #   8 mm wide x 6 mm tall, ~2.5 above rear face
    cable_keepout: float = 10.0 # [IFACE] keep-out sector around the slot
    # torque capability (for the margin report; Stream A owns the number)
    rated_nm: float = 7.9       # [IFACE] ~7.9 N.m peak
    stall_nm: float = 12.0      # [ASSUME] UNVERIFIED


ACTUATOR = ActuatorSpec()


# ---------------------------------------------------------------------------
# Feetech STS3215 12 V — VERIFIED geometry from the SO-ARM-102 assembly STEP
# (servo solid) + Waveshare ST3215 drawing.
#   local axes of the servo model: X = 45.2 length, Y = shaft axis, Z = 24.7
#   Output (horn) face near +Y end; back boss face near -Y end.
#   The two end faces carry DIFFERENT M2 self-tap grids (both in the DXF):
#     24.45 x 20.5 on one face, 20.7 x 20.5 on the other — I use 24.45 grid
#     as the primary mount like the guide says.
# ---------------------------------------------------------------------------
@dataclass(frozen=True)
class ServoSpec:
    name: str = "STS3215-12V"
    body_l: float = 45.2        # [WV][SO102] along X of servo model
    body_t: float = 24.7        # [WV][SO102] thickness
    body_h: float = 35.0        # [WV] case height between end faces
    wheel_d: float = 19.2       # [SO102] output boss OD
    wheel_h: float = 4.5        # [SO102] boss height above output face
    stub_d: float = 19.2        # [SO102] back idler boss OD
    stub_h: float = 3.4         # [SO102]
    axis_to_end: float = 42.5   # [SO102] total height incl. wheels (35+4.5+3.4~43)
    horn_screw_d: float = 3.2   # [SO102] horn centre screw M3
    mass_g: float = 55.0        # [WV]
    stall_kgcm: float = 30.0    # [WV] 30 kg.cm @12 V
    rated_kgcm: float = 10.0    # ~1 N.m usable continuous (BOM.md estimate)
    volts: float = 12.0
    # verified mounting grids (Ø1.6 self-tap, use M2 screws into them)
    hole_d: float = 1.6         # [WV]
    grid_a: tuple = (24.45, 20.5)   # [WV] primary face (guide's pattern)
    grid_b: tuple = (20.7, 20.5)    # [WV] opposite face


SERVO = ServoSpec()
# pocket clearance applied to the servo envelope (guide: >=0.3 mm)
SERVO_CLEAR = 0.35


# ---------------------------------------------------------------------------
# Joint limits — adopted from SO-ARM-102 specs (proven limits for this servo
# family); J2/J3 use the actuators' own limits once Stream A reports them.
# ---------------------------------------------------------------------------
@dataclass(frozen=True)
class JointSpec:
    name: str
    kind: str                    # "actuator" or "servo"
    range_deg: tuple             # (min, max) in degrees
    axis: tuple                  # unit axis in parent-link frame


# Link-frame conventions: every link's local frame has X along the link
# (proximal->distal joint), Z up at zero pose.
JOINTS = {
    # J1 yaw: actuator vertical, +Z.  [SO102] base rotation +-176 deg.
    "J1": JointSpec("waist yaw",  "actuator", (-170.0, 170.0), (0, 0, 1)),
    # J2 shoulder: axis +Y.  Measured clean sweep -72..+36 (2026-10-27,
    # checks.py c6 method): up end -75 hits turret cap, down end +37
    # clips bearing_cap/housing.  Adopted -70..+35 with margin.
    # Deeper down-travel is impossible: at +90 the J3 actuator folds
    # into the Ø110 housing — needs J2_Z ~+110 mm taller.
    "J2": JointSpec("shoulder",   "actuator", (-70.0, 35.0), (0, 1, 0)),
    # J3 elbow: axis +Y.  Limited by the forearm webs sweeping into the
    # upper-link saddle web beyond ~+-100; verified +-90.
    "J3": JointSpec("elbow",      "actuator", (-90.0, 90.0), (0, 1, 0)),
    # J4 wrist pitch: axis +Y.  [SO102] -99..+97 deg.
    "J4": JointSpec("wrist pitch", "servo",   (-95.0, 95.0),   (0, 1, 0)),
    # J5 wrist roll: axis +X.  [SO102] -165..+163 deg.
    "J5": JointSpec("wrist roll",  "servo",   (-160.0, 160.0), (1, 0, 0)),
    # J6 gripper: servo drives jaws; +-90 travel.
    "J6": JointSpec("gripper",     "servo",   (-90.0, 90.0),   (0, 1, 0)),
}


# ---------------------------------------------------------------------------
# Links — [V3]: shoulder->elbow 120, elbow->wrist 100, wrist->tool 40.
# ---------------------------------------------------------------------------
@dataclass(frozen=True)
class LinkSpec:
    l_upper: float = 120.0      # J2 axis -> J3 axis              [V3]
    l_fore: float = 100.0       # J3 axis -> J4 axis              [V3]
    l_tool: float = 55.0        # J4 axis -> gripper tip; V3 asks 40 mm —
                                # physically impossible below ~50 with a
                                # servo-driven jaw; marked in docs.
    j2_rise: float = 105.0      # J1 seat -> J2 axis height (turret)
    reach_target: float = 260.0 # [V3]
    payload_g: float = 250.0    # [V3] design payload
    payload_check_g: tuple = (300.0, 500.0)   # report both margins


LINKS = LinkSpec()


# ---------------------------------------------------------------------------
# Kinematics chain — SINGLE SOURCE OF TRUTH for the numbers the Orange Pi
# software and the firmware must share (cad/arm/gen_params.py turns this
# block + JOINTS into soma_arm/arm_geometry.py and
# firmware/shared/arm_params_gen.h).
#
# Frames: arm frame = origin at drum centre, Z up, +X = reach direction.
# CAD joint sign convention: pitch joints (J2/J3/J4) rotate about +Y —
# a POSITIVE angle pitches the link DOWN toward the table (matches
# parts.py/checks.py).  The host/firmware convention is the opposite
# (positive = elevation up); gen_params.py does the sign flip.
# ---------------------------------------------------------------------------
@dataclass(frozen=True)
class KinSpec:
    j2_z: float = 146.0        # J2 (and J3/J4) pitch-axis height  [parts.py]
    l_upper: float = 120.0     # J2 axis -> J3 axis  (keep == LINKS.l_upper)
    l_fore: float = 100.0      # J3 axis -> J4 axis  (keep == LINKS.l_fore)
    j5_dx: float = 51.0        # J4 axis -> J5 roll axis along link X
    tip_dx: float = 127.7      # J4 axis -> gripper tip (rail end; = J5_X +
                             # WR_IN + 4 + RAIL_L - J4_X, measures ~348 mm
                             # tip x from the J1 axis at home)
    home_deg: tuple = (0.0, 0.0, 0.0, 0.0, 0.0, 0.0)
                             # home = all joints zero: arm extended
                             # horizontally along +X (the CAD build pose)
    # table/case guard, CAD frame (deg): the wrist stays above the
    # table/lid while   J3 <= GUARD_A_DEG - GUARD_B * J2.
    # Measured boundary in checks.py c7 (raw ranges would fold the
    # wrist below the table near J2+J3 ~ +45).
    guard_a_deg: float = 45.0
    guard_b: float = 2.0


KIN = KinSpec()


# ---------------------------------------------------------------------------
# Bearings (standard sizes, code -> (bore, OD, width))
# ---------------------------------------------------------------------------
BEARINGS = {
    "608":  (8.0, 22.0, 7.0),    # idler pivots
    "6804": (20.0, 32.0, 7.0),   # joint back-side idler
    "6812": (60.0, 78.0, 10.0),  # J1 turntable — bore must clear the
                                # Ø50 output flange + PCD44 bolt circle
    "MF106": (6.0, 10.0, 3.0),   # gripper rods          [SO102]
}


# ---------------------------------------------------------------------------
# Case interface — [CASE] from cad/lib/case.py (do not modify the case)
# ---------------------------------------------------------------------------
@dataclass(frozen=True)
class CaseSpec:
    drum_d: float = 132.0        # arm drum lands in this recess
    recess_depth: float = 2.5    # seat depth into the 4 mm lid
    lid_t: float = 4.0
    lid_top_z: float = 40.0      # case coords: top of lid
    drum_cxy: tuple = (75.0, 88.0)   # drum centre in case coords
    # M4 hold-down posts inside the drum circle (case coords)
    posts: tuple = ((40, 132), (110, 132), (45, 145), (105, 145), (75, 143))
    post_hole_d: float = 4.4     # lid M4 clearance
    # rear cable channel in the tray wall (case coords) at y~157, z~27
    cable_channel_z: float = 27.0


CASE = CaseSpec()

# drum post positions in ARM coords (x = case_x-75, y = case_y-88)
DRUM_POSTS = tuple((x - CASE.drum_cxy[0], y - CASE.drum_cxy[1])
                   for x, y in CASE.posts)


# ---------------------------------------------------------------------------
# Tolerances / print rules
# ---------------------------------------------------------------------------
@dataclass(frozen=True)
class TolSpec:
    press: float = -0.05
    slip: float = 0.15
    loose: float = 0.30
    servo: float = SERVO_CLEAR
    min_wall: float = 1.6        # [GUIDE] minimum wall check
    wall: float = 2.4
    insert_m3_d: float = 4.6     # M3 heat-set insert bore (typ. 4.2-4.8)
    insert_m4_d: float = 5.6     # M4 heat-set insert bore


TOL = TolSpec()


# ---------------------------------------------------------------------------
# Wiring
# ---------------------------------------------------------------------------
@dataclass(frozen=True)
class CableSpec:
    """Bundle through the arm: CAN to J1-J3 + 12V pair + servo bus to J4-6."""
    n_wires: int = 8
    wire_d: float = 1.8          # ~22 AWG silicone
    channel_w: float = 8.0       # [GUIDE] min channel 8x6 per link
    channel_h: float = 6.0
    slip_d: float = 14.0         # hole through bearing centre for bundle


CABLE = CableSpec()
