Riyu-D1/Vector/cad/arm/gen_params.py

"""Generate shared arm parameters from arm_params.py (single source).

Run:  python3 cad/arm/gen_params.py          (pure stdlib, no build123d)

Outputs:
  software/robot-os/soma_arm/arm_geometry.py   Python constants (m, rad)
  firmware/shared/arm_params_gen.h             C constants (rad, fp32)

Convention bridge — the CAD frame uses +Y pitch rotations, so a positive
J2/J3/J4 angle pitches the link DOWN toward the table; the host/firmware
frame uses elevation-positive pitch.  This script emits HOST-frame values:
q_host = -q_cad for the pitch joints (J2, J3, J4).  The table/case guard

    CAD : J3 <=  A - B*J2            (KIN.guard_a_deg, KIN.guard_b)
    HOST: q3 >= -A - B*q2            (a negative lower bound on q3)
"""
import math
import os
import sys

HERE = os.path.dirname(os.path.abspath(__file__))
REPO = os.path.dirname(os.path.dirname(HERE))          # repo root
sys.path.insert(0, HERE)

from arm_params import JOINTS, KIN                      # noqa: E402

ORDER = ["J1", "J2", "J3", "J4", "J5", "J6"]
PITCH = {"J2", "J3", "J4"}                            # +Y axes, flipped


def host_limits_deg():
    """-> [(min_deg, max_deg) per joint] in the elevation-positive frame."""
    out = []
    for name in ORDER:
        lo, hi = JOINTS[name].range_deg
        if name in PITCH:
            lo, hi = -hi, -lo
        out.append((lo, hi))
    return out


def header_text(limits):
    guard_a = -KIN.guard_a_deg                        # host q3 >= a + b*q2
    guard_b = -KIN.guard_b
    lines = [
        "/* GENERATED by cad/arm/gen_params.py from cad/arm/arm_params.py",
        " * — do not edit by hand; rerun the generator.",
        " *",
        " * Host-frame joint vector (elevation-positive pitch), output",
        " * shaft radians.  J6 = gripper servo shaft.",
        " */",
        "#pragma once",
        "",
        "#define ARM_N_JOINTS 6",
        "",
        "static const float ARM_JOINT_MIN_RAD[ARM_N_JOINTS] = {",
    ]
    for (lo, hi), name in zip(limits, ORDER):
        lines.append(f"    {math.radians(lo):+.6f}f,   /* {name}: {lo:+.1f}..{hi:+.1f} deg */")
    lines += [
        "};",
        "static const float ARM_JOINT_MAX_RAD[ARM_N_JOINTS] = {",
    ]
    for (lo, hi), name in zip(limits, ORDER):
        lines.append(f"    {math.radians(hi):+.6f}f,   /* {name} */")
    lines += [
        "};",
        "",
        "/* home pose: all zeros — arm horizontal along +X (CAD build pose) */",
        "static const float ARM_Q_HOME[ARM_N_JOINTS] = { 0.0f, 0.0f, 0.0f,",
        "                                              0.0f, 0.0f, 0.0f };",
        "",
        "/* table/case guard (host frame): q3 >= ARM_GUARD_A + ARM_GUARD_B*q2.",
        " * CAD frame equivalent: J3 <= 45 - 2*J2 (cad/arm/arm_params.py KIN).",
        " */",
        f"#define ARM_GUARD_A  ({math.radians(guard_a):+.6f}f)   /* -45 deg */",
        f"#define ARM_GUARD_B  ({guard_b:+.6f}f)",
        "",
        "/* geometry (metres) — J2 axis height, link lengths J2->J3->J4->tip */",
        f"#define ARM_BASE_Z_M   {KIN.j2_z / 1000.0:.5f}f",
        f"#define ARM_L1_M       {KIN.l_upper / 1000.0:.5f}f",
        f"#define ARM_L2_M       {KIN.l_fore / 1000.0:.5f}f",
        f"#define ARM_L3_M       {KIN.tip_dx / 1000.0:.5f}f",
        "",
    ]
    return "\n".join(lines)


def python_text(limits):
    guard_a = -KIN.guard_a_deg
    guard_b = -KIN.guard_b
    out = [
        '"""GENERATED by cad/arm/gen_params.py from cad/arm/arm_params.py',
        "— do not edit by hand; rerun the generator.",
        "",
        "Host-frame constants (elevation-positive pitch): metres + radians.",
        "CAD-frame equivalents live in cad/arm/arm_params.py (KIN + JOINTS).",
        '"""',
        "",
        "import math",
        "",
        "# joint order J1..J6; J6 = gripper servo shaft",
        "JOINT_MIN_DEG = [",
    ]
    for (lo, hi), name in zip(limits, ORDER):
        out.append(f"    {lo:+.1f},   # {name}")
    out += [
        "]",
        "JOINT_MAX_DEG = [",
    ]
    for (lo, hi), name in zip(limits, ORDER):
        out.append(f"    {hi:+.1f},   # {name}")
    out += [
        "]",
        "",
        "JOINT_MIN = [math.radians(v) for v in JOINT_MIN_DEG]",
        "JOINT_MAX = [math.radians(v) for v in JOINT_MAX_DEG]",
        "",
        "# home pose: all zeros — arm horizontal along +X (CAD build pose)",
        "HOME_Q = [0.0] * 6",
        "",
        "# table/case guard (host frame): q3 >= GUARD_Q3_A + GUARD_Q3_B * q2",
        f"GUARD_Q3_A = math.radians({guard_a:+.1f})   # -45 deg",
        f"GUARD_Q3_B = {guard_b:+.1f}",
        "",
        "# geometry (metres): J2 pitch-axis height + link lengths",
        f"BASE_Z = {KIN.j2_z / 1000.0:.6f}   # J2/J3/J4 axis height",
        f"L1 = {KIN.l_upper / 1000.0:.6f}    # J2 -> J3",
        f"L2 = {KIN.l_fore / 1000.0:.6f}    # J3 -> J4",
        f"L3 = {KIN.tip_dx / 1000.0:.6f}  # J4 -> gripper tip",
        "",
    ]
    return "\n".join(out)


def main():
    limits = host_limits_deg()
    py = os.path.join(REPO, "software", "robot-os", "soma_arm",
                      "arm_geometry.py")
    hh = os.path.join(REPO, "firmware", "shared", "arm_params_gen.h")
    with open(py, "w") as f:
        f.write(python_text(limits))
    with open(hh, "w") as f:
        f.write(header_text(limits))
    print(f"wrote {os.path.relpath(py, REPO)}")
    print(f"wrote {os.path.relpath(hh, REPO)}")
    for (lo, hi), name in zip(limits, ORDER):
        print(f"  {name}: host [{lo:+.1f}, {hi:+.1f}] deg")
    print(f"  guard (host): q3 >= {-KIN.guard_a_deg:+.1f} "
          f"{-KIN.guard_b:+.1f}*q2  [deg]")
    print(f"  BASE_Z={KIN.j2_z}mm L1={KIN.l_upper} L2={KIN.l_fore} "
          f"L3={KIN.tip_dx} (tip x ~{KIN.l_upper + KIN.l_fore + KIN.tip_dx:.0f}mm)")


if __name__ == "__main__":
    main()
