Riyu-D1/Vector/cad/actuator/check.py

"""Verification suite for the actuator CAD.

Run:  python3 check.py            (writes docs/actuator-verification.md)
      python3 check.py --fast     (coarse sweep, quicker)

Checks (per ARM_HYBRID_V3 Stream A):
1. watertight STLs in export/
2. interference of the assembled gearbox through a full rotation
3. disc geometry: simple profile (no undercut), pin contact, hole walls
4. mass estimate
5. generated profile vs the Onshape 5010_profile.dxf (design fidelity)
"""

import os
import math
import json
import numpy as np
from build123d import Pos, Rot

from params import P, MR106, B6701, B6809
import cycloid
import parts as pt

HERE = os.path.dirname(os.path.abspath(__file__))
EXPORT = os.path.join(HERE, "export")
OUT_MD = os.path.join(HERE, "..", "..", "docs", "actuator-verification.md")

REPORT = []


def say(s=""):
    print(s)
    REPORT.append(s)


# ---------------------------------------------------------------------------
# 1. watertight
# ---------------------------------------------------------------------------

def check_watertight():
    import trimesh
    say("## 1. Watertight STLs\n")
    say("| part | faces | watertight | volume cm3 |")
    say("|---|---|---|---|")
    for f in sorted(os.listdir(EXPORT)):
        if not f.endswith(".stl") or f.startswith("_"):
            continue
        m = trimesh.load(os.path.join(EXPORT, f))
        vol = m.volume / 1000.0 if m.is_watertight else float("nan")
        say(f"| {f} | {len(m.faces)} | {m.is_watertight} | {vol:.1f} |")
    say("")


# ---------------------------------------------------------------------------
# 2. rotation interference
# ---------------------------------------------------------------------------

def posed_parts(input_deg):
    """The moving solids of the gearbox at a given input angle."""
    g = P.gear
    a = math.radians(input_deg)
    ex, ey, phi = cycloid.disc_pose(a, g)
    out_deg = math.degrees(-a / g.disc_lobes)
    moving = {}
    moving["disc1"] = Pos(ex, ey, pt.Z_DISC1) * \
        Rot(0, 0, math.degrees(phi)) * pt.cycloidal_disc()
    moving["disc2"] = Pos(-ex, -ey, pt.Z_DISC2) * \
        Rot(0, 0, math.degrees(phi) + 180.0) * pt.cycloidal_disc()
    moving["input_shaft"] = Rot(0, 0, input_deg) * pt.input_shaft()
    moving["output_shaft"] = Rot(0, 0, out_deg) * pt.output_shaft()
    return moving


def _disc_poly(gear):
    """Shapely polygon of the manufactured disc: outline + bore + 6 holes."""
    from shapely.geometry import Point, Polygon
    xs, ys = cycloid.disc_profile(4000, gear)
    bore_r = (B6701.od - pt.PRESS) / 2
    hole_d = MR106.od + 2 * gear.eccentricity + 0.3
    t = np.linspace(0, 2 * np.pi, 128, endpoint=False)
    holes = [np.column_stack([bore_r * np.cos(t), bore_r * np.sin(t)])]
    bcd = P.out_pin_bcd / 2
    for i in range(6):
        a = math.radians(60 * i)
        holes.append(np.column_stack(
            [bcd * math.cos(a) + hole_d / 2 * np.cos(t),
             bcd * math.sin(a) + hole_d / 2 * np.sin(t)]))
    return Polygon(np.column_stack([xs, ys]), holes=holes)


def check_interference(samples=48, brep_angles=4):
    """Interference sweep over one full input revolution.

    Every meshing pair is prismatic (extruded 2D), so the check is done in
    the plane with shapely (exact for this geometry, and fast enough for a
    fine sweep).  A BREP boolean spot-check on the worst ring-pin pair
    cross-validates the 2D model.
    """
    from shapely.geometry import Point
    from shapely.affinity import rotate, translate
    say("## 2. Rotation interference sweep\n")
    say("All meshing pairs are prismatic -> checked as 2D intersections "
        "x disc thickness at each sampled input angle, cross-validated by "
        "a BREP boolean on the worst pair.  Output-pin overlap counts the "
        "pin annulus (pin OD minus its M3 hole).\n")
    g = P.gear
    disc0 = _disc_poly(g)
    px, py = cycloid.pin_centres(g)
    ring_pins = [Point(x, y).buffer(g.pin_radius, quad_segs=64)
                 for x, y in zip(px, py)]
    rb = P.out_pin_bcd / 2
    out_pins0 = [Point(rb * math.cos(math.radians(60 * i)),
                       rb * math.sin(math.radians(60 * i)))
                 .buffer(P.out_pin_d / 2 - 0.05, quad_segs=64)
                 - Point(rb * math.cos(math.radians(60 * i)),
                         rb * math.sin(math.radians(60 * i)))
                 .buffer(1.7, quad_segs=32)
                 for i in range(6)]
    bore_r = (B6701.od - pt.PRESS) / 2
    # input shaft cross-section in the disc plane: journal r6 and retainer
    # lip r7, both centred on the disc (wobble) centre; collar r5.2 on axis.
    worst = {}
    id_r = P.housing_od / 2 - P.wall
    for k in range(samples):
        a = math.radians(360.0 * k / samples)
        ex, ey, phi = cycloid.disc_pose(a, g)
        out_deg = math.degrees(-a / g.disc_lobes)
        out_pins = [rotate(p_, out_deg, origin=(0, 0)) for p_ in out_pins0]
        for name, dx, dy, dphi in (("disc1", ex, ey, phi),
                                   ("disc2", -ex, -ey, phi + math.pi)):
            disc = translate(rotate(disc0, math.degrees(dphi),
                                    origin=(0, 0)), dx, dy)
            pen = max(disc.intersection(pin).area * g.disc_thickness
                      for pin in ring_pins)
            worst.setdefault("disc-ringpin", []).append(pen)
            pen = max(disc.intersection(pin).area * g.disc_thickness
                      for pin in out_pins)
            worst.setdefault("disc-outshaft", []).append(pen)
            rmax = np.hypot(*np.asarray(disc.exterior.coords).T).max()
            worst.setdefault("disc-housing", []).append(
                max(0.0, rmax - id_r) * g.disc_thickness)
            # disc bore vs shaft: wobble-centred journal r6/lip r7 (always
            # inside bore r8.975) and concentric collar r5.2 at the axis.
            collar_reach = 5.2 + g.eccentricity   # collar edge vs bore ctr
            v = max(0.0, 7.0 - bore_r,
                    0.0 if collar_reach < bore_r else collar_reach - bore_r)
            worst.setdefault("disc-inshaft", []).append(
                v * g.disc_thickness)
        # pilot shaft r2.95 on axis vs output-hub hole r3.1 on axis
        worst.setdefault("in-out-shafts", []).append(
            max(0.0, 2.95 - 3.1) * 9.5)
        if k % max(1, samples // 8) == 0:
            say(f"angle {math.degrees(a):6.1f}: ring-pin "
                f"{worst['disc-ringpin'][-1]:.3f} mm3, "
                f"out-pin {worst['disc-outshaft'][-1]:.3f}, "
                f"housing {worst['disc-housing'][-1]:.3f}")
    say("\n| pair | worst penetration mm3 over sweep |")
    say("|---|---|")
    for k_, v in worst.items():
        say(f"| {k_} | {max(v):.4f} |")
    # BREP spot-check of the worst ring-pin pair
    say(f"\nBREP boolean spot-check (disc x {g.ring_pins} pins) at "
        f"{brep_angles} angles:")
    pins3d = [Pos(gx, gy, 0) * pt.ring_pin() for gx, gy in zip(px, py)]
    d_part = pt.cycloidal_disc()
    for k in range(brep_angles):
        a = math.radians(360.0 * k / brep_angles)
        ex, ey, phi = cycloid.disc_pose(a, g)
        for j, (dx, dy, dphi) in enumerate(
                ((ex, ey, phi), (-ex, -ey, phi + math.pi))):
            d3d = Pos(dx, dy, pt.Z_DISC1) * Rot(0, 0, math.degrees(dphi)) * \
                d_part
            v = max((d3d & p_).volume for p_ in pins3d)
            say(f"- a={math.degrees(a):5.1f} disc{j+1}: "
                f"max pin penetration {v:.3f} mm3")
    say("")


# ---------------------------------------------------------------------------
# 3. disc geometry
# ---------------------------------------------------------------------------

def check_disc_geom():
    say("## 3. Cycloidal disc geometry\n")
    g = P.gear
    xs, ys = cycloid.disc_profile_design(4000, g)
    r = np.hypot(xs, ys)
    th = np.unwrap(np.arctan2(ys, xs))
    say(f"- lobes: {g.disc_lobes}; r_min {r.min():.3f}, r_max {r.max():.3f} mm "
        f"(target {g.disc_rmin:.3f}/{g.disc_rmax:.3f})")
    # star-shaped (single-valued radius) -> no undercut when extruded
    say(f"- angle monotonicity: theta span {math.degrees(th.max()-th.min()):.1f}"
        " deg (==360 -> star-shaped, no undercut when extruded)")
    # pin contact over a fine sweep (analytic, 2D)
    min_gap = np.inf
    px, py = cycloid.pin_centres(g)
    for k in range(240):
        aa = 2 * math.pi * k / 240
        ex, ey, phi = cycloid.disc_pose(aa, g)
        c, s = math.cos(phi), math.sin(phi)
        xd = ex + xs * c - ys * s
        yd = ey + xs * s + ys * c
        for i in range(g.ring_pins):
            d = np.hypot(xd - px[i], yd - py[i]).min() - g.pin_radius
            min_gap = min(min_gap, d)
    say(f"- ring-pin contact: min flank gap over full wobble cycle = "
        f"{min_gap:.4f} mm (0 = touching; >0 clear, <0 interference)")
    # output hole walls
    hole_r = (MR106.od + 2 * g.eccentricity + 0.3) / 2
    bcd = P.out_pin_bcd / 2
    inner = bcd - hole_r - B6701.od / 2
    outer = g.disc_rmin - (bcd + hole_r)
    say(f"- output holes: OD {2*hole_r:.2f} on BCD {2*bcd:.1f}; "
        f"wall to centre bore {inner:.2f} mm, wall to rim {outer:.2f} mm")
    # pin-in-hole clearance over full rev: hole centre orbits at e around
    # the pin; clearance = hole_r - roller_r - e
    clr = hole_r - MR106.od / 2 - g.eccentricity
    say(f"- pin-in-hole clearance (static): {clr:.2f} mm radial")
    say("")


# ---------------------------------------------------------------------------
# 4. mass
# ---------------------------------------------------------------------------

def check_mass():
    say("## 4. Mass estimate\n")
    rho = 1.24e-3          # g/mm3 PLA
    rows = []
    tot = 0.0
    for name, fn in pt.PRINTED.items():
        v = fn().volume
        n = 2 if "x2" in name else 1
        m = v * rho * n
        tot += m
        rows.append((name, n, m))
    # bought parts (datasheet / catalogue values)
    bought = [
        ("MAD 5010 motor", 1, 162.0),
        ("6809ZZ", 2, 36.0), ("6701-2RS", 2, 1.6), ("MR106-2RS", 13, 0.9),
        ("6mm dowel pin x16", 16, 3.5), ("B-G431B-ESC1", 1, 10.0),
        ("AS5600 module", 1, 1.5), ("magnet 6x3", 1, 0.7),
        ("screws+inserts", 1, 25.0), ("M4x12 standoff", 1, 1.5),
    ]
    for n, q, m in bought:
        tot += q * m
        rows.append((n, q, q * m))
    say("| item | qty | mass g |")
    say("|---|---|---|")
    for n, q, m in rows:
        say(f"| {n} | {q} | {m:.1f} |")
    say(f"| **total** | | **{tot:.0f}** |")
    say("")


# ---------------------------------------------------------------------------
# 5. fidelity vs Onshape DXF
# ---------------------------------------------------------------------------

def check_vs_dxf():
    say("## 5. Generated profile vs Onshape `5010_profile.dxf`\n")
    try:
        import ezdxf
    except ImportError:
        say("ezdxf missing - skipped")
        return
    dxf = "/tmp/p5010.dxf"
    if not os.path.exists(dxf):
        say("reference DXF not found locally - skipped")
        return
    fp = np.asarray(list(ezdxf.readfile(dxf).modelspace())[0].fit_points)[:, :2]
    c = fp.mean(0)
    th_d = np.arctan2(fp[:, 1] - c[1], fp[:, 0] - c[0])
    r_d = np.hypot(fp[:, 0] - c[0], fp[:, 1] - c[1])
    o = np.argsort(th_d)
    xs, ys = cycloid.disc_profile_design(4000)
    th = np.arctan2(ys, xs)
    r = np.hypot(xs, ys)
    o2 = np.argsort(th)
    ri = np.interp(th_d[o], th[o2], r[o2])
    res = ri - r_d[o]
    say(f"- Rp={P.gear.pin_pitch_r}, e={P.gear.eccentricity}, "
        f"pin r={P.gear.pin_radius}, Np={P.gear.ring_pins}")
    say(f"- residual RMS {np.sqrt((res**2).mean()):.4f} mm, "
        f"max {np.abs(res).max():.4f} mm")
    say("")


def main(fast=False):
    say("# Actuator verification — auto-generated by cad/actuator/check.py\n")
    say(f"params: ratio {P.gear.ratio}:1, Rp {P.gear.pin_pitch_r}, "
        f"e {P.gear.eccentricity}, pins {P.gear.ring_pins}x"
        f"{2*P.gear.pin_radius}mm, discs {P.gear.n_discs}, "
        f"OD {P.housing_od} x {pt.Z_MAX:.1f} mm\n")
    check_watertight()
    check_interference(5 if fast else 13)
    check_disc_geom()
    check_mass()
    check_vs_dxf()
    say("## 6. Print orientation & supports\n")
    say("| part | orientation | supports |")
    say("|---|---|---|")
    say("| housing | flange up (as modelled) | none "
        "(pin grooves are axial, 6809 shelves print as bridges/steps) |")
    say("| cycloidal_disc | flat on plate | none |")
    say("| input_shaft | upright on tip face | none "
        "(cam lips are 0.8 mm ledges) |")
    say("| output_shaft | flange down on plate | none |")
    say("| motor_shell | as modelled (open top) | none |")
    say("| end_cap | face down | none |")
    say("| motor_shaft | flat | none |")
    say("")
    say("## 7. Motor datasheet (sourced)\n")
    say("MAD Components 5010 EEE V2.0 110 KV — vendor datasheet "
        "(uav-vtoldrone.com PDF): OD 56 x 32.7 mm, 162 g, 14 pole pairs, "
        "stator mount M3 x4 on 25 mm + 30 mm BCD, rotor mount M3 x2 on "
        "12 mm + M3 x4 on 18 mm BCD, bearings 685ZZ+695ZZ, 16 AWG 150 mm.")
    say("")
    with open(OUT_MD, "w") as f:
        f.write("\n".join(REPORT))
    print("\nwrote", OUT_MD)


if __name__ == "__main__":
    import sys
    main("--fast" in sys.argv)
