Riyu-D1/Vector/(commit log)

2026-10-22 Soma arm: proposal docs + parametric CAD v1 skeleton
    Fabricate design ship (README, BOM ~$470-490, torque analysis, architecture)
    plus build123d parametric model: servo envelopes, J2/J3 SEA cartridges,
    joint modules, links, wrist/face module, tendon gripper. STEP/STL exports
    and preview render included.
    Generated with [Devin](https://devin.ai)
    [SOMA_assembly.step, SOMA_assembly.stl, faceplate.step, faceplate.stl, forearm.step, forearm.stl, gripper_finger_l.step, gripper_finger_l.stl]
2026-10-22 Sleek reskin v2: teardrop knuckles, lofted links, posed assembly
    - Joints rebuilt as paddle-silhouette knuckles (round disc + tapered
    tail wrapping the servo case) with a matching collar yoke
    - Servo orientation corrected: case stands vertical, shaft on the joint
    axis, spline toward drive side, stub into idler bearing
    - Links are lofted rounded-rect bone shells (hollow, waisted, rear
    cable groove)
    - SEA v2: output flange bolt circle exposed outside the small centre
    cap so the yoke can actually reach it
    - Base is a tapered drum with filleted rim + flush turret cap
    - Wrist: J4 reuses the pitch joint; J5 pod + neck bracket carry the
    whole head (visor face + beak gripper) on the roll a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
    [SOMA_assembly.step, SOMA_assembly.stl, forearm.step, forearm.stl, gripper_finger_l.step, gripper_finger_l.stl, gripper_finger_r.step, gripper_finger_r.stl]
2026-10-22 Verified parts selection: HTD-45H @J2 + all-STS3215-12V, single 12V rail
    Component research pass against real listings:
    - J2: SM60CL ($79-165 real) -> Hiwonder HTD-45H ($25-30), 45kg-cm
    stall, TTL. Gravity-assist spring becomes required hardware.
    - J3: SM40BL ($55-100) -> STS3215-12V 30kg-cm (~$21), 2.5x margin.
    - All servos now TTL on one 12V rail: no RS485 transceiver, no
    7.4V buck, one protocol family for five of six joints.
    - Wrist node -> Waveshare ESP32-S3-LCD-1.28 ($16): eye #1 + IMU
    onboard, replaces three line items.
    - Camera -> ESP32-CAM ($8). Brain -> Orange Pi 5B 4GB ($75, NPU,
    optional: headless build ~$400 fits L3).
    - params.py synced to real envelopes (HTD-45H 51.1x20.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
    [SOMA_assembly.step, SOMA_assembly.stl, forearm.step, gripper_finger_l.step, gripper_finger_r.step, gripper_idler.step, gripper_palm.step, gripper_spool.step]
2026-10-23 Base carrier PCB: 2-layer no-IC board for the servo architecture
    gen_pcb.py parametrically builds + autoroutes a 90x70mm THT carrier:
    - ESP32-S3-DevKitC-1 socket (2x 1x19 headers, module not IC)
    - 12V in -> 6A fuse -> KK-254 servo ports (J4/J5 bus A, J6 bus B)
    - Optional Mini-360 buck footprint or external 5V terminal
    - Schottky-isolated 5V to the ESP32 (USB + board power coexist)
    - Passive TTL coupling (TX direct, RX via 1k) for both servo buses
    - I2C encoder ports (J7/J8), estop (J9), wrist UART (J10)
    - GND backbone tree + B.Cu pour
    Router: 3D A* on a 0.127mm grid with per-pad keepouts (real pad
    sizes incl. rect half-diagonals), terminal-copper bypass, via support,
    bounded search windows.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
    [soma-carrier-B_Courtyard.gbr, soma-carrier-B_Cu.gbl, soma-carrier-B_Fab.gbr, soma-carrier-B_Mask.gbs, soma-carrier-B_Paste.gbp, soma-carrier-B_Silkscreen.gbo, soma-carrier-Edge_Cuts.gm1, soma-carrier-F_Courtyard.gbr]
2026-10-26 Route carrier PCB: full autoroute + GND pours, case grown to 135x115 board
    Board: ESP32-S3 socket rows corrected to 1x22 (DevKitC-1 is a 2x22
    module; the 1x19 sockets dropped three pins per side) and rotated so
    pads run east on-board. Internal pad math now matches KiCad's file
    rotation convention (rot(-a), y-down) — the earlier sign slip had the
    router aiming WEST off the board. check_pads.py gates that forever:
    151 emitted pads verified against the internal map.
    Placement: zero pad collisions and zero courtyard overlaps — D4/D1
    moved into free pockets, J10/BZ1 separated, right-edge cluster spread.
    Router: rectangular pads use stadium keepouts (Minkowski sum — the
    corner-disc model po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
    [SOMA_assembly.step, SOMA_assembly.stl, case_lid.step, case_lid.stl, case_tray.step, case_tray.stl, forearm.step, gripper_finger_l.step]
2026-10-27 Carrier PCB: verified orderable board — audit F3-F13 fixed, DRC clean
    Pre-order audit per VERIFY_GUIDE (pin-by-pin, physical fit, elec/fab)
    found 6 blockers + 4 should-fix + 1 cosmetic; all fixed and re-verified:
    - cuobs hard copper floor stops late fat-rail reroutes overlapping
    signal copper (F9); +12V west-exit + +5V_MCU C4 detour unblocks the
    pocket dive (F10); GND stitch vias now check foreign copper on BOTH
    layers (F11); dead-copper pruner is strictly DRC-driven and the
    +5V_MCU dead spur unwound (D1 re-linked to the staircase) (F12);
    pad-graze nudge clears the 0.15-0.19 mm slivers vs J9/J10/J13/U1B
    (F13); ENC-J3 label re-sited under J8.
    - fill_zones.py made robust: via re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
    [soma-carrier-B_Courtyard.gbr, soma-carrier-B_Cu.gbl, soma-carrier-B_Fab.gbr, soma-carrier-B_Mask.gbs, soma-carrier-B_Paste.gbp, soma-carrier-B_Silkscreen.gbo, soma-carrier-Edge_Cuts.gm1, soma-carrier-F_Courtyard.gbr]
2026-10-27 Stream C: shared protocol codecs + Orange Pi robot-os (tested)
    - firmware/shared: pure-C codecs for the three wire protocols —
    CANopen-style joint CAN (Berkeley Recoil-BESC compatible framing),
    Feetech STS packet codec, ESP32<->Pi framed serial link.
    - software/robot-os/soma_arm: FK/IK kinematics (5DOF pose + gripper,
    analytic elbow branches), min-jerk trajectory planner with joint
    limits and speed caps, framed-link client (termios, no pyserial dep),
    SimBaseNode for full dry-run testing, argparse CLI.
    - tests: 38 pytest cases — 500-pose FK/IK round-trip, CAN/Feetech
    codec loopback plus byte-exact cross-check against the compiled
    C codecs, link frame resync/CRC, estop latch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
2026-10-27 Stream C: ESP32 base-node + B-G431B-ESC1 joint firmware + docs
    - firmware/base-node (PlatformIO/Arduino, UNBUILT): TWAI CAN @1Mbps on
    J15 IO2/IO1, Feetech bus A @1Mbps IO17/IO11, framed host link with
    500ms watchdog, J9 NC estop, CAN bus-off recovery, per-joint SDO
    current caps pushed at boot.
    - firmware/joint-driver (SimpleFOC, UNBUILT): full CANopen-style
    protocol (RPDO2/TPDO2/PDO3/SDO/NMT), encoder-offset calibration with
    flash params, position/velocity/torque modes, CAN_TERM handling.
    Board facts cross-checked vs ST UM2516 + NuttX doc.
    - docs/: can-protocol.md, host-protocol.md, bringup.md (staged power-up
    checklist + safety), firmware-verification.md (real test output),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
2026-10-27 Stream C review fixes: jog/pos handoff, ZERO_HERE frame, clamps
    - base-node: SET_JOINT_POS clears stale jog velocities; SET_JOINT_VEL
    integrates into q_cmd at the joint-loop rate with limit stops.
    - joint-driver: user-frame zero offset applied consistently to RPDO2
    targets and TPDO2 feedback; A_VBUS fallback define.
    - python Arm.stream_joints actually uses the clamped vector.
    - can_bus.h self-contained (config.h include).
    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
    [can_bus.h, host_link.cpp, joint_driver.ino, main.cpp]
2026-10-27 Stream C: param/mode CLI cmds, README layout, spec doc
    - cli: `param` (SDO/Feetech register read) and `mode` (NMT) commands
    so docs/bringup.md steps work verbatim.
    - Arm.read_param() + PARAM frame handling.
    - README repo layout reflects the real v3 firmware/software tree.
    - Track ARM_HYBRID_V3.md (the governing spec) on this branch.
    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
2026-10-27 joint-driver: gate ENABLE on calibration, persist pos_zero
    Enabling FOC without a measured electrical zero would mis-commutate —
    now refuses with an EMCY until NMT CALIBRATE has run once. ZERO_HERE
    persists across reboots via params flash. STATUS updated: Stream C
    items all delivered.
    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
    [joint_driver.ino]
2026-11-01 W1: firmware v2 for current arm + MOTOR_EN safety + payload derating
2026-11-01 W2: two-phase MOTOR_EN arm (fix ESC deadlock)
    [config.h, joint_driver.ino, link_proto.h, main.cpp, motor_en.c, motor_en.h]
2026-11-01 D1: J4 STS3250 swap + J2 balance spring — 0.5 kg payload study (upgrade1/)
2026-11-01 D2: D1 upgrades on arm2b CAD copy + housing/bolt-hole FEA (cad3/)
    CAD (on the arm-arm2b checkout): J4 STS3215 -> STS3250 (same envelope,
    25T, 1.569 N.m rated); J2+J3 coaxial one-way torsion springs
    (Springmasters 471671, OD22/wire2/mandrel d14.8) reclaiming the 6803
    cavities - back_spacer bored to the coil pocket + anchor notch, flange
    hub turned to mandrel + coil recess + stop notch; no envelope growth.
    Exports in cad3/out/. A2a/A2b/actuator/interference/spring checks PASS.
    FEA (cad3/fea/, gmsh C3D10 + ccx): J2 housing 4.16 MPa (SF 6.0), J3
    housing 3.01 (SF 8.3), J4 cradle 0.22 filtered/0.87 patch (SF 28.7) vs
    25 MPa cross-layer PETG-CF; loads gravity_up1.py 0.5 kg x2 dynamic.
    PNG + intera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
    [01_BASE_Link.step, 01_BASE_Plate.step, 02_Arm_Yaw_Limit.step, 02_Base_Reinforcement_Part.step, 02_FLANGE_J2.step, 02_FLANGE_J3.step, 02_Lower_Upper_Link_L.step, 02_Lower_Upper_Link_R.step]
2026-11-01 D3: order-ready pack — UK BOM, fixed carrier PCB, stress sanity, build guide
    order/: consolidated GBP BOM (verified vs [U]), corrected carrier v1.3
    in pcb13_fix/ (K1 pin map fixed: 1=COM, 2/5=coil, 3=NO — real SRD pinout;
    DRC 27 benign/0 unconnected, verify_nets PASS, gerbers exported), hand
    stress checks vs optimistic FEA, build+bring-up guide, status/[U] list.
    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
    [BOM_FINAL_GBP.csv, bom.csv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]
2026-11-02 demo: use targets reachable with real arm geometry
2026-11-02 V1 verification worktree: contact FEA campaign + honest failure report
    Cycloidal 40:1 contact FEA (J2/J3) built, geometry- and Jacobian-verified,
    Newton-converging - killed at every 40-min cap before the 0.16 mm pin
    clearance closed, so no loaded increment exists. Hertz fallback per stage:
    disc lobe contact SF 0.14-0.33 vs print limits -> predicted FAIL; do not
    order on the earlier ~11 MPa bearing figure. J4 cradle converging when
    killed at cap; J2/J3 joint decks built and validated but unlaunched.
    Shock torques done (J2 9.19, J3 4.21, J4 1.19 N.m), fatigue estimate with
    literature endurance cited. Seating-phase viz under verify/fea/.
    Co-Authored-By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
2026-11-02 D4: PETG-CF cycloidal redesign — near-zero-clearance 40:1, SF 2.2+ at 0.5 kg static design torque
    Revised brief (user): printed PETG-CF only, steel dowel pins stay, design
    for worst-case STATIC torque at 0.5 kg full reach (J2 2.616 / J3 1.837 N·m
    from gravity_up1 sweep, design 2.70/1.85) with SF >= 2; no x2 factor, no
    slam case; firmware output-torque cap + soft E-stop ramp to enforce it.
    load_model.py: Blanche/Yang-style pin load distribution on the real 40k-pt
    profile + Hertz + out-pin bearing. Validated: 20/41 pins engaged at clr=0
    (published ideal-drive theory), collapse to 2 at 0.15 clearance, solver
    ratio 1.00 vs linear.
    Pick: geometry unchanged (N40, R23.5, RP1.5, E0.42); CLR_TOO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
    [carrier.step, carrier.stl, disc1.dxf, disc1.step, disc1.stl, disc2.dxf, disc2.step, disc2.stl]
2026-11-03 F1: integrate mechanical + firmware + order/docs into arm-final; close D4 gaps
    - Firmware torque envelope: per-joint output caps J2 3.0 / J3 2.0 N·m
    (3.71/2.47 A phase via T=I*Kt*40*eta), ESC-enforced hard clamp on
    SDO writes + EEPROM, output velocity cap 0.5 rad/s, 75 ms soft-stop
    ramp on MOTOR_EN drop / ESTOP / heartbeat loss / NMT disable
    (relay cut stays independent).
    - robot-os planner refuses waypoints over the caps; config mirrors the
    new limits; +4 torque-cap tests (66 passed).
    - final/: refreshed print list (D4 disc profile + tolerance plan),
    clearance coupon generator + STEP/STL, UK BOM csv/md, build guide
    with calibration/run-in/bench-verification checklist, one-pag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
    [BOM_FINAL_GBP.csv, assembly.stl, coupon.stl]
2026-11-03 D5: slim servo-shell wrist + gripper — -30% printed mass, same kinematics
    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
    [finger_d.step, finger_d.stl, finger_u.step, finger_u.stl, vendor_gear_grip.step, vendor_gear_grip.stl, vendor_rack_d.step, vendor_rack_d.stl]
2026-11-03 D6: K-KEEL wrist + gripper — fin J5, keel J6/g, -18% printed mass vs D5
    Servos re-posed for a slim tapered silhouette: J5 dorsal fin (a 30.6,
    h +7.6), J6+gripper inline keel 17 mm below the axis, grip train +5.6 mm.
    J4->TCP 137.4 (+5.6), J2->TCP 380.5, wrist+gripper 0.225 kg (D5 0.234).
    ROM J4 175 / J5 140 / J6 360 deg; all wrist checks pass. Kinematics +
    gravity updated for the 2D TCP offset (pytest 66 pass); patch snapshot
    in wrist2/patches/. Honest FAIL kept: J2 3.28 Nm over the 3.0 disc cap
    at 0.5 kg full reach — upstream limit, enforced by the planner.
    [finger_d.step, finger_d.stl, finger_u.step, finger_u.stl, vendor_gear_grip.step, vendor_gear_grip.stl, vendor_rack_d.step, vendor_rack_d.stl]
2026-11-03 F2: merge D6 K-KEEL wrist into final arm + whole-arm validation
    arm-final2 = arm-final + arm-wrist2 (fast-forward, zero conflicts).
    Assembly rebuilt via export_assembly.py (wrist2/out swap, 72 parts /
    175 solids); renders regenerated + wrist close-up.
    Validation: posed-mesh collision sim (per-joint sweeps, 6 named +
    8 corner poses, 2200 MC) — J1 yaw stop below -152.5, J2 base contact
    +62.5..+70, compound wrist-extreme grazes at combined |J4|+|J5|;
    MuJoCo model (10 bodies/8 joints) holds home, all joints reach both
    limits, TCP site = FK exactly; IK grid 752/2736 solvable, 60 boundary
    targets lost vs D5 model; J2 torque 3.34 N-m > 3.0 cap at 0.5 kg full
    reach -> honest payload rating ~0.5 k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
    [arm.xml, assembly.stl, scene.xml]
2026-11-03 D7: wrist-corner graze fix — link5 cheek/plate corner trims + J6 plate re-clip
    Reshape w_link5 dorsal cheek top-front corner (L5_CAGE chamfer under the
    measured sweep footprint) + horn-plate front b-corner reliefs, and re-clip
    the J6 horn plate to r15.0 so its rolled silhouette clears the fin bottom
    web. w_j4_cradle x w_link5, vendor_sts3250_j4 x w_link5 and
    w_grip_frame x w_link4 go to zero undeclared hits across the full +-70/+-70
    J4xJ5 envelope at 2.5-deg steps incl. J6 and gripper strokes; min measured
    clearance 0.60 mm. Vendor plug x j5-case pair documented as unfixable by
    printed geometry. Mass -372/-140 mm3 on the two edited parts; no BOM,
    servo, axis, range or kinematics changes.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
2026-11-03 D9: hybrid lightening study (rejected by FEM gate) + J6 conditional sublimit
    Conservative window/pocket lightening of proven stock link plates
    (upper_out, upper_back, dogleg_l/r, fore_l2/r2 census). All variants fail
    the D9 gate - _l two-window plates add +81% tip deflection and _lp
    pockets add +224% with SF 1.5 (vs <=15% / >=2 allowed). The stock R12
    neutral-axis slot already spans the legal opening (34.4 mm closest
    cutter point vs 33 mm joint keep-out); every remaining near-zero-stress
    region lies inside the r31.5 bolt/bearing keep-outs. _l2 slot-extension
    variant removes 0.01 cm3. Adopted lightening: none (0.0 g).
    FEA: STEP -> gmsh C3D10 -> CalculiX 2.23 -> pyvista. msh2gen.py gains a
    qu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
2026-11-03 docs: fix F1 summary (2x STS3250, 12 V relay)
2026-11-05 D10: automounter exploration - J6-roll bayonet tool coupling + 4-slot dock rack + planner
    [arm_tc.xml, scene_tc.xml]
2026-11-05 D11: tool-changer independent audit - re-ran all checks verbatim + defect list
    Read-only audit of the D10 tool-changer (no product files touched).
    Reproduced: C1-C6 checks, collision suite, mass/torque/payload, MuJoCo
    dock (9/9), pytest 13/13, FEM master/plate exactly (0.79/0.60 MPa).
    Added FEM cases: single-catch fault, tool_pen, tool_grip, tc_rack.
    Findings (proposed_fixes.md, not applied):
    - F1 blocks-dock: key notch cut 0.05 mm not 1.5 (box bounds inverted);
    rack key tab propped ~1.35 mm, C5 gate too loose to catch it
    - F2 blocks-adopt: catch tip wall 1.14 mm < 1.8 min; single-catch fault
    FEM 32.0 raw / 16.85 filt MPa -> SF 1.48 < 2 at that thin tip
    - F3 blocks-adopt: groove floor 1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
2026-11-05 D12: tool-changer D11 fixes applied - F1-F8 closed, fault SF 2.10, F9 documented
    Applied the proposed_fixes.md patches to the toolchg lineage:
    - F1: key notch box flipped to cut INTO the plate (real 1.2 mm notch);
    C5 gate 40 -> 0.5 mm3 + positive key-tab engagement probe
    - F2: catch ramp a0+2.2 -> a0+1.2 (tip wall 1.14 -> 2.08 mm); fault
    case needed two more sanctioned steps - TC_CATCH_ARC 60 -> 75 plus a
    corner-fillet wedge behind each catch +a face; plate_1catch filtered
    17.08 -> 13.15 -> 11.89 MPa, SF 2.10 >= 2
    - F3: TC_DOCK_R 20.0 -> 20.6, TC_KEY_D 1.5 -> 1.2 (groove wall 2.40,
    1.20 over notch); rack slot W/seat re-derived (41.7 / 20.9)
    - F4-F6: detent BOM = Dia4 ball + ~Dia3.2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
    [arm_tc.xml]
2026-11-05 D13: tool-changer prototype print pack - master+plate+pen STL/STEP, print/BOM/bench cards
2026-11-07 refine: D6 wrist/gripper structural repair (F9 root cause) - R1/R2
    Audit found the D6 keel-cage generators mirror the servo-pocket cheeks
    with the profile on the wrong plane: for sg=-1 the cheek grows into the
    pocket and is cut away, so w_link4 / w_link5 / w_grip_frame / tool_grip
    all shipped as one-sided cages with detached horn-plate islands and
    zero-volume tangent welds (measured: GF plate-cheek 0.32 mm3,
    cheek-keel-web 0.00 mm3). w_link4's strut polygon also
    self-intersects at a~8.8 and a~21, leaving the J4 horn plate a
    detached island. tool_grip inherits the same cage (the documented F9
    hotspot, 28.73 MPa / SF 0.87, reproduced bit-exact).
    Fixes (refine/ap7.py + p_wrist7.py + p_toolch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
    [finger_d.stl, finger_u.stl, fix_tool_grip.step, fix_tool_grip.stl, fix_w_grip_frame.step, fix_w_grip_frame.stl, fix_w_link4.step, fix_w_link4.stl]
2026-11-07 refine: R3 horn-mount FEA + w_link4 strut stiffening, material & load audit
    - msh2_r3.py: realistic screw/horn BC models (6 cases x 3 horn-loaded
    wrist parts x 3 mesh sizes) replace the [U] full-face horn fixity.
    - Found + fixed: w_link4 J4 horn mount was a single 4 mm strut wall -
    |U| 6.3 mm + ~93-105 MPa notch under the 0.5 kg-class wrench. Widened
    strut rib (b -30.65..-22.65) + full-height plate-edge weld -> |U| 0.63
    mm, VM 14.9 MPa, BC-insensitive. wrist7_checks PASS (STRESS SF 3.1,
    mass 0.231 kg, all clearance/ROM/cable gates).
    - Material allowables sourced: Bambu PETG-CF TDS 35 XY / 29 Z MPa ->
    design 25 in-layer / 12.5 cross-layer (prior "25 cross-layer" label
    was wrong)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
    [fix_w_link4.step, fix_w_link4.stl]
2026-11-07 refine: R4 wrist junction repairs - l5 plate+longeron, l4 tail collar+tapered rib
    Replaces the two R3 adhesive-dependent T-junctions with printed
    lap/shear geometry (no glue fillets in the accepted design):
    - w_link5: plate widened to +-16.41 over the full cheek band, cheek
    flat buried under the plate, external longeron ribs run past the
    plate edge -> scrann filtered 9.27 MPa (R3: 31.2 rising to 46.6),
    convergence 8.41/9.27/11.33 at cl3/1.5/0.8. Residual disclosed:
    ring-edge layer-normal +8.4 MPa at the idealised horn-clamp BC
    boundary (cross-layer SF ~1.5 at 0.5 kg; mitigated by print density,
    pending droop test).
    - w_link4: 0.13 mm tailwall membrane replaced by an external tail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
    [fix_tool_grip.step, fix_tool_grip.stl, fix_w_grip_frame.step, fix_w_grip_frame.stl, fix_w_link4.step, fix_w_link4.stl, fix_w_link5.step, fix_w_link5.stl]
2026-11-08 refine: R5 w_link5 print-orientation fix (up=h), mass-model correction, honest trims + J2 margin
    - w_link5: R4 horn-mount residual was biaxial plate bending, not a clamp
    singularity; up=h puts both bending components in-layer -> sigma_n(z)
    <= +5.1 MPa all BCs (SF >= 2.4 vs 12.5). No geometry change. Direction-
    bound decks added (_lat/_axp/_axn/_up + payloads): exposed a pre-
    existing lateral cage-window mode (+-33 MPa free-bending bound) at
    folded+rolled poses - disclosed, not fixed.
    - mass_r5.py: upgrade1 wrist entries were a stale pre-R-layout snapshot;
    origins/centroids restored to product-kinematic values, plastics =
    measured volumes x rho x 0.6.
    - Trims for J2 margin (boun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
    [fix_tool_grip.step, fix_w_grip_frame.step, fix_w_j4_cradle.step, fix_w_j4_cradle.stl, fix_w_link4.step, fix_w_link4.stl, fix_w_link5.step, stock_tool_grip.step]
2026-11-08 refine: R6 w_link5 lateral cage fix - closed skins + longerons + entry-model correction
    Fixes the R5 section-18 lateral mode (+-33.5 MPa cheek-window strips):
    - p_wrist7/ap7: 1.0 mm outer-face closure skins on both window bands
    (r3 recess fillets), bottom longeron T-flanges (b->17.3, h -54.4..-48),
    aft-end ribs (a55..64.7, h -45..-38); all additions outside the J6
    pocket/case clearance. Volume 9.58 -> 13.78 cc (+3.3 g).
    - msh2_r3: direction-matched empty-pocket entry (floor + bearing-side
    wall band for +-b loads - physically motivated by the snug 0.15 mm/side
    case fit; NO case stiffness credited). Floor-only deck retained as
    l5_*_latf strict sensitivity bound.
    - msh2_r3 + pose_w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
    [fix_tool_grip.step, fix_w_grip_frame.step, fix_w_j4_cradle.step, fix_w_link4.step, fix_w_link5.step, fix_w_link5.stl, stock_tool_grip.step, stock_w_grip_frame.step]
2026-11-08 refine: R7 consolidated wrist-strength pass - mode-specific allowables, corrected tau metric, gf notch fix
    - Materials basis: in-layer VM 25 / layer-normal compress 15 / layer-normal
    tension 12.5 / interlayer shear 8 MPa (literature lower bound for printed
    short-CF composites); SF2 gates kept distinct from characteristic values.
    - sigscan_r3.py: fix interlayer-tau component pairing per layer axis
    (x->{sxy,sxz} y->{sxy,syz} z->{syz,sxz}); R5/R6 numbers were a mixed
    in-layer+interlayer metric - all cases re-analyzed on the corrected one.
    - w_link5: relief screened on matched cl3 scrann solves - r6 box notch
    (tau 4.84) beats 2step/r6w/r6f/flush/lip/funnel (up to ~9.6); funnel
    regres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
    [fix_w_grip_frame.step, fix_w_grip_frame.stl, fix_w_link5.step, fix_w_link5.stl]
2026-11-09 refine: R8 final pass - loft l5 relief, thickened l4, honest COM wrenches; verdict B
    - Audit: legacy wrench refs understated horn moments 10-14% (l5/l4 now
    loaded at true stack COM); l4 annulus patch was on the free face -
    horn mounts the INBOARD face; density corrected to 7.86e-10.
    - l5: swept-envelope loft relief (L5_LOFT, checks/bake_loft.py) keeps
    46% full plate + 15% bottom lip vs the R6 box notch; funnel shear
    hotspot removed; governing tau ~5.3 at a new lip edge.
    - l4: horn plate +1.45 mm outboard (-32.1), strut follows, mid-rib
    shortened, d20 horn bore + swept case-front clearance fan (fixes the
    long-hidden strut/J4-horn overlap; J4 ROM now +-80 PASS).
    - FEA (run_r8fea.py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
    [cm_cradle.stl, cm_fore_l.stl, cm_fore_r.stl, cm_j4case.stl, cradle.step, fix_tool_grip.step, fix_w_grip_frame.step, fix_w_j4_cradle.step]
2026-11-10 refine: R9 printed U-yoke second J4 support - journal boss + d3 dowel retires the rolled fin failure; verdict B (0.25 kg met SF2 all poses incl rolled; 0.38/0.5 not met, ~0.36 bound)
    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
    [cradle.stl, fix_tool_grip.step, fix_w_grip_frame.step, fix_w_j4_cradle.step, fix_w_j4_cradle.stl, fix_w_link4.step, fix_w_link4.stl, fix_w_link5.step]
2026-11-10 fullcheck: whole-arm verification of the R9 build - FULLCHECK.md verdict NOT READY
    End-to-end check of the real R9 part set (arm2b base/links + D2 overrides +
    cyclo4 modules + R9 wrist + direct gripper, and the tool-changer variant
    as an alternative J6-horn payload). New tooling in fullcheck/:
    - fc_collision.py posed-manifold boolean sweep over the 72-part R9 set +
    fix_tool_grip TC variant: all joints, corner poses, named poses, 1200-pose
    MC, exact min-distance probes. Home clean in both configs; per-joint
    sweeps clean except the designed J1 yaw stop (<-152.5 deg) and the
    below-table J2 >+62.5 family; MC families classified in fc_mcclass.py.
    New find: fix_tool_grip x w_link4 graz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
    [fix_tool_grip_posed.stl]
2026-11-10 fullfix: close the four FULLCHECK blockers - verdict READY TO ORDER at 0.25 kg
    - BOM: +1x ISO 8734 d3x18 steel dowel (R9 wrist pin) in both order CSVs,
    price TBC (no repo price exists; no other prices touched). M3x14 at the
    J4 horn plate called out in BUILD_GUIDE.
    - Tool changer: fix_tool_grip rear rim trimmed in p_toolchg7.py (collar
    r20.35 through a<=70.8, 45 deg flare to r23.05 at a=73.5). Official
    fc_collision --tc J5 sweep PASS + finer +-70/1.25deg targeted sweep:
    zero overlap, min clearance 0.652 mm >= 0.5. Trimmed-part FEA on the
    5.7 N TCP case: filtered VM 8.09 MPa -> SF 3.09. Print pack now ships
    fix_tool_grip, not the stock D13 tool_grip.
    - J1 limits clipped to +-150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
    [BOM_FINAL_GBP.csv, assembly.stl, fix_tool_grip.step, fix_tool_grip.stl, fix_tool_grip_posed.stl]
2026-11-12 readme: rewrite for the current R9 / arm-fullfix design - PCBWay reviewer facing
    Stale README described the old all-servo SEA arm (HTD-45H + 6x STS3215,
    ~300 g, face/tactile features that no longer exist). New README documents
    the verified design at 7222d66: hybrid actuation (STS3250 J1/J4, 40:1
    printed PETG-CF cycloidals on J2/J3, STS3215 wrist+gripper), 0.25 kg
    rating at SF>=2 every pose (min binding SF 3.22), J1 +-150 deg, carrier
    v1.3 with MOTOR_EN relay + order gerbers in order/pcb13_fix/, current
    BOM cost, honest not-built status, all links checked.
    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
